jakewesterberg/wl-sync/hardware/README.md

# wl-sync breakout PCB

KiCad sources for the sync-box breakout board: a 2U rack-mount mixed-signal hub that sits
between the behavioural task PC, the sync-box module, the recording NI card, and the Intan RHS
amplifier. Every signal that crosses between those devices terminates on this board, is
conditioned once, and is fanned out — so a rig is reproducible from the board rather than from
hand wiring. "Sync-box module" is deliberately not a single product name: the module carries a
BCM2712 SoC and RP1 I/O controller either way, so its GPIO map and pinout are identical whether
it ships as a Raspberry Pi 5 or as a Compute Module 5 (Lite) on the official CM5 IO Board — the
choice between the two is a floorplan/placement decision this repository's own sources do not
yet lock in, not an electrical one.

Full design rationale, the signal contract, the grounding scheme, and the fabrication schedule
live in [`docs/superpowers/specs/2026-08-13-syncbox-breakout-pcb-design.md`](../docs/superpowers/specs/2026-08-13-syncbox-breakout-pcb-design.md).
The implementation plan (task breakdown, net naming convention, file layout) is at
[`docs/superpowers/plans/2026-08-13-breakout-pcb.md`](../docs/superpowers/plans/2026-08-13-breakout-pcb.md).
This repository is public: documentation here states electrical and mechanical facts and
tooling instructions only, and reproduces no text from either linked document's private source
material.

## Settled facts (record kept here, 2026-08-15)

Three facts a rig operator or firmware author needs and should not have to re-derive from the
schematic or the private spec:

- **The two photodiode comparator channels have distinct, fixed roles.** `A_PD1` watches the
  **task patch** — the stimulus-onset signal a behavioural task draws to cue an event.
  `A_PD2` watches the **flip patch**, a corner region of the display that alternates every
  refresh, making it a frame clock. Both reach the recorders as a digital edge through their
  own comparator (`PD1_COMP`/`PD2_COMP`) as well as an analog copy; the comparator lines carry
  the timing, the analog copies carry waveform and intensity.
- **The default eight analog channels Intan receives** (of the 16 sources this board carries;
  Intan's own ceiling is 8, and which eight is a mux setting, not a copper fact — see the
  ADG1206 mux truth table below): `A_PD1`, `A_EYE_LX`, `A_EYE_LY`, `A_EYE_LP`, `A_JOY_X`,
  `A_JOY_Y`, `A_MIC`, `A_ACC`. One complete eye (left, position + pupil) rather than partial
  data from both; the six eye channels are the first candidates to drop if a different set is
  ever needed, since they have an authoritative record on the eye-tracker PC independent of
  this board — the photodiode, joystick, accelerometer, and microphone channels do not.
- **MonkeyLogic's `RewardPolarity` setting must be `HIGH` to match this board.** This board's
  reward-commanded input (`RWD_CMD`) is active-HIGH by design (idle-LOW, pulses HIGH on
  delivery — the same convention every other event line on this board uses, and the polarity
  the reward-OR gate's own same-polarity structural check assumes and enforces on the
  debounced-button side). `RewardPolarity` is a MonkeyLogic Main Menu setting provided so a
  rig can match relays that trigger on sinking instead — it is a configuration to set for this
  board, never an unknown to discover at commissioning time.

## Two tracks

- **`hardware/mule/`** — the event-path mule. A small, fast board carrying only the 17-line
  event-code path plus one instance of each level-shift and isolation stage the full board
  reuses. It exists to reach the bench while the breakout board is still in layout, so the
  level-shifting and optocoupler topology gets validated against real hardware early enough to
  revise the sheets that depend on it.
- **`hardware/breakout/`** — the breakout board itself. A root sheet plus one hierarchical sheet
  per functional block (power, task-PC digital, Pi interface, analog front end, analog-to-NI,
  mux-to-Intan, comparators, opto-to-NI, opto-to-Intan, USB/I²C control).

As of this commit, `hardware/mule/` carries a generated schematic (`mule.kicad_sch`, produced
by `hardware/gen/gen_mule.py`) and a generated, placed-but-unrouted board (`mule.kicad_pcb`,
produced by `hardware/gen/gen_mule_pcb.py`) — see `hardware/mule/floorplan.md` for the
placement rationale and the constraints a router must respect. `hardware/breakout/` carries
the root sheet (`breakout.kicad_sch`, produced by `hardware/gen/gen_breakout.py`) plus two
populated child sheets so far: `sheets/power.kicad_sch` (produced by
`hardware/gen/gen_breakout_power.py`, Task 7) — the 5-position analog/logic inlet (widened
from 4 pins at Task 7 fix round 1, see below), the +3V3 logic rail regulated from +5V, and
the one isolated ±12V supply the other nine sheets draw power from; see that generator's own
module docstring and `check_breakout_power_netlist.py` for the design and its verification.
Task 7 fix round 1 (task-7-report.md's "Fix round 1") corrected two defects found in
review: the +5V rail was undersized regulating it down from +12V on board (fixed by
bringing +5V in directly from the external supply on a fifth inlet pin instead, budgeted
for 400mA), and the child sheet's own component `(instances (path ...))` ancestor chain was
self-referential rather than the real root+sheet-symbol chain a nested sheet needs (fixed
generically in `kicad_sch.py`, not just for this one sheet — see the "KiCad gotchas" entry
below). Task 7 fix round 2 (task-7-report.md's "Fix round 2") replaced the inlet
**connector** itself — not its electrical design — after a reviewer confirmed the mini-DIN
footprints modelled an evenly-spaced ring the real Same Sky MD-40SN/MD-50SN datasheet's own
diagrams contradict, and that both parts are discontinued besides. The inlet is now a
5-position, IEC 61076-2-101 A-coded, keyed, screw-locking M12 connector (Amphenol LTW
M12A-05PFFP-SF8001, current production, 811 units in stock directly confirmed at DigiKey)
— see "Custom connector footprints" below for the full selection rationale and
per-dimension sourcing.

**Panel-instrumentation task (2026-08-15), Change D — four of the five "things a rack
instrument needs that this one lacked" (spec §9.8) land on this sheet** (the fifth,
the barcode heartbeat LED, is on `pi-interface.kicad_sch` — see that sheet's own
paragraph below):

- **Chassis earth stud (`J56`):** a `Connector_Generic:Conn_01x01` on footprint
  `MountingHole:MountingHole_3.2mm_M3_Pad` — an M3-clearance hole *with* a connected
  copper pad, simultaneously the mechanical mount and the electrical land the
  cage-to-rack bond (spec §5.6) needs somewhere to terminate. Carries a new net,
  `CHASSIS_GND`, joined to `DGND` at exactly one net tie (`NT3`) — mirroring `NT2`'s own
  `FAN_RTN`↔`DGND` treatment exactly, so the stud reaches the board's single star point
  transitively (through `NT3` then `NT1`/`NT2`), never by a second, competing path.
- **Power-good LED per rail (`D40`/`D41`/`D42`, +12V/−12V/+5V):** series resistor + LED
  between each rail and its own local ground reference (`AGND` for ±12V, `DGND` for
  +5V) — `−12V`'s own pair is mirrored (resistor/anode on the `AGND` side, cathode on
  `−12V`), the identical reasoning `D2`'s own reverse-polarity-diode orientation already
  uses. ~4.5 mA target each (`R192`/`R193` = 2.2k, `R194` = 680R) — negligible against
  any rail's own real budget.
- **Rail test points (`TP1`–`TP7`):** one `Connector:TestPoint` per voltage rail (+12V,
  −12V, +5V, +3V3, ISO_P12, ISO_N12) *plus one on `INTAN_GND`* — the isolated domain's
  own reference, without which `ISO_P12`/`ISO_N12` cannot actually be measured at all
  (`INTAN_GND` is galvanically separate from `AGND`/`DGND`, spec §5.3/§5.5). `AGND`/
  `DGND` themselves are not given dedicated test points — already trivially probable at
  any of this sheet's own many ground pads.
- **Main input fusing (`F2`/`F3`/`F4`, +12V/−12V/+5V):** "the fans already have a
  polyfuse; these did not" (spec §9.8). Placed upstream of each rail's own existing
  reverse-polarity diode (`D1`/`D2`/`D3`) — their own raw-side net renamed `*_FUSED`
  (e.g. `P12_RAW` → `F2` → `P12_FUSED` → `D1` → `+12V`), `D1`–`D3` themselves keeping
  their existing references unchanged. `F2`/`F3` are Littelfuse `1206L050/15YR`
  (500 mA hold / 1 A trip / **15 V** max), the same real part as the fan feed's `F1`.

  **`F4` is a different part — finding M7, 2026-08-16.** The sizing note that used to
  sit here called +5V's 1.25× hold margin "tighter than usual but accepted, because a
  main-input fuse guards against a gross fault". That reasoning does not survive finding
  F1: the +5 V rail now carries **392 mA typ / 495 mA max**, and a `1206L050` holds only
  ~0.44 A at this chassis's 35 °C ambient. It would have tripped in **normal operation**,
  not on a fault. `F4` is now **`1206L110-C`** — 1.10 A hold / 2.20 A trip, ~0.97 A
  derated at 35 °C, a 1.97× margin.

  **Its V_max is 6 Vdc, not 15, and that is not interchangeable.** In the 1206L series
  the elevated-voltage variants exist only at the two lowest hold currents; everything at
  0.75 A and above is a +5 V-rail part. So `F4` could move and `F1`/`F2`/`F3` cannot —
  **0.50 A is the largest 1206L hold current available to a 12 V rail at all**, which is
  also why M7's "0.75 A recommended" for the fan feed cannot be satisfied in this series.
  Do not consolidate the two values back into one.

- **The fan branch is parallel to the main +12 V branch, not downstream of it (finding
  F7, 2026-08-16).** `F1` used to be fed from `+12V`, which put it in series with `F2` at
  identical ratings — and two identical parts in series have no selectivity at all: a fan
  fault at 0.9 A is below `F1`'s trip but over `F2`'s hold, so **`F2` could open first and
  kill the analog rails to protect the fans.** The fan feed now taps `P12_RAW` directly,
  with its own reverse-polarity Schottky (`D44`, `SS14`) since it no longer sits behind
  `D1`:

  ```
  J1.1 → P12_RAW ─┬─ [F2] → P12_FUSED   → [D1]  → +12V      (main, 97–121 mA)
                  └─ [F1] → FAN_12V_RAW → [D44] → FAN_12V   (fans, 240 mA)
  ```

- **Every panel output now sits behind series resistance, and no logic output drives more
  than one connector (findings F4 and M3, 2026-08-16).** `CAM_TRIG_BEH` drove **four** BNCs
  from a single `SN74AHCT541` output: four parallel coax runs present Z₀/4 ≈ 12.5 Ω, so the
  initial edge drew roughly **118 mA against the part's 25 mA per-output absolute
  maximum** — brief, but on every edge for the life of the board, and with no source
  termination the cameras could see reflections and double-trigger. Each trigger now has its
  own buffer channel (`CAM_TRIG_BEH1`–`4`, the extra three on `U74`) and its own **47 Ω**.
  They still share one trigger *rate* via `CAM_TRIG_BEH_RAW`; they no longer share a driver.

  M3 named **six** bare panel outputs. There were **eleven** — the five *digital* Intan
  output BNCs sat directly on the ACSL-6xx0 output pins too. (The finding's "every Intan
  output has a series resistor" is true of the *analog* outputs, which each sit behind
  100 Ω, and was not true of the digital ones.) All eleven now carry series resistance:
  47 Ω on the five camera triggers, 100 Ω on `J6` and the five Intan BNCs. The extra five
  were found by the checker written *for* M3, which is stated over every panel output rather
  than over the six nets the finding lists.

  `tests/hardware/test_netlist.py` derives series-ness from **topology** — by testing
  whether removing one fuse disconnects another from the supply inlet — rather than from
  net names. That matters: the audit's own published fix for this named `P12_FUSED` as
  "upstream of `F2`" when it is `F2`'s *output*, which would have fixed nothing and
  removed the fan branch's reverse-polarity protection as well. ±12V's own real total draw was **not** independently characterized
  to the same precision (it sums a computed IH1215D input-current estimate, the fan
  feed, and an uncharacterized contribution from the ±12V-referenced op-amp stages on
  `analog-frontend.kicad_sch`/`analog-ni.kicad_sch`) — flagged explicitly for bench
  confirmation before treating the margin as final, the same "tell me if it doesn't fit"
  posture this file's own +3V3/NI-budget notes already use elsewhere. A higher-current,
  higher-voltage PPTC (Bourns `MF-SM` series) was evaluated and **rejected**: its own
  datasheet states hand soldering is not recommended, which would add a third accepted
  hand-solderability exception beyond the two spec §10.1 documents (`MCP4728`, the two
  exposed-pad regulators) — see `_place_inlet()`'s own docstring for the full account.

And `sheets/taskpc-digital.kicad_sch` (produced by
`hardware/gen/gen_breakout_taskpc_digital.py`, Task 8) — both task-PC MDR68 connectors
(Connector 1 wired with the 23 digital lines; Connector 0 carries its 9 task-PC analog
channels plus the AISENSE-to-AGND tie, everything else no_connect pending Task 10's own
front-end/buffer circuitry), the 19-channel inbound protected/buffered path (100Ω +
BAT54S clamp per channel, high side +5V never +3V3, fanned out in parallel to a 3.3V
`SN74LVC541APW` bank and a 5V `SN74AHCT541PW` `_BUF` bank for Task 11's optocouplers), the
4-channel outbound path, and the reward OR (`74HCT32` + a single debounced `74HCT14`
Schmitt inverter); see that generator's own module docstring and
`check_taskpc_digital_netlist.py` for the design and its verification. Task 8 is this
project's first case of two REAL sibling child sheets coexisting, which surfaced a
cross-sheet reference-collision gotcha `kicad_sch.py` needed a generic fix for — see the
"KiCad gotchas" entry below.

**Task 8 fix round 1** (`task-8-report.md`'s own "Fix round 1") corrected three findings
raised by the implementer's own report, all disclosed concerns the implementer was right
to flag: (1) **critical** — the reward-OR debounce stage placed a `74HCT14` Schmitt
*pair* (task-8-brief.md's own literal, incorrect text); two series inversions cancel, so
the debounced button would idle HIGH into an OR gate against an active-HIGH `RWD_CMD`,
asserting `RWD_DLVR` continuously. Fixed to a *single* inverter (idle-LOW/active-HIGH,
matching an OR gate's actual requirement); `RWD_CMD`'s assumed active-HIGH polarity is
now stated explicitly on-sheet, and the checker asserts the OR's two inputs are
same-polarity. (2) Connector 1's physical MDR68 pin assignment was this sheet's own
sequential guess; it is now sourced from NI's own "X Series User Manual" (National
Instruments 370784K-01, May 2019), Figure A-5 "NI PCIe-6323/6343 Pinout" — the task PC's
own card — for every P0.x and D GND position. (3) Connector 0's 9 task-PC analog channels
(`A_EYE_LX_TPC` etc., plan.md's own net-naming table) and its AISENSE-to-AGND tie are now
wired on this sheet (the same physical-pin source above), since only the file that places
a symbol can label its pins and Task 10 does not exist yet. See `task-8-report.md`'s own
"Fix round 1" section for the full retrieval/verification method and the reasoning behind
each fix.

**Panel-instrumentation task (2026-08-15), Changes A+B — manual reward becomes a one-shot,
and the three reward positions become real connectors.** Both changes land entirely on
`taskpc-digital.kicad_sch`'s own reward circuit:

- **One-shot (Change A):** a Nexperia `74HCT123D` dual retriggerable monostable (`U69`)
  now sits between the debounce inverter's own output (`RWD_BTN_DEB`) and the reward-OR
  gate's second input (`RWD_BTN_PULSE`, the one-shot's own `Q`) — every hand-delivered
  reward gets a fixed **~199 ms** pulse regardless of how long the button is held (spec
  §3.1). `Rext=442k` (E96) + `Cext=1µF` (`R191`/`C149`, both minted out of band), K=0.45 at
  VCC=5.0V (the part's own datasheet, Table 10) → tW = 0.45×442×1,000,000 ns ≈ 198.9 ms,
  cross-checked against that same table's own measured example (100 nF/10 kΩ → 450 µs;
  the formula predicts exactly that). Real part, not TI: TI's own `CD74HCT123M`/`MT` is
  obsolete; Nexperia's `74HCT123D` is current production, thousands of units in stock at
  DigiKey/Mouser/TME (checked 2026-08-15). Pin map verified pin-by-pin against
  Philips/Nexperia's own Rev. 03 (11 May 2004) datasheet, Table 3/Fig. 5, cross-checked
  against KiCad's own stock `74xx:74HCT123` library entry — see
  `gen_breakout_taskpc_digital.py`'s own `place_reward_oneshot()` docstring for the full
  account, including why the part's own retriggerable behaviour does not undermine "fixed
  duration regardless of hold time" (a continuous hold produces exactly one trigger edge).
  The debounce capacitor changes from 100 nF to **1 µF** (10 kΩ × 1 µF = 10 ms, spec
  §3.1), covering both switch bounce and the longer remote-BNC cable run's own
  connector-mating transient.
- **Real connectors (Change B):** the manual reward button (`J4`) is now
  `Switch:SW_Push` on a real panel/chassis-mount momentary-pushbutton footprint
  (`Button_Switch_THT:SW_PUSH-12mm`), **recessed** per spec §3.1 ("so a sleeve or cable
  cannot dispense fluid"). The remote reward jack (`J5`) and reward-driver output (`J6`)
  are both real BNCs (`Connector:Conn_Coaxial` / `Connector_Coaxial:BNC_PanelMountable_
  Vertical` — the same footprint the camera-trigger BNCs already use), replacing generic
  `Connector_Generic:Conn_01x02` placeholders. **This removes the 3.5 mm TRS from the
  design entirely** — `J5` was its last use (spec §9.6): a BNC's own center pin cannot
  transiently short to the shield while mating the way a TRS tip/ring/sleeve does sliding
  past a jack's own switching contacts, so plugging in the handheld remote cannot itself
  fire a reward, and the coupling locks. No TRS footprint or symbol exists anywhere on the
  board any more (confirmed by grep across every generator and committed sheet, and
  asserted directly by `check_taskpc_digital_netlist.py`'s own whole-board footprint scan,
  with a negative control). `J4`/`J5`/`J6` keep their existing reference numbers — the
  symbol/footprint/value changed at their own existing call sites, nothing moved.

**A real ref_start hazard, found and fixed while making these changes, not before:**
`taskpc-digital.kicad_sch`'s own `build()` used to re-derive its reference-counter seed by
reading `power.kicad_sch`'s *current* committed text on every regeneration
(`find_max_refs(POWER_SCH.read_text())`). That was safe until power.kicad_sch's own
fan-header addendum (spec §9.5) minted `J52`–`J55`/`C147`/`C148` out of band, *after*
taskpc-digital.kicad_sch was last generated — from that point on, simply regenerating
taskpc-digital.kicad_sch again (even with no source changes at all) would have silently
**renumbered every one of its own existing J- and C-prefixed components**, since the
recomputed seed jumps from the sheet's own small pre-fan-header baseline straight to
power.kicad_sch's own new, much larger maxima. Confirmed empirically before fixing it: an
unmodified copy of the generator, run against the *current* power.kicad_sch, reproduced
`R24`/`D22`/`U13` exactly (genuinely unaffected) but `J60`/`C158` instead of the
historically-correct `J6`/`C31`. Fixed by **pinning** `ref_start` to the exact historical
values instead of re-deriving them live — see `gen_breakout_taskpc_digital.py`'s and
`gen_breakout_pi_interface.py`'s own `build()` docstrings (the latter has the identical
fix, for the identical reason: it also seeds from power.kicad_sch, plus this same
taskpc-digital.kicad_sch). **The lesson for every future out-of-band addition to an
already-depended-upon sheet:** it silently sets a trap for every downstream sibling's own
next regeneration, not just an inconvenience for the sheet being edited — check every
sibling that reads the changed file's maxima, not only the file itself.
And `sheets/pi-interface.kicad_sch` (produced by `hardware/gen/gen_breakout_pi_interface.py`,
Task 9) — the sync-module (Raspberry Pi 5 / Compute Module 5 IO Board, see this file's own
opening paragraph) 40-pin GPIO header, wired to spec Sec.4's own GPIO map (transcribed
verbatim as an on-sheet text block); the GPIO0/GPIO1 boot-contention 330Ω series resistors;
a `SN74AHCT541PW` output buffer for the three module-sourced signals this sheet produces
(`BARCODE_PI` fanned to 5 placeholder/spare panel headers, plus `BARCODE_BUF`/
`BARCODE_INTAN_BUF` on two more channels of the same package, one optocoupler LED each;
`CAM_TRIG_EYE`/`CAM_TRIG_BEH` fanned to 5 real panel BNC positions, 1 eye + 4 behavior);
and the internal
2.54mm 1×4 USB header for Task 12's own USB-I²C bridge. Also, NOT in the brief's own literal
step list: one more `SN74LVC541APW` channel on +3V3, level-shifting `RWD_DLVR` — produced on
`taskpc-digital.kicad_sch` by a `74HCT32` OR gate powered from **+5V** — down to a
module-safe level before it reaches GPIO23. This project's own global constraint (the plan's
own "Pi GPIO is 3.3V and not 5V tolerant... never one part for both") makes wiring `RWD_DLVR`
to GPIO23 directly a real hazard, not a style nit — the same class of catch-and-fix-beyond-
the-literal-brief Task 8 fix round 1 already made for its own reward-OR polarity defect (see
above), applied here to a defect that never made it into a committed sheet in the first
place. See that generator's own module docstring and
`check_breakout_pi_interface_netlist.py` for the design and its verification — including the
GPIO-physical-pin walk (independently re-derived, not imported from the generator) this
task's own brief specifically asked for, with a negative control that moves one GPIO signal
to a wrong pin and confirms the checker fires (this defect class is invisible to ERC: a
transposed physical pin is still a fully-connected, 0-error netlist, and only fails on a
bench during PIO capture bring-up).

**Panel-instrumentation task (2026-08-15), Change D's fifth item — barcode heartbeat LED,
on this sheet.** Spec §9.8: "the barcode is a 1 Hz pulse; an LED on it says the sync box is
alive from across the room." A **third** dedicated leg (channel 5, `BARCODE_HB`) off the
SAME trigger-buffer package and the SAME `BARCODE_RAW` input the two optocoupler legs
(`BARCODE_BUF`/`BARCODE_INTAN_BUF`) already use — "one buffered leg per driver pin," this
sheet's own established discipline, applied to a visible LED instead of an optocoupler:
`BARCODE_HB` never loads `BARCODE_PI` or either `_BUF` net directly, which is what "not by
loading the barcode net" (this task's own instruction) means in practice. `R195` (390R) +
`D43` (LED) to `DGND`, ~7.7 mA — the same order of magnitude already proven safe driving an
ACSL-6400/6420 LED from this exact `SN74AHCT541PW` family elsewhere on this board (~7.33 mA,
comfortably inside its 8 mA IOL rating), chosen for visibility rather than the lower ~4.5 mA
target the power-good LEDs use for a close-up panel indicator. Since `BARCODE_HB` carries
the identical signal as `BARCODE_PI`, the LED blinks at the barcode's own real rate with no
separate blink oscillator needed.

**As of Task 12, all ten hierarchical sheet symbols reference a populated child file** --
the seven that were still empty as of this paragraph's own original writing
(`analog-frontend`, `analog-ni`, `mux-intan`, `comparators`, `opto-ni`, `opto-intan`,
`control-usb-i2c`) were filled in by Tasks 10a-12; see each sheet's own dedicated section
below ("ADG1206 mux address truth table", "MCP4728 comparator-threshold DAC and I²C bus",
"Opto-NI", "Opto-Intan", "Control / USB-I²C bus") for what each one carries, rather than
duplicating that content into this already-long introductory paragraph. (See "Sheet
symbols referencing a child file that doesn't exist yet" below for why the root sheet
never pre-created any of them as empty placeholders in the first place.)

## Display sync — dropped entirely, not merely unpopulated (Change C, 2026-08-15)

The private spec's own decisions register (§2, decision 12) closed this position on
2026-08-15: "the photodiode flip patch measures at the display surface and catches
post-GPU drops a vsync tap structurally cannot. No component ever existed behind the
reservation; the panel position is freed." Verified directly against this repository, not
assumed from that closure note alone: grepped every `hardware/gen/*.py` generator and every
committed `hardware/breakout/sheets/*.kicad_sch` file for "display sync"/"DISP_SYNC" and any
variant — **zero hits, anywhere, past or present.** No sheet, footprint, symbol, net, or BOM
line ever represented this position in this repository's own sources; the reservation was a
panel-inventory line in the spec document that never reached schematic capture at all. There
is accordingly nothing to delete here — this section exists so that fact is checked and
recorded once, rather than re-derived (or silently assumed) by the next person who reads the
spec's own closure note and goes looking for a component to remove.

## BOM and procurement

Task 13 produced three files together, and they are not interchangeable:

- **`hardware/breakout/breakout-bom.csv`** — `kicad-cli sch export bom` output (see
  `hardware/procurement-check.md` §1 for the exact command), including two tooling gotchas
  explained there (blank `Qty`, blank `MPN`/`Manufacturer`).

  > **It is no longer byte-identical to that command's output, and re-running the command
  > blind will destroy data.** 18 rows — every `wl-sync:BNC_Dual_RA_Isolated` body plus `J1`
  > — carry hand-added `MPN`/`Manufacturer`/`Qty` (`031-6575`, `Amphenol RF`, `1`) that the
  > raw export emits blank. This was found the hard way on 2026-08-16, when regenerating the
  > BOM for the frame-time inputs blanked all 18 and `tests/hardware/test_bom_matches_netlist.py`
  > did not catch it (that test compares `Reference` and `Value` only, not the sourcing
  > columns). **When parts change, edit the affected `Reference`/`Value` cells in place rather
  > than overwriting the file with a fresh export** — or re-export, then restore those 18 rows'
  > three columns before committing. **Do not purchase directly from this file** — several of its
  Value strings are obsolete or packaging-ambiguous order codes (`INA105KU`, `SN74HCT14D`,
  bare `ADG1206YRUZ`), not the currently-orderable SKU.
- **`hardware/breakout/breakout-bom-order.csv`** — the same rows as `breakout-bom.csv`
  (101 at Task 13's own lock, 106 after the fan-header addendum below folded five new rows
  in, 120 after the panel-instrumentation task (2026-08-15) folded fourteen more in — the
  reward one-shot, four rail-power-good/heartbeat LEDs, the chassis earth stud, three more
  main-input fuses, seven rail test points, and the one-shot's own Rext/Cext — see
  `hardware/procurement-check.md`'s own panel-instrumentation addendum), with a corrected,
  actually-orderable part number and a one-line sourcing note added per line (fix round 1).
  **Purchase from this file.** It intentionally does not carry
  quantities — cross-reference `hardware/procurement-check.md` §2 for those, so quantities
  have exactly one source of truth instead of two copies that can drift apart.
- **`hardware/procurement-check.md`** — the full audit: corrected per-line quantities (§2,
  since the raw export's own `Qty` column is blank), every Value-overridden symbol checked
  against the real part it names (§3), the bare-vs-orderable-SKU findings in full (§4),
  distributor stock and lead time for every active component (§5), and everything over a
  4-week lead time called out explicitly (§6). Read this before placing an order — the two
  CSVs above are derived from it, not a replacement for it. Its dated addendum records the
  four fan headers (`J52`–`J55`), polyfuse (`F1`), and other fan-related BOM rows added to
  `power.kicad_sch` after the Task 13 lock, and the distributor checks for the new parts —
  both CSVs have since been regenerated against that same delta, so all three files agree.

## Toolchain

- **KiCad 10.0.5 or later.** `kicad-cli version` prints the installed version.
- **`kicad-cli` on `PATH`.** On macOS this is a symlink to
  `/Applications/KiCad/KiCad.app/Contents/MacOS/kicad-cli`.
- **`hardware/sym-lib-table`** — a project-scoped symbol library table registering the stock
  KiCad libraries this design draws parts from. Each project directory's own copy is the one
  that actually matters (see gotchas below); as of Task 7, `hardware/breakout/sym-lib-table`
  registers `Device`, `74xx`, `Amplifier_Operational`, `Comparator`, `Isolator`,
  `Interface_UART`, `Connector`, `power`, and `wl-sync` (Task 6), plus `Diode`,
  `Converter_DCDC_Isolated`, and `Regulator_Linear` — added this task for the power sheet's
  reverse-polarity Schottky diodes, its one isolated DC/DC converter, and
  `LD1117S33TR_SOT223` respectively. Extend it, don't replace it, if a later sheet needs a
  stock library not yet listed.
- **`hardware/mule/fp-lib-table`** and **`hardware/breakout/fp-lib-table`** — the same idea,
  one level down and for footprints: a project-scoped footprint library table registering the
  `.pretty` libraries each project's layout draws footprints from (stock KiCad libraries, plus
  `wl-sync` once a sheet places a custom footprint). Each must sit beside its own `.kicad_pro`,
  same constraint as `sym-lib-table` (see gotchas below) — a per-project copy, not the root
  `hardware/` directory. Task 7 added `Diode_SMD`, `Inductor_SMD` (the pi filters' ferrite
  beads), and `NetTie` (the AGND/DGND star point) to `hardware/breakout/fp-lib-table`; Task 9
  added `Connector_Coaxial` for the panel BNC positions. **Superseded 2026-08-16 by finding
  F6**: `BNC_PanelMountable_Vertical`'s connector axis is perpendicular to the PCB, so on a
  board lying flat in a 2U chassis its barrels pointed at the lid rather than at the panels.
  Every panel BNC is now `wl-sync:BNC_Dual_RA_Isolated`, a right-angle dual — see "Custom
  connector footprints" below.
- **`hardware/lib/wl-sync.kicad_sym`** and **`hardware/lib/wl-sync.pretty/`** — this project's
  own symbols and footprints for parts KiCad doesn't ship: the 68-pin MDR male connector,
  mini-XLR TA4M/TA5M, the dual right-angle isolated BNC (finding F6, 2026-08-16 — replacing a
  panel-mount vertical part whose axis pointed at the chassis lid), the mating DB37 for the ACCES I/O
  USB-AO16-8A analog source, the Raspberry Pi 5 GPIO header, and (Task 7) TPS7A4901/TPS7A3001
  — TI's ultralow-noise adjustable LDO pair — eight symbols total. The Pi header, the DB37
  connector, and (Task 7) TPS7A4901/TPS7A3001 all reuse stock footprints — a bare 2×20 2.54mm
  THT header, KiCad's own `Connector_Dsub` DB37, and a generic `Package_SO` HVSSOP-8-1EP
  PowerPAD, respectively — rather than needing new ones, so only four `.kicad_mod` files
  exist: MDR68, mini-XLR ×2, dual BNC. **`M12A_5` — symbol and footprint both — was deleted
  2026-08-16 under ruling R1**: the Phoenix 1551833 the design procures terminates in AWG
  22-20 wire and mounts through the panel, so it has no PCB tails and the board carries a
  plain 5-way header instead. `hardware/breakout/sym-lib-table` and
  `hardware/breakout/fp-lib-table` both register `wl-sync`; `hardware/mule/`'s copies do not
  (the mule places no custom parts). See "Custom connector footprints" below for the TA-vs-TB
  naming split and the per-dimension sourcing/confidence behind the four hand-built footprints.
- **`hardware/gen/`** — a reusable Python framework for generating KiCad files programmatically,
  in two halves that mirror each other:
  - `kicad_sch.py` builds `.kicad_sch` files: pull a symbol's definition out of a stock KiCad
    library, place symbol instances on a grid, and attach a global label at each pin's
    connection point so connectivity is by label name rather than wire geometry. `gen_mule.py`
    uses it to produce `hardware/mule/mule.kicad_sch`; `check_mule_netlist.py` parses the
    exported netlist back out and asserts the contract nets are actually correct, not just
    ERC-clean (see the gotchas below for why that distinction matters).
  - `kicad_pcb.py` builds `.kicad_pcb` files the same way, applied to layout instead of
    schematic capture: pull a footprint's definition out of a stock KiCad `.pretty` library,
    place instances at a floorplan's coordinates, and assign each pad's net directly from the
    schematic's own exported netlist (via `check_mule_netlist.parse_netlist()`, imported rather
    than re-implemented) so the ratsnest pcbnew computes at load time matches the schematic
    exactly. `gen_mule_pcb.py` uses it to produce `hardware/mule/mule.kicad_pcb` — board
    outline, isolation slot, every footprint placed, netlist imported, but **not routed**:
    `kicad-cli` has no netlist-import or Specctra-DSN subcommand, so there is no headless path
    to routing a board from the command line. See `hardware/mule/floorplan.md` for the
    placement rationale.

  Later schematic-capture and layout tasks can import either module directly rather than
  re-deriving the technique.

## Custom connector footprints: TA/TB naming, sourcing, and confidence

Four `wl-sync` footprints have no KiCad stock equivalent and were built from scratch:
`MDR68_Male_RightAngle`, `MiniXLR_TA4M_Panel`, `MiniXLR_TA5M_Panel`, and (finding F6,
2026-08-16) `BNC_Dual_RA_Isolated` — all in `hardware/lib/wl-sync.pretty/`, generated by
`hardware/gen/gen_wl_sync_footprints.py`. The design spec calls these out as the tightest
tolerance on the board: the enclosure panel is machined to their cutouts, so a footprint
error scraps a panel rather than causing a rework. This section is the sourcing record every
one of those footprints' `descr` field and the two `MiniXLR_*` symbols' `Description`
property point back to — this is where that content actually lives, not a pointer to
somewhere else.

> **Only two of the four are on this board: `MDR68_Male_RightAngle` (×4) and
> `BNC_Dual_RA_Isolated` (×17).** Confirmed against the exported netlist, not against intent — those are the only
> `wl-sync:` footprints any of the ten sheets places. **Mini-XLR was removed from the design
> entirely on 2026-08-13** (spec §9.1: the rig sits inside a Faraday cage sound booth, every
> sensor inside it is battery powered so no mains conductor crosses the cage wall, so nothing
> needs more than a coax — all rig-facing sensors are BNC). `MiniXLR_TA4M_Panel` and
> `MiniXLR_TA5M_Panel` are retained in the library, unplaced and unused, together with the
> TA/TB sourcing record below, because the modelling lesson in "Contact arrangement" is the
> reason this project checks circular-connector geometry against a dimensioned drawing at all
> — and because a footprint deleted along with its rationale gets re-created wrong. **Do not
> buy, caliper, or panel-machine for a mini-XLR.** Nothing on this board mates with one.

**`M12A_5_Panel` replaced a 4-pin then 5-pin mini-DIN inlet (`MiniDIN_4_Panel`,
`MiniDIN_5_Panel`) at Task 7 fix round 2** (task-7-report.md's "Fix round 2"), both now
deleted rather than deprecated: a reviewer independently pulled the Same Sky MD-SN
datasheet and confirmed the per-pin-count diagrams for both MD-40SN and MD-50SN show a
**clustered**, not evenly-spaced, contact layout — the same possible-topology-error risk
this section already flagged theoretically for the mini-XLR footprints below, but for the
mini-DIN this was a **confirmed** defect, not a residual risk, and as fabbed would very
likely have failed to mate. `build_minidin()` (the generator function) is deleted too, not
left behind — a wrong geometry generator is a trap for a later task.

> **`M12A_5_Panel` is itself now deleted, 2026-08-16, under ruling R1** — symbol, footprint
> and generator function alike, on the same "a wrong geometry generator is a trap" reasoning.
> Its contact geometry was sourced well (IEC 61076-2-101 A-coding, cross-checked three ways),
> and it made no difference: the part the design actually procures is **Phoenix Contact
> 1551833**, which terminates in AWG 22-20 **wire** and mounts through the panel at 3–4 N·m.
> It has no PCB tails, so no board-mount footprint of any dimensions could have been right —
> and as built, every cable insertion and every coupling-nut tightening loaded PCB pads
> directly. The inlet is now a stock 5-way 2.54 mm header where those flying leads land. The
> M12 connector is still purchased; it stopped being a board component. See
> `hardware/breakout/parametric-audit.md`'s R1 entry.
>
> Two footprints have now been retired for the same shape of error — **correct about a part,
> wrong about the one being bought**. That is why `hardware/gen/check_footprint_geometry.py`
> now reads these files back off disk and asserts their real geometry against
> `hardware/datasheet-params.toml`, rather than trusting the generator that wrote them.

### TA4M/TA5M are the wrong part number for a panel mount (historical — no mini-XLR on this board)

Kept as the sourcing record for the two retained-but-unplaced library footprints, and
because "the obvious part number for a panel position is often the cable-mount member of
the family" is a mistake worth not repeating on the next board. **Nothing below is a
procurement instruction for this design** — see the note at the top of this section.

**TA4M is obsolete and cable-mount only.** The mini-XLR male connector that actually
panel/chassis-mounts is the same Switchcraft Tini-QG family's **TB4M** (4-pin) and **TB5M**
(5-pin), not TA4M/TA5M. This has been confirmed independently against DigiKey, Switchcraft's
own catalog, and Farnell: all three agree the TA-series is cable-mount only, DigiKey lists
TA4M as obsolete, and the TB-series is the family's panel/chassis-mount member. Every
mini-XLR position on this board is panel-mounted, so ordering to the TA4M/TA5M part number
would buy a connector that cannot be mounted where it needs to go.

**The footprint models TB4M/TB5M. The symbol is still named `MiniXLR_TA4M`/`MiniXLR_TA5M`.**
That split is deliberate, not an inconsistency to fix:

- The **footprint** determines what actually gets soldered down and what panel cutout gets
  machined, so it has to model the mechanically real, orderable, panel-mountable part —
  TB4M/TB5M. Modelling TA4M/TA5M's own cable-mount dimensions for a panel position would be
  the real error, since TA4M/TA5M cannot panel-mount at all.
- The **symbol** keeps the `TA4M`/`TA5M` name because that is the identifier the spec, the
  plan, and any BOM or procurement step already use for this board position. Renaming the
  symbol would break that continuity for no electrical benefit: pin count and function are
  identical between the TA- and TB-series members of the family, only mounting style differs
  — and mounting style is exactly what the footprint, not the symbol, is responsible for.

Were a mini-XLR ever placed on a future board, procurement should order **TB4M/TB5M**, not
TA4M/TA5M, regardless of which name appears on the schematic symbol. This board places
neither.

### Per-dimension sourcing and confidence

The two `MiniXLR_*` rows are retained for the same reason the section above is, and are
**not** dimensions anyone needs to verify for this board — no mini-XLR is placed on it. The
rows that matter here are `MDR68_Male_RightAngle` and `BNC_Dual_RA_Isolated`.

**The `MDR68_Male_RightAngle` rows below are superseded.** They record what was known before
the footprint was rebuilt on 2026-08-16 from **MH drawing 3700-0121-01 rev 3.0**, a real
primary document. Every dimension now comes from `[mdr68]` in
`hardware/datasheet-params.toml` and is asserted by `check_footprint_geometry.py`; the
"corroborated across distributor listings" sourcing below is exactly what the rebuild
replaced. Two of those figures were wrong in ways that mattered: a **0.5 mm contact drill
against a required 0.85 mm** (the pins do not fit — the board could not be assembled) and a
**2-row layout at 2.84 mm against a 4-row staggered arrangement at 1.905 mm**. The mounting
holes, by contrast, were very nearly right at Ø2.79 on 57.9 mm centres against the drawing's
Ø2.77 on 57.93 — a claim during the audit that the footprint had "no mounting holes at all"
was itself wrong. Kept below as the record of how a plausible, well-corroborated set of
distributor figures can still be unbuildable.

| Footprint | Dimension | Value | Source | Confidence |
|---|---|---|---|---|
| `MDR68_Male_RightAngle` | Overall envelope | 63.86×16.7×12.5mm | MH Connectors 3700-0121-01 — a real, currently-distributed right-angle male 68-pin MDR/SCSI-3 connector | High — corroborated across 5+ independent distributor listings |
| `MDR68_Male_RightAngle` | Contact pitch | 1.27mm | MDR/SCSI-3 format's own defining dimension (3M "102 Series" datasheet: ".050in Boardmount") | High — format-defining; every MDR68 datasheet checked agrees |
| `MDR68_Male_RightAngle` | Row layout | 2 rows × 34 contacts | Same as pitch | High |
| `MDR68_Male_RightAngle` | Row spacing | 2.84mm | General MDR-68 dimensional references (multiple, mutually consistent secondary sources) | **Low — not confirmed against a primary numeric CAD drawing for this specific MPN** |
| `MDR68_Male_RightAngle` | Mounting-hole (jackscrew) spacing | 57.9mm | Same as row spacing | **Low — same caveat** |
| `MDR68_Male_RightAngle` | Mounting-hole size | 2.79mm (4-40 UNC clearance) | Standard 4-40 UNC clearance-hole practice | Medium |
| `MiniXLR_TA4M_Panel` / `MiniXLR_TA5M_Panel` | Panel/chassis thickness accommodated | 6.35mm max | Switchcraft's own published number for the TB-series panel-mount receptacle | High — primary source, correct part series |
| `MiniXLR_TA4M_Panel` / `MiniXLR_TA5M_Panel` | Panel bushing / cutout diameter | ~10.9mm | Derived from the TA-series housing diameter (0.413in/10.5mm, Switchcraft catalog) plus one distributor's TB5M listing (~10.7mm) | **Low — the least-certain dimension of any of the four footprints; no primary TB-series numeric drawing found** |
| `MiniXLR_TA4M_Panel` / `MiniXLR_TA5M_Panel` | Contact-circle diameter | 5.5mm | Modelled, not measured off the real part | Medium |
| `MiniXLR_TA4M_Panel` / `MiniXLR_TA5M_Panel` | Contact angular arrangement | Evenly spaced around the full circle | Approximation — see "Contact arrangement" below | **Low — possible topology error, not just a tolerance one** |
| `BNC_Dual_RA_Isolated` | Real part | Amphenol RF 031-6575, "50 OHM DUAL PORT BNC R/A JACK, ISOLATED, BLACK" | Amphenol customer outline drawing **31-6575 rev A** (2013-04-18) | High — primary document, pinned in `datasheet-params.toml` as `[bnc_dual_isolated]` |
| `BNC_Dual_RA_Isolated` | PCB hole pattern | 4 × Ø0.89mm signal, 2 × Ø2.01mm ground/retention, at 10.16 / 6.35 / 5.08 / 2.54mm | Drawing 31-6575 rev A | High — and independently corroborated: KiCad's own `BNC_Amphenol_031-6575_Horizontal` and `BNC_Win_364A2x95_Horizontal` were drawn from two manufacturers' drawings and agree on this pattern exactly |
| `BNC_Dual_RA_Isolated` | Body envelope | 14.40 × 36.20mm (F.Fab) | Drawing's own `body_width_mm` / `body_depth_mm` | High — matches KiCad's Amphenol footprint exactly; the Winchester one draws 15.00 × 39.10, a different part, and was NOT copied |
| `BNC_Dual_RA_Isolated` | Port pitch / panel holes | 16.00mm vertical centres, Ø12.83mm, 1/2-28 UNEF | Drawing 31-6575 rev A | High — cross-checks against `body_height_mm` 29.25: each port sits 6.625mm from the body edge against a hole needing 6.415mm |
| `BNC_Dual_RA_Isolated` | Pad numbering (1 = port A centre, 2 = port A shell, 3 = port B centre, 4 = port B shell) | Four INDEPENDENT pads | Derived from the drawing's geometry plus the two stock footprints' agreement that the centreline holes are the centre conductors | Medium — the ARRANGEMENT is certain; which port is "upper" is assumed. Harmless: the shells are independent either way, so no short can result, and swapping is a net reassignment. Marked `PIN MAP UNVERIFIED` in the footprint's own `descr` |
| `BNC_Dual_RA_Isolated` | Independent shell isolation | Each shell isolated from the panel AND from its neighbour | Drawing's own description + the body being glass-filled PBT, so the isolation is structural | High — and load-bearing: ten channels on this board route a shield per connector. Asserted by `check_footprint_geometry.py`'s `verify_bnc_dual()` |

Neither mini-XLR footprint drills a PCB mounting hole: both are panel-mount parts whose own
flange carries the mechanical load against the sheet-metal panel, not the board, so the PCB
footprint needs only solder pads. `BNC_Dual_RA_Isolated` is the opposite case and the reason
finding F6 matters mechanically as well as electrically — it is **PCB-mounted**, anchored by
its own tails and two Ø2.01 mm plated retention terminals, with the panel providing clearance
and location rather than support.
`MDR68_Male_RightAngle` is the exception and does get two mechanical mounting holes, matching
every real MDR/SCSI connector datasheet's own board-lock-post convention (it is a PCB-mount
part, not panel-mount).

### Contact arrangement: a possible topology error, not just a tolerance one

**Closed by deletion, twice over, and kept here as the reason this project models circular
connectors the way it now does.** The mini-DIN version of this risk was confirmed real and
fixed by replacing the connector (Task 7 fix round 2); the mini-XLR version was retired
along with mini-XLR itself when spec §9.1 made every rig-facing sensor a BNC. Neither part
is on this board, so there is nothing here to verify before machining a panel — the live
version of this concern is `M12A_5_Panel`'s own contact arrangement, which is sourced from
a dimensioned drawing of a standardised coding rather than modelled (see "The M12 inlet"
below), precisely because of what follows.

The mini-XLR footprints (`MiniXLR_TA4M_Panel`, `MiniXLR_TA5M_Panel`) place their contacts at
**evenly-spaced angular positions around a circle** — a modelling approximation, not a
measurement off the manufacturer's own drawing.

Framing this as only an angular-tolerance risk understates it. **Real keyed circular
connectors frequently cluster their contacts in an arc rather than spacing them evenly around
the full circle.** If that turns out to be true of the physical TB4M/TB5M parts, the
even-spacing model isn't off by a few degrees per contact — it has the **wrong topology**:
contacts in the wrong positions relative to each other, not merely each one nudged slightly
around a correctly-shaped ring. That is a different and larger class of mistake than a
dimensional tolerance error, because no amount of tightening the angle fixes a footprint
whose contact pattern is wrong in kind.

**This is not a theoretical risk — it is exactly what happened to this board's own mini-DIN
inlet, and it is why that connector is gone.** `MiniDIN_4_Panel`/`MiniDIN_5_Panel` used this
same even-spacing approximation; Task 7 fix round 2 confirmed, from the real Same Sky MD-SN
datasheet's own per-pin-count mechanical diagrams, that both MD-40SN and MD-50SN are
genuinely **clustered**, not a ring — the footprints would very likely have failed to mate as
fabbed. Rather than redraw against a part that turned out to be discontinued besides, the
inlet was replaced with a currently-stocked M12 connector whose contact geometry is drawn
from a real, dimensioned, standards-grounded source instead of an assumption (see "The M12
inlet: selection and sourcing" below) — this repo's own precedent for what "verify against a
physical sample, don't speculatively edit the angles" (below) is supposed to catch before a
panel gets machined, not after.

The rule this leaves behind, and the one `M12A_5_Panel` was built to: a circular
connector's contact arrangement is never something to settle by further research or by
speculatively editing angles. Either source it from a dimensioned drawing of a
**standardised** geometry every compliant manufacturer must share (what A-coding gave the
M12, and why that footprint's arrangement is High confidence while its panel cutout is not),
or verify it against a physical sample before any panel is machined. Modelling it as an even
ring because that is the shape a circular connector "obviously" has is what produced the
mini-DIN defect.

### The M12 inlet: selection and sourcing (historical — superseded 2026-08-16)

> **Superseded by ruling R1.** The board no longer carries a board-mount M12 at all. The part
> procured is **Phoenix Contact SACC-DSI-MS-5CON-M12 SCO (order 1551833)** — a panel-mount
> A-coded 5-position **pin (male)** device inlet with AWG 22-20 flying leads, which land on a
> stock 5-way 2.54 mm header (`J1`). The custom symbol and footprint are both deleted.
>
> The section below is kept as the selection record, because its *method* was right and is
> worth reusing — every criterion was checked against a primary source rather than assumed,
> and the A-coding geometry it pinned is a genuine cross-manufacturer standard. What it could
> not catch is the one thing that mattered: it verified the connector thoroughly and never
> asked whether the connector was **board-mount at all**. The Phoenix part's own datasheet
> answers that in one field — `termination = wire, AWG 22-20`.
>
> Two other findings in this audit have the same shape, which is why it is worth naming:
> **a number that is right about the model and wrong about the board.**

`M12A_5_Panel` (Task 7 fix round 2) models Amphenol LTW **M12A-05PFFP-SF8001**, selected
against the review finding's own priority order — each criterion checked, not assumed:

1. **Current production and stocked at a major distributor.** Confirmed ACTIVE lifecycle
   status and 811 units in stock directly on DigiKey's own product page — checked directly,
   not inferred from a search snippet. (Mouser's own page for this exact SKU could not be
   fetched directly in this environment; TME and OnlineComponents.com independently
   corroborate real stock of the same part number via search results. DigiKey alone already
   satisfies this criterion.)
2. **A real manufacturer drawing or CAD model is publicly available.** Amphenol LTW's own
   product page and DigiKey's EDA/CAD models tab both offer a 2D drawing and 3D STEP/IGS
   model for this exact part. (This generator could not extract that drawing's raw numbers —
   the download is JS-gated and every automated fetch attempted against it was blocked — but
   the hard requirement is that the drawing exists and is publicly reachable, which it does;
   see the confidence table above for exactly which two dimensions this leaves flagged.)
3. **≥5 contacts, carrying +12V/-12V/+5V/GND/shield.** 5-position: 4 outer contacts plus 1 at
   the centre. Pin-to-rail assignment is unchanged in substance from the mini-DIN's own — see
   `gen_breakout_power.py`'s `_place_inlet()`.
4. **Keyed.** IEC 61076-2-101 A-coding is a physical keying feature — the shell cannot mate
   rotated. This is a power connector feeding ±12V into analog circuitry; that needs to be
   structurally impossible, not merely unlikely.
5. **Locking.** M12×1 threaded coupling nut — a true mechanical lock, not friction. This
   chassis is rack-mounted and slides in and out.
6. **PCB-mount, panel-facing.** Front-fastened panel mount with PCB solder-pin termination,
   consistent with every other connector on this board.
7. **Modest panel footprint.** An M12 shell is a similar order of size to the mini-DIN bushing
   it replaces — comfortably modest next to this panel's 31 BNC positions and four 68-pin MDR
   connectors.

Contact geometry (four contacts on a Ø5.0mm pitch circle at 90° spacing, 45° off the keyway
reference, one contact at the exact centre) is the **IEC 61076-2-101 A-coding standard**
geometry, confirmed three independent ways rather than modelled as a guess: (1) the IEC
61076-2-101:2012 standard document itself, Table 1 — A-coding, 5-way style, 5 contacts →
60V/4A, an exact match for this part, confirming it is a genuine member of that standardised
class; (2) a real, current Bulgin M12-series datasheet's own dimensioned "5 pole 'A' Code
Front View" drawing (Ø5 contact circle, Ø1.0±0.03 contact diameter, 45°±30′ angular
reference) — a *different* manufacturer's real part in the same standardised class, since
A-coding's entire purpose is cross-manufacturer mating interoperability on one fixed
geometry; (3) an independent secondary description of the same standard. This is a
fundamentally different kind of claim than the mini-DIN's even-ring guess: A-coding is a real
interoperability standard every A-coded M12 part must share, not an assumption about one
manufacturer's unpublished layout.

### Priority order for re-checking against physical samples

**Two connectors to sample-buy: the MDR68 and the dual BNC.** That is the whole list — they
are the only two custom footprints this board places (see the note at the top of this
section; the mini-XLR items that used to head this list went out with the connector on
2026-08-13, and buying one now would caliper a part nothing on this board mates with). **The
M12 left this list on 2026-08-16** along with its footprint: it is panel furniture with
flying leads, not a board component, so nothing about it is a PCB dimension any more. Its
panel cutout (Ø13.5 mm plus a Ø1.2 mm anti-rotation pin) is pinned in `datasheet-params.toml`
from the part-specific drilling diagram.

**Most of what used to be on this list is closed**, because both footprints were rebuilt from
primary drawings rather than from corroborated distributor figures. What is left:

1. **The MDR68's tail-row-to-contact-number map** — the one genuine unknown left on either
   footprint, and the only one whose being wrong is unrecoverable after fab: it would
   fail to seat -- all four candidates produce different HOLE PATTERNS, not merely different
   numbering, so a wrong choice costs a respin caught at assembly rather than corrupted data
   caught in an experiment (corrected 2026-08-16; this first said "scramble 68 signals on a
   board that passes ERC and every test", which overstated it). MH drawing rev 3.0 gives
   the tail *geometry* (four staggered rows at 1.905 mm) but not which contact numbers land
   in which row. It is a smaller unknown than it sounds — the tails run straight back from
   the mating contacts, so each contact's X is fixed and only the depth is redistributed,
   leaving **four** candidate arrangements rather than twenty-four. All four are written out
   beside `MDR68_TAIL_ORDER` in `hardware/gen/gen_wl_sync_footprints.py`; switching is a
   one-line edit and a regenerate. The footprint's own `descr` carries `PIN MAP UNVERIFIED`
   and `check_footprint_geometry.py` asserts that note is still there. **Confirm against MH's
   own drawing or 3D model** — minutes with a document already in hand — and record the answer
   in `hardware/breakout/d3-panel-thickness.md`.

2. **The dual BNC's port orientation** — which of the two ports is the upper one. Same class
   of assumption, far lower stakes: the shells are independent either way, so no short is
   possible and a swap is a net reassignment, not a re-machined panel.

3. **The dual BNC's protrusion through the panel** — how much of the 36.20 mm body depth sits
   forward of the panel's rear face. Not dimensioned on the drawing, and it sets the board's
   set-back from the panel. Measure on the sample or take it from the 3D model. See
   `hardware/breakout/panel-elevations.md` §3.

**Closed by the 2026-08-16 rebuild**, recorded so nobody re-opens them: the MDR68's row
spacing and mounting-hole spacing (were 2.84 mm / 57.9 mm from general references; the
drawing gives 1.905 mm in four rows, and Ø2.77 on 57.93 mm centres), its contact drill (was
0.5 mm — unbuildable against a required 0.85 mm), and the M12's panel cutout and shell
diameter (no longer PCB dimensions at all).

## ADG1206 mux address truth table (Task 10c)

`hardware/breakout/sheets/mux-intan.kicad_sch` places eight `ADG1206YRUZ` 16:1 analog
multiplexers (28-lead TSSOP) as Intan's own channel-select bank — see
`hardware/gen/gen_breakout_mux_intan.py` and `hardware/gen/gen_wl_sync_lib.py`'s own
`ADG1206YRUZ` block comment for the full design and pin-table sourcing. This part has no
stock KiCad symbol in this package, so its 28-pin table was hand-built from the real
datasheet. Task 10c's own fix round 1 replaced an earlier two-pin hedge (physical pin 13
vs. 14, for the A3 address input — the originally committed version could not
independently confirm which one was A3 and wired both to the same net rather than guess
silently) with the definitive pin table below: two different physical pins tied to one net
is a short between whatever those pins actually are, not a safe hedge, and would have been
a real fault had the second candidate turned out to be a supply or another source pin
instead of NC.

Transcribed verbatim from Analog Devices' own ADG1206/ADG1207 Rev.0 datasheet, Table 4
"ADG1206 Pin Function Descriptions", 28-Lead TSSOP column:

| Pin | Name | Pin | Name |
|---|---|---|---|
| 1 | VDD | 15 | A2 |
| 2 | NC | 16 | A1 |
| 3 | NC | 17 | A0 |
| 4 | S16 | 18 | EN |
| 5 | S15 | 19 | S1 |
| 6 | S14 | 20 | S2 |
| 7 | S13 | 21 | S3 |
| 8 | S12 | 22 | S4 |
| 9 | S11 | 23 | S5 |
| 10 | S10 | 24 | S6 |
| 11 | S9 | 25 | S7 |
| 12 | GND | 26 | S8 |
| 13 | NC | 27 | VSS |
| 14 | A3 | 28 | D (drain / common output) |

A3 is pin 14; pin 13 (the hedge's other candidate) is genuinely NC, along with pins 2 and
3 — this part's only three NC pins, left unconnected on this board
(`check_breakout_mux_intan_netlist.py` asserts this directly — see below).

**EN is active-high**: Table 4's own description reads "When this pin is low, the device
is disabled and all switches are turned off. When this pin is high, the Ax logic inputs
determine which switch is turned on." This design ties EN to `+12V` on every mux (always
enabled — channel selection is by address only).

**Address truth table**, for Task 12 (the I²C GPIO-expander sheet that will drive
`MUX{n}_A0`..`MUX{n}_A3`) so the software side does not have to re-derive it from the
datasheet: A3-A2-A1-A0 read as a straight 4-bit binary count, EN high throughout.

| A3 A2 A1 A0 | Selects | A3 A2 A1 A0 | Selects |
|---|---|---|---|
| 0000 | S1 | 1000 | S9 |
| 0001 | S2 | 1001 | S10 |
| 0010 | S3 | 1010 | S11 |
| 0011 | S4 | 1011 | S12 |
| 0100 | S5 | 1100 | S13 |
| 0101 | S6 | 1101 | S14 |
| 0110 | S7 | 1110 | S15 |
| 0111 | S8 | 1111 | S16 |

Which of this board's own 16 `A_*` source nets rides physical `S1` vs. `S16` on every mux
is a separate, board-specific choice this sheet makes on its own (`ALL_16_NETS`/
`S_PIN_NUMBERS` list order in `gen_breakout_mux_intan.py`), not part of the datasheet's own
truth table above — see that generator's own module docstring for the full list.

`hardware/gen/check_breakout_mux_intan_netlist.py` asserts, independently of the
generator's own choices, that no two of a mux's own 21 signal pins (`S1`-`S16`/`A0`-`A3`/
`D`) ever share a net on one instance, and that the three NC pins (2, 3, 13) carry no real
net — so a two-pins-one-net hedge of this kind cannot pass silently again, on this part or
any future one.

## MCP4728 comparator-threshold DAC and I²C bus (Task 10d)

`hardware/breakout/sheets/comparators.kicad_sch` places one `LM339` quad comparator (three
channels used — `A_PD1`→`PD1_COMP`, `A_PD2`→`PD2_COMP`, `A_ACC`→`ACC_TRIG` — the fourth
brought out to `A_MISC1`, unpopulated) and one `MCP4728` quad 12-bit I²C DAC that sets each
comparator's own threshold — see `hardware/gen/gen_breakout_comparators.py` and
`hardware/gen/check_breakout_comparators_netlist.py` for the full design and its
verification. Recorded here, the same way the ADG1206 mux truth table above is, for Task 12
(the I²C bus master — `control-usb-i2c.kicad_sch`, an on-board USB-I²C bridge) so the
software side does not have to re-derive any of this from the datasheet or the schematic:

- **I²C address: `0x60`**, the MCP4728's own factory default (its address bits live in
  EEPROM, not on hardware pins — the part has none — Microchip DS22187E). Kept at default
  rather than reprogrammed: this design places exactly one MCP4728 on the bus, so there is
  no second device at `0x60` to collide with.
- **Channel map**: `VOUTA`→`PD1_COMP`'s own threshold, `VOUTB`→`PD2_COMP`'s, `VOUTC`→
  `ACC_TRIG`'s, `VOUTD`→the unpopulated 4th (`A_MISC1`) channel's — this board's own
  declared, arbitrary-but-fixed assignment (no datasheet fixes it), one DAC channel per
  comparator (symmetric threshold only). All four channels are allocated, so an asymmetric
  make/break threshold would cost a **second MCP4728 package**, not a spare channel — and
  a second one has to have its EEPROM address reprogrammed off the 0x60 default before it
  can share this bus. Not implemented; see spec §12 item 9.
- **`LDAC` is tied to `AGND`** (permanently asserted — immediate per-write update; no
  synchronized multi-channel update is used).
- **Bus nets**: `I2C_SDA`/`I2C_SCL`, exposed as global labels on this sheet, no bus
  pull-ups placed here — Task 12 owns the bus master and, with it, the one-set-of-pull-ups-
  per-bus sizing decision once every I²C device on the board (this DAC, plus whatever
  address-expander parts Task 12 itself adds) is known.

**The LM339 runs from `+12V` and `AGND` — never `-12V`.** Its pin 12 is labelled
"V−"/negative supply, but it is also the common emitter of all four open-collector output
transistors, so whatever that pin sits on *is* this sheet's output LOW level. On `-12V` (as
originally committed) an output LOW is V− + V_CEsat ≈ −11.9 V, and it genuinely settles
there: a 10 kΩ pull-up to `+3V3` sources ~0.33 mA against a ~16 mA sink. `PD1_COMP`/
`PD2_COMP`/`ACC_TRIG` carry that level to J7 pins 38/40/22 (GPIO20/21/25, pad absolute
minimum −0.5 V) and to `U11`'s SN74HCT541 inputs with no series resistance and no clamp
anywhere on the path. Nothing is lost by `AGND`: every threshold is 0–3.3 V (the DAC is on
`+3V3`), all three populated channels' sources are AGND-referenced and unipolar-positive,
and `+12V` still puts the input common-mode ceiling at 10.5 V. **One caveat, on-sheet as
note 6:** `A_MISC1` is ±5 V and is the DNP fourth channel's `+` source, so populating that
channel needs an input offset network ahead of pin 9 — not just stuffing `R120`/`R121`.

**The pull-up rail on `PD1_COMP`/`PD2_COMP`/`ACC_TRIG` is `+3V3`, never `+5V`** — a
destroy-the-sync-module constraint (all three wire directly into its own 3.3 V-only GPIO,
no buffer in between), asserted directly by `check_breakout_comparators_netlist.py` with a
negative control that moves one pull-up to `+5V` and confirms the check fires. The same
checker asserts V+ on `+12V` and V− on `AGND` and on nothing else, with two more negative
controls (V− moved to `-12V`; V− on `AGND` but also shorted to `-12V`). Relevant to
Task 12 only in that nothing about the I²C bus itself should ever change that fact — the
DAC's own threshold output is a separate signal path from the comparators' own
open-collector outputs, and the two must not be confused when wiring the bus.

## Opto-NI: 24 isolated digital channels and the recording NI's Connector 1 (Task 11)

`hardware/breakout/sheets/opto-ni.kicad_sch` is the galvanic barrier between the board's
own `DGND` domain and the recording NI card's own digital ground (`NI_GND`) — see
`hardware/gen/gen_breakout_opto_ni.py` and `hardware/gen/check_breakout_opto_ni_netlist.py`
for the full design and its verification. 24 channels (16 event-data bits plus
`EVT_STROBE_BUF`, `BARCODE_BUF`, `RWD_CMD_BUF`, `RWD_DLVR_BUF`, `STIM_TRIG_BUF`,
`RHS_STIM_OUT`, `PD1_COMP_BUF`, `PD2_COMP_BUF` — corrected from the plan's own stale
22-channel figure once the two
photodiode-comparator channels reaching NI were accounted for), each through a Broadcom
`ACSL-6400` (quad, all-in-one, 15 MBd logic-output optocoupler — **not** phototransistor,
matching the mule's own validated part class) — six packages, no stock KiCad symbol existed
for this part so `hardware/lib/wl-sync.kicad_sym` gained a hand-built one this task (search
that generator's own module comment for "ACSL-6400" for the full Broadcom AV02-0235EN pin
sourcing, cross-confirmed against two independent figures in the same datasheet). This
sheet also places the recording NI's own **Connector 1** (digital) — Connector 0 (analog)
was already placed by Task 10b on `analog-ni.kicad_sch`.

**The drive topology is deliberately non-inverting, unlike the mule's own.** ACSL-6400's
own truth table is LED-ON → output LOW; wiring the LED the mule's own way (source → series
R → anode; cathode → local ground) would ship every NI-side event-code bit inverted — a
real, silent hazard for a 16-bit word, not merely a style choice. This sheet instead ties
each LED's anode to `+5V` through the series resistor and drives the cathode directly from
the source net, which cancels the inversion by relying only on the driving 74HCT541/74HCT32
push-pull output's ordinary ability to sink a few mA — see the generator's own module
docstring for the full derivation. LED series resistors are **249 Ω on `+5V` and 301 Ω on
`ISO_5V`** (finding F1, 2026-08-16 — corrected from a single 430 Ω, which under-drove every
optocoupler on the board; see "One optocoupler LED per driver pin" below). NI-side pull-ups are
**3.9 kΩ, not the mule's 1 kΩ** — driven by NI's 250 mA/connector budget (24 output stages
already draw ~120–168 mA; 1 kΩ pull-ups would add another ~120 mA, at or over the budget) —
**fixed round 1 from an original 10 kΩ choice that fit the budget too but exceeded
ACSL-6400's own datasheet pull-up maximum (4 kΩ)**, derived only against the mule's own 1 kΩ
without checking the part's own spec. 3.9 kΩ is the largest E24 value at or under that 4 kΩ
limit, adds only ~31 mA (domain total 151–199 mA, 51–99 mA of headroom), and keeps every
logic-level margin the original analysis relied on (reasoned through explicitly in the
generator's own module docstring, not merely asserted) — see
`.superpowers/sdd/2026-08-13-breakout-pcb/task-11-report.md`'s own "Fix round 1" section.

**Connector 1's physical pins are sourced from NI's X Series User Manual (370784K-01),
Figure A-18** ("NI PCIe-6353 and NI PCIe/PXIe-6363 Pinout" — the recording NI's own PXIe-6353
family; "PXIe-6353" itself appears nowhere in the manual, only "PCIe-6353"/"PCIe/PXIe-6363",
which share one connector-pinout figure), fetched directly from NI's own documentation host
and independently re-derived rather than reused unchecked from Task 8's own Connector 1
table (a *different* physical card, PCIe-6343, Figure A-5) — found, on comparison, to be
byte-for-byte identical on all 24 P0.x positions, all 12 D GND positions, and both `+5V`
positions. **Power for the NI-side output stage is `NI_5V`/`NI_GND`, taken directly off
Connector 1's own `+5V` (pins 8, 14) and D GND (12 pins)** — switcher-free, already
referenced to NI's own ground, per this task's own brief — with a filtered isolated DC-DC
fallback footprint (`TMA-0505S`, the same part class the mule's own isolated 5 V rail uses)
left fully DNP, bridged onto `NI_5V` through a single DNP 0 Ω resistor so it contributes
nothing to the netlist's real behaviour unless deliberately populated.

## Opto-Intan: 6 isolated digital channels, one bidirectional package (Task 11)

`hardware/breakout/sheets/opto-intan.kicad_sch` is the galvanic barrier between `DGND` and
the Intan domain's own isolated ground (`INTAN_GND`) — see
`hardware/gen/gen_breakout_opto_intan.py` and
`hardware/gen/check_breakout_opto_intan_netlist.py` for the full design and its
verification. 6 channels: 5 outbound (`EVT_STROBE_INTAN_BUF`/`BARCODE_INTAN_BUF`/
`RWD_CMD_INTAN_BUF`/`RWD_DLVR_INTAN_BUF`/`STIM_TRIG_INTAN_BUF`, `DGND`→`INTAN_GND`) — every
one its own dedicated buffered leg, never a net shared with `opto-ni`'s LED for the same
signal, see "One optocoupler LED per driver pin" below — and 1 inbound (`RHS_STIM_OUT`, the one
signal originating inside the Intan domain, `INTAN_GND`→`DGND`), all out to BNCs (isolated
shells, this board's established convention).

**The second package is a Broadcom `ACSL-6420` ("quad, bi-directional 2/2"), not a second
`ACSL-6400`** — a correction this task's own pin-by-pin datasheet verification found, not
assumed going in. An all-in-one part's four channels share ONE VDD/GND domain on the output
side; opto-intan's own second package needs one outbound channel (`STIM_TRIG_BUF`) and one
inbound channel (`RHS_STIM_OUT`) simultaneously — opposite directions, which an all-in-one
part cannot provide without putting one channel's output on the wrong side of the barrier
entirely. `ACSL-6420`'s own 2/2 split (2 channels LED-on-VDD1/output-on-VDD2, 2 the reverse)
is built for exactly this; the remaining channel of each direction is a genuine spare. See
`hardware/gen/gen_wl_sync_lib.py`'s own module comment (search "ACSL-6420") for the full pin
table, sourced the same way as `ACSL-6400` (Broadcom AV02-0235EN, cross-confirmed against
two independent figures). Total across both opto sheets: 7×`ACSL-6400` + 1×`ACSL-6420` =
**eight quad packages, 30 channels** — the corrected count; the plan's own text still reads
28/6-packages, stale since before the two photodiode-comparator NI channels propagated.

**The Intan-side output stage runs from a new `ISO_5V` rail.** It began as an
`LD1117S50TR_SOT223` LDO regulating `ISO_P12` down to 5 V, referenced to `INTAN_GND` —
`ISO_P12`/`ISO_N12` themselves are ±12 V, too high for the ACSL-6400/6420 family's own
5.5 V absolute maximum VDD.

**Finding F2 (2026-08-16): the inbound stim channel is buffered locally.** `RHS_STIM_OUT`
used to put its 100 Ω panel-protection resistor *inside* the LED's current loop
(`ISO_5V` → 301 Ω → LED → 100 Ω → Intan's output), making the branch 401 Ω and 6.57 mA
against the ACSL-6xx0's 7.0 mA switching minimum — the only channel on the board whose
protection resistor did double duty as a current-setting one. Worse, it depended on a
physical switch nobody had documented: the Intan Stim/Recording Controller's **CONFIG4**
selects 3.3 V or 5.0 V digital outputs, and with it *down* the LED anode sits at `ISO_5V`
while its cathode rests at 3.3 V, leaking ~1.3 mA against a 250 µA I_FL limit — the channel
may never turn cleanly off.

A local `SN74AHCT541PW` (`U75`) on `ISO_5V`/`INTAN_GND` now drives the LED, and the 100 Ω
plus `BAT54S` do protection only. **This retires the CONFIG4 dependency rather than just
documenting it:** an AHCT part's TTL thresholds (V_IH 2.0 V) are independent of its supply,
so the buffer accepts either output level as a valid HIGH, and its own rail-to-rail output
gives the LED a clean 0 V off-state either way.

> **Rig configuration, still worth setting: CONFIG4 UP.** It no longer changes whether the
> board works, but it keeps the Intan side at the same 5 V logic level as everything else
> and removes a variable from bring-up. Record it beside `RewardPolarity` HIGH — both are
> settings on external equipment that this board depends on nothing enforcing.

**Finding F5 (2026-08-16) replaced that LDO with a `TMR 1-0511` isolated DC/DC, fed from
`+5V`/`DGND`.** A linear regulator passes its output current straight to its input, so the
whole 63–91 mA ISO_5V digital branch was being drawn *through* the isolated ±12 V module:
`ISO_P12` sat at **114–170 %** of the `IH1215D`'s 66 mA per-rail rating while `ISO_N12`
carried only 12–16 mA. Two defects at once — an over-rating, and an imbalance large enough
that the module's own ±5 % cross-regulation figure, characterised only with the lighter
rail at 25–100 %, did not describe this board. Both rails now carry 12–16 mA and match, and
0.37–0.58 W of LDO dissipation leaves a sealed chassis.

**Not the `TMA-0505S` the audit named.** That part is already on the board (`U62`, the DNP
NI-side fallback) so it looked free — but the TMA series is **unregulated**, and at
ISO_5V's 31–46 % load its output would rise toward **5.50 V, exactly the ACSL's VDD
absolute maximum**, while driving finding F1's 301 Ω resistors to 14.3 mA against a 15 mA
absolute maximum. Fixing F5 that way would have broken F1. The `TMR 1-0511` is fully
regulated (±1 % set, 0.5 % load), isolates to 1500 VDC, and needs no minimum load.

**It is a second on-board switcher** — spec §8 permitted one, and now records two with the
reasoning. Its secondary return is a separate net, `ISO_5V_RTN`, joined to `INTAN_GND` at a
single net tie (`NT4`), the same idiom `FAN_RTN` uses. ERC forced that (two `power_output`
pins on one net is a real `pin_to_pin` error) and it is the better answer regardless: the
switching return reaches the Intan reference at one controlled point rather than across a
plane shared with eight `INA105` difference amplifiers. `RHS_STIM_OUT`'s own inbound path gets the same series-resistor-plus-clamp input
protection every other panel input on this board carries, since it is a signal entering
from off-board Intan equipment via its own BNC — its assumed logic sense (active-HIGH,
TTL/CMOS-compatible) is flagged on-sheet as an assumption needing bench confirmation
against the real RHS hardware, the same class of residual `RWD_CMD`'s own polarity already
carries elsewhere in this project.

**Every pull-up on this sheet is 3.9 kΩ, not the original 10 kΩ** — **fixed round 2**,
the same `ACSL-6400`/`ACSL-6420` datasheet pull-up maximum (4 kΩ) that drove opto-ni's own
fix round 1, independently re-verified here rather than inferred from that sibling sheet:
Broadcom AV02-0235EN's "Recommended Operating Conditions" table (p.10) is a single table
covering the whole ACSL-6xx0 family with no per-device split anywhere in the document, and
the output stage the RL-max rating characterizes is schematically identical across every
family member and channel — so the same 4 kΩ ceiling binds `ACSL-6420`'s own output pins
exactly as it binds `ACSL-6400`'s. NI's 250 mA/connector budget does **not** apply here —
this sheet's output side runs from the board's own isolated `ISO_5V` rail, not NI's
connector — so the reason to move off 10 kΩ is purely the datasheet maximum, not a current
budget. A from-scratch `ISO_5V`/`ISO_P12` budget check (not assumed to inherit opto-ni's
own numbers) found ~34–49 mA of headroom either way against the shared `TPS7A4901`'s
150 mA cap (also feeding `mux-intan.kicad_sch`'s own 8 `INA105KU` difference amplifiers) —
see `.superpowers/sdd/2026-08-13-breakout-pcb/task-11-report.md`'s own "Fix round 2"
section for the full numeric derivation. **That budget was retired by finding F5**: the
pull-ups still cost what they cost, but `ISO_5V` no longer draws through `ISO_P12` at all,
so the marginal-cost argument now applies to a rail fed straight from `+5V`.

**Domain-disjointness verification is scoped to each sheet's own components, not a
project-wide rail scan** — found necessary, not stylistic: `check_breakout_opto_intan_
netlist.py`'s own first draft scanned every node on `ISO_5V`/`INTAN_GND`/`AGND`/etc.
project-wide and immediately flagged `mux-intan.kicad_sch`'s own 8 `INA105KU` difference
amplifiers (Task 10c) and `power.kicad_sch`'s own isolated DC-DC (Task 7) as "unexpected
straddling" — both real, already-reviewed, deliberate designs (the analog fan-out's own
partial-isolation strategy and the isolated supply itself), not defects. Fixed by scoping
both `check_breakout_opto_ni_netlist.py`'s and this sheet's own checker to the specific
component references each sheet's own checks independently discover, not a blind scan by
shared rail/net name.

**Cross-sheet consequence, not a scope overrun** (same class Task 8/9/10d already
established a precedent for): `taskpc-digital.kicad_sch`'s own temporary `PWR_FLAG` on
`RHS_STIM_OUT` — placed at Task 8 because nothing drove that net yet — is deleted here, the
moment this sheet wires a real `open_collector` driver onto it, exactly as that
generator's own docstring already specified. `check_breakout_pi_interface_netlist.py`'s own
`BARCODE_PI` fan-out count moved 5→6 at Task 11's `opto-ni.kicad_sch` (its first real load)
and 6→7 here (opto-intan's own) — **and back to 5 afterwards.** Widening that count to
absorb the two new loads was the wrong response: both were optocoupler LEDs (~7.33 mA each
at the then-current 430 Ω; ~12.65 mA at F1's 249 Ω), so the trigger buffer's own Y0 pin was
being asked for double against a 6 mA IOL.
They now hang on `BARCODE_BUF`/`BARCODE_INTAN_BUF`, dedicated channels off the same
package, and that checker asserts `BARCODE_PI` carries no LED cathode at all rather than
just counting loads — see "One optocoupler LED per driver pin" below.

## One optocoupler LED per driver pin

An earlier ruling (F2, `.superpowers/sdd/2026-08-13-breakout-pcb/progress.md`) created the
`_BUF` bank so the task PC's own DAQ pins would not drive optocoupler LEDs directly. It
named **19 signals** for what is really a **30-LED** board, and the 11 unnamed LEDs ended up
doubled onto driver pins that already had one.

Each `ACSL-6400`/`ACSL-6420` LED is fed from `+5V` through **249 Ω** and draws ~12.65 mA
(finding F1; it was 430 Ω/~7.33 mA when this section was first written, which under-drove
every LED on the board — see the F1 note below). That value is not free to move: it is
pinned between the part's own 7–15 mA recommended forward current and its **7.0 mA
worst-case switching threshold**, so a driver cannot be helped by lowering it (see
`gen_breakout_opto_ni.py`'s own derivation). Two LEDs on one pin is double — against
`SN74HCT541`'s 6 mA IOL, and against `SN74HCT32`'s 4 mA.

The 74HCT32 case had a failure mode rather than a margin. `RWD_DLVR` came straight off the
reward-OR gate and fed both its NI and Intan optocouplers; that gate's LOW level is read by
the `SN74LVC541APW` level-shifter (V_IL,max 0.8 V) on the way to GPIO23, and an HCT gate's
V_OL at 3.7× its rated sink plausibly exceeds it — **`RWD_DLVR_PI` stuck HIGH, the sync
module recording reward-delivered continuously.** That is the same failure signature as the
debounce-polarity defect Task 8 fix round 1 already caught on this board.

Separately, `PD1_COMP`/`PD2_COMP` carried an LED whose anode sits on `+5V` through 430 Ω,
and those two nets wire **directly** into GPIO20/GPIO21. With the LED off that node idles
~3.6–3.8 V — above the 3.3 V rail, held only by the module's ESD clamp; and with this board
powered while the sync box is off, ~7 mA is injected into an unpowered pad. They were the
only 2 of the 24 NI optocoupler LEDs not driven from a buffered leg.

**The rule now: one HCT541 output pin drives exactly one LED, and no LED hangs on a net that
reaches a sync-module GPIO.** At the time, no component was added — every new channel was a
label on a pin that was previously tied off, so reference designators and the BOM were
unchanged. `U10` (the `_BUF` bank's third package) spent its last 5 spare channels; `U11`
(the outbound buffer) and `U15` (the trigger buffer) spent 2 each.

**Finding F1 (2026-08-16) added the converse rule: one LED is driven by exactly TWO output
pins, from tied inputs.** The two are not in tension — one pin still drives at most one LED;
each LED now simply has a second pin behind it. F1 became necessary because the LED series
resistor had to fall from 430 Ω to 249 Ω: at 430 Ω these LEDs were never guaranteed to
switch (~5 mA worst case against the ACSL-6xx0's 7.0 mA I_FH minimum, because the original
sizing used the rail's nominal 5.00 V and a typical V_F, while `+5V` reaches the anodes
through `F4` and `D3` and V_F's worst case is 1.80 V). At 249 Ω one LED draws ~12.65 mA,
over a single output's 7.5 mA budget — so **neither half of F1 is shippable alone**, and an
earlier resistor-only attempt was correctly rejected by `test_driver_pin_sink_load` and
reverted. This one **did** add components: four `SN74AHCT541PW` packages (`U70`–`U73`) and
their decoupling capacitors (`C151`–`C154`), taking the board from 5 buffer packages to 9,
with 6 spare channels left. Their refdes were minted **out of band**, above the whole
board's maximum, so nothing already placed moved.

| Driver pin | Part | Net | LEDs | Pull-up | Sink/pin | Budget |
|---|---|---|---:|---:|---:|---:|
| `U8.11–18` + `U70.11–18` | SN74AHCT541PW | `EVT_D0..7_BUF` | 1 each, **2 pins each** | — | 6.33 mA | 7.5 mA† |
| `U9.11–18` + `U71.11–18` | SN74AHCT541PW | `EVT_D8..15_BUF` | 1 each, **2 pins each** | — | 6.33 mA | 7.5 mA† |
| `U10.18` + `U72.18` | SN74AHCT541PW | `EVT_STROBE_BUF` | 1, 2 pins | — | 6.33 mA | 7.5 mA† |
| `U10.17` + `U72.17` | SN74AHCT541PW | `RWD_CMD_BUF` | 1, 2 pins | — | 6.33 mA | 7.5 mA† |
| `U10.16` + `U72.16` | SN74AHCT541PW | `STIM_TRIG_BUF` | 1, 2 pins | — | 6.33 mA | 7.5 mA† |
| `U10.15` + `U72.15` | SN74AHCT541PW | `EVT_STROBE_INTAN_BUF` | 1, 2 pins | — | 6.33 mA | 7.5 mA† |
| `U10.14` + `U72.14` | SN74AHCT541PW | `RWD_CMD_INTAN_BUF` | 1, 2 pins | — | 6.33 mA | 7.5 mA† |
| `U10.13` + `U72.13` | SN74AHCT541PW | `STIM_TRIG_INTAN_BUF` | 1, 2 pins | — | 6.33 mA | 7.5 mA† |
| `U10.12` + `U72.12` | SN74AHCT541PW | `RWD_DLVR_BUF` | 1, 2 pins | — | 6.33 mA | 7.5 mA† |
| `U10.11` + `U72.11` | SN74AHCT541PW | `RWD_DLVR_INTAN_BUF` | 1, 2 pins | — | 6.33 mA | 7.5 mA† |
| `U11.14` + `U73.18` | SN74AHCT541PW | `PD1_COMP_BUF` | 1, 2 pins | — | 6.33 mA | 7.5 mA† |
| `U11.13` + `U73.17` | SN74AHCT541PW | `PD2_COMP_BUF` | 1, 2 pins | — | 6.33 mA | 7.5 mA† |
| `U11.12` + `U11.11` | SN74AHCT541PW | `RHS_STIM_OUT_BUF` ‡ | 1, 2 pins | — | 6.33 mA | 7.5 mA† |
| `U15.15` + `U15.12` | SN74AHCT541PW | `BARCODE_BUF` | 1, 2 pins | — | 6.33 mA | 7.5 mA† |
| `U15.14` + `U15.11` | SN74AHCT541PW | `BARCODE_INTAN_BUF` | 1, 2 pins | — | 6.33 mA | 7.5 mA† |
| `U12.3` | SN74HCT32D | `RWD_DLVR` | **0** | — | ~0 mA | 4 mA |
| `U15.18` | SN74AHCT541PW | `BARCODE_PI` | **0** | — | ~0 mA | 7.5 mA† |
| `U54.1/2/13/14` | LM339 (open-collector) | `PD2_COMP`/`PD1_COMP`/`ACC_TRIG`/`A_MISC1_COMP` | **0** | 10 kΩ→+3V3 | 0.33 mA | 6 mA |
| `U65.3` | ACSL-6420 | `RHS_STIM_OUT` ‡ | **0** | 3.9 kΩ→+5V | 1.20 mA | 13 mA |
| `U56–U61.11–14`, `U64.11–14`, `U65.2/10/11` | ACSL-6400/6420 | the 28 `*_NI`/`*_INTAN` nets | 0 | 3.9 kΩ | 1.20 mA | 13 mA |

**‡ `RHS_STIM_OUT` lost its LED at F1.** It was the one opto-ni channel whose LED hung
directly on a non-buffer output — an ACSL-6420 open-collector pin budgeted at 13 mA. That
was a deliberate, checked exception, correct at 430 Ω (8.61 mA of 13 mA) and *not* correct at
249 Ω (12.65 mA of LED + 1.20 mA of pull-up = 13.85 mA, over budget). An optocoupler output
cannot be paralleled the way a buffer output can, so the LED moved onto `RHS_STIM_OUT_BUF`,
a new buffered leg off `U11`'s last two spare channels. Worth recording as its own lesson:
**the exception was correct when written and was invalidated by a change made two sheets away
for an unrelated reason.** Nothing about the exception changed; the number it had been
checked against did.

Package totals through GND, with every LED that package drives lit simultaneously:
`U8`/`U70`, `U9`/`U71` and `U10`/`U72` at **50.6 mA** each (8 LED legs × 6.33 mA nominal,
**55.6 mA** at the best-case corner the checker actually enforces), `U11` and `U15` at
**25.3 mA** nominal / 27.8 mA best case (4 legs each), `U73` at **12.7 mA** / 13.9 mA
(2 legs).

Per-LED current, worst case to best case, is **8.61–13.90 mA** on `+5V` through 249 Ω and
**8.75–12.92 mA** on `ISO_5V` through 301 Ω — against an 8 mA guardbanded floor (the hard
I_FH minimum is 7 mA) and a 15 mA absolute maximum. Both ends of that window are checked.

That limit is **±75 mA**, not the ±100 mA an earlier revision of this section claimed —
`SN74AHCT541`'s continuous current through V_CC or GND, SCLS269Q §4.1, pinned in
`hardware/datasheet-params.toml` as `sn74ahct541.i_gnd_abs_max_ma`. Correcting it matters
here rather than being pedantry: the event bus idles at `0x0000` and the drive is active-low,
so **sixteen LEDs are lit continuously** — a steady state, not a transient. Unparalleled at
249 Ω that would be ~101 mA through one ground pin, over the real limit and under the
mistaken one. This is a per-**package** constraint that no per-**pin** check can see: eight
pins each inside their own budget still add up to a package that is not.

**† `SN74AHCT541PW`, not `SN74HCT541PW` — a Value/MPN swap, recorded rather than left
implicit.** `SN74HCT541` was rated IOL = 6 mA (V_OL 0.33 V max at V_CC 4.5 V) against a
7.33 mA ask on every LED-driving pin — 22% over the rated sink, and self-consistently
against the part's own ~55 Ω output impedance (not the single 6 mA datasheet test point)
closer to 7.18 mA against the ACSL LED's own 7.0 mA worst-case switching floor than the
naive number suggested, with headroom eroded further at V_F max / VCC 5% low. `SN74AHCT541`
is rated IOL = 8 mA — identical pinout, identical TSSOP-20 footprint, same `74xx:74LS541`-
derived KiCad symbol family — making 7.33 mA fully compliant. Confirmed as Value/MPN only:
same 5 refdes (`U8`–`U11`, `U15`), zero refdes churn, diffed against the netlist contract
before the swap. `tests/hardware/test_netlist.py`'s own `MAX_SINK_MA` keeps the 7.5 mA
budget (comfortably under the 8 mA rating, not loosened to it) so a second LED on the same
pin still fails hard either way.

An earlier revision of this paragraph also claimed the swap doubled both absolute maxima
(25 mA→50 mA per pin, 70 mA→100 mA per package). **That is wrong and is corrected here:**
`SN74AHCT541`'s own absolute maxima are 25 mA per output pin and ±75 mA through V_CC/GND
(SCLS269Q §4.1), pinned in `hardware/datasheet-params.toml`. The ±75 mA figure is the one
finding F1(b) exists to satisfy, so believing it was 100 mA hid part of the problem. AHCT's faster edge rates are a placement-stage series-
termination question for the MDR68 cable runs, not a schematic-capture one — see
`hardware/breakout/design-review.md`.

**Verification** (each with a negative control that fires): the whole-board contract sums
LED and pull-up current per driver pin **across sheets** — the defect is structurally
invisible per-sheet, since `opto-ni` sees one LED on the net and `opto-intan` sees one LED on
the same net. `check_taskpc_digital_netlist.py` asserts no logic output of its own packages
sinks more than one LED cathode anywhere in the netlist and that the 74HCT32 drives none;
both opto checkers assert every LED source net carries exactly one cathode pin board-wide;
`check_breakout_pi_interface_netlist.py` asserts `BARCODE_PI` carries no cathode at all.

## Control / USB-I²C bus (Task 12)

`hardware/breakout/sheets/control-usb-i2c.kicad_sch` is the last schematic-capture sheet on
this board: an `MCP2221A` USB-I²C bridge, on the internal 4-pin USB header
`pi-interface.kicad_sch` (Task 9) already placed (`USB_VBUS_PI`/`USB_DP_PI`/`USB_DM_PI`/
`DGND`), driving an I²C bus that carries two `MCP23017` 16-bit GPIO expanders (32 outputs →
`MUX1_A0`..`MUX8_A3`, exact fit, no spares) and the `MCP4728` quad DAC `comparators.kicad_sch`
(Task 10d) already placed and powered — this sheet only connects to it, it does not
duplicate it. See `hardware/gen/gen_breakout_control_usb_i2c.py`'s own module docstring for
the full design and `hardware/gen/check_breakout_control_usb_i2c_netlist.py` for its
verification. This chain hangs off USB rather than GPIO because mux selection and DAC
thresholds are configuration-time state with no timing requirement, and the sync module's
own 40-pin header is already fully assigned regardless (`pi-interface.kicad_sch`'s own
`GPIO_PIN_SPEC`).

**I²C addresses — three devices, three distinct addresses, no collision** (recorded here
per this task's own instruction, so whoever writes the control software does not have to
re-derive any of this from the schematic):

| Device | Address | How it's set |
|---|---|---|
| `MCP23017` #1 | `0x20` | Hardware pins A2=A1=A0=0, all tied `DGND` |
| `MCP23017` #2 | `0x21` | Hardware pins A2=A1=0 (`DGND`), A0=1 (`+3V3`) |
| `MCP4728` (comparators.kicad_sch, Task 10d) | `0x60` | The part's own EEPROM factory default — no hardware ADDR pins exist on this part at all |

`0x60` was already recorded at Task 10d; checked here against `{0x20, 0x21}` and confirmed
distinct — `check_breakout_control_usb_i2c_netlist.py`'s own `_decode_expander_addr()`
independently DECODES each `MCP23017`'s real address from its own A2/A1/A0 pin-to-rail
wiring (never from a Value-string claim), the same "two candidates wired to one net is a
short, not a redundancy" rigor this project's own ADG1206 A3 near-miss
(task-10c-report.md) already established, applied here to a 1-bit address field instead of
a pin identity.

**GPIO-to-mux-address-line map** (this sheet's own declared, arbitrary-but-fixed
convention — no datasheet fixes this, the same class of board-specific choice
`mux-intan.kicad_sch`'s own `ALL_16_NETS`/`S_PIN_NUMBERS` pairing already is): each
expander's own `GPA0-3` drives its first mux's `A0-A3`, `GPA4-7` the next mux's, `GPB0-3`
the next, `GPB4-7` the last — 16 pins, 4 muxes, exactly. Expander #1 (`0x20`) covers
`MUX1`-`MUX4`; expander #2 (`0x21`) covers `MUX5`-`MUX8`. The mux truth table itself
(`A3 A2 A1 A0` = `0000` → `S1` … `1111` → `S16`, `EN` active-high) is unchanged by this
task — see "ADG1206 mux address truth table" above, confirmed still accurate and reachable
(re-verified against `mux-intan.kicad_sch`'s own committed source while writing this
sheet, not merely assumed carried over).

**MCP2221A powers 3.3V SELF-POWERED (Microchip DS20005565B §1.6.2.3), not USB
bus-powered** — `VDD` and `VUSB` both tie to `+3V3` (this board's own existing rail, not a
new LDO derived from `USB_VBUS_PI`), because the datasheet is explicit that `VDD` sets the
GPIO/SDA/SCL logic-'1' level, and this bus's other two device classes (both `MCP23017`s,
and the `MCP4728`) already run at `+3V3` — powering the bridge from 5V `USB_VBUS_PI` would
put a 5V-referenced driver on a 3.3V-expecting bus, the same class of hazard this project's
own destroy-hardware discipline (comparators.kicad_sch's `+3V3`-not-`+5V` pull-ups;
pi-interface.kicad_sch's `RWD_DLVR` level shift) exists to catch before silicon.
`USB_VBUS_PI` is therefore **deliberately left unconnected** on this sheet — not an
omission; see the generator's own module docstring for the full, datasheet-sourced
reasoning (D+/D-/GND, the header's other three pins, all get real connections).

**I²C bus pull-ups: 2.2 kΩ** on `I2C_SDA`/`I2C_SCL` — this sheet's own sizing decision
(`comparators.kicad_sch`'s own module docstring explicitly defers it here), a standard
two-sided derivation (NXP UM10204, Fast-mode 400 kHz — the `MCP2221A`'s own I²C master
ceiling) landing comfortably inside a ~967 Ω–~3.5 kΩ window; see the generator's own module
docstring for the full numbers.

**ERC warnings: 38 → 3, before/after Task 12** (`hardware/breakout/erc.rpt`, all
`isolated_pin_label`, 0 errors both before and after). 35 cleared — the 32 `MUX{n}_A{bit}`
lines (Task 10c's own exposed-but-undriven address lines), `I2C_SDA` (Task 10d's own
exposed-but-undriven DAC bus pin — `I2C_SCL` was already clear pre-Task-12, covered by a
now-deleted temporary `PWR_FLAG`, see below), and `USB_DP_PI`/`USB_DM_PI` (Task 9's own
header, now reaching the bridge's own D+/D- pins) — all finally get a real second
occurrence once this sheet drives them. **3 remain, all named, none awaiting a future
task:**

1. **`USB_VBUS_PI`** — deliberately unconnected by design (3.3V self-powered mode; see
   above). Not a gap.
2. **`OPTO_INTAN_SPARE1_IN`**, **3. `OPTO_INTAN_SPARE2_ISO`** — `opto-intan.kicad_sch`'s
   own genuine spare optocoupler channels (Task 11: "channels 2 and 4 are the genuine
   spares, one per direction" — see "Opto-Intan" above), outside this task's own scope
   (digital event/isolation channels, unrelated to I²C/mux addressing) and outside every
   other task's scope too — a permanent, documented spare, not a defect.

**A stale `PWR_FLAG` deleted, not left redundant** — the same "a `PWR_FLAG` left on a net
that later gains a real driving pin doesn't just become redundant, check before assuming
one is still needed" discipline this file's own "KiCad gotchas" section already
documents (below): `comparators.kicad_sch` (Task 10d) placed a temporary `sch.power_flag
("I2C_SCL", ...)` because nothing drove `I2C_SCL` yet; deleted here, at Task 12, the moment
`control-usb-i2c.kicad_sch` wires the `MCP2221A`'s own real `bidirectional`-typed SCL pin
(plus both `MCP23017`s' own SCL inputs) onto it — confirmed empirically (0 ERC errors
before and after the deletion, once the real driver existed).

**Two sibling checkers needed small, targeted fixes as a direct consequence of this sheet
existing, not signs of a defect in either:** `check_breakout_power_netlist.py`'s own
`RAIL_BYPASS_EXPECTED` for `("+3V3", "DGND")` moved 6→10 (this sheet's own 4 new
decouplers — `MCP2221A`'s `VDD`+`VUSB` caps, one per `MCP23017`) — the same "will need
updating again once Tasks 10-12 add their own" extension that dict's own comment history
already flagged at every prior task. `check_breakout_pi_interface_netlist.py`'s own
internal-USB-header check moved from a union-based "exactly one reference across
`USB_VBUS_PI`/`USB_DP_PI`/`USB_DM_PI`" assertion (correct when the header was the only
consumer of any of the three) to an intersection-based one (the header is the one
reference common to **all three**, which still correctly identifies it now that this
sheet legitimately adds a second reference — the bridge — on two of the three, deliberately
not the third).

## Whole-board netlist contract (Task 12 fix round 1)

`tests/hardware/test_netlist.py` is a 34-assertion whole-board contract (14 checks, each
with its own negative control) covering this board's hard-won invariants: no `+5V` net
reaching a 3.3V sync-module GPIO, every comparator/I²C pull-up landing on `+3V3` and never
`+5V`, `AISENSE` tied to `AGND` on both NI connectors, both isolated domains pin-disjoint
from every non-isolated rail, Intan capped at exactly 8 analog outputs, `RWD_CMD`/
`RWD_DLVR` and `AGND`/`DGND` genuinely distinct (not just distinctly named), and the
brief's own five original checks. Every one of these guards a property that was actually
violated, by omission, at least once during this board's own build — see the check-level
docstrings in that file for which task, which sheet.

**Checks 13 and 14 are a different shape from the first twelve, deliberately.** Checks
1–12 ask one-hop questions about *nets* ("is this node on that net"). A whole-branch review
found that every verification blind spot on this board was a two-hop question about a
*path*, which no amount of one-hop checking reaches: check 6 matches only a literal `+5V`
node on a GPIO pin and check 7 sees only resistor bridges, so neither can see
`+5V → 430 Ω → optocoupler LED → GPIO`; nothing anywhere examined a driver's own **negative
rail** (an open-collector output's LOW level is its part's V−, so an LM339 on −12 V put
≈ −11.9 V straight onto GPIO20/21/25); and nothing summed a net's total sink load **across
sheets**, so five nets each carried two optocoupler LEDs — structurally invisible per-sheet,
because `opto-ni` sees one LED on the net and `opto-intan` sees one LED on the same net.
Check 13 is a pintype-aware one-hop walk out from every GPIO net (an open-collector output
cannot source, so an LM339 on +12 V is correct by design while the same part on −12 V is
not — distinguishing those two is the entire difficulty, and a check that could not would
have to be loosened until it stopped seeing the real defect); check 14 sums LED and pull-up
current per driver pin against a per-part table. Both were validated against the real
pre-fix netlist before being committed: check 13 returns exactly the 5 real hazard paths
and zero false positives against the HCT541/HCT32 input pins that are correct by design.

**The contract runs against a committed snapshot, not the raw exported netlist.**
`hardware/breakout/breakout.net` is `*.net`-gitignored on purpose (mechanical, fully
re-derivable from the checked-in schematic — see `hardware/.gitignore`'s own comment and
"Byte-reproducibility" below), and this project's CI (`.github/workflows/ci.yml`) installs
no KiCad, so `kicad-cli` never exists there. The first version of this test file parsed
`breakout.net` directly and skipped (via `pytest.mark.skipif`) when that file was absent —
which meant every assertion in it (26 at the time) skipped on every single CI run: green, but testing nothing,
which reads as coverage while providing none. That was found and disclosed in
`task-12-report.md`'s own "Concerns" section, then fixed (fix round 1, same task):

- **`hardware/gen/gen_breakout_netlist_contract.py`** renders an exported netlist into
  `hardware/breakout/netlist-contract.json` — a sorted, UUID-free `{net_name: [(ref, pin,
  pinfunction, pintype), ...]}` mapping plus a `{ref: value}` component-value mapping.
  Deterministic and diffable: no UUIDs (the raw `.net`'s own churn source — see
  "Byte-reproducibility"), one connection per line, references and net names naturally
  sorted (`R2` before `R10`), so a net gaining or losing a connection shows up as a
  one-line diff in review, not buried in ~2200 lines of unrelated regenerated noise.
- **This file IS committed** (not gitignored, unlike `breakout.net` itself) —
  `tests/hardware/test_netlist.py` loads it directly and all 34 of its assertions now run
  unconditionally, in every environment, CI included, with zero dependency on `kicad-cli`
  or even `hardware/gen/` being importable.
- **`tests/hardware/test_netlist_contract_freshness.py`** is the separate, locally-gated
  check that the committed snapshot is still an accurate rendering of the schematic files
  committed alongside it — it re-exports a netlist and rebuilds a snapshot with real
  `kicad-cli` into a temp directory and byte-compares the result against
  `netlist-contract.json`. This is the ONE file in the hardware test suite allowed to
  skip: it does, with an explicit reason, when `kicad-cli` is not on `PATH` (true of this
  project's CI). That optionality is deliberately confined to this one file — the
  contract test above never gates on `kicad-cli` at all.

**How a forgotten snapshot update is caught.** Anyone editing a
`hardware/breakout/sheets/*.kicad_sch` file has KiCad installed locally (a precondition
for editing a schematic at all), so `test_netlist_contract_freshness.py` runs, not skips,
the next time they run `pytest` — it fails loudly, with a diff-shaped message and the
exact regenerate command, if the committed `netlist-contract.json` no longer matches what
`kicad-cli` produces from the sheet as just edited. This is a local, pre-commit-style
gate, not a CI-enforced one — CI has no `kicad-cli` to run the freshness check with, so a
snapshot committed stale would still pass CI (the assertions test the snapshot
faithfully; they cannot independently know it fell out of sync with the schematic). The
"Regenerating fab outputs" recipe below documents the snapshot-regeneration step as a
required part of any sheet change for the same reason — the automated local gate and the
documented manual step are meant to back each other up, not either alone.

**Residual limitation, disclosed rather than left implicit:** the freshness check proves
*reproducibility* (regenerating right now yields the same bytes already committed), not
*correctness*. A bug shared between the run that produced the currently-committed snapshot
and the freshness check's own regeneration — i.e., a latent bug in
`gen_breakout_netlist_contract.py`'s own netlist parsing — would reproduce identically
both times and this check would still pass. Catching that class of bug is what the 26
contract assertions are for instead: they read the parsed electrical content itself,
independent of how it was produced.

## KiCad gotchas found the hard way

These cost real debugging time to find. Recorded here so later tasks — hand-authored or
generated — don't rediscover them.

- **A project's `sym-lib-table` must sit next to its `.kicad_pro`, not just anywhere upstream.**
  KiCad does not search parent directories for it. `hardware/sym-lib-table` satisfies a project
  whose `.kicad_pro` lives directly in `hardware/`; a project in `hardware/mule/` or
  `hardware/breakout/` needs its own copy (or symlink) in that same directory, or
  `kicad-cli sch erc` reports every stock symbol as unresolved (`lib_symbol_issues`) even though
  the schematic itself is correct. Confirmed empirically: identical schematic, identical stock
  symbol, ERC clean one directory level and not the next. A per-project copy also needs its own
  `wl-sync` entry (`uri` relative to that project's `${KIPRJMOD}`, pointing back up to
  `hardware/lib/wl-sync.kicad_sym`) once a sheet places a custom symbol —
  `hardware/breakout/sym-lib-table` has one as of Task 6; `hardware/mule/sym-lib-table` does
  not, since the mule places no custom parts.
- **In a `.kicad_sch`, `lib_symbols` entries must be keyed by the full lib id** —
  `(symbol "Device:R"`, not `(symbol "R"`. Keyed by the bare name, KiCad loads the file without
  error but silently fails to resolve pins: they collapse to the symbol origin, and both pins of
  a two-pin part merge into a single net. There is no error message — the netlist is just wrong.
- **Child unit symbols inside that same `lib_symbols` block keep bare names** —
  `(symbol "R_0_1"`, not `(symbol "Device:R_0_1"`. Only the parent symbol entry is prefixed;
  prefixing a child unit too makes KiCad refuse to load the file at all ("Failed to load
  schematic").
- **Some stock symbols use `(extends "ParentName")` and carry no pin geometry of their own.**
  `74xx:74HCT541` extends `74LS541`; `Regulator_Linear:LD1117S33TR_SOT223` extends `AP1117-15`;
  `Converter_DCDC_Isolated:TMA-0512D` extends `TMA-0505D`. This is common wherever a stock
  library represents several pin-compatible parts (a logic-family variant, a regulator's
  different fixed-voltage options, a DC/DC converter's input/output voltage options) as one
  base symbol plus thin per-variant overrides of just its `Reference`/`Value`/`Footprint`/
  `Datasheet` properties. Extracting the named symbol textually (as the constraints above do)
  yields a real, well-formed block with properties but no pins — silent at generation time.
  Tasks 2 and 3 sidestepped this by naming the extends-free root symbol instead and overriding
  its `Value` property to the real ordered part number (the mule's inbound buffers place
  `74xx:74LS541` with `Value` set to `SN74LVC541APW`, since the '541 pinout is identical across
  the LS/HCT/AHC/AHCT/LVC sub-families — this is standard KiCad practice, not a workaround
  unique to generated schematics, and the mule itself was left exactly as it shipped). Task 6
  resolved the underlying question properly instead of continuing to sidestep it — see the
  dedicated entry below, "A symbol using `(extends "Parent")` does not resolve just by
  embedding both the parent and the child in `lib_symbols`."
- **A raw newline byte inside a `(text "...")` element's quoted string makes KiCad refuse
  the whole file** ("Failed to load schematic") — found adding an on-sheet documentation
  note and initially writing it as one multi-line Python string. Isolated by testing two
  minimal cases: a single-line `text` containing literal parentheses (loads fine) against
  a two-line `text` with an embedded `\n` and no parentheses at all (fails) — so it's
  specifically the embedded newline, not "special characters" in general. `Sch.text()`
  (`hardware/gen/kicad_sch.py`) now asserts against this; call it once per line for a
  multi-line note instead.
- **A `.kicad_pcb` has no `lib_symbols`-style shared library section.** Every placed
  footprint carries its *entire* graphic definition (silkscreen, courtyard, fab-layer
  outline, pads) inline, copied verbatim from the library `.kicad_mod` file — confirmed
  against a real pcbnew-saved board before writing `hardware/gen/kicad_pcb.py`, not
  assumed from the schematic side's different behavior. Coordinates inside a placed
  footprint stay in the footprint's own local frame; only the top-level `(at X Y ROT)`
  moves and rotates it, which is the opposite of a schematic symbol's pins needing a
  manual offset for each label (`kicad_sch.py`'s `pin_pos()`).
- **A quoted string in a `.kicad_mod` file can contain literal, individually-balanced
  parentheses** — e.g. `Resistor_SMD:R_0603_1608Metric`'s own `descr` field: `"...square
  (rectangular) end terminal... (Body size source: ...)"`. A paren-depth scanner that
  doesn't treat `"..."` as opaque still happens to balance correctly here (each string's
  parens pair within themselves), which is a property of today's specific strings, not
  something safe to rely on — `hardware/gen/kicad_pcb.py`'s `_find_balanced()` is
  quote-aware for exactly this reason. (The schematic side has the identical latent gap —
  several stock symbols' `Description` fields contain literal parentheses too — untouched
  here since it has not caused an actual failure; flagged for whoever next edits
  `kicad_sch.py`.)
- **Some newer footprint-generator output uses a `(point ...)` element** (a pin-1 anchor
  marker, e.g. `Package_DIP:DIP-8_W7.62mm`) that needs the same fresh per-instance `uuid` as
  every `fp_line`/`fp_rect`/`fp_circle`/`fp_poly`/`fp_arc`/`fp_text`/`pad` child — omitting
  it produced a `lib_footprint_mismatch` DRC warning on every DIP-8 instance. Found by
  running `kicad-cli pcb drc` and reading exactly what it reported, not by inspection. It
  also needs its **position** rewritten: `point` is the one footprint child whose `(at X Y)`
  in a placed instance is in absolute BOARD coordinates rather than the footprint's local
  frame, at `rot=0` as much as under rotation. Copied through verbatim it lands at its
  local offset from the board origin — on this board, both DIP-8 markers stacked in the
  top-left corner. Established by measuring every point-bearing instance in KiCad's own
  demo boards (all in `demos/pic_programmer`): each equals the library-local point put
  through the footprint's placement transform.
- **In a placed footprint, a pad's or text element's `(at X Y ANGLE)` angle is ABSOLUTE,
  even though its X/Y stay in the footprint's local frame.** Placing a footprint at a
  non-zero rotation means writing `library angle + rotation` (normalised into 0–360) on
  every pad, `fp_text` and property, not copying the library's angles through. In KiCad's
  `demos/pic_programmer`, a `DIP-14_W7.62mm_LongPads` at `rot=90` has all 14 pads at
  `(at LX LY 90)` while the library master has no pad angle at all, and its
  `fp_text "${REFERENCE}"` (library angle 90) is written as 180; a `DSUB-9` at `rot=-90`
  writes pad angle 270. Getting this wrong is silent for a pad whose shape is invariant
  under the rotation (a circle at any angle, a square roundrect at multiples of 90°) and is
  a real geometry error otherwise — an oval, rectangular, keyed or chamfered pad is laid
  down in the wrong orientation at the right centre. Proof, from the gerbers of the same
  footprint plotted both ways at `rot=90`: `%ADD11O,1.600000X2.400000` with the offset
  applied against `%ADD11O,2.400000X1.600000` without it, i.e. the oval pad's long axis in
  the wrong direction. It is also exactly what `kicad-cli pcb drc` reports as
  `lib_footprint_mismatch` on rotated instances — the check re-orients the library master
  to the instance's rotation before comparing, so a pad left at its library angle differs
  from the master by precisely the rotation. (That check only runs at all when a project's
  `fp-lib-table` can resolve the footprint's library; an empty directory with no
  `fp-lib-table` reports nothing either way, which is what makes it easy to mis-attribute.)
- **A symbol using `(extends "Parent")` does not resolve just by embedding both the parent
  and the child in `lib_symbols`, even keyed correctly.** Task 2 left this as an open
  question ("not yet known whether KiCad accepts a lib_symbols entry embedding the extends
  chain the way it does when the GUI places such a part"); Task 6 answered it empirically and
  the answer is no. Embedding `74xx:74LS541` (the extends-free parent) and `74xx:74HCT541`
  (the child, its own `(extends "74LS541")` left exactly as the stock library writes it) side
  by side, keyed by full lib id like any other entry, and placing an instance of the child:
  every one of its pins reports `label_dangling` in ERC and the exported netlist carries zero
  nodes for it — regardless of whether the project's own `sym-lib-table` also has a real,
  resolvable entry for the parent's library (tried both ways, identical failure). KiCad's own
  GUI does not merely copy text when it places a derived symbol — it flattens parent and child
  into one self-contained block with no live `extends` reference left in it, and only a
  schematic already containing that flattened form resolves. `hardware/gen/kicad_sch.py`'s
  `extract_symbol()` now does the same flattening (`_flatten_extends()`): the parent's full
  unit geometry (pins and graphics, its child sub-symbols renamed from the parent's bare name
  to the child's) merged with the child's own top-level property overrides. Verified the same
  way as everything else here — a real `kicad-cli sch erc` + netlist export round-trip on the
  flattened output, confirmed clean (0 errors, correct pin names/numbers), not just that the
  text looks plausible. A symbol using `extends` can now be placed directly by its real name,
  no stand-in Value substitution needed; the mule's own `74LS541`-valued-`SN74LVC541APW`
  workaround was left as-is (already fabricated, not worth touching) rather than migrated.
- **A hierarchical sheet symbol referencing a child `.kicad_sch` file that does not exist yet
  does not fail ERC.** `kicad-cli sch erc` on a root sheet with a `(sheet ...)` whose
  `Sheetfile` points at a nonexistent file reports 0 violations — it silently treats the
  missing sheet as empty, the same as a genuinely empty one. So a root sheet's ten hierarchical
  sheet symbols do not need their ten child files to exist on disk for the root sheet's own
  ERC run to pass; each later task creates its own child file when it populates that sheet
  (confirmed this holds for `kicad-cli sch export svg` too — it plots an empty page for the
  missing child rather than erroring).
- **A real, pcbnew-authored `(sheet ...)` block carries no `(pin ...)` entries until its child
  sheet actually defines hierarchical labels for the parent to expose.** Confirmed against
  KiCad's own shipped demo (`demos/complex_hierarchy`): its `ampli_ht_vertical` and
  `ampli_ht_horizontal` sheet symbols have zero pins. A childless placeholder sheet symbol is
  therefore not a simplification this generator is taking — it is what KiCad itself writes for
  the same situation.
- **`kicad-cli sch export netlist`'s `pinfunction` field is always `"{pin name}_{pin
  number}"`, never the bare pin name.** E.g. a pin named `GPIO2` at number `3` exports as
  `(pinfunction "GPIO2_3")`; a pin named plainly `"1"` at number `"1"` (this project's generic
  connectors use bare position numbers as names — see `hardware/gen/gen_wl_sync_lib.py`)
  exports as `(pinfunction "1_1")`, which reads like a doubled/duplicated value until you check
  a pin with a distinct name and number and see the same `_{number}` suffix appended there too.
  Worth knowing before writing a netlist-contract checker (as
  `hardware/gen/check_mule_netlist.py` and any later `tests/hardware/test_netlist.py` are) that
  asserts on pin names rather than only pin numbers — comparing against the bare name directly
  fails even when resolution is completely correct.
- **Some multi-pin stock symbols split their pins across "unit 0" (KiCad's "common to all
  units" pseudo-unit) and a numbered real unit, instead of keeping every pin in one block.**
  Found at Task 7 placing `Converter_DCDC_Isolated:IH1215D` (a 2W isolated ±15V DC/DC
  converter): its library entry keeps 5 of its 6 pins (`-Vin`/`+Vin`/`-Vout`/`+Vout`/`0V`) in
  a block named `IH0503D_0_0` (unit 0) and only the 6th (`NC`) in `IH0503D_1_1` (unit 1).
  `hardware/gen/kicad_sch.py`'s `unit_pins(block, symname, unit=1)` — written against every
  part used through Task 6, none of which split this way — looked only at unit 1's own block
  and silently returned a 1-pin result instead of 6. Not silent for long: the next line that
  tried `pins["1"]` (the power pin this generator actually needed) raised `KeyError`, so this
  one surfaced as a loud crash rather than constraint 1's usual silent-wrong-netlist failure —
  but a symbol whose split pins are simply the ones actually used by the caller could still
  fail Task 6's exact way. Fixed generically in `unit_pins()` itself (not special-cased to
  this one symbol): it now merges unit 0's pins with the requested unit's own, matching how
  KiCad's GUI actually renders a placed instance (unit-0 content is shown regardless of which
  unit is selected). Confirmed harmless for every symbol already in use — for all of them,
  unit 0 either doesn't exist in the library entry or exists as pin-less body graphics only,
  so the merge is a no-op there.
- **A series element (a pi filter's ferrite bead, say) that bridges two DIFFERENTLY-NAMED
  nets breaks ERC's `power_pin_not_driven` check on the downstream one, even though real
  current still reaches it.** `Device:FerriteBead`'s pins are typed `passive`, and ERC's
  check is evaluated per NET NAME, not by tracing through passive components across a
  net-name boundary — so a node like the power sheet's `ISO_P15_FILT` (between a pi filter's
  ferrite bead and a regulator's `IN` pin) has no `power_out`-typed pin on IT specifically,
  even though the isolated DC/DC's own `power_out` pin drives the net one hop upstream
  (`ISO_P15_RAW`, on the OTHER side of the ferrite). Same fix as any other undriven
  power-input net: `sch.power_flag()` on the downstream node — see
  `hardware/gen/gen_breakout_power.py`'s `build()` for the two instances this took
  (`ISO_P15_FILT`/`ISO_N15_FILT`), the first time this codebase's generators needed a
  PWR_FLAG on something other than a literal contract-rail or entry-point net.
- **A CHILD sheet's own components must NOT reuse that file's own root uuid as their
  `(instances (path ...))` prefix — that prefix has to be the ROOT project's uuid plus
  the placing SHEET SYMBOL's own uuid, read off the real parent file, not invented.**
  Every generator through Task 6 only ever built hierarchy ROOTS (`mule.kicad_sch`,
  `breakout.kicad_sch`), where `kicad_sch.py`'s `Sch` defaulting `(instances (path
  "/{self.root_uuid}" ...))` to the file's own identity uuid is exactly correct — a
  component placed directly on a root's own canvas really does carry just `/<that
  file's own uuid>` (confirmed against KiCad's own shipped
  `demos/complex_hierarchy/complex_hierarchy.kicad_sch`). Task 7's `power.kicad_sch` is
  this codebase's first CHILD sheet, and the same default is wrong there: found (not by
  ERC, which stayed silent throughout — see below) reviewing the committed file, all 47
  of its own placed instances carried `power.kicad_sch`'s own root uuid instead of
  breakout.kicad_sch's root uuid + the "power" sheet symbol's own uuid. Confirmed
  against the same KiCad demo project, this time its genuinely nested child sheet
  (`ampli_ht.kicad_sch`, placed TWICE from `complex_hierarchy.kicad_sch` as both
  "ampli_ht_vertical" and "ampli_ht_horizontal"): every one of its own components
  carries TWO `(path ...)` entries, `/<complex_hierarchy's root uuid>/<vertical sheet
  symbol's own uuid>` and `/<same root uuid>/<horizontal sheet symbol's own uuid>` —
  `ampli_ht.kicad_sch`'s OWN file-identity uuid appears in neither, proving only the
  PLACING sheet symbol's own uuid belongs in the chain, never the child file's own.
  **Silent for ERC and for `kicad-cli sch export netlist` alike**: confirmed empirically
  (regenerating this exact sheet before and after the fix and diffing the exported
  netlist byte-for-byte) that `kicad-cli sch export netlist` recomputes every
  component's own `sheetpath`/`tstamps` fields by walking the real `(sheet ...)` file
  hierarchy from the invoked root, never by reading a component's own `(instances (path
  ...))` bookkeeping at all — so this defect does not show up as any difference in ERC
  output OR in the exported netlist, only in the raw `.kicad_sch` source itself. It
  still matters: it is exactly the class of bug Task 3 hit on the mule board's own
  schematic-to-PCB cross-links (`hardware/gen/gen_mule_pcb.py`, fixed by reading the
  netlist's real component uuids instead of an in-process value), here one level up in
  the SAME "don't invent identity data, read the real committed artifact" family, and it
  silently breaks KiCad's own cross-probing between sheets and any future PCB
  generator's schematic cross-link for a child-sheet component. Fixed at Task 7 fix
  round 1 (task-7-report.md's "Fix round 1"), generically rather than sheet-specifically
  (Tasks 8-12 all build further child sheets): `Sch` now takes an explicit
  `instance_path_prefix` (default `None`, meaning "I am a hierarchy root" — unchanged
  behaviour for every existing root-only generator); a child-sheet generator computes
  the real prefix by reading its own parent `.kicad_sch` off disk with two new
  `kicad_sch.py` helpers, `find_root_uuid()` and `find_sheet_instance_path()` (a third,
  `find_all_instance_paths()`, lets a checker independently confirm every instance in a
  child sheet actually resolved correctly, rather than only trusting the generator ran
  the new code path) — see `gen_breakout_power.py`'s own `build()` and
  `check_breakout_power_netlist.py`'s `verify_instance_paths()`. Also gated
  `Sch.render()`'s `(sheet_instances ...)` block to root sheets only on the same
  evidence: `ampli_ht.kicad_sch` (real, nested, used twice) carries NO such block at
  all, unlike its own root parent's single `(path "/" (page "1"))` entry describing
  only itself.
- **Two sibling child sheets, each built by an independent `Sch` instance, silently mint
  DUPLICATE reference designators the moment both have real content.** `next_ref()`
  starts every prefix at 1 per `Sch` instance, which is exactly correct for a single
  sheet in isolation — but every generator through Task 7 only ever built the FIRST real
  child sheet to exist alongside another one (`power.kicad_sch`, Task 7), so this never
  actually collided with anything. Task 8 (`taskpc-digital.kicad_sch`) is this project's
  second real sheet, and its own independently-started "J1"/"R1"/"C1"/"D1"/"U1" collided
  head-on with `power.kicad_sch`'s OWN "J1" (the M12A_5 inlet) etc. — two physically
  different parts sharing one reference string, a genuine BOM/assembly ambiguity, not
  just cosmetic. Silent for `kicad-cli sch erc` (0 errors either way — ERC does not
  check cross-project reference uniqueness), but NOT silent for `kicad-cli sch export
  netlist`, which prints `Warning: schematic has annotation errors, please use the
  schematic editor to fix them`, and NOT silent for
  `hardware/gen/check_mule_netlist.py`'s own `parse_component_values()` — shared
  infrastructure `check_breakout_power_netlist.py` already depends on, and every future
  child-sheet checker will too — which hard-asserts globally unique references and
  raises immediately on the first duplicate it finds. A real KiCad user hits the
  identical situation hand-building a multi-sheet project and resolves it with
  Eeschema's own "Annotate Schematic" tool; this generator has no equivalent, so
  `kicad_sch.py`'s `Sch` gained an optional `ref_start: dict[str, int] | None` field
  (default `None`, unchanged behaviour for every generator that doesn't pass it) plus a
  new `find_max_refs(sch_text)` helper that reads a SIBLING sheet's own already-committed
  `.kicad_sch` text and returns `{prefix: highest number already used}` — a child-sheet
  generator seeds `Sch(..., ref_start=find_max_refs(sibling_text))` so its own
  `next_ref()` calls continue past whatever a sibling already used, rather than
  restarting at 1 and colliding. Same "read the real committed artifact, don't invent
  identity data" discipline `instance_path_prefix` already established for uuids,
  extended to reference numbers — see `gen_breakout_taskpc_digital.py`'s own `build()`.
  **A future child-sheet generator (Tasks 9-12) needs to seed from EVERY already-committed
  sibling sheet's own maxima, not only `power.kicad_sch`** — this fix handles two real
  sheets; a third and beyond needs the same treatment extended to read all of them.
  Also broke `check_breakout_power_netlist.py`'s own `RAIL_BYPASS_EXPECTED` regression
  guard, unrelatedly: `+5V`/`+3V3` are shared rails, and `_rail_bypass_cap_count()` counts
  bypass/bulk capacitors PROJECT-WIDE, so `taskpc-digital.kicad_sch`'s own per-IC
  decoupling on those two rails (legitimate, necessary, not a defect) changed the real
  total the moment a second real sheet existed to add any. Fixed by updating the two
  affected counts (recomputed directly against the regenerated netlist, not guessed) —
  flagged there as needing the SAME update again once Tasks 9-12 also decouple their own
  ICs on `+5V`/`+3V3`, an expected consequence of that function's own project-wide scope,
  not a one-time fix.

  **Extended at Task 9, exactly as flagged above**: `pi-interface.kicad_sch` is this
  project's THIRD real child sheet (after `power.kicad_sch` and `taskpc-digital.kicad_sch`,
  both already committed), so seeding past only one of them is no longer sufficient —
  `find_max_refs()` itself still only reads ONE sheet's text (unchanged), but
  `kicad_sch.py` gained a new `merge_max_refs(*ref_maps)` helper that takes the per-prefix
  MAXIMUM across as many `find_max_refs()` results as are passed in, so
  `gen_breakout_pi_interface.py`'s own `build()` seeds
  `Sch(..., ref_start=merge_max_refs(find_max_refs(power_text), find_max_refs(taskpc_text)))`
  — generic machinery in `kicad_sch.py`, not a sheet-specific workaround, so Tasks 10-12
  extend the same call with their own additional sibling(s) rather than re-solving this.
  Also updated `check_breakout_power_netlist.py`'s own `RAIL_BYPASS_EXPECTED` again, the
  same way Task 8 already did once: `pi-interface.kicad_sch` adds two more ICs on the
  shared `+5V`/`+3V3` rails (the `RWD_DLVR` level-shifter and the trigger-output buffer,
  one 100nF decoupler each), so `+5V`/`DGND` moved 8→9 and `+3V3`/`DGND` moved 5→6 —
  flagged there, again, as needing the SAME update once Tasks 10-12 add their own.
- **Two satellite components placed at a fixed offset from TWO DIFFERENT pins of the same
  multi-column connector can land on the exact same coordinate, even when the two pins
  themselves are visibly apart.** Found placing `pi-interface.kicad_sch`'s own GPIO0/GPIO1
  330Ω series resistors (Task 9): `wl-sync:RaspberryPi5_GPIO_Header`'s left (odd-numbered)
  and right (even-numbered) pin columns are built from ONE shared per-row Y coordinate list
  (`gen_wl_sync_lib.py`'s own `build_symbol()` — `ys[i]` indexes both `left[i]` and
  `right[i]`), so GPIO0 (physical pin 27, left column) and GPIO1 (physical pin 28, right
  column) — consecutive odd/even numbers — sit on the SAME row, differing only in X, not Y.
  Placing both resistors at one fixed `(X, y)` (`y` taken from the header pin's own Y,
  reused for both) stacked them on an identical point: `kicad-cli sch erc` reported
  `multiple_net_names` ("Both GPIO0_HDR and GPIO1_HDR are attached to the same items") on
  the first generation attempt. A first fix attempt (a per-instance Y offset between the
  two resistors) picked exactly 7.62mm — `Device:R`'s own pin-to-pin span (pin 1 at local Y
  +3.81, pin 2 at −3.81, confirmed via `unit_pins()`) — which moved the COLLISION one
  component over instead of removing it (R\<n\>'s own pin 2 landed exactly on R\<n+1\>'s own
  pin 1). An offset comfortably larger than the part's own pin span (12.7mm, this project's
  own `LOAD_DY` constant reused) cleared both. Worth checking for any future generator
  placing more than one satellite part per row of a two-column connector, not just this
  one header.
- **A `PWR_FLAG` left on a net that later gains a REAL driving pin doesn't just become
  redundant — it can actively break `kicad-cli sch erc`.** Confirmed at Task 10d:
  `taskpc-digital.kicad_sch` (Task 8) placed a `sch.power_flag()` on each of
  `PD1_COMP`/`PD2_COMP`/`ACC_TRIG`/`RHS_STIM_OUT` specifically because nothing drove them
  yet (Tasks 10/11 didn't exist) and an `input`-typed buffer pin with no driver anywhere in
  the project trips ERC's own `pin_not_driven` — a real, not a false, finding at the time.
  The moment `comparators.kicad_sch` (Task 10d) wired a genuine `open_collector` output
  pin onto three of those same four nets, the SURVIVING `PWR_FLAG`s tripped a NEW error —
  `pin_to_pin`, "Pins of type Open collector and Power output are connected" — confirmed
  empirically (3 errors, one per stale flag, before deleting the three stale flags, 0
  after — corrected here from an earlier, uncorroborated "4"; a later reviewer
  reconstructed this commit and measured 3, with no `I2C_SCL` involvement, matching the
  arithmetic directly: three surviving flags, three conflicts). Fixed by deleting
  exactly the three `sch.power_flag()` calls whose own net now has a real driver (not the
  fourth, `RHS_STIM_OUT`, which still has none — Task 11's own job) — see
  `gen_breakout_taskpc_digital.py`'s own `_place_outbound()`, which already flagged this
  exact deletion as required the moment Task 10 existed. A `PWR_FLAG` used as this
  project's own "assert this net is driven for now, pending a real driver" idiom (also
  used by `gen_breakout_power.py` for `ISO_P15_FILT`/`ISO_N15_FILT`, and by
  `gen_breakout_comparators.py` itself for `I2C_SCL`, pending Task 12) is therefore a
  standing TODO for whichever later task adds the real driver, not a one-time placeholder
  that quietly stops mattering — check its own net for a genuine driving pin before
  assuming a `PWR_FLAG` there is still needed.
- **`Sch.place()`'s new `dnp` parameter (Task 10d) is generation-time-only and changes
  NOTHING about connectivity** — a DNP-marked part's pins are wired exactly as instructed,
  fully present in both `kicad-cli sch erc`'s own analysis and the exported netlist's
  `(nets ...)` section (confirmed empirically: `comparators.kicad_sch`'s own two DNP
  resistors, the unpopulated 4th channel's pull-up and hysteresis feedback, appear in the
  exported netlist's connectivity graph identically to every populated resistor). What DOES
  change: each DNP component's own `(comp (ref ...) ...)` block in the exported netlist
  gains a value-less `(property (name "dnp"))` marker, present ONLY when `dnp=yes` and
  absent entirely otherwise (not `(value "no")`) — confirmed directly against the real
  export, not assumed from the `.kicad_sch` source's own `(dnp yes/no)` field shape. This
  is what lets a checker confirm a "populate option" part is genuinely marked unpopulated
  (`check_breakout_comparators_netlist.py`'s own `parse_dnp_refs()`) without re-parsing the
  raw schematic source for it.
- **`kicad-cli sch export netlist`'s own `(net (code ...) (name ...))` line is NOT
  single-space-separated in KiCad 10.0.5's real output — it is one field per line, tab
  -indented** (`(net\n\t\t\t(code "1")\n\t\t\t(name "+3V3")...`). Found writing
  `tests/hardware/test_netlist.py` (Task 12): task-12-brief.md's own literal example regex
  (`r'\(net \(code "\d+"\) \(name "([^"]+)"\)'`, single literal spaces between tokens)
  matches **zero** nets against the real, current artifact — not a vacuous pass, an
  outright `nets() == set()` that fails every one of the brief's own assertions
  immediately and loudly (a `KeyError`/empty-set failure, not a silent wrong answer, so
  this one is self-announcing rather than dangerous the way constraint 1's bare-keyed
  `lib_symbols` failure is) the moment the resulting test file is actually run against a
  real export rather than merely written and assumed correct. `\s*`/`\s+` (matching
  `hardware/gen/check_mule_netlist.py`'s own proven-correct, whitespace-tolerant
  `parse_netlist()` regex, unchanged since Task 2) is what actually reads the real file
  this project's own toolchain produces — worth using that technique (or importing/
  reusing it) rather than a literal transcription of any example regex, in this file or
  any brief, that has not itself been run against a real, current export.
- **A netlist "does reference A and B" check based on shared REFERENCE (not shared PIN) can
  false-positive on any multi-pin IC that happens to have one, electrically unrelated, pin
  on each of the two nets being compared.** Found writing `tests/hardware/test_netlist.py`
  (Task 12)'s own comparator/I²C pull-up-domain checks: an early version flagged `U11`
  (`SN74AHCT541PW`, `taskpc-digital.kicad_sch`'s own outbound buffer) as "bridging"
  `+5V`↔`PD1_COMP`, because its own pin 20 (`VCC`) legitimately sits on `+5V` (its own
  power supply) while a completely different, unrelated pin (one buffer channel's own
  input) legitimately sits on `PD1_COMP` (receiving the comparator's own output to buffer
  toward the task PC) — the two pins are not connected to each other inside the part at
  all. Every `hardware/gen/check_breakout_*_netlist.py` checker in this project already
  avoids this by restricting a "bridging component" search to `R`-prefixed references
  specifically (`_find_bridging_resistor()`, present in every checker from Task 7 onward);
  `tests/hardware/test_netlist.py`'s own `_bridging_resistor_refs()` applies the identical
  restriction, independently re-derived rather than imported (this file's own "why not
  import hardware/gen/'s checkers" reasoning applies here too). A **pin**-level check (not
  reference-level) has no such false-positive exposure at all — `check_mule_netlist.py`'s
  own isolation-barrier check, and `tests/hardware/test_netlist.py`'s own project-wide
  isolated-domain and `AGND`/`DGND`/`RWD_CMD`-vs-`RWD_DLVR` checks, use exactly that
  stronger form and need no per-part-class filtering at all.

## Byte-reproducibility

Regenerating `mule.kicad_sch` or `mule.kicad_pcb` from the same generator and inputs
produces a file that is **semantically identical but not byte-identical** to the one
already checked in. Every placed symbol, footprint, pad, and graphic element gets a fresh
random UUID on each run (`uuid.uuid4()`, `hardware/gen/kicad_sch.py`'s and
`kicad_pcb.py`'s `uid()`), and KiCad has no notion of a "canonical" UUID a generator could
reuse instead. A `git diff` after regenerating will show the whole file as changed even
when nothing about the design did — this is expected, not a sign the generator is broken
or non-deterministic in any way that matters: net names, pin/pad connectivity, placement
coordinates, and part values are all fully determined by the generator's own code and
inputs, and `hardware/gen/check_mule_netlist.py`'s job is exactly to verify that the
*meaning* reproduces, independent of the UUIDs a run happens to mint.

## Regenerating fab outputs

For the mule, the generators run in this order — the PCB generator reads the schematic's
own exported netlist as its source of connectivity (see `hardware/gen/gen_mule_pcb.py`'s
module docstring), so it depends on a fresh export existing, not just a fresh schematic:

```bash
python3 hardware/gen/gen_mule.py
kicad-cli sch upgrade hardware/mule/mule.kicad_sch                  # see "Format upgrade" below
kicad-cli sch export netlist --format kicadsexpr -o hardware/mule/mule.net hardware/mule/mule.kicad_sch
python3 hardware/gen/check_mule_netlist.py hardware/mule/mule.net   # verifies the netlist, not just that ERC passed
python3 hardware/gen/gen_mule_pcb.py
kicad-cli pcb upgrade hardware/mule/mule.kicad_pcb                  # see "Format upgrade" below
```

For the breakout board's own library, root sheet, and (Tasks 7-12) its ten child sheets --
power, task-PC-digital, pi-interface, analog-frontend, analog-ni, mux-intan, comparators,
opto-ni, opto-intan, control-usb-i2c, in that exact order and no other. Order matters here
in a way it didn't before Task 7 fix round 1: `gen_breakout_power.py` and every child
generator after it *read* `hardware/breakout/breakout.kicad_sch` (to compute their own
components' real root+sheet-symbol ancestor path -- see the "KiCad gotchas" entry above
and any `gen_breakout_*.py`'s own `build()`), so `gen_breakout.py` must have already run
and written that file, not merely conceptually precede it in the hierarchy -- running any
child generator first raises `FileNotFoundError`, loudly, not silently. Each child
generator ALSO reads every already-committed sibling that precedes it (to seed its own
reference counters past every prior sheet's own maximum via `merge_max_refs()` -- see the
"KiCad gotchas" entry above, "Extended at Task 9"), which is why the list below is a strict
chain, not ten independent runs: `analog-frontend` reads power+taskpc-digital+pi-interface;
`analog-ni` adds analog-frontend; `mux-intan` adds analog-ni; `comparators` adds mux-intan;
`opto-ni` adds comparators; `opto-intan` adds opto-ni; `control-usb-i2c` (Task 12, the last
sheet on this board) adds opto-intan -- each one strictly the union of every sheet already
listed above it:

```bash
python3 hardware/gen/gen_wl_sync_lib.py                             # hardware/lib/wl-sync.kicad_sym
python3 hardware/gen/gen_wl_sync_footprints.py                      # hardware/lib/wl-sync.pretty/*.kicad_mod
python3 hardware/gen/gen_breakout.py                                # hardware/breakout/breakout.kicad_sch -- must run before every child sheet below
python3 hardware/gen/gen_breakout_power.py                          # sheets/power.kicad_sch (Task 7)
python3 hardware/gen/gen_breakout_taskpc_digital.py                 # sheets/taskpc-digital.kicad_sch (Task 8) -- reads power
python3 hardware/gen/gen_breakout_pi_interface.py                   # sheets/pi-interface.kicad_sch (Task 9) -- adds taskpc-digital
python3 hardware/gen/gen_breakout_analog_frontend.py                # sheets/analog-frontend.kicad_sch (Task 10a) -- adds pi-interface
python3 hardware/gen/gen_breakout_analog_ni.py                      # sheets/analog-ni.kicad_sch (Task 10b) -- adds analog-frontend
python3 hardware/gen/gen_breakout_mux_intan.py                      # sheets/mux-intan.kicad_sch (Task 10c) -- adds analog-ni
python3 hardware/gen/gen_breakout_comparators.py                    # sheets/comparators.kicad_sch (Task 10d) -- adds mux-intan
python3 hardware/gen/gen_breakout_opto_ni.py                        # sheets/opto-ni.kicad_sch (Task 11 step 1) -- adds comparators
python3 hardware/gen/gen_breakout_opto_intan.py                     # sheets/opto-intan.kicad_sch (Task 11 step 2) -- adds opto-ni
python3 hardware/gen/gen_breakout_control_usb_i2c.py                # sheets/control-usb-i2c.kicad_sch (Task 12) -- adds opto-intan; the last sheet on this board
kicad-cli sch upgrade hardware/breakout/breakout.kicad_sch           # see "Format upgrade" below
kicad-cli sch upgrade hardware/breakout/sheets/power.kicad_sch       # ditto -- a child sheet is its own .kicad_sch file
kicad-cli sch upgrade hardware/breakout/sheets/taskpc-digital.kicad_sch  # ditto
kicad-cli sch upgrade hardware/breakout/sheets/pi-interface.kicad_sch    # ditto
kicad-cli sch upgrade hardware/breakout/sheets/analog-frontend.kicad_sch # ditto
kicad-cli sch upgrade hardware/breakout/sheets/analog-ni.kicad_sch      # ditto
kicad-cli sch upgrade hardware/breakout/sheets/mux-intan.kicad_sch      # ditto
kicad-cli sch upgrade hardware/breakout/sheets/comparators.kicad_sch    # ditto
kicad-cli sch upgrade hardware/breakout/sheets/opto-ni.kicad_sch        # ditto
kicad-cli sch upgrade hardware/breakout/sheets/opto-intan.kicad_sch     # ditto
kicad-cli sch upgrade hardware/breakout/sheets/control-usb-i2c.kicad_sch # ditto
kicad-cli sch export netlist --format kicadsexpr -o hardware/breakout/breakout.net hardware/breakout/breakout.kicad_sch
python3 hardware/gen/check_breakout_power_netlist.py hardware/breakout/breakout.net          # verifies the power sheet's own netlist AND (reading breakout.kicad_sch/power.kicad_sch directly, not the netlist -- see its own module docstring) the instance-path fix, not just that ERC passed
python3 hardware/gen/check_taskpc_digital_netlist.py hardware/breakout/breakout.net          # verifies the task-PC digital sheet's own netlist end to end (both buffer banks) AND its own instance-path fix
python3 hardware/gen/check_breakout_pi_interface_netlist.py hardware/breakout/breakout.net   # verifies the sync-module interface sheet's own netlist end to end (every GPIO on its real physical pin) AND its own instance-path fix
python3 hardware/gen/check_breakout_analog_frontend_netlist.py hardware/breakout/breakout.net
python3 hardware/gen/check_breakout_analog_ni_netlist.py hardware/breakout/breakout.net
python3 hardware/gen/check_breakout_mux_intan_netlist.py hardware/breakout/breakout.net
python3 hardware/gen/check_breakout_comparators_netlist.py hardware/breakout/breakout.net
python3 hardware/gen/check_breakout_opto_ni_netlist.py hardware/breakout/breakout.net
python3 hardware/gen/check_breakout_opto_intan_netlist.py hardware/breakout/breakout.net
python3 hardware/gen/check_breakout_control_usb_i2c_netlist.py hardware/breakout/breakout.net
python3 hardware/gen/gen_breakout_netlist_contract.py                # hardware/breakout/netlist-contract.json -- run LAST, once every checker above has passed; commit this file alongside any sheet change (see "Whole-board netlist contract" above)
```

Regenerating `breakout.kicad_sch` and any of its ten child sheets mints fresh UUIDs on
every one of their own components too (same byte-reproducibility caveat below), which is
harmless in isolation but means a LATER child sheet generated against a
freshly-regenerated parent embeds THAT run's UUIDs in its own `(instances (path ...))`
chain -- regenerating only the ONE sheet actually being edited, against the
ALREADY-COMMITTED (not freshly regenerated) root and every other sibling, is the one that
reproduces the actually-committed state for everything else; regenerating the full chain
above is equally correct but changes every earlier file's own bytes too, which is real
churn to commit unless those earlier sheets are ALSO meant to change this run. Either way,
`hardware/breakout/breakout.net` must be re-exported and `gen_breakout_netlist_contract.py`
re-run afterward -- `tests/hardware/test_netlist_contract_freshness.py` fails, locally,
with a diff-shaped message, if a sheet changed and the snapshot wasn't regenerated to
match (see "Whole-board netlist contract" above).

The library generators each run a structural self-check (round-tripping every symbol/
footprint through `kicad_sch.py`'s/`kicad_pcb.py`'s own parser) before writing anything to
disk, and both `.kicad_sym`/`.kicad_mod` outputs additionally pass `kicad-cli sym upgrade`/
`kicad-cli fp upgrade` cleanly (exit 0, "library was not updated" — already current-format,
well-formed KiCad). Symbol/footprint correctness beyond "well-formed" (constraint 1's
silent-wrong-netlist failure mode) is not something a lone `.kicad_sym`/`.kicad_mod` file can
prove on its own — see the Task 6 report for the scratch-schematic + netlist-export proof run
against every custom symbol.

**Format upgrade.** Each generator writes the file-format version its grammar was written
against and validated on — `20231120` for the schematic, `20241229` for the board, both
stamped `generator "wl-sync-gen"`. The committed `mule.kicad_sch` and
`mule.kicad_pcb` are the upgraded files — `kicad-cli sch upgrade` / `kicad-cli pcb upgrade`
re-save them in the current format (`generator "eeschema"` / `"pcbnew"`), which is what
KiCad itself would write the first time a person opens and saves either file. The upgrade
steps are part of the recipe, not optional polish: skip them and regeneration produces a
semantically identical file that differs from the committed artifact in its version stamp,
its generator name, and a set of formatting normalisations KiCad applies (for instance a
footprint placed at `rot=270` is re-saved as `-90`).

Order matters in one place: `gen_mule_pcb.py` reads the exported netlist for both
connectivity and the schematic cross-link UUIDs each footprint's `(path ...)` points at, so
the netlist export has to come from the same `mule.kicad_sch` that is being committed.
Export it before running the PCB generator, not after.

Then the standard `kicad-cli` invocations, once a track has a schematic and layout:

```bash
# Electrical rules check
kicad-cli sch erc --exit-code-violations -o hardware/<track>/erc.rpt hardware/<track>/<track>.kicad_sch

# Design rules check
kicad-cli pcb drc --exit-code-violations -o hardware/<track>/drc.rpt hardware/<track>/<track>.kicad_pcb

# Gerbers and drill files
kicad-cli pcb export gerbers -o hardware/<track>/fab/ hardware/<track>/<track>.kicad_pcb
kicad-cli pcb export drill -o hardware/<track>/fab/ hardware/<track>/<track>.kicad_pcb

# Bill of materials
kicad-cli sch export bom -o hardware/<track>/<track>-bom.csv hardware/<track>/<track>.kicad_sch
```

Neither `hardware/mule/mule.net` nor `hardware/breakout/breakout.net` is committed — see
`.gitignore` and the byte-reproducibility note above for why a mechanically-regenerable,
driftable-if-stale artifact stays out of the tree the same way every `.kicad_sch`'s netlist
export always has. `hardware/breakout/netlist-contract.json` is the one deliberate
exception to that rule on this board: it is DERIVED from `breakout.net` (by
`gen_breakout_netlist_contract.py`) but IS committed, because it has had every UUID (the
raw netlist's own source of unreviewable diff noise) stripped out before being written —
see "Whole-board netlist contract" above.

`<track>` is `mule` or `breakout`. All of these are deterministic from the checked-in source
files, and fab outputs (`fab/`, BOM CSVs) are committed alongside them so a board can be
re-ordered without re-running layout. `hardware/.gitignore` excludes only KiCad's own transient
files — backups, lock files, the footprint-info cache — not fab outputs.
