jakewesterberg/wl-sync/hardware/breakout/parametric-audit.md

# Breakout board — parametric audit, 2026-08-15

Twenty-one findings from a pre-layout audit against primary datasheets. This document exists
separately from `design-review.md` because it records a different *kind* of check.

## Why this is separate from every check that already passed

Before this audit the board was ERC-clean, passing twelve structural checkers and an 80-test
suite. Seven of the findings below would have prevented it working.

That is not a failure of those checks. They verify **topology** — is this pin on the right
net, is this rail correct, do the isolated domains stay pin-disjoint, is the bit order
preserved through the buffers. Every finding here is **parametric** — does this current clear
a datasheet minimum, does this voltage survive the series drops in front of it, does this
converter's rating cover its load, does this footprint's axis match the mechanics of the
enclosure.

**The board was verified for connectivity and largely not for operating points.**

*Largely*, not entirely — corrected 2026-08-16. `tests/hardware/test_netlist.py`'s
`test_driver_pin_sink_load` IS a parametric check: it computes per-pin sink current from
component values and compares against a per-part I_OL budget table, and its own comment
records that it already caught a real defect (the original `SN74HCT541` at 6 mA was 22% over
its rated sink, which is why the board moved to the AHCT variant).

That check verifies the **upper** bound — current must not exceed what the driver can sink.
Nobody checked the **lower** bound — current must clear what the optocoupler needs to switch.
F1 is the exact mirror image of an assertion that was already present, which is why it
survived: half the constraint was tested and half was not.

Section 5 proposes the checkers that close the rest of the gap.

> **Status, 2026-08-16: EVERY finding below is now closed.** F1, F2, F3, F4, F5, F6, F7, M1,
> M2, M3, M4, M7, D1 and D3 each carry an IMPLEMENTED (or CLOSED) block recording what shipped
> and, where it differed, why — the implementation corrected this document **seven** times,
> and those corrections are marked in place rather than silently applied. Five corrections
> came from the electrical half; F6 and D3 added two more.
>
> The mechanical half (F6, D3, the MDR68 rebuild, retiring `M12A_5_Panel`, the dual-BNC
> footprint and the panel elevations) landed 2026-08-16. Its own account is in
> `connector-handoff.md`, with the redrawn panel in `panel-elevations.md` and the panel-
> thickness decision in `d3-panel-thickness.md`.
>
> Verification baseline: **13/13 sheet checkers, 121 tests, ERC 0 errors / 3 pre-existing
> warnings**, BOM cross-checked against the netlist by `tests/hardware/test_bom_matches_netlist.py`,
> and `netlist-contract.json` byte-identical across two full regenerations.
>
> The 13th checker is new: `check_footprint_geometry.py`, which reads the real `.kicad_mod`
> files off disk and asserts their geometry against `datasheet-params.toml`. It exists because
> **nothing in this toolchain read footprint geometry at all** — a footprint with the wrong
> drill, pitch or axis produced a clean netlist, passed ERC and passed every test. The MDR68's
> 0.5 mm drill against a required 0.85 mm survived seventy-odd commits that way.

Severity keys: **F** = would prevent correct operation. **M** = marginal or robustness.
**D** = documentation error. **R** = needs a human ruling.

---

## 1. Functional failures

### F1 — Optocoupler LEDs are under-driven on 30 channels — **IMPLEMENTED 2026-08-16**

> **Both halves landed together**, as this finding requires. What shipped:
>
> - **Resistors, rail-aware:** 430 Ω → **249 Ω** on the 30 LEDs fed from `+5V`, and → **301 Ω**
>   on the 2 fed from `ISO_5V` (`R183`, `R185`). One value would have been wrong on one rail
>   or the other.
> - **Paralleling:** every buffer-driven LED now has **two `SN74AHCT541` outputs from tied
>   inputs**. Four new packages, `U70`–`U73`, plus `C151`–`C154` — 5 packages to 9, with 6
>   spare channels. Refdes minted out of band, above the board maximum; **nothing already
>   placed was renumbered** (verified by diffing the netlist contract: 8 refs added, 0 removed,
>   0 moved).
> - **One extra channel this exposed:** `RHS_STIM_OUT`'s LED was the single channel driven by
>   an ACSL-6420 output rather than a buffer — a deliberate exception that was correct at
>   430 Ω (8.61 mA of a 13 mA budget) and became *incorrect* at 249 Ω (13.85 mA with its
>   pull-up). It moved to a new buffered leg, `RHS_STIM_OUT_BUF`, off `U11`'s last two spare
>   channels. **The exception did not change; the number it had been checked against did.**
> - **Checkers, both bounds** (§5's first two rows, and then some): worst-case current clears
>   the 8 mA guardbanded floor; best-case stays under the 15 mA absolute maximum; per-pin sink
>   divides across paralleled drivers; per-**package** ground current against ±75 mA; and
>   paralleled outputs must have tied inputs. Each with a negative control that fires.
>
> Verification: 12/12 sheet checkers, 93 tests, ERC unchanged (0 errors, the same 3
> pre-existing spare-label warnings). BOM cross-checked against the netlist — 535 parts, no
> discrepancies.
>
> **Prerequisite that had to be fixed first:** `gen_breakout_opto_ni.py` and
> `gen_breakout_opto_intan.py` seeded `ref_start` by reading sibling sheets live, so merely
> regenerating them — which F1 requires — renumbered their entire refdes space (`U56`–`U62` →
> `U70`–`U76` and so on), because `taskpc-digital` had since gained `U69`. Both are now pinned.
> **Five other generators remain armed with the same latent bug** — see the note at the end of
> this finding.
>
> **Still open, and deliberately not done here:** the ±2 % supply tolerance below is now
> load-bearing and belongs in the spec beside the current rating — that is a spec edit, not a
> schematic one. The `D3` → P-channel MOSFET option was not taken.

`ACSL-6xx0` (AV02-0235EN) Recommended Operating Conditions give **I_FH minimum 7 mA**, with
footnote b adding: *"It is recommended that minimum 8 mA be used for best performance and to
permit guardband for LED degradation."* V_F is 1.25 / 1.52 / **1.80 V** min/typ/max.

The LED anodes are fed from `+5V` through 430 Ω, cathodes sunk by `SN74AHCT541` outputs
(V_OL max 0.44 V at I_OL = 8 mA, SCLS269Q).

**The rail is not 5.00 V at the LED.** It arrives through `F4` and `D3`. Both pinned to
their datasheets:

- `1206L050` (Littelfuse 1206L): **R_min 0.15 Ω** un-tripped, R_1max ~0.6 Ω after a trip. With
  `F4` upgraded per M7, R_min falls to ~0.06 Ω → **0.027 V** at 0.45 A.
- `SS14` (Vishay 88746): V_F max **0.50 V, specified at 1.0 A**. At ~0.45 A, ≈0.35 V typ /
  0.42 V max.

Total series drop **0.38–0.45 V**, so the anode rail is **4.55–4.62 V**.

**15 mA is an absolute maximum, not a recommendation** — AV02-0235EN's Absolute Maximum
Ratings list *Average Forward Input Current (per channel) I_F 15 mA*. Both ends of the window
are hard.

| Series resistor | Worst case | Best case | Verdict |
|---|---|---|---|
| **430 Ω (as built)** | **4.4 mA** | — | Below the 7 mA switching floor |
| 240 Ω | 8.6 mA | **14.9 mA — 99% of absolute maximum** | Ceiling too close |
| 270 Ω | 7.6 mA — misses the 8 mA guardband | 13.2 mA | Safe, no aging margin |
| **249 Ω + ±2% supply** | **8.8 mA** | **13.7 mA** | **Both bounds clear with margin** |

At a ±5% supply the tolerance spread is **1.95:1** against a **2.14:1** window — it fits, but
nothing sits comfortably. The fix is to shrink the spread rather than chase the resistor.

**Fix:** 430 Ω → **249 Ω (E96)**, *and* specify the external +5 V supply at **±2%**. That
tolerance now protects 30 optocoupler channels, making it a load-bearing specification rather
than an assumption — it belongs in the spec beside the current rating. See also M7 (`F4`) and
F7 (the fan tap), both of which affect this rail.

**Also required:** the AHCT541's absolute maximum through its GND pin is **±75 mA**
(SCLS269Q §4.1), and `U8`/`U9`/`U10` each drive **eight** LEDs. Because the drive is
active-low and the event bus idles at `0x0000`, sixteen LEDs are lit **continuously** — a
steady state, not a transient. At 11 mA × 8 that is 88 mA, over the limit.

**Fix:** parallel two buffer outputs per LED, from tied inputs. **This half and the resistor
change must land together** — `test_driver_pin_sink_load` correctly rejects 249 Ω on a single
output (12.65 mA against a 7.5 mA budget). Neither half is shippable alone: the old resistor
starves the LED, the new resistor overloads the driver. Halving the effective
on-resistance also improves V_OL. Per-output current falls to ~5.5 mA against a
recommended 8 mA; package ground current to ~44 mA against 75 mA. Cost: 30 LEDs plus ~12
other outputs needs **9 packages against today's 5**.

**Rejected alternative:** driving the LEDs from +12 V would give a much tighter 1.25:1
tolerance spread, but with the anode at 12 V and the buffer output high at 5 V there is still
7 V across the LED and resistor — about 5.5 mA — so **the LED never turns off**. The anode
rail must sit at or below the driver's high level.

**Optional margin:** replacing `D3` with a P-channel MOSFET (≈20 mV instead of 350 mV) plus
the larger `F4` recovers ~0.45 V, letting 300 Ω give 7.9–12.8 mA. One new part type for real
headroom on both bounds. *Not taken at implementation — 249 Ω clears both bounds without it.*

> **A latent generator bug this finding's implementation surfaced — now FIXED board-wide
> (2026-08-16).** `ref_start` was seeded by reading sibling sheets at generation time, so any
> sibling gaining an out-of-band refdes silently renumbered everything downstream at the next
> regeneration. `taskpc-digital` gained `U69`/`R191`/`C149`–`C150` during the panel-
> instrumentation task, which armed it: running these generators **unmodified** rewrote their
> whole refdes space.
>
> | Generator | What a plain re-run did before the fix |
> |---|---|
> | `gen_breakout_analog_frontend.py` | `U16`–`U30` → `U70`–`U84`; ~130 R/C/D/J refs moved |
> | `gen_breakout_analog_ni.py` | `U31`–`U37` → `U70`–`U76`; ~40 more |
> | `gen_breakout_mux_intan.py` | `U38`–`U53` → `U70`–`U85`; ~50 more |
> | `gen_breakout_comparators.py` | `U54`–`U55` → `U70`–`U71`; ~25 more |
> | `gen_breakout_control_usb_i2c.py` | `U66`–`U68` → `U70`–`U72`; 4 more |
>
> All five are now pinned, as `taskpc-digital`/`pi-interface` already were and as both opto
> generators were during F1. **All ten sheets are pinned; none reads a sibling's refdes any
> more.** Verified the only way that means anything: regenerate *every* sheet, twice, re-export
> the netlist and confirm `netlist-contract.json` is byte-identical each time. It is — the board
> is now idempotent under full regeneration, which it demonstrably was not before.
>
> Do **not** verify this by diffing the `.kicad_sch` files. Several were last written by KiCad
> itself rather than by their generator, so they reformat wholesale even when nothing electrical
> changes; the netlist is the only signal that carries meaning here.

### F2 — The inbound stim channel is under-driven, and depends on an undocumented switch — **IMPLEMENTED 2026-08-16**

> A local `SN74AHCT541PW` (`U75`) on `ISO_5V`, referenced `INTAN_GND`, now drives the LED.
> `RHS_STIM_BNC` → 100 Ω → `RHS_STIM_RAW` (clamped) → buffer → `RHS_STIM_ISO_BUF` → LED
> cathode. The 100 Ω and the `BAT54S` do protection **only**; they are out of the current
> loop. The branch went from **401 Ω / 6.57 mA** to **301 Ω / 8.75–12.92 mA**, identical to
> the spare channel beside it.
>
> **The CONFIG4 dependency is retired, not merely recorded.** An AHCT part's TTL thresholds
> (V_IH 2.0 V) are independent of its own supply, so the buffer reads a 3.3 V *or* a 5.0 V
> input as a valid HIGH — whichever way that switch is set. Its output then drives the LED
> rail-to-rail from `ISO_5V`, so the off-state is a clean 0 V across the LED instead of the
> ~1.3 mA leak against a 250 µA I_FL limit that CONFIG4-down produced. The design also stops
> depending on an output drive capability the Intan guide never specifies. **CONFIG4 UP is
> still worth setting and is recorded in `hardware/README.md` — but it is now a rig-
> configuration note rather than a correctness dependency.**
>
> **Two checkers found this, one of them by being wrong first.** Check 15 (F1's lower bound)
> had been reporting this branch as healthy at 8.75 mA, because it counted only the ANODE
> resistor — it did not know that this one channel had 100 Ω on the cathode side too. That
> is the same class of error as F1 itself: a number that was right about the model and wrong
> about the board. The check now derives the whole loop (a resistor on the cathode net whose
> other terminal is not a rail is in the path), which yields 0 for every ordinary channel and
> 100 Ω here.
>
> Then, once the LED became buffer-driven for the first time, **F1's own checkers failed** —
> a single output driving a 10.5 mA LED against a 7.5 mA budget. So this channel is
> paralleled like every other: two of `U75`'s channels from tied inputs, 5.23 mA per pin.
> Six channels remain spare, which is the isolated domain's first spare logic.

`RHS_STIM_OUT` puts its 100 Ω input resistor **inside** the LED current path:
`ISO_5V` → 430 Ω → LED → 100 Ω → Intan's output.

- Typical: **6.57 mA** — below the 7 mA minimum before any tolerance
- Worst case: **4.8 mA** — will not switch

**The Intan output level is a physical switch.** The Stim/Recording Controller user guide:
*"Switch 4 (CONFIG4) is used to select the voltage level of the digital output ports. With
CONFIG4 in the down position, 3.3 V digital signals are generated. With CONFIG4 in the up
position, 5.0 V digital signals are generated."*

At 3.3 V the LED anode sits at 5 V against a cathode resting at 3.3 V, leaking roughly
**1.3 mA against a 250 µA I_FL limit** — the channel may never turn cleanly off.

**Fix:** buffer Intan's output locally in the `INTAN_GND` domain off `ISO_5V`, and let that
buffer drive the LED. The 100 Ω and `BAT54S` then do protection only instead of sitting in
the current path, the off-state becomes a clean 0 V across the LED, and the design stops
depending on an external switch position or on an output drive capability the Intan guide
never specifies.

**Record regardless:** this rig requires **CONFIG4 UP**. It belongs beside `RewardPolarity`
HIGH as a configuration the design depends on and no checker can see.

### F3 — The photodiode transimpedance stage saturates — **IMPLEMENTED 2026-08-16**

> `R38`/`R40` 1 MΩ → **180 kΩ**, both channels. Peak white now lands near 2.0 V instead of
> demanding 11.3 V — which also puts it inside the DAC's own 0–2.048 V span after D1, so the
> threshold spans the whole signal.
>
> The **DNP parallel trim position** is fitted as specified: `R196`/`R197`, unpopulated, in
> parallel with each feedback resistor. A pad rather than a jumper, for the reason this
> finding gives — a mechanical contact at a 180 kΩ summing junction is a leakage and noise
> liability.
>
> **Checker:** full-scale photocurrent (derived from the FDS100's pinned area and
> responsivity against this design's stated display-irradiance assumption) times the feedback
> resistor, against the ±5 V analog convention. The TIA stages are found *structurally* — an
> R and a C sharing both nodes across an amplifier output is what a feedback network is — so
> a future channel is covered without being listed.

`R38` = 1 MΩ, `C48` = 3.3 pF, `R34` = 1 kΩ in series from the BNC to the summing junction,
`R35` = 10 Ω on the shield leg feeding IN+. Amplifier is `OPA2197` (dual; the second half is
PD2's TIA, so there is no spare channel).

With a Thorlabs **FDS100** (13.0 mm², 0.30 A/W at 550 nm, TO-5, spec sheet 0637-S01) against
a display patch at roughly 0.29 mW/cm², photocurrent is **~11 µA**. Into 1 MΩ that demands
**11 V out** — twice the ±5 V system convention and past both NI's and Intan's input range.

**Fix:** `R38` 1 MΩ → **180 kΩ**, putting peak white near 2.0 V.

**Fit a DNP parallel resistor position** across `R38` so gain can be trimmed at bring-up with
one component. A jumper at a summing junction that sensitive would be a leakage and noise
liability; a parallel pad is not.

### F4 — Four camera triggers share one unterminated buffer output — **IMPLEMENTED 2026-08-16**

> Each of the five camera triggers now has its **own buffer channel and its own 47 Ω**.
> `CAM_TRIG_BEH` split into `CAM_TRIG_BEH1`–`4`; channel 2 of the existing trigger buffer
> keeps trigger 1 and a new package (`U74`) takes the other three. They still share one
> trigger *rate* via `CAM_TRIG_BEH_RAW` — spec §9.4 is unchanged; they no longer share one
> *driver pin*.
>
> **Not on F1's spare channels, which this finding expected.** Those are on
> `taskpc-digital`, and routing an unbuffered 3.3 V trigger across the board and its
> buffered copies back again is the wrong trade for a signal whose entire problem is edge
> quality at the connector. Source GPIO, buffer and BNCs stay on one sheet; cost is one
> package.
>
> **47 Ω errs high deliberately.** An AHCT541's output impedance is ~25–35 Ω, so textbook
> series termination into 50 Ω coax would be nearer 20 Ω. Over-damping costs a little edge
> rate and buys margin against the failure that actually matters — a reflection re-crossing
> a camera's input threshold and triggering a *second frame*. The first step at a
> high-impedance camera input lands at ~77 % of the swing before settling, far above any
> TTL V_IH.

`CAM_TRIG_BEH` drives `J14`–`J17` from a single `SN74AHCT541` output — four parallel coax
runs, about 12.5 Ω of transmission line. The initial edge draws roughly **118 mA** against
the part's **25 mA** per-output absolute maximum. Short, but on every edge for the life of
the board, and with no source termination the cameras see reflections that can double-trigger.

A systematic sweep of every logic output on the board confirms this is the **only** net where
one output drives multiple BNCs. It is a single site, not a pattern.

**Fix:** one buffer channel per trigger, each with a **~47 Ω** series resistor to bring source
impedance near the 50 Ω line. This folds into F1's respreading, which already adds spare
channels.

### F5 — The isolated supply is over its per-rail rating — **IMPLEMENTED 2026-08-16, on a different part**

> **The diagnosis was right and the named part was wrong.** Re-derived from the netlist after
> F1, `ISO_P12` carried **114 % typ / 170 % max** of the `IH1215D`'s 66 mA rating — worse than
> the figures below, because F1 raised the two inbound LEDs from 7.33 mA to ~10.5 mA each. The
> fix shipped, and `ISO_P12` now carries **12–16 mA (18–24 %)**, matching `ISO_N12` exactly.
>
> **`TMA-0505S` was evaluated and rejected.** The handoff required pinning it before this
> recommendation could be final, and pinning it is what killed it: **the TMA series is
> unregulated.** ISO_5V sits at 31–46 % of its rating, and an unregulated module's output rises
> at light load — this very finding records the `IH1215D` doing +10 % at ~20 %. At +10 %,
> ISO_5V reaches **5.50 V, exactly the ACSL-6xx0's VDD absolute maximum with zero headroom**,
> and it would drive F1's freshly-sized 301 Ω resistors to **14.3 mA against a 15 mA absolute
> maximum**. Fixing F5 that way would have broken F1.
>
> **Shipped instead: `TMR 1-0511`** — Traco's regulated 1 W sibling. ±1 % set accuracy, 0.2 %
> line, 0.5 % load, so ISO_5V stays 5.0 V and both problems vanish. Also 1500 VDC isolation
> rather than 1000, no minimum load, 76 % efficient rather than 71 %. Cost: **one new part
> number** — the only one the audit implementation has added. Pin map verified against the
> datasheet's own Pinout table, not taken from the KiCad symbol.
>
> **It is a second on-board switcher, and that is the honest cost.** Spec §8 permitted exactly
> one; it now records two, with the reasoning. Mitigations built in: the rail powers only
> optocoupler output stages, its primary sits on `+5V`/`DGND` rather than the analog
> `+12V`/`AGND`, and its secondary return is a separate net (`ISO_5V_RTN`) joined to
> `INTAN_GND` at a single net tie (`NT4`) — the same idiom `FAN_RTN` uses. That last one was
> forced by ERC (two `power_output` pins on one net) and is the better answer anyway: the
> switching return reaches the Intan reference at a controlled point instead of across a plane.
>
> **Cost side, tracked in the spec:** the ISO_5V branch moved onto `+5V`, which gains 83/120 mA
> of converter input current. `+5V` is now 475/615 mA against `F4`'s ~0.97 A derated hold —
> 1.58×, so M7's fuse still holds it, but §8.2's budget rose 600 → 700 mA.
>
> **A new checker enforces both halves** (with a firing control): each isolated rail's load
> against the 66 mA rating, and the **balance** between the pair — because cross-regulation is
> only characterised with the lighter rail at 25–100 %, so both rails can be individually
> within rating while the pair is outside the conditions its specs were measured under. Where
> the ISO_5V load *lands* is derived, not declared: the check finds what feeds ISO_5V and asks
> which side of the barrier it draws from.

`IH1215D` is **±15 V at ±66 mA**, unregulated, 82% efficient (XP Power IH series datasheet).
`INA105` I_Q is **±1.5 mA typ, ±2 mA max** (SBOS145B).

| `ISO_P12` load | Typ | Max |
|---|---|---|
| 8 × INA105 V+ | 12 mA | 16 mA |
| `LD1117S50` input → `ISO_5V`: 6 opto output stages, 6 × 3.9 kΩ pull-ups, 2 × 430 Ω inbound LEDs | 57.5 mA | 93 mA |
| **Total** | **69.5 mA (105%)** | **109 mA (165%)** |

`ISO_N12` carries only 12–16 mA — about 20%. That imbalance puts the lighter rail **below the
25% floor at which cross-regulation is characterised at all**, so the ±5% figure does not
apply.

The `LD1117S50` also burns **0.37–0.58 W** dropping 12 V to 5 V for a digital load.

**Fix:** replace `LD1117S50` with a **second `TMA-0505S`** — already on the board as `U62`,
the NI-side fallback, so no new part number. It is 1 W / 200 mA, covering the 52–83 mA branch
with 2.4× margin.

| | Now | After |
|---|---|---|
| `ISO_P12` load | 69.5–109 mA (105–165%) | **12–16 mA (18–24%)** |
| `ISO_N12` load | 12–16 mA | 12–16 mA — **balanced** |
| LDO heat | 0.37–0.58 W | eliminated |

This **improves** the noise architecture rather than compromising it: the new converter powers
only optocoupler output stages, while the eight Intan-domain INA105s stay behind the ferrite
pi filter and the two low-noise LDOs. Today those analog parts share `ISO_P12` with a 57 mA
digital branch; afterwards they do not.

At ~20% load an unregulated module's output rises — ±15 V may reach ~±16.5 V. The
`TPS7A4901`/`TPS7A3001` accept 35 V and regulate to ±12 V, so they absorb it.

### F6 — 31 BNCs are on a footprint pointing at the enclosure lid — **IMPLEMENTED 2026-08-16**

> **Implemented. The diagnosis was exactly right and verified number for number; the
> prescription was wrong in two ways, both found by reading the two candidate footprints
> before copying either.**
>
> **The diagnosis checks out.** `BNC_PanelMountable_Vertical`'s pad 2 really is a 15.24 mm
> annular ring on a 9.65 mm drill, with the barrel passing *through* the board. The copper
> arithmetic reproduces: 31 × π(15.24/2)² = **5,654 mm²** of pad against the finding's
> "~5,650", and 31 × π(9.65/2)² = **2,267 mm²** removed against "~2,270".
>
> **Prescription error 1 — the footprint to copy.** The handoff said to use
> `BNC_Win_364A2x95_Horizontal`'s geometry and reject KiCad's own
> `BNC_Amphenol_031-6575_Horizontal` as "self-contradictory... a single body with one bayonet
> circle". The hole *pattern* is identical in both (4 × Ø0.89 + 2 × Ø2.01 at the drawing's own
> 10.16/6.35/5.08/2.54 spacings), but two things differ and the Amphenol footprint has both
> right:
>
> - Its F.Fab body is **14.40 × 36.20 mm**, exactly `bnc_dual_isolated.body_width_mm` /
>   `.body_depth_mm`. The Winchester one draws **15.00 × 39.10 mm** — a different
>   manufacturer's part, and 2.9 mm deeper on a 17-position panel.
> - The Winchester numbers **four pads "3"**, commoning both shells with the ground
>   terminals, because it models a *front*-isolated connector. The 031-6575 is
>   *independently* isolated, and **ten channels on this board route a shield per connector**
>   (`A_PD1_SHLD`, `A_MIC_SHLD`, `A_MISC1_SHLD` …). Copying that numbering would have shorted
>   those shields together in pairs and exported a perfectly clean netlist while doing it.
>
> The "one bayonet circle" reading is a misreading rather than a defect: the ports are stacked
> *vertically* at 16.00 mm, so in a top-down footprint the two barrels project onto the same
> point. It cross-checks — `body_height_mm` 29.25 with `port_pitch_mm` 16.00 leaves 6.625 mm
> from each port centre to the body edge against a 12.83 mm panel hole needing 6.415 mm.
>
> So the footprint was **built from the drawing** (`wl-sync:BNC_Dual_RA_Isolated`): Amphenol
> body and pad topology, with the stock part's one real error fixed — its two ground terminals
> sit at y = −8.89 and −8.79, a 0.1 mm asymmetry.
>
> **Prescription error 2 — the panel could not take two rows.** `audit-handoff.md` §4 has the
> ports stacked into two panel rows. That was true of a panel-mounted part and is not true of
> a PCB-mounted one: two rows of board-mounted right-angle bodies would need two board planes.
> It turns out not to matter, because the dual body *is* two rows — 16.00 mm apart — so one
> row of bodies gives the two port rows the panel arithmetic wanted. Redrawn in
> `panel-elevations.md`, which also records the new coupling this creates: port height above
> the panel centreline is now set by the board's standoff.
>
> **What shipped:** 31 ports on **17** dual bodies (not 16 — see below), 3 spare ports, all
> shells still individually routed. Refdes did not move: the allocator consumes a
> `next_ref("J")` per original port and uses only the first of each pair, so J6/J14/J16/… are
> holes rather than renumberings.
>
> **The 17th body exists because spec §9.6 splits the reward group across both faces** — the
> driver output goes back toward the booth, the human controls face the operator. A dual body
> is one piece of plastic through one panel, so those two ports cannot share one. A pure
> per-sheet pairing would have given 16 bodies and silently overridden that decision.
>
> **Two bugs this change introduced and the toolchain caught, both worth recording** because
> both were invisible to ERC and to all 13 checkers:
>
> - Two units of one component were given **different `Value` strings**, which is an
>   annotation error; the exported value then becomes whichever unit was written last, so the
>   BOM would have described one port and ordered one connector.
> - The spare-port placement **consumed a refdes**, pushing pi-interface's internal USB header
>   from J18 onto J19 — which analog-frontend's DB37 already owned. A duplicate reference
>   across two sheets.
>
> Both surfaced only as `kicad-cli sch export netlist`'s "schematic has annotation errors"
> line on stdout. The netlist still exported, ERC still reported 0 errors, every checker still
> passed. **That warning line is worth treating as a failure.**
>
> New verification: `hardware/gen/check_footprint_geometry.py` reads the real `.kicad_mod`
> files off disk and asserts the F6 axis property over every connector on the board — no
> numbered contact may be drilled over 3.0 mm, which is the executable form of "no connector's
> axis points at the lid" and would have caught this on the day it was introduced.

`BNC_PanelMountable_Vertical` is described in KiCad's library as *"Panel-mountable BNC
connector mounted through PCB, vertical"*, with a **9.65 mm drill and 15.24 mm annular pad**
for the barrel to pass through the board. The connector axis is **perpendicular to the PCB**.

On a 430 × 240 mm board lying flat in a 2U chassis, those BNCs point at the lid, not at the
front and back panels where all 31 are supposed to emerge. The footprint only makes sense if
the panel is parallel to the board.

It also costs roughly **5,650 mm² of pad and 2,270 mm² of removed copper on every layer**,
punched through a mixed-signal board carrying five ground domains.

**Fix:** a right-angle isolated part. See §3 for selection status.

### F7 — The fan fuse is defeated by its own placement — **IMPLEMENTED 2026-08-16**

> **Implemented, but NOT as this finding's own "Fix" line says.** That line is wrong and
> was corrected during implementation.
>
> It says to tap `FAN_12V` from **`P12_FUSED`**, calling that node "upstream of `F2`". It is
> not. The real chain is `J1.1 → P12_RAW → [F2] → P12_FUSED → [D1] → +12V`, so `P12_FUSED`
> is `F2`'s **output**. Tapping there would have left fan current still flowing through
> `F2` — fixing nothing — *and* stripped the fan branch of `D1`'s reverse-polarity
> protection, which is strictly worse than the defect. The handoff's own preferred option
> (tap `P12_RAW`, give the branch its own diode) is correct and is what shipped:
>
> ```
> J1.1 → P12_RAW ─┬─ [F2] → P12_FUSED → [D1]  → +12V        (main)
>                 └─ [F1] → FAN_12V_RAW → [D44] → FAN_12V    (fans)
> ```
>
> Cost: one `SS14` (`D44`), already a qualified part on this board. `F2` now carries
> 97–121 mA instead of 337–361 mA, and a fan fault cannot reach the analog rail at all.
>
> **The lesson is the reason the new checker works the way it does.** Reasoning from net
> *names* is what produced the wrong fix; `tests/hardware/test_netlist.py`'s fuse-
> coordination check derives series-ness from **topology**, by testing whether removing one
> fuse disconnects another from the supply inlet. Plain reachability was tried first and
> called every fuse upstream of every other — the rails are all joined through the ground
> net by any two decoupling capacitors — so the check walks series elements only (both pins
> off ground) and uses the cut test to supply the direction the graph does not carry.

`F1` is fed from `+12V`, downstream of `F2`. Both are `1206L050` — 0.5 A hold, 1.0 A trip —
**in series**. A fan fault drawing 0.9 A is below `F1`'s trip but well over `F2`'s hold, so
**`F2` can trip first and kill the analog rails to protect the fans**, inverting the entire
purpose of giving the fans a separate fuse.

It also means `F2` carries main load **plus** fans: 337–361 mA, not the ~100 mA the main rail
alone draws.

**Fix:** tap `FAN_12V` from **`P12_FUSED`** instead of `+12V` — upstream of `F2`, so the two
fuses become parallel branches. `F2` then carries 97–121 mA (3.7× margin at 0.5 A, unchanged)
and `F1` protects the fans independently. One net change, better than upsizing `F2`.

---

## 2. Marginal, robustness and documentation

### M1 — TIA under-compensated at long cable — **IMPLEMENTED 2026-08-16**

> `C48`/`C50` 3.3 pF → **22 pF**, both channels. Deliberate over-compensation, as specified:
> −3 dB at 40 kHz (four times the ~10 kHz these channels need) and unconditionally stable to
> 5.5 nF of input capacitance, about 50 m of coax.
>
> **Checker asserts both bounds**, the F1 lesson applied here: `C_f ≥ sqrt(C_in/(2π·R_f·GBW))`
> at the worst-case 900 pF *and* the resulting −3 dB above the signal bandwidth. Under- and
> over-compensation each have a firing control. Note the BOM now calls for **C0G/NP0** on
> these two, not X7R — a compensation capacitor whose value moves with bias or temperature is
> not doing the job this finding assigned it.

Thorlabs publishes FDS100 capacitance only at 20 V bias (24 pF); at the **zero bias** this
design is forced into it is far higher — an estimated 130–380 pF. With 3–5 m of coax, total
input capacitance reaches **440–900 pF**. Optimal C_f rises to ~3.8 pF against the fitted
3.3 pF, and `R34` = 1 kΩ adds a pole at ~265 kHz, only 5× above the ~51 kHz loop crossover,
costing a further ~11° of phase margin. Ringing on precisely the edge used to time stimulus
onset.

**Fix:** with `R38` at 180 kΩ (F3), set **C_f = 22 pF**. Deliberate over-compensation:
−3 dB at **40 kHz** — still four times the ~10 kHz these channels need — and unconditionally
stable up to **5.5 nF** of input capacitance, about 50 m of coax. The stage stops depending
on cable length and diode spread.

### M2 — Photodiode mux tap unbalances the difference amplifier — **IMPLEMENTED 2026-08-16**

> The eight muxes' `S7`/`S8` inputs moved from `A_PD1`/`A_PD2` to `A_PD1_NI_BUF`/
> `A_PD2_NI_BUF`. Free, as predicted: a net reassignment, no new parts, 16 pins.
>
> **Checker is stated over every mux input**, not over the two channels known to be wrong —
> the defect is a *tap point*, and a future channel added the same way would be equally wrong.
> It flags any mux input sitting on a passive node behind series resistance rather than on an
> amplifier output.
>
> Worth recording: this change made one of the mux checker's own negative controls pass
> vacuously. It deleted a node from `A_PD1`, which the mux no longer taps, so it stopped
> corrupting anything. It now corrupts `MUX_TAP_NETS[0]` — the net actually wired.

The Intan-side `INA105` has the mux output on IN+ and **AGND on IN−**, so anything in series
with the mux leg unbalances it. `ADG1206` R_on at ±12 V is ~180 Ω (the 120 Ω headline is the
±15 V figure; the +12 V single-supply table gives 300 Ω typ / 475 Ω max).

| Channel group | Gain error | CMRR |
|---|---|---|
| `INA105KU` alone | — | 72 dB min |
| 14 channels (op-amp driven) | 0.36% | ~49 dB |
| **`A_PD1` / `A_PD2`** (1.6 kΩ RC + R_on) | **3.3%** | **~30 dB** |

49 dB is adequate — tens of millivolts of inter-rack ground offset becomes sub-LSB against
Intan's 0.31 mV. The photodiode channels are the outlier because they tap `A_PD1`, the node
*behind* the 1.6 kΩ anti-alias resistor.

**Fix, free:** `U32C` already sits there as a unity-gain follower producing `A_PD1_NI_BUF`.
Retap the eight mux `S7`/`S8` inputs to the buffer outputs. A net reassignment, no new parts.

### M3 — Six panel outputs have no series resistance and no clamp — **IMPLEMENTED 2026-08-16, and there were ELEVEN**

> Series resistance added to all six named here: the five camera triggers (47 Ω, per F4)
> and `J6`, the reward driver out (**100 Ω** — that pin's problem is fault current from an
> inductive kick or a mis-plug, not transmission-line matching, so it takes this board's
> established panel-series value rather than the termination one).
>
> **The count was wrong, and the checker written for this finding is what found it.** This
> finding states that "every Intan output has a series resistor". That is true of the
> *analog* ones — `mux-intan`'s `INTAN_AO1`–`8` each sit behind their own 100 Ω — and **not
> true of the five digital ones**, whose BNCs sat directly on the ACSL-6xx0 output pin.
> Eleven panel outputs were bare, not six. All five now sit behind 100 Ω
> (`R204`–`R208`), which buys mis-plug protection rather than termination: the ACSL output
> is open-collector behind a 3.9 kΩ pull-up, so its rising edge is already heavily
> source-damped, but a fault voltage on the connector previously fed straight into the
> output transistor.
>
> That is the argument for the checker's shape. It is stated over **every** panel output
> rather than over the six nets this finding names — so it caught the five the finding
> missed. **Clamps were not added**; this finding's own fix line asks for series resistance,
> and adding clamp diodes to eleven outputs is a separate decision.

Every input on this board has series resistance plus a `BAT54S`; every Intan output has a
series resistor. `J13`–`J17` (camera triggers) and `J6` (reward driver out) have neither.
`J6` is driven straight from a `SN74HCT32` gate output onto a panel BNC that runs to a
solenoid driver — an inductive kick or a mis-plug feeds directly into the gate.

**Fix:** series resistance on all six, per F4 for the triggers.

### M4 — Comparator outputs rise in 2.2 µs — **IMPLEMENTED 2026-08-16**

> Pull-ups `R113`/`R116`/`R119`/`R121` 10 kΩ → **2.2 kΩ**. ~0.5 µs rise for 1.5 mA.
>
> **The 10 kΩ series resistors that set hysteresis were deliberately NOT changed** — they
> happen to share a value with the pull-ups and do a completely different job (10 k/1010 k ×
> V_OH = the documented 32.7 mV). The checker names them as separate constants precisely so a
> future "these are all 10 k" tidy-up cannot move both. Hysteresis is unaffected: the pull-up
> value does not enter that ratio.
>
> **Checker asserts both bounds again:** rise time under 1 µs into the estimated 100 pF, *and*
> the resulting sink current inside the LM339's own 20 mA output absolute maximum. A pull-up
> small enough to be fast and too small for the comparator to sink fails.

The `LM339` outputs sit behind 10 kΩ pull-ups driving five loads each — GPIO, two AHCT541
inputs, the 1 MΩ feedback, and trace. Into ~100 pF that is a **2.2 µs rise**, from a
comparator whose purpose is precise stimulus-onset timing.

**Fix:** 10 kΩ → **2.2 kΩ**, sharpening to ~0.5 µs for 1.5 mA on a +3V3 rail with headroom.
The LM339 sinks 16 mA, so this is well inside spec.

### M5 — Back-injection when unpowered

The spec's claim that "a mis-plug costs wrong data rather than hardware" holds **powered**:
+5 V carries 290 mA of LED load, comfortably more than a single fault injects. With the board
**off**, a 12 V fault charges the dead rail through the clamp toward **11.6 V**, past the 7 V
absolute maximum of the AHCT541 and the HCT gates.

**Fix:** a 5.6 V zener or 5.0 V TVS on +5 V. One part.

### M6 — Mux supply current unbudgeted

`ADG1206` I_DD is 0.002 µA with digital inputs at 0 V or VDD, but **260 µA typ / 420 µA max
at intermediate levels** — the input stage sits in its linear region and draws shoot-through.
The address lines rest at 3.3 V against a 12 V rail. Across eight muxes that is **~3.4 mA on
+12 V**: affordable, but it belongs in the budget rather than being discovered on a meter.

### M7 — Fuse sizing — **IMPLEMENTED 2026-08-16 (F4); F1 CANNOT be upsized**

> **`F4` → `1206L110-C`.** The open question — *"A 1.1 A PPTC may not exist in 1206"* — is
> answered: it does. `1206L110-C`, 1.10 A hold / 2.20 A trip, same 1206 footprint and the
> same hand-solderable family. So neither escape route this finding worried about is
> needed: **no third package exception, and no splitting `+5 V` into two fused branches.**
>
> Its `R_min` is also 0.040 Ω against `1206L050`'s 0.150 Ω, which *reduces* the series drop
> feeding the optocoupler LEDs from ~0.074 V to ~0.020 V — so this change **improves**
> finding F1's worst-case margin, from 8.61 mA to 8.83 mA.
>
> **`F1` cannot go to the recommended 0.75 A, and this is a parts fact rather than a
> judgement.** In the 1206L series the elevated-voltage variants exist *only* at the two
> lowest hold currents — `1206L035/16` (16 Vdc) and `1206L050/15` (15 Vdc). Every part at
> 0.75 A and above, `1206L075-C` included, is rated **6 Vdc**, which is a `+5 V` rail only.
> **0.50 A is therefore the largest 1206L hold current available to a 12 V rail at all**,
> so `F1`/`F2`/`F3` are already at the series ceiling. `F1` stays at 0.50 A: ~0.44 A derated
> at 35 °C against the fans' 240 mA is 1.83×, inside the 1.5–2× band PPTC guidance
> recommends. Revisit only by leaving the 1206L series, which reopens the package-exception
> question this finding was trying to avoid.
>
> Both facts are pinned in `hardware/datasheet-params.toml` (`[polyfuse_1206l110]`, and a
> new note on `[polyfuse_1206l050]`), read from the Littelfuse 1206L datasheet directly.
>
> **Two checkers now enforce this** (each with a firing control): every fuse's hold current
> **derated to 35 °C** must cover its rail's maximum load — checking against the 23 °C
> headline is checking against a condition the board never operates in, and `F4` passed the
> headline while failing the real one — and every fuse Value must have a pinned datasheet
> section, so an unpriced part fails loudly instead of being skipped.
>
> **Sourcing caveat:** the `1206L110-C` figures come from the 2006 *Electronics Designers
> Guide* revision, the one actually retrievable (Littelfuse's own asset URL returns 403).
> That document also gives `1206L050/15`'s `R_1max` as 0.750 Ω where this file's existing
> entry says 0.6 Ω — a real discrepancy in a value nothing currently depends on. Re-read
> both rows against one revision before fab.

With every fix applied:

| Rail | Load (typ / max) | Fuse | Verdict |
|---|---|---|---|
| +5 V | 392 / 495 mA (762 mA if the NI-fallback TMA is populated) | `F4` 0.5 A (~380 mA derated) | **Trips — needs ≥1.1 A, 1.5 A if both TMAs fit** |
| +12 V | 97 / 121 mA *after F7* | `F2` 0.5 A | 3.7× — unchanged |
| −12 V | 54 / 66 mA | `F3` 0.5 A | 5.8× — unchanged |
| FAN_12V | 240 mA | `F1` 0.5 A | 1.6× derated — **0.75 A recommended** |

The +5 V figure also sets the external supply: **0.5 A minimum, 0.8 A if the NI fallback is
ever populated.**

### D1 — The threshold DAC cannot reach 4.096 V — **RECORDED 2026-08-16 (configuration, not schematic)**

> **No hardware change exists to make.** The `MCP4728`'s reference and gain are set over I²C;
> no pin selects them. So this finding is discharged by recording it where the configuration
> is decided: spec decision 10 now states **internal reference, gain 1**, strikes the "4.096 V
> → 81 % of full-scale motion" figure, and moves its own status from "before fab" to
> "**before first use**" — because nothing about the board can enforce it.
>
> It pairs with F3 as that finding predicted: at 180 kΩ the photodiode's peak white lands near
> 2.0 V, so a 0–2.048 V DAC span covers the whole signal.

`MCP4728` VDD is **+3V3** and its outputs are rail-limited, so the documented **4.096 V
ceiling is unreachable** — the real ceiling is ~3.29 V. Configured for internal reference ×
gain 2 (which is what produces 4.096 V nominal), **the top fifth of the code range is dead** —
a silent nonlinearity.

Raising the DAC to +5 V does not work: its I²C inputs would need 0.7 × VDD = 3.5 V and the bus
runs at 3.3 V.

**Fix:** internal reference, **gain 1** — a clean 0–2.048 V, linear across all 4096 codes at
0.5 mV steps, absolute rather than ratiometric. The accelerometer's 5–30% gate band sits at
0.49–1.68 V, comfortably inside. Strike the "4.096 V → 81% of full-scale motion" figure.

Pairs with F3: at 180 kΩ the photodiode's peak white lands near 2.0 V, so the DAC spans the
entire signal.

### D2 — `INA105KU` CMRR is 72 dB, not 86 dB

86 dB is the **BM** grade. The board uses **KU**: 72 dB min / 90 dB typ (SBOS145B).

### D3 — Panel thickness limits are unconfirmed for the parts actually chosen — **CLOSED 2026-08-16, by decision**

> **Closed without asking anyone, and noticing why is the whole content of the fix.**
>
> This finding, and the vendor questions drafted from it, asked *what panel thickness will
> these connectors accept?* That is backwards. **We are having the panels machined**, so we
> choose the thickness and the connectors only have to accept it. The real question is
> whether a chosen thickness clears every stated limit on the board — and that is answerable
> from `datasheet-params.toml`, which already holds the only such limit: the M12 inlet's
> 3.5 mm (`m12_inlet.panel_thickness_max_mm`).
>
> **Decision: 3.0 mm aluminium**, both faces. See `d3-panel-thickness.md` for the full
> reasoning and the escape hatch.
>
> Finding F6 is what makes the BNCs a non-issue rather than the hard case. Moving them from
> panel-mount to **PCB-mounted right-angle** moves the load path: the connector is anchored by
> its own tails and retention terminals, and the panel becomes clearance and location. The
> 1/2-28 UNEF nut stops carrying anything. If Amphenol's usable thread turns out shorter than
> 3.0 mm, spot-facing those holes locally to 2.0 mm costs nothing and changes no part.
>
> Two of the drafted questions were **already answered** and are recorded here because
> re-asking them was the actual error: the MDR68's 0.5 A contact rating comes from MH drawing
> rev 3.0 itself (the drawing *is* the primary document; the distributors listing 3 A are the
> thing being overruled), and `row_offsets_from_edge_mm` has exactly one physically possible
> reading, since four absolute offsets would put two rows 0.615 mm apart with 0.85 mm holes.
>
> **One genuine unknown survives, and it is not a panel-thickness question**: which contact
> numbers land in which MDR68 tail row. Handled as a documented assumption rather than a
> blocker — `MDR68_TAIL_ORDER` in `gen_wl_sync_footprints.py` names all four candidates, the
> footprint's own `descr` carries a `PIN MAP UNVERIFIED` note, and
> `check_footprint_geometry.py` asserts that note is still there.

**Corrected 2026-08-16.** This finding originally cited **2.00 mm max** from 3M's MDR
drawings (TS-0620-B, TS-0621-C). **The board does not use a 3M connector** — it uses MH
Connectors `3700-0121-01`, whose drawing states no panel thickness at all. The constraint was
recorded from a part that was evaluated and not selected.

What is confirmed:

| Connector | Panel thickness | Source |
|---|---|---|
| M12 inlet (Phoenix 1551833) | **max 3.5 mm** | Installation drawing 00662206 Index 2 |
| MDR68 (MH 3700-0121-01) | **not stated** — panel mounting is #2-56, 2 places | MH drawing rev 3.0 |
| BNC | unknown | pending |

A 2U rack panel is commonly 2–3 mm aluminium, so this still needs settling before machining —
but by asking MH and the BNC vendor, not by assuming 3M's figure applies.

---

## 3. Needs a ruling

### R1 — The M12 inlet has no shield pin — **RULED 2026-08-16**

| Pin | Net |
|---|---|
| 1 | `P12_RAW` |
| 2 | `N12_RAW` |
| 3 | `P5_RAW` |
| 4 | `AGND` |
| 5 | **`AGND`** |

Spec §9.1 specifies "+12 V, −12 V, +5 V, GND, **shield**". Pin 5 is a second ground instead.

**Ruling: keep pin 5 as a second ground; the cable shield bonds through the connector shell
to the panel.** This became available only once the M12 was established as panel-mounted
rather than board-mounted (see below) — the threaded shell contacts the chassis directly, so
shield current terminates on chassis earth and never enters signal ground, while pin 5 keeps
halving the supply return resistance. The spec's five-conductor intent is satisfied; the fifth
conductor is simply the shell rather than a pin.

> **Verified 2026-08-16 — the condition holds.** The Phoenix datasheet's Material table gives
> *"Material, knurls: Zinc die-cast, nickel-plated"*. The thread is metal, so the shell bonds
> to the panel and the ruling stands with no further check.

**Gender, resolved:** the board is the device and should carry pins so the live cable end has
no exposed metal. Phoenix `1551833` is a **Pin (male)** type, which is correct. The originally
specified part and the Binder candidate were both female.

**Mounting, resolved:** the pins emerge axially, the part is rated by wire gauge (AWG 22-20),
and tightening torque is 1.5–2 N·m. It is a panel-mount connector with flying leads, **not a
board-mount part**. The board needs a 5-way header, and the custom `M12A_5_Panel` footprint
can be deleted — one of three custom footprints retired.

**New finding this exposed:** as built, the M12 is a board-mounted part, so every cable
insertion and every 2 N·m tightening loads PCB pads directly. That is a mechanical defect
independent of the footprint's dimensions.

### R2 — `J19` DB37 shell floats — **RULED 2026-08-16**

The ACCES I/O eye-tracker connector's shell pad carries no net, while every BNC shell on this
board lands deliberately.

**Ruling: fit a selectable resistor position between the shell and `AGND` — 0 Ω / 10 Ω / DNP,
populated at bring-up.** This matches the design's existing philosophy rather than inventing a
new one: rig inputs are received differentially precisely so bonding decisions can be deferred
or reversed without touching the board. The eye-tracker cable runs to a separate
mains-powered PC, which is a materially different situation from the battery-powered booth
sensors, so committing that bond in copper now would be guessing. One pad, one resistor.

### R3 — LDO thermal pads carry no net — **RULED 2026-08-16**

`U3` and `U4` pad 9 (the PowerPAD) has no net. Both datasheets permit "left open", but both
also say *"Solder to the PCB plane to enhance thermal performance"* and explicitly allow
tying to GND.

**Ruling: add pin 9 to both hand-built symbols and tie it to `INTAN_GND`.** The datasheet-
preferred option. It removes the layout ambiguity of a large unnetted pad beneath a 0.65 mm-
pitch part, gives both regulators a thermal path, and prevents an accidental connection to
whatever plane passes underneath. Dissipation is modest (~0.16 W and ~0.07 W), so this is
about determinism rather than heat.

## 4. Verified correct

Recorded because a clean result is evidence too.

- **All five hand-built symbols** against primary datasheets: `TPS7A4901` and `TPS7A3001`
  (SBVS121E / SBVS125D — TI genuinely uses an identical DGN pinout for the complementary
  pair), `ACSL-6400` and `ACSL-6420` (AV02-0235EN Figures 10 and 12, pin for pin),
  `ADG1206YRUZ`.
- **LED drive polarity on all 32 channel positions** — active-low drive correctly cancels the
  optocoupler's inverting truth table. Polarity is right board-wide.
- **Sync-module 40-pin header map**, pin for pin.
- **Board-wide footprint pad coverage** — every footprint resolved on disk; only three pads
  carry no net (R2, R3 above).
- **Comparator topology**: signal on IN+, DAC threshold on IN−, V+ on +12 V, V− on `AGND`,
  hysteresis **32.7 mV** with the documented 1% gain error, both pull-ups on `+3V3`.
- **Mux digital interface**: `ADG1206` inputs are TTL (V_INH 2.0 V, V_INL 0.8 V) independent
  of the supply rails, so 3.3 V address lines correctly drive a part on ±12 V; `EN` tied to
  +12 V is within spec.
- **Microphone filter**: 4th-order Butterworth at 12.0 kHz — measured Q of 0.548 and 1.306
  against the ideal 0.5412 and 1.3065, **within 1.2%**. `U23D`, the unused channel, correctly
  wired as a grounded unity follower.
- **Level shifters**: `SN74LVC541A` on +3V3 with both OE tied low, 5 V-tolerant inputs
  receiving 5 V logic.
- **`INA105` supply and swing**: ±12 V inside the recommended ±5 to ±18 V range; output swing
  ~±9 V typ / ±7 V worst case against a ±5 V convention; NC pin correctly floating; load
  capacitance stability 1000 pF with the 100 Ω series resistors correctly isolating the coax.
- **I²C addressing**: `U67` strapped 000 → 0x20, `U68` 001 → 0x21, matching their labels and
  distinct from the MCP4728's factory 0x60; `/RESET` released on both; 2.2 kΩ pull-ups giving
  1.5 mA sink. Run the bus at **100 kHz** — into ~150 pF the ~280 ns rise is fine against the
  1 µs limit but marginal against 400 kHz's 300 ns.
- **Reverse-polarity diodes**: all three `SS14` correctly oriented, including `D2` conducting
  supply-ward on the negative rail.
- **Clamp coverage**: 19 digital clamps to DGND/+5V behind 100 Ω (survives a ±24 V mis-plug),
  16 analog to ±12 V behind 1 kΩ (survives ±48 V), one to `INTAN_GND`/`ISO_5V`. `FAN_RTN`
  star-joins through `NT2`.
- **Fan-out**: `CAM_TRIG_BEH` is the only net where one logic output drives multiple BNCs.
- **Thermal**: 19.4 W total giving **under 3 °C rise at 12 CFM**, vindicating the low-speed
  fan decision. LED resistors at 32% of an 0603's rating; ACSL input dissipation 15 mW of
  27 mW per channel, output 29 mW of 65 mW.
- **Lifecycle**: `ACSL-6400-00TE` Active and stocked; `INA105KU` Active, datasheet revised
  December 2025; `IH1215D` and `TMA-0505S` stocked with no obsolescence signal; `ADG1206YRUZ`
  Active with `ADG5206` as a pin-compatible successor.

---

## 5. Checkers this audit implies

Every finding above was invisible to twelve structural checkers because they ask topological
questions. These are the parametric assertions that would have caught them.

| Assertion | Catches | Status |
|---|---|---|
| Every LED branch current computed from rail, V_F max, driver V_OL **and the series drops in front of the rail**, compared against the part's I_FH min | F1, F2 | **Implemented** — `test_led_current_clears_switching_floor` / `..._under_absolute_maximum`, both bounds, rail-aware |
| Package pin current summed across all channels against the driver's GND absolute maximum | F1 | **Implemented** — `test_package_ground_current`, with `test_led_drivers_are_paralleled` and `test_paralleled_outputs_have_tied_inputs` |
| Every amplifier's output demand at full-scale input against its supply rails and the system convention | F3 | Not yet |
| Count of panel connectors per driver output, and presence of series termination | F4, M3 | **Implemented** — `test_panel_outputs_have_one_driver_and_series_r`; counts PORTS not bodies as of F6 |
| Every isolated supply's total load against its per-rail rating, with load balance | F5 | **Implemented** — `test_isolated_supply_loading` |
| Footprint axis orientation against the face each connector is assigned to | F6 | **Implemented** — `check_footprint_geometry.py`, as a drill limit: no numbered contact on any connector may exceed 3.0 mm, which is the signature of a barrel passing *through* the board |
| Series fuse coordination: upstream hold current above downstream trip current | F7 | **Implemented** — `test_series_fuse_coordination`, derived from topology via a cut test |
| DAC output range against its own supply rail, not just its reference setting | D1 | Not applicable — D1 has no schematic component; it is I²C state, recorded as spec decision 10 |
| Pull-up RC against the timing requirement of the signal it carries | M4 | **Implemented** — `test_comparator_pullup_rise_time` |

The pattern is that each reads a **value** and compares it to a **datasheet limit**, rather
than reading a net and comparing it to an expected name.

---

## 6. Sources

All primary, all retrieved during the audit.

| Part | Document |
|---|---|
| `ACSL-6xx0` | Broadcom AV02-0235EN |
| `SN74AHCT541` | TI SCLS269Q |
| `SN74AC541` | TI SCAS958 |
| `TPS7A4901` | TI SBVS121E |
| `TPS7A3001` | TI SBVS125D |
| `INA105` | TI SBOS145B |
| `ADG1206` | Analog Devices ADG1206/ADG1207 |
| `IH1215D` | XP Power IH series |
| FDS100 | Thorlabs 0637-S01 Rev E |
| Intan RHS | Intan Stimulation/Recording Controller User Guide |
| MDR68 | **MH Connectors 3700-0121-01 rev 3.0** (2015-03-27) — the part actually used. The 3M TS-0620-B / TS-0621-C drawings this table used to cite belong to a part that was evaluated and NOT selected; that confusion is what produced finding D3's original 2.00 mm panel-thickness figure |
| BNC | **Amphenol RF customer outline drawing 31-6575 rev A** (2013-04-18) — the dual right-angle isolated part finding F6 selected. The Bomar/Winchester spec this table used to cite describes the family convention, not this part |
| M12 inlet | Phoenix Contact 1551833 datasheet + installation drawing 00662206 Index 2 |
