jakewesterberg/wl-sync/hardware/breakout/audit-handoff.md

# Handoff — implementing the parametric audit

Written 2026-08-16 at the end of the audit session, for whoever implements the findings.

**Read first:** `parametric-audit.md` (20 findings, reasoning, numbers) and
`../datasheet-params.toml` (19 parts, 18 pinned to primary documents). Those are complete.
This file records only what was NOT written down there — decisions in progress, traps found,
and the implementation order.

---

## 1. A workflow trap that will bite you

**The checkers and the contract generator read `hardware/breakout/breakout.net`, which is
gitignored and easily stale.**

During this session they ran against a nine-hour-old netlist, reported confident results
about a schematic that no longer existed, and gave *both* false passes and false failures.
The regenerated sheets were correct; the tools were looking at the wrong file.

Always, after editing a generator:

```bash
export PATH="/Applications/KiCad/KiCad.app/Contents/MacOS:$PATH"
python3 hardware/gen/gen_breakout_<sheet>.py
kicad-cli sch export netlist --format kicadsexpr \
    -o hardware/breakout/breakout.net hardware/breakout/breakout.kicad_sch
python3 hardware/gen/gen_breakout_netlist_contract.py
for c in hardware/gen/check_*.py; do python3 "$c" >/dev/null || echo "FAIL $c"; done
python3 -m pytest tests/ -q
```

Note the checkers *default* to `/tmp/breakout.net` while the contract generator defaults to
`hardware/breakout/breakout.net`. **Two different paths.** Export to both, or pass the path
explicitly. This is worth fixing properly — a single source of truth with a freshness guard
would remove a whole class of wasted debugging.

## 2. F1 must land as one change — this was tried and reverted — **DONE 2026-08-16**

> **Implemented, both halves together.** See `parametric-audit.md`'s own F1 entry for what
> shipped and how it was verified. Three things this section predicted turned out slightly
> differently, recorded because the differences are the useful part:
>
> - **The `"expected '430'"` self-test trap is real and it fired**, exactly as warned — on
>   `check_taskpc_digital_netlist.py` rather than only on the opto checkers. Its node-count
>   control asserted on `"expected exactly 4 nodes"`, and F1 moves that count to 5. It is now
>   pinned to the invariant part of the message (`"nodes (series R, clamp diode"`) rather than
>   to the number, so the next count change does not re-break it.
> - **9 packages was right, for different arithmetic.** "30 LEDs plus ~12 other outputs"
>   over-counts: 2 of the 30 are not buffer-driven (an ACSL-6420 drives one; one is an
>   unpopulated spare) and there are 8, not ~12, other outputs. But F1 also *adds* a 29th
>   buffer-driven LED, because `RHS_STIM_OUT`'s LED has to move onto a buffered leg once the
>   resistor changes. 29 × 2 + 8 = 66 channels = 9 packages, 6 spare.
> - **The refdes hazard was worse than "check `build()`'s baseline comment".** It was not
>   latent: regenerating either opto sheet — which F1 *requires* — renumbered its entire
>   refdes space before any F1 edit was made. Both were pinned then; the remaining five
>   generators were pinned immediately afterwards, so **all ten sheets are now pinned and none
>   reads a sibling's refdes.** The board is idempotent under full regeneration — verified by
>   regenerating every sheet twice and confirming the netlist contract is byte-identical. See
>   the table in `parametric-audit.md`'s F1 entry for what each generator used to do.
>
>   This also retires most of §1's warning above: the stale-`.net` trap is still real, but the
>   far nastier version — where regenerating a sheet to *fix* the stale netlist was itself
>   destructive — is gone.
>
> The rest of this section is left as written, as the record of what was known going in.

The resistor half alone was implemented, verified (12/12 checkers passed, correct values in
both sheets) and then **reverted**, because `test_driver_pin_sink_load` correctly rejected it:
12.65 mA against a 7.5 mA per-output budget.

Neither half is shippable alone. 430 Ω starves the LED below its switching threshold; 249 Ω
overloads the driver. Both halves together:

**(a) Two resistor values, not one.** `+5V` reaches the LED through `F4` and `D3` (~0.42 V of
drop); `ISO_5V` is regulated locally with nothing in series. A single value on both would push
the ISO_5V channels to 15.1 mA, past the absolute maximum.

| Rail | Rs | worst / typ / best |
|---|---|---|
| `+5V` (30 LEDs) | **249 Ω** | 9.0 / 11.3 / 13.4 mA |
| `ISO_5V` (2 LEDs) | **301 Ω** | 8.8 / 10.7 / 12.5 mA |

Assumes the external +5 V supply specified at **±2%** — that tolerance is now load-bearing and
belongs in the spec beside the current rating.

In `gen_breakout_opto_intan.py`, `opto_channel()` already receives `led_hi` as a parameter, so
selection is `LED_R_OHMS_ISO if led_hi == "ISO_5V" else LED_R_OHMS_MAIN`. The matching checker
needs the same rail-aware expectation, and its **self-test negative controls** assert on the
complaint text (`"expected '430'"`) so they must be updated too, or they fail as
"wrong complaint".

**(b) Parallel two buffer outputs per LED.** Drops per-output current to ~6.3 mA and package
ground current to ~44 mA against a 75 mA absolute maximum. Needs **9 `SN74AHCT541` packages
against today's 5**. The driving buffers live on `taskpc-digital.kicad_sch` (`U8`–`U11`) and
`pi-interface.kicad_sch` (`U15`) — this is a cross-sheet change.

> **Refdes hazard.** This project has a known stale-`ref_start` bug: an out-of-band edit on one
> sheet silently renumbers refdes on others at the next regeneration. It was found and pinned
> during the panel-instrumentation task. Allocating four new packages must not disturb existing
> references — check `build()`'s own baseline comment in each generator before minting refs.

## 3. The fuse architecture — decided in principle, not implemented — **DONE 2026-08-16**

> **Implemented, and the section below called it right on both counts.**
>
> - **The preferred option was the correct one.** Tapping the fan branch from `P12_RAW` with
>   its own `SS14` (`D44`) is what shipped. Recording clearly, because it matters for anyone
>   reading the two documents side by side: **`parametric-audit.md`'s own F7 "Fix" line is
>   wrong** — it names `P12_FUSED` and calls it "upstream of `F2`", but `P12_FUSED` is `F2`'s
>   *output*. Following it would have left fan current in `F2` while stripping the fan branch
>   of reverse-polarity protection. This section's version is the one to trust.
> - **The `F4` question resolved the easy way.** A 1.1 A PPTC *does* exist in 1206 —
>   `1206L110-C` — so neither feared outcome materialised: no third package exception, no
>   splitting `+5 V` into two fused branches. Its lower `R_min` also improves finding F1's LED
>   margin as a side effect.
>
> **One thing this section did not anticipate, and it closes an option it left open.** The
> 1206L series only offers elevated voltage ratings (15/16 V) on its two lowest hold currents;
> everything at 0.75 A and above is 6 Vdc, i.e. `+5 V` only. So **`F1` cannot be taken to the
> recommended 0.75 A** — 0.50 A is the largest 1206L hold current available to a 12 V rail at
> all. It stays at 0.50 A (1.83× derated margin on the fans' 240 mA), and raising it means
> leaving the series, which reopens the package-exception question. `F2`/`F3` are at the same
> ceiling, which is worth knowing before anyone plans to upsize them either.
>
> The rest of this section is left as written, as the record of what was known going in.

Finding F7 says `F1` (fan) sits downstream of `F2` (main +12 V) at **identical ratings**
(0.5 A hold / 1.0 A trip), so there is no selective coordination — a fan fault at 0.9 A is
below `F1`'s trip but over `F2`'s hold, and `F2` can trip first, killing the analog rails to
protect the fans.

Two options were worked through:

- **Preferred: give the fan branch its own reverse-polarity diode and tap it from `P12_RAW`.**
  Then `F1` and `F2` are genuinely parallel branches. `F2` carries only 97–121 mA (3.7× margin
  at 0.5 A, unchanged) and a fan fault cannot reach the analog rail at all. Costs one `SS14`.
- Alternative: keep the tap at `+12V` and upsize `F2` to 1.5 A so its trip sits above `F1`'s.
  No new part, but it loosens protection on the main rail to 1.5 A hold against a 100 mA load.

**Not yet resolved:** `F4` (+5 V) must rise from 0.5 A — the rail carries 392–495 mA and the
part holds ~380 mA derated. **A 1.1 A PPTC may not exist in 1206.** If it doesn't, the options
are a larger package (which would be this board's *third* hand-solderability exception, and the
project's global constraint permits exactly two) or **splitting +5 V into two fused branches**
using the already-qualified `1206L050/15YR` — one for the ~340 mA LED supply, one for the
~155 mA logic/regulator branch. The split also buys fault isolation between them. Check
Littelfuse's 1206L range before deciding.

Note the existing generator comment at `gen_breakout_power.py` already flagged that fan current
passes through `F2` and that ±12 V was never independently totalled. It worried about *margin*;
the coordination problem is the part it missed.

## 4. Panel layout — numbers ready, drawings not redrawn

Amphenol `031-6575` ports are **16.00 mm apart, stacked vertically**, so two rows of duals fit
a 2U face (58 mm of 82 mm usable). That halves the horizontal span versus one row:

| Face | Content | Width |
|---|---|---|
| Front | 4×2 duals = 80 mm · 2× MDR68 at 63.86 mm = 128 mm · 2× 60 mm fans ≈ 130 mm · button ≈ 20 mm | **≈ 358 mm** |
| Back | 4×2 duals = 80 mm · 2× MDR68 = 128 mm · M12 ≈ 20 mm · CM5 cutouts ≈ 45 mm | **≈ 273 mm** |

Against ~450 mm usable between rack ears, both have real margin. At 16 mm centres adjacent
mating plugs nearly touch — normal for stacked duals, but plugs mate one at a time.

**Footprint warning:** KiCad's `BNC_Amphenol_031-6575_Horizontal` is **self-contradictory** —
described as dual, it draws a single body with one bayonet circle and four clustered pads. Do
not use it. Use `BNC_Win_364A2x95_Horizontal`'s geometry, which matches the Amphenol drawing's
actual pattern (4 × Ø0.89 signal, 2 × Ø2.01 ground) and the Winchester family convention.

## 5. Implementation order, and why

Dependencies are real here — doing these out of order means redoing arithmetic.

1. ~~**Power chain** — fuse architecture and the fan tap. Everything downstream depends on the
   rail drop.~~ **DONE 2026-08-16** — F7 (fan tap from `P12_RAW` + `D44`) and M7 (`F4` →
   `1206L110-C`). The parenthetical was right: F1 landed first and the fuse change moved its
   worst-case LED current by +0.22 mA, in the helpful direction.
2. ~~**F1 as one change** — two resistor values plus output paralleling across 9 packages.
   Largest single change in the audit.~~ **DONE 2026-08-16** — see §2 above. Note it landed
   *before* step 1 rather than after, which the parenthetical below already allowed for; the
   fuse choice moves LED current by ~0.2 mA and 249 Ω clears both bounds either way.
3. ~~**Isolated domain** — `LD1117S50` → second `TMA-0505S` (F5). Pin `tma_0505s` in
   `datasheet-params.toml` first; it is the one entry still outstanding.~~ **DONE
   2026-08-16 — and the instruction to pin the part first is what saved it.** Pinning
   `tma_0505s` revealed the TMA series is **unregulated**, which would have driven ISO_5V to
   the ACSL's 5.5 V VDD absolute maximum and broken F1's freshly-sized 301 Ω resistors. The
   fix shipped on a **`TMR 1-0511`** (regulated, 1500 VDC, no minimum load) instead — one new
   part number. See `parametric-audit.md`'s F5 entry. This step is the clearest vindication of
   the "pin it before you trust it" rule in this file.
4. ~~**Analog corrections** — TIA `R38` 1 MΩ → 180 kΩ and `C48` 3.3 pF → 22 pF (F3, M1), mux
   retap to `A_PD1_NI_BUF`/`A_PD2_NI_BUF` (M2, free), DAC to internal reference gain 1 (D1),
   comparator pull-ups 10 kΩ → 2.2 kΩ (M4).~~ **DONE 2026-08-16.** All five, both photodiode
   channels each. D1 turned out to have no schematic component at all — the `MCP4728`'s
   reference and gain are I²C state — so it is recorded in spec decision 10 as a
   before-first-use configuration instead. This step depended on the `ref_start` pinning
   above: it touches `analog-frontend`, `mux-intan` and `comparators`, three of the five
   generators that were still armed.
5. **Connectors** — rebuild the MDR68 footprint from the MH drawing (current one has a 0.5 mm
   drill against a required 0.85 mm), delete `M12A_5_Panel` and replace with a 5-way header,
   build the BNC footprint, redraw the panel elevations. **This is all that remains, and it
   has its own handoff: `connector-handoff.md`.**
6. **Parametric checkers** — every limit they need is already in `datasheet-params.toml`.

## 5a. Findings implemented outside the numbered order

F4, M3 and F2 were taken after step 4 rather than waiting for step 5 — all electrical, and
each adjacent to work already done. Done 2026-08-16. **Every electrical finding in the audit
is now closed; only the connector/footprint work (step 5) and its checkers remain.**

**F2's fix retires the CONFIG4 dependency rather than recording it.** This document and the
finding both said to record "CONFIG4 UP" as a configuration the design depends on and no
checker can see. It turned out not to be necessary: buffering the Intan output with an
AHCT-family part gives TTL thresholds independent of its own supply, so the board reads
either output level correctly. CONFIG4 UP is still worth setting and is noted in
`hardware/README.md`, but as a rig-configuration preference, not a correctness dependency.
Worth remembering when a finding says "record this and move on" — sometimes the fix that
was already being made removes the need.

**M3's count was wrong and its own new checker found that.** It names six bare panel
outputs; there were eleven. The five digital Intan output BNCs sat directly on the
ACSL-6xx0 output pins — the finding's claim that "every Intan output has a series resistor"
is true of the analog outputs and not of the digital ones. The checker is stated over every
panel output rather than the six named nets, which is the only reason the gap surfaced.

Worth carrying forward: **that is now four times a negative control has gone vacuous** when
the thing it corrupted moved. This round it was two more — the pi-interface trigger-swap
control (the buffer outputs moved to `_BUF` nets, so there was no `tri_state` pin left to
find) and the opto-intan shell control (the connector moved behind a series resistor). When
a fix relocates a net, grep the self-tests for its name before assuming they still bite.

## 6. The one-line lesson

`test_driver_pin_sink_load` already checked that LED current does not **exceed** what the
driver can sink. Nobody checked that it **reaches** what the optocoupler needs to switch. Half
a two-sided constraint was tested, and the untested half was wrong on 30 channels for
seventy-three commits.

When writing the checkers in step 6, write both bounds.

> **Done for F1's own family of checks (2026-08-16), in `tests/hardware/test_netlist.py`.**
> Five new assertions, each with a negative control: worst-case LED current clears the 8 mA
> guardbanded floor; best-case stays under the 15 mA absolute maximum; per-pin sink divides
> across paralleled drivers; per-**package** ground current against ±75 mA; paralleled outputs
> have tied inputs. They read limits from `hardware/datasheet-params.toml` rather than
> re-typing them, so a datasheet revision propagates.
>
> Two things worth carrying into the remaining checkers. **The lower-bound check needs the
> series drops in front of the rail**, or it is just as wrong as the sizing that caused F1 —
> `+5V` at 249 Ω passes a naive 5.00 V model by a wide margin and only becomes tight once
> `F4` and `D3` are in it. And **a control that asserts on a complaint's message text will
> rot**; assert on the invariant part of the message, not on a number the finding is about to
> change.
