jakewesterberg/wl-sync/docs/superpowers/plans/2026-08-13-sync-box.md

# wl-sync — Sync Box: Implementation Plan

> **For agentic workers:** REQUIRED SUB-SKILL: Use superpowers:subagent-driven-development (recommended) or superpowers:executing-plans to implement this plan task-by-task. Steps use checkbox (`- [ ]`) syntax for tracking.

**Goal:** A standalone package producing the master timebase for every recording rig — barcode generation, event-strobe capture, and the on-disk log that everything downstream aligns to.

**Architecture:** The codec, log format and session identity are **pure Python with no hardware dependency**, so they run in CI on any machine. Hardware is reached only through the `SyncBackend` protocol, which has an in-memory fake for tests and an RP1 backend for the Pi 5. `wl-preproc` installs this package to decode barcodes and read logs — the dependency runs one way only, because the sync box owns everything it produces.

**Tech Stack:** Python 3.11, Pydantic v2, pytest, Raspberry Pi 5 + RP1 PIO via `piolib`

**Spec:** [`../../../../wl-preproc/docs/superpowers/specs/2026-08-12-wl-preproc-design.md`](../../../../wl-preproc/docs/superpowers/specs/2026-08-12-wl-preproc-design.md) §4.1, §4.3, §4.5

## Global Constraints

- **Python 3.11.** Matches the wl-preproc environment, pinned by the Kilosort4/PyTorch requirement for Pascal (`sm_61`, CUDA 12.x).
- **Raspberry Pi 5 running Raspberry Pi OS.** GPIO lives on the RP1 southbridge, so `pigpio` and `RPi.GPIO` do not work and must not be reintroduced — both mmap Broadcom SoC registers that Pi 5 does not expose. **The distribution is part of the constraint, not a preference:** mainline RP1 support is landing incrementally and PIO is the piece this design depends on entirely, so the vendor kernel is what carries it first. This says nothing about the rest of the lab — wl-preproc's server runs Fedora.
- **Three mechanisms, one per function**, because only one of the three has a hard timing requirement:

  | Function | Mechanism | Requirement |
  |---|---|---|
  | Event strobe capture | **RP1 PIO** | ~100 µs or better — this is the only hard one |
  | ~~Camera trigger~~ **Camera frame time IN** | Ordinary GPIO edge capture (GPIO26/27) | Falling edge only — see `hardware/breakout/frame-time-inputs.md` §6 |
  | Barcode output | Ordinary GPIO, software-timed | Loose: 5 ms bit slots, and receivers time their own edges |

- **`piolib` is an optional extra.** The core package must import and test with no Pi libraries present.
- **PIO parallel capture reads a contiguous pin range.** The 16 data lines plus strobe must be contiguous on the header. This constrains the breakout PCB and is not negotiable in firmware.
- **Barcode:** 32-bit monotonic counter, 5 ms bit slot, 10 ms wrapper pulse, 200 ms frame, 1 Hz interval.
- **The counter is never reset**, across sessions or reboots, so every barcode the lab emits is globally unique.
- **Pi GPIO is 3.3 V and not 5 V tolerant.** Level shifting is a hardware requirement (spec §4.3); no software here can detect its absence.

---

## File Structure

| File | Responsibility |
|---|---|
| `pyproject.toml` | Package metadata, optional `pi` extra |
| `wl_sync/session.py` | `SessionId` — minted by the Pi, consumed by everything |
| `wl_sync/barcode.py` | Barcode encode/decode, pure |
| `wl_sync/log.py` | On-disk log: edges, strobed code words, tick unwrapping |
| `wl_sync/backend.py` | `SyncBackend` protocol and `FakeBackend` |
| `wl_sync/service.py` | `BarcodeGenerator`, `Recorder` |
| `wl_sync/rp1/pio_capture.py` | FIFO word → log record decoding (pure) |
| `wl_sync/rp1/backend.py` | RP1 backend — hardware-gated |
| `pio/strobe_capture.pio` | The PIO program |

---

### Task 1: Scaffold and session identity

**Files:**
- Create: `pyproject.toml`, `wl_sync/__init__.py`, `wl_sync/session.py`
- Test: `tests/test_session.py`

**Interfaces:**
- Consumes: nothing
- Produces: `SessionId` (frozen dataclass, `date: datetime.date`, `index: int`), `.parse(str)`, `.__str__()`

- [ ] **Step 1: Write the failing test**

```python
# tests/test_session.py
import datetime

import pytest

from wl_sync.session import SessionId

def test_round_trip():
    sid = SessionId.parse("2027-03-14_01")
    assert sid.date == datetime.date(2027, 3, 14)
    assert sid.index == 1
    assert str(sid) == "2027-03-14_01"

def test_index_is_zero_padded():
    assert str(SessionId(datetime.date(2027, 3, 14), 1)) == "2027-03-14_01"

@pytest.mark.parametrize(
    "bad",
    ["2027-03-14", "2027-03-14_1", "27-03-14_01", "2027-13-01_01", "2027-03-14_01_x", ""],
)
def test_rejects_malformed(bad):
    with pytest.raises(ValueError):
        SessionId.parse(bad)
```

- [ ] **Step 2: Run test to verify it fails**

Run: `pytest tests/test_session.py -v`
Expected: FAIL — `ModuleNotFoundError: No module named 'wl_sync'`

- [ ] **Step 3: Write the scaffold and implementation**

```toml
# pyproject.toml
[project]
name = "wl-sync"
version = "0.1.0"
description = "Sync box: master timebase for recording rigs"
requires-python = ">=3.11,<3.12"
dependencies = ["pydantic>=2.6"]

[project.optional-dependencies]
pi = []          # piolib binding, added in Task 5
dev = ["pytest>=8.0"]

[build-system]
requires = ["setuptools>=68"]
build-backend = "setuptools.build_meta"

[tool.pytest.ini_options]
testpaths = ["tests"]
```

```python
# wl_sync/__init__.py
__all__: list[str] = []
```

```python
# wl_sync/session.py
"""Session identity, minted by the sync box at session start.

The sync box owns this format because it is the thing that creates it.
Everything downstream — the rig directory layout, the ELN, wl-preproc — consumes it.
"""

from __future__ import annotations

import datetime
import re
from dataclasses import dataclass

_SESSION_ID_RE = re.compile(r"^(\d{4})-(\d{2})-(\d{2})_(\d{2})$")

@dataclass(frozen=True, slots=True)
class SessionId:
    date: datetime.date
    index: int

    @classmethod
    def parse(cls, text: str) -> SessionId:
        match = _SESSION_ID_RE.match(text)
        if match is None:
            raise ValueError(f"malformed session id: {text!r}, expected YYYY-MM-DD_NN")
        year, month, day, index = (int(group) for group in match.groups())
        return cls(datetime.date(year, month, day), index)

    def __str__(self) -> str:
        return f"{self.date.isoformat()}_{self.index:02d}"
```

`datetime.date` rejects month 13, so `"2027-13-01_01"` raises from the constructor rather than the regex.

- [ ] **Step 4: Run test to verify it passes**

Run: `pip install -e ".[dev]" && pytest tests/test_session.py -v`
Expected: PASS, 8 passed

- [ ] **Step 5: Commit**

```bash
git add pyproject.toml wl_sync tests
git commit -m "feat: session identity, minted by the sync box"
```

---

### Task 2: Barcode codec

**Files:**
- Create: `wl_sync/barcode.py`
- Test: `tests/test_barcode.py`

**Interfaces:**
- Consumes: nothing
- Produces: `BIT_SLOT_US = 5_000`, `WRAPPER_US = 10_000`, `N_BITS = 32`, `FRAME_US = 200_000`, `INTERVAL_US = 1_000_000`, `IDLE_MIN_US = 400_000`; `Barcode(value, start_us)`; `encode(value) -> list[tuple[int, int]]`; `decode_edges(edges: Sequence[tuple[int, int]]) -> list[Barcode]`; `edges_from_samples(trace, fs_hz, t0_us=0)`

- [ ] **Step 1: Write the failing test**

```python
# tests/test_barcode.py
import pytest

from wl_sync.barcode import (
    FRAME_US,
    IDLE_MIN_US,
    INTERVAL_US,
    Barcode,
    decode_edges,
    edges_from_samples,
    encode,
)

def pulses_to_edges(pulses, start_us):
    edges = []
    tick = start_us
    for level, duration in pulses:
        edges.append((tick, level))
        tick += duration
    edges.append((tick, 0))
    return edges

def emit(values, first_start_us=0):
    edges = []
    for index, value in enumerate(values):
        edges.extend(pulses_to_edges(encode(value), first_start_us + index * INTERVAL_US))
    return edges

def test_frame_is_exactly_200_ms():
    assert sum(duration for _, duration in encode(0xDEADBEEF)) == FRAME_US

def test_round_trip_single_barcode():
    assert decode_edges(emit([0xDEADBEEF], IDLE_MIN_US)) == [
        Barcode(value=0xDEADBEEF, start_us=IDLE_MIN_US)
    ]

def test_round_trip_all_zero_and_all_one_payloads():
    values = [0x00000000, 0xFFFFFFFF]
    assert [b.value for b in decode_edges(emit(values, IDLE_MIN_US))] == values

def test_round_trip_sequence_preserves_cadence():
    decoded = decode_edges(emit([1000, 1001, 1002, 1003], IDLE_MIN_US))
    assert [b.value for b in decoded] == [1000, 1001, 1002, 1003]
    assert decoded[1].start_us - decoded[0].start_us == INTERVAL_US

def test_partial_leading_frame_is_discarded():
    """A segment starting mid-frame must not yield a bogus barcode."""
    edges = emit([7, 8], IDLE_MIN_US)
    truncated = [e for e in edges if e[0] > IDLE_MIN_US + 50_000]
    assert [b.value for b in decode_edges(truncated)] == [8]

def test_one_barcode_in_any_2_second_window():
    """A 3 s trial-length segment is always alignable. One barcode suffices:
    the timebase inherits clock rate from the device-level fit and needs only
    an offset (spec section 4.5)."""
    edges = emit(range(100, 120), 0)
    for offset in range(0, INTERVAL_US, 50_000):
        start = 5 * INTERVAL_US + offset
        inside = [(t, lvl) for t, lvl in edges if start <= t <= start + 2_000_000]
        assert len(decode_edges(inside)) >= 1, f"offset {offset} yielded none"

def test_two_barcodes_in_any_3_second_window():
    edges = emit(range(100, 120), 0)
    for offset in range(0, INTERVAL_US, 50_000):
        start = 5 * INTERVAL_US + offset
        inside = [(t, lvl) for t, lvl in edges if start <= t <= start + 3_000_000]
        assert len(decode_edges(inside)) >= 2, f"offset {offset} yielded too few"

def test_decode_from_sampled_trace_at_30khz():
    fs = 30_000.0
    trace = [0] * int(IDLE_MIN_US * 1e-6 * fs)
    for level, duration in encode(0x0BADC0DE):
        trace.extend([level] * round(duration * 1e-6 * fs))
    trace.extend([0] * int(0.5 * fs))
    assert [b.value for b in decode_edges(edges_from_samples(trace, fs))] == [0x0BADC0DE]

def test_generator_jitter_does_not_break_decoding():
    """Barcode output is software-timed on Pi 5, so slot boundaries wander.
    5 ms slots make that harmless — this pins the tolerance."""
    edges = []
    tick = IDLE_MIN_US
    for index, (level, duration) in enumerate(encode(0xC0FFEE)):
        jitter = 400 if index % 2 else -400  # +/- 0.4 ms
        edges.append((tick + jitter, level))
        tick += duration
    edges.append((tick, 0))
    assert [b.value for b in decode_edges(edges)] == [0xC0FFEE]

def test_value_out_of_32_bit_range_rejected():
    with pytest.raises(ValueError):
        encode(1 << 32)
```

- [ ] **Step 2: Run test to verify it fails**

Run: `pytest tests/test_barcode.py -v`
Expected: FAIL — `ModuleNotFoundError: No module named 'wl_sync.barcode'`

- [ ] **Step 3: Write the implementation**

```python
# wl_sync/barcode.py
"""Barcode codec. Pure — no hardware dependency, so it runs in CI.

Frame layout, 200 ms total:

    LEAD   HIGH 10 ms
    GAP1   LOW  10 ms
    DATA   32 x 5 ms, MSB first, HIGH = 1
    GAP2   LOW  10 ms
    TRAIL  HIGH 10 ms

Emitted once per second, so 800 ms of idle LOW separates frames. A frame starts
at "a rising edge after at least IDLE_MIN_US of LOW", which is what distinguishes
the lead pulse from a run of set bits. The longest LOW run *inside* a frame is
180 ms — an all-zero payload plus both gaps — comfortably under the threshold.

Consequence of requiring the preceding idle: a frame decodes only if the window
also contains the end of the previous frame. That yields one barcode guaranteed
in any 2.0 s window and two in any 3.0 s window. One is sufficient, because the
timebase inherits clock rate from a session-wide fit and needs only an offset.

Generation is deliberately tolerant: 5 ms slots sampled at 30 kHz give 150
samples per bit, so software-timed output on Pi 5 is fine. The receivers time
their own edges; the barcode carries identity, not timing.
"""

from __future__ import annotations

from collections.abc import Sequence
from dataclasses import dataclass

BIT_SLOT_US = 5_000
WRAPPER_US = 10_000
N_BITS = 32
FRAME_US = 4 * WRAPPER_US + N_BITS * BIT_SLOT_US  # 200_000
INTERVAL_US = 1_000_000
IDLE_MIN_US = 400_000

_MAX_VALUE = (1 << N_BITS) - 1
_QUARTER = WRAPPER_US // 4

@dataclass(frozen=True, slots=True)
class Barcode:
    value: int
    start_us: int  # tick of the LEAD rising edge

def encode(value: int) -> list[tuple[int, int]]:
    """Return (level, duration_us) pulses for one frame."""
    if not 0 <= value <= _MAX_VALUE:
        raise ValueError(f"barcode value out of 32-bit range: {value}")
    pulses: list[tuple[int, int]] = [(1, WRAPPER_US), (0, WRAPPER_US)]
    for position in range(N_BITS - 1, -1, -1):
        pulses.append(((value >> position) & 1, BIT_SLOT_US))
    pulses.append((0, WRAPPER_US))
    pulses.append((1, WRAPPER_US))
    return pulses

def edges_from_samples(
    trace: Sequence[int], fs_hz: float, t0_us: int = 0
) -> list[tuple[int, int]]:
    """Convert a sampled digital trace into (tick_us, level) transitions."""
    edges: list[tuple[int, int]] = []
    previous: int | None = None
    for index, sample in enumerate(trace):
        level = 1 if sample else 0
        if level != previous:
            edges.append((t0_us + round(index / fs_hz * 1_000_000), level))
            previous = level
    return edges

def _level_at(edges: Sequence[tuple[int, int]], tick_us: int) -> int:
    level = 0
    for edge_tick, edge_level in edges:
        if edge_tick > tick_us:
            break
        level = edge_level
    return level

def decode_edges(edges: Sequence[tuple[int, int]]) -> list[Barcode]:
    """Decode complete frames. Partial and unverifiable frames are discarded."""
    ordered = sorted(edges)
    if not ordered:
        return []

    barcodes: list[Barcode] = []
    last_falling: int | None = None

    for tick, level in ordered:
        if level == 0:
            last_falling = tick
            continue
        if last_falling is None or tick - last_falling < IDLE_MIN_US:
            continue

        start = tick
        if ordered[-1][0] < start + FRAME_US:
            continue

        if _level_at(ordered, start + _QUARTER) != 1:
            continue
        if _level_at(ordered, start + 3 * _QUARTER) != 1:
            continue
        if _level_at(ordered, start + WRAPPER_US + _QUARTER) != 0:
            continue
        if _level_at(ordered, start + WRAPPER_US + 3 * _QUARTER) != 0:
            continue

        data_start = start + 2 * WRAPPER_US
        value = 0
        for bit in range(N_BITS):
            centre = data_start + bit * BIT_SLOT_US + BIT_SLOT_US // 2
            value = (value << 1) | _level_at(ordered, centre)

        gap2 = data_start + N_BITS * BIT_SLOT_US
        if _level_at(ordered, gap2 + WRAPPER_US // 2) != 0:
            continue
        if _level_at(ordered, gap2 + WRAPPER_US + WRAPPER_US // 2) != 1:
            continue

        barcodes.append(Barcode(value=value, start_us=start))
        last_falling = None
    return barcodes
```

- [ ] **Step 4: Run test to verify it passes**

Run: `pytest tests/test_barcode.py -v`
Expected: PASS, 10 passed

- [ ] **Step 5: Commit**

```bash
git add wl_sync/barcode.py tests/test_barcode.py
git commit -m "feat: barcode codec, tolerant of software-timed generation"
```

---

### Task 3: On-disk log format

**Files:**
- Create: `wl_sync/log.py`
- Test: `tests/test_log.py`

**Interfaces:**
- Consumes: `SessionId` from `wl_sync.session`
- Produces: `TICK_WRAP_US = 1 << 32`; `SyncBoxLogHeader` (Pydantic: `schema_version`, `session_id`, `rig`, `boot_id`, `written_at`, `gpio_map`); `Edge(tick_us, gpio, level)`; `CodeWord(tick_us, word)`; `unwrap_ticks(raw)`; `write_log(path, header, records)`; `read_log(path) -> tuple[SyncBoxLogHeader, list[Edge | CodeWord]]`

- [ ] **Step 1: Write the failing test**

```python
# tests/test_log.py
import datetime

import pytest
from pydantic import ValidationError

from wl_sync.log import (
    TICK_WRAP_US,
    CodeWord,
    Edge,
    SyncBoxLogHeader,
    read_log,
    unwrap_ticks,
    write_log,
)

HEADER = SyncBoxLogHeader(
    schema_version=1,
    session_id="2027-03-14_01",
    rig="rig-a",
    boot_id="b7f1c2",
    written_at=datetime.datetime(2027, 3, 14, 11, 0, tzinfo=datetime.timezone.utc),
    gpio_map={"barcode_out": 17, "code_data_base": 2, "code_strobe": 18},
)

def test_monotonic_ticks_pass_through():
    assert unwrap_ticks([10, 20, 30]) == [10, 20, 30]

def test_ticks_unwrap_across_the_32_bit_boundary():
    raw = [TICK_WRAP_US - 100, TICK_WRAP_US - 50, 25, 75]
    assert unwrap_ticks(raw) == [
        TICK_WRAP_US - 100,
        TICK_WRAP_US - 50,
        TICK_WRAP_US + 25,
        TICK_WRAP_US + 75,
    ]

def test_ticks_unwrap_more_than_once():
    unwrapped = unwrap_ticks([TICK_WRAP_US - 10, 5, TICK_WRAP_US - 10, 5])
    assert unwrapped == sorted(unwrapped)
    assert unwrapped[-1] > 2 * TICK_WRAP_US

def test_empty_tick_list():
    assert unwrap_ticks([]) == []

def test_round_trip_mixed_records(tmp_path):
    records = [
        Edge(tick_us=100, gpio=17, level=1),
        CodeWord(tick_us=5_000, word=0x8001),
        Edge(tick_us=10_100, gpio=17, level=0),
        CodeWord(tick_us=11_000, word=0x0001),
    ]
    path = tmp_path / "syncbox.log"
    write_log(path, HEADER, records)
    header, read_back = read_log(path)
    assert header == HEADER
    assert read_back == records

def test_round_trip_with_no_records(tmp_path):
    path = tmp_path / "syncbox.log"
    write_log(path, HEADER, [])
    header, records = read_log(path)
    assert header == HEADER
    assert records == []

def test_header_rejects_unknown_key():
    with pytest.raises(ValidationError):
        SyncBoxLogHeader.model_validate({**HEADER.model_dump(mode="json"), "rgi": "rig-a"})

def test_header_rejects_naive_datetime():
    payload = HEADER.model_dump(mode="json")
    payload["written_at"] = "2027-03-14T11:00:00"
    with pytest.raises(ValidationError):
        SyncBoxLogHeader.model_validate(payload)

def test_header_rejects_malformed_session_id():
    payload = HEADER.model_dump(mode="json")
    payload["session_id"] = "March the 14th"
    with pytest.raises(ValidationError):
        SyncBoxLogHeader.model_validate(payload)

def test_unknown_record_type_raises(tmp_path):
    path = tmp_path / "syncbox.log"
    write_log(path, HEADER, [])
    with path.open("a", encoding="utf-8") as handle:
        handle.write("X,1,2\n")
    with pytest.raises(ValueError):
        read_log(path)
```

- [ ] **Step 2: Run test to verify it fails**

Run: `pytest tests/test_log.py -v`
Expected: FAIL — `ModuleNotFoundError: No module named 'wl_sync.log'`

- [ ] **Step 3: Write the implementation**

```python
# wl_sync/log.py
"""Sync box on-disk log.

One JSON header line, then one CSV line per record, type-tagged:

    E,tick_us,gpio,level     a transition on a single line
    W,tick_us,word           a 16-bit event code word latched on a strobe edge

Two record types because the RP1 PIO captures them differently: a strobed
parallel word arrives as one FIFO entry, while reward, lick and loopback lines
arrive as individual transitions. Flattening them into one shape would throw
away that distinction and force the reader to reconstruct it.

Plain text so it is readable with standard tools on a rig PC at 8am, which is
when it matters.

RP1's timebase counter wraps, so raw ticks must be unwrapped before use.
"""

from __future__ import annotations

import datetime
import json
from collections.abc import Iterable, Sequence
from dataclasses import dataclass
from pathlib import Path

from pydantic import BaseModel, ConfigDict, field_validator

from wl_sync.session import SessionId

TICK_WRAP_US = 1 << 32
SCHEMA_VERSION = 1

class SyncBoxLogHeader(BaseModel):
    model_config = ConfigDict(extra="forbid", frozen=True)

    schema_version: int
    session_id: str
    rig: str
    boot_id: str
    written_at: datetime.datetime
    gpio_map: dict[str, int]

    @field_validator("session_id")
    @classmethod
    def _session_id_well_formed(cls, value: str) -> str:
        SessionId.parse(value)
        return value

    @field_validator("written_at")
    @classmethod
    def _must_be_aware(cls, value: datetime.datetime) -> datetime.datetime:
        if value.tzinfo is None or value.utcoffset() is None:
            raise ValueError("written_at must be timezone-aware")
        return value

@dataclass(frozen=True, slots=True)
class Edge:
    tick_us: int
    gpio: int
    level: int

@dataclass(frozen=True, slots=True)
class CodeWord:
    tick_us: int
    word: int

Record = Edge | CodeWord

def unwrap_ticks(raw: Sequence[int]) -> list[int]:
    """Undo 32-bit tick wraparound, assuming records arrive in order."""
    unwrapped: list[int] = []
    offset = 0
    previous: int | None = None
    for tick in raw:
        if previous is not None and tick < previous:
            offset += TICK_WRAP_US
        unwrapped.append(tick + offset)
        previous = tick
    return unwrapped

def write_log(path: Path, header: SyncBoxLogHeader, records: Iterable[Record]) -> None:
    with path.open("w", encoding="utf-8") as handle:
        handle.write(json.dumps(header.model_dump(mode="json")) + "\n")
        for record in records:
            if isinstance(record, Edge):
                handle.write(f"E,{record.tick_us},{record.gpio},{record.level}\n")
            else:
                handle.write(f"W,{record.tick_us},{record.word}\n")

def read_log(path: Path) -> tuple[SyncBoxLogHeader, list[Record]]:
    with path.open("r", encoding="utf-8") as handle:
        header = SyncBoxLogHeader.model_validate(json.loads(handle.readline()))
        records: list[Record] = []
        for line in handle:
            stripped = line.strip()
            if not stripped:
                continue
            kind, *fields = stripped.split(",")
            if kind == "E":
                tick, gpio, level = (int(field) for field in fields)
                records.append(Edge(tick_us=tick, gpio=gpio, level=level))
            elif kind == "W":
                tick, word = (int(field) for field in fields)
                records.append(CodeWord(tick_us=tick, word=word))
            else:
                raise ValueError(f"unknown log record type: {kind!r}")
    return header, records
```

- [ ] **Step 4: Run test to verify it passes**

Run: `pytest tests/test_log.py -v`
Expected: PASS, 10 passed

- [ ] **Step 5: Commit**

```bash
git add wl_sync/log.py tests/test_log.py
git commit -m "feat: on-disk log with edges and strobed code words"
```

---

### Task 4: Backend protocol, fake, generator and recorder

**Files:**
- Create: `wl_sync/backend.py`, `wl_sync/service.py`
- Test: `tests/test_service.py`

**Interfaces:**
- Consumes: `encode`, `IDLE_MIN_US`, `decode_edges` from `wl_sync.barcode`; `Edge`, `CodeWord`, `TICK_WRAP_US` from `wl_sync.log`
- Produces: `SyncBackend` (Protocol: `emit_pulses(pin, pulses)`, `start_strobed_capture(data_base, data_count, strobe_pin, on_word)`, `start_edge_capture(pins, on_edge)`, `now_us()` — `start_pwm` was here until 2026-08-16, see the note in Task 5b); `FakeBackend` with `.emitted: list[tuple[int, list[tuple[int,int]]]]`, `.inject_word(tick, word)`, `.inject_edge(gpio, level, tick)`; `BarcodeGenerator(backend, pin, start_value)` with `.emit_frame() -> int`, `.next_value`; `Recorder(backend)` with `.capture_codes(data_base, data_count, strobe_pin)`, `.capture_edges(pins)`, `.records() -> list[Record]`

- [ ] **Step 1: Write the failing test**

```python
# tests/test_service.py
from wl_sync.backend import FakeBackend
from wl_sync.barcode import IDLE_MIN_US, decode_edges
from wl_sync.log import CodeWord, Edge, TICK_WRAP_US
from wl_sync.service import BarcodeGenerator, Recorder

BARCODE_PIN = 17
DATA_BASE = 2
DATA_COUNT = 16
STROBE_PIN = 18
REWARD_PIN = 23

def pulses_to_edges(pulses, start_us):
    edges = []
    tick = start_us
    for level, duration in pulses:
        edges.append((tick, level))
        tick += duration
    edges.append((tick, 0))
    return edges

def test_generator_emits_a_decodable_frame():
    backend = FakeBackend()
    BarcodeGenerator(backend, pin=BARCODE_PIN, start_value=1000).emit_frame()
    assert len(backend.emitted) == 1
    pin, pulses = backend.emitted[0]
    assert pin == BARCODE_PIN
    assert [b.value for b in decode_edges(pulses_to_edges(pulses, IDLE_MIN_US))] == [1000]

def test_generator_increments_monotonically():
    backend = FakeBackend()
    generator = BarcodeGenerator(backend, pin=BARCODE_PIN, start_value=7)
    assert [generator.emit_frame() for _ in range(3)] == [7, 8, 9]
    assert generator.next_value == 10

def test_recorder_captures_strobed_code_words():
    backend = FakeBackend()
    recorder = Recorder(backend)
    recorder.capture_codes(DATA_BASE, DATA_COUNT, STROBE_PIN)
    backend.inject_word(1_000, 0x8001)
    backend.inject_word(2_000, 0x0001)
    assert recorder.records() == [
        CodeWord(tick_us=1_000, word=0x8001),
        CodeWord(tick_us=2_000, word=0x0001),
    ]

def test_recorder_captures_edges():
    backend = FakeBackend()
    recorder = Recorder(backend)
    recorder.capture_edges([REWARD_PIN])
    backend.inject_edge(REWARD_PIN, 1, 3_000)
    backend.inject_edge(REWARD_PIN, 0, 3_500)
    assert recorder.records() == [
        Edge(tick_us=3_000, gpio=REWARD_PIN, level=1),
        Edge(tick_us=3_500, gpio=REWARD_PIN, level=0),
    ]

def test_records_are_returned_in_tick_order_across_types():
    backend = FakeBackend()
    recorder = Recorder(backend)
    recorder.capture_codes(DATA_BASE, DATA_COUNT, STROBE_PIN)
    recorder.capture_edges([REWARD_PIN])
    backend.inject_edge(REWARD_PIN, 1, 5_000)
    backend.inject_word(1_000, 0x8001)
    assert [r.tick_us for r in recorder.records()] == [1_000, 5_000]

def test_recorder_unwraps_the_tick_counter():
    backend = FakeBackend()
    recorder = Recorder(backend)
    recorder.capture_codes(DATA_BASE, DATA_COUNT, STROBE_PIN)
    backend.inject_word(TICK_WRAP_US - 500, 0x0001)
    backend.inject_word(500, 0x0002)
    assert [r.tick_us for r in recorder.records()] == [
        TICK_WRAP_US - 500,
        TICK_WRAP_US + 500,
    ]

def test_recorder_ignores_unregistered_pins():
    backend = FakeBackend()
    recorder = Recorder(backend)
    recorder.capture_edges([REWARD_PIN])
    backend.inject_edge(99, 1, 1_000)
    assert recorder.records() == []

def test_frame_times_are_the_falling_edges():
    backend = FakeBackend()
    recorder = Recorder(backend)
    recorder.capture_edges(sorted(FRAME_TIME_GPIO.values()))
    backend.inject_edge(26, 0, 1_000)   # ExposureActive asserts LOW
    backend.inject_edge(26, 1, 1_200)   # release is RC through the pull-up: not a frame time
    assert frame_times(recorder.records(), gpio=26) == [1_000]
```

- [ ] **Step 2: Run test to verify it fails**

Run: `pytest tests/test_service.py -v`
Expected: FAIL — `ModuleNotFoundError: No module named 'wl_sync.backend'`

- [ ] **Step 3: Write the implementation**

```python
# wl_sync/backend.py
"""Hardware backend protocol and an in-memory fake.

Deliberately mechanism-neutral: the protocol says *what* the sync box needs, not
how a particular chip provides it. On Pi 5 the three functions land on three
different mechanisms — PIO for strobed capture, ordinary GPIO for barcode
output and for edge capture — and none of that leaks into the service layer
or the tests.
"""

from __future__ import annotations

from collections.abc import Callable, Sequence
from typing import Protocol

class SyncBackend(Protocol):
    def emit_pulses(self, pin: int, pulses: Sequence[tuple[int, int]]) -> None:
        """Drive pin through (level, duration_us). Timing need not be precise."""

    def start_strobed_capture(
        self, data_base: int, data_count: int, strobe_pin: int,
        on_word: Callable[[int, int], None],
    ) -> None:
        """Latch data_count contiguous pins on each strobe edge.

        Calls on_word(tick_us, word). The contiguity requirement is PIO's.
        """

    def start_edge_capture(
        self, pins: Sequence[int], on_edge: Callable[[int, int, int], None]
    ) -> None:
        """Capture transitions on individual pins. Calls on_edge(gpio, level, tick_us)."""

    def now_us(self) -> int:
        """Current value of the hardware tick counter."""

class FakeBackend:
    """Records outputs and dispatches injected inputs. Test double only."""

    def __init__(self) -> None:
        self.emitted: list[tuple[int, list[tuple[int, int]]]] = []
        self._on_word: Callable[[int, int], None] | None = None
        self._edge_pins: list[int] = []
        self._on_edge: Callable[[int, int, int], None] | None = None
        self._tick = 0

    def emit_pulses(self, pin: int, pulses: Sequence[tuple[int, int]]) -> None:
        self.emitted.append((pin, list(pulses)))

    def start_strobed_capture(
        self, data_base: int, data_count: int, strobe_pin: int,
        on_word: Callable[[int, int], None],
    ) -> None:
        self._on_word = on_word

    def start_edge_capture(
        self, pins: Sequence[int], on_edge: Callable[[int, int, int], None]
    ) -> None:
        self._edge_pins = list(pins)
        self._on_edge = on_edge

    def now_us(self) -> int:
        return self._tick

    def inject_word(self, tick: int, word: int) -> None:
        self._tick = tick
        if self._on_word is not None:
            self._on_word(tick, word)

    def inject_edge(self, gpio: int, level: int, tick: int) -> None:
        self._tick = tick
        if self._on_edge is not None and gpio in self._edge_pins:
            self._on_edge(gpio, level, tick)
```

```python
# wl_sync/service.py
"""Barcode generation and recording.

Barcode output is software-timed and that is deliberate: 5 ms bit slots sampled
at 30 kHz give 150 samples per bit, and each receiver times its own edges, so
generator jitter of a few hundred microseconds is harmless. Precision is spent
where it is needed — strobed capture, which on training days is the sole record
of event times.
"""

from __future__ import annotations

from collections.abc import Sequence

from wl_sync.backend import SyncBackend
from wl_sync.barcode import encode
from wl_sync.log import TICK_WRAP_US, CodeWord, Edge, Record

class BarcodeGenerator:
    """Emits one barcode frame per call, incrementing a monotonic counter.

    The counter is never reset — across sessions or reboots — so every barcode
    the lab ever emits is globally unique and cross-session mis-alignment is
    structurally impossible rather than merely unlikely.
    """

    def __init__(self, backend: SyncBackend, pin: int, start_value: int) -> None:
        self._backend = backend
        self._pin = pin
        self.next_value = start_value

    def emit_frame(self) -> int:
        value = self.next_value
        self._backend.emit_pulses(self._pin, encode(value))
        self.next_value = value + 1
        return value

class Recorder:
    """Collects strobed code words and individual edges onto one unwrapped clock."""

    def __init__(self, backend: SyncBackend) -> None:
        self._backend = backend
        self._records: list[Record] = []
        self._offset = 0
        self._previous_raw: int | None = None

    def _unwrap(self, tick: int) -> int:
        if self._previous_raw is not None and tick < self._previous_raw:
            self._offset += TICK_WRAP_US
        self._previous_raw = tick
        return tick + self._offset

    def capture_codes(self, data_base: int, data_count: int, strobe_pin: int) -> None:
        self._backend.start_strobed_capture(
            data_base, data_count, strobe_pin, self._on_word
        )

    def capture_edges(self, pins: Sequence[int]) -> None:
        self._backend.start_edge_capture(pins, self._on_edge)

    def _on_word(self, tick: int, word: int) -> None:
        self._records.append(CodeWord(tick_us=self._unwrap(tick), word=word))

    def _on_edge(self, gpio: int, level: int, tick: int) -> None:
        self._records.append(Edge(tick_us=self._unwrap(tick), gpio=gpio, level=level))

    def records(self) -> list[Record]:
        return sorted(self._records, key=lambda record: record.tick_us)
```

- [ ] **Step 4: Run test to verify it passes**

Run: `pytest -v`
Expected: PASS, all tests across four modules

- [ ] **Step 5: Commit**

```bash
git add wl_sync/backend.py wl_sync/service.py tests/test_service.py
git commit -m "feat: mechanism-neutral backend protocol, generator and recorder"
```

---

### Task 5a: PIO FIFO word decoding

**Files:**
- Create: `wl_sync/rp1/__init__.py`, `wl_sync/rp1/pio_capture.py`
- Test: `tests/test_pio_capture.py`

**Interfaces:**
- Consumes: nothing
- Produces: `FIFO_WORD_BITS = 32`; `pair_fifo(entries: Sequence[int], data_count: int) -> list[tuple[int, int]]` returning `(absolute_tick_us, word)` pairs; `DesyncError`. **Revised 2026-08-22** — was `decode_fifo` + `accumulate_ticks` over a one-word data+delta format, which left 16 delta bits (65.535 ms) beside 16 data lines against ~3 s trials, and summed overflowed deltas silently.

Splitting this out is deliberate: the FIFO layout is pure arithmetic and testable on a laptop, so only the `piolib` call itself is hardware-gated.

- [ ] **Step 1: Write the failing test**

```python
# tests/test_pio_capture.py
import pytest

from wl_sync.rp1.pio_capture import accumulate_ticks, decode_fifo

def pack(tick_delta: int, word: int, data_count: int = 16) -> int:
    """PIO pushes one 32-bit entry: data in the low bits, tick delta above."""
    return (tick_delta << data_count) | word

def test_decodes_a_single_entry():
    assert decode_fifo([pack(50, 0x8001)], data_count=16) == [(50, 0x8001)]

def test_decodes_several_entries():
    entries = [pack(10, 0x0001), pack(20, 0x0002), pack(30, 0x0003)]
    assert decode_fifo(entries, data_count=16) == [(10, 0x0001), (20, 0x0002), (30, 0x0003)]

def test_masks_data_to_the_declared_width():
    """A narrower capture must not leak tick bits into the code word."""
    assert decode_fifo([pack(7, 0x00FF, data_count=8)], data_count=8) == [(7, 0x00FF)]

def test_accumulates_deltas_into_absolute_ticks():
    pairs = [(10, 0x1), (20, 0x2), (30, 0x3)]
    assert accumulate_ticks(pairs, t0=1_000) == [
        (1_010, 0x1),
        (1_030, 0x2),
        (1_060, 0x3),
    ]

def test_accumulate_on_empty_input():
    assert accumulate_ticks([], t0=5) == []

def test_rejects_impossible_data_width():
    with pytest.raises(ValueError):
        decode_fifo([0], data_count=33)
```

- [ ] **Step 2: Run test to verify it fails**

Run: `pytest tests/test_pio_capture.py -v`
Expected: FAIL — `ModuleNotFoundError: No module named 'wl_sync.rp1'`

- [ ] **Step 3: Write the implementation**

```python
# wl_sync/rp1/__init__.py
__all__: list[str] = []
```

```python
# wl_sync/rp1/pio_capture.py
"""Decoding for the strobe-capture PIO program's FIFO entries.

The PIO program pushes one 32-bit word per strobe edge: the captured data lines
in the low `data_count` bits, and the tick delta since the previous capture in
the bits above. Deltas rather than absolute ticks because the state machine's
counter is narrow; the host accumulates them against a known start.

This module is pure arithmetic and is tested on a laptop. Only the piolib call
that produces `entries` is hardware-gated.
"""

from __future__ import annotations

from collections.abc import Sequence

FIFO_WORD_BITS = 32

def decode_fifo(entries: Sequence[int], data_count: int) -> list[tuple[int, int]]:
    """Split FIFO entries into (tick_delta, word) pairs."""
    if not 1 <= data_count < FIFO_WORD_BITS:
        raise ValueError(f"data_count must be 1..{FIFO_WORD_BITS - 1}, got {data_count}")
    mask = (1 << data_count) - 1
    return [(entry >> data_count, entry & mask) for entry in entries]

def accumulate_ticks(
    pairs: Sequence[tuple[int, int]], t0: int
) -> list[tuple[int, int]]:
    """Turn (tick_delta, word) pairs into (absolute_tick, word)."""
    absolute: list[tuple[int, int]] = []
    tick = t0
    for delta, word in pairs:
        tick += delta
        absolute.append((tick, word))
    return absolute
```

- [ ] **Step 4: Run test to verify it passes**

Run: `pytest tests/test_pio_capture.py -v`
Expected: PASS, 6 passed

- [ ] **Step 5: Commit**

```bash
git add wl_sync/rp1 tests/test_pio_capture.py
git commit -m "feat(rp1): PIO FIFO word decoding, testable off-hardware"
```

---

### Task 5b: The RP1 backend — hardware-gated

**Files:**
- Create: `pio/strobe_capture.pio`, `wl_sync/rp1/backend.py`
- Modify: `pyproject.toml` (add the `pi` extra's binding dependency)

**Interfaces:**
- Consumes: `decode_fifo`, `accumulate_ticks` from `wl_sync.rp1.pio_capture`; `SyncBackend` from `wl_sync.backend`
- Produces: `Rp1Backend` implementing every `SyncBackend` method

**This task cannot be unit-tested and is deliberately structured differently.** `piolib` is a C library reached by ctypes, and the PIO program's behaviour is a property of silicon. Everything testable was pulled into Task 5a; what remains is validated on a bench Pi 5 against acceptance criteria.

- [ ] **Step 1: Write the PIO program**

`pio/strobe_capture.pio` — one state machine. Wait for a strobe edge, sample the contiguous data pins, push the data word and then a full 32-bit counter word. **DRAFTED 2026-08-22, unverified** — see the file's own `UNVERIFIED` list. Every path costs two cycles per counter decrement, so a capture loses no time; a naive version that counts only while idle slips ~2 µs per event, which is 1.2 ms over 600 events and fails Step 3 on its own. Budget: well inside RP1's 32-instruction memory, leaving state machines free for edge capture.

- [ ] **Step 2: Write the ctypes binding and backend**

`Rp1Backend` implements `SyncBackend`: `start_strobed_capture` loads the PIO program and drains the FIFO into `on_word` via `pair_fifo` (**two words per event since 2026-08-22** — data word then raw down-counter; `pair_fifo` inverts the counter and validates the pairing); `start_edge_capture` captures individual-pin transitions (the reward/comparator lines **and, since 2026-08-16, the camera frame-time inputs on GPIO26/27**) via **libgpiod v2 line events, not PIO** — the kernel stamps each edge from CLOCK_MONOTONIC at interrupt time, which is the same clock `now_us()` counts from, so edges need no correction for thread wake-up latency; `EdgeEvent.global_seqno` makes a kernel-side drop detectable rather than silent; `emit_pulses` drives ordinary GPIO with software timing; `now_us` reads RP1's timebase.

> **`start_pwm` is NOT part of this task any more.** It was removed from `SyncBackend` on 2026-08-16: the cameras free-run, so the box emits no trigger and GPIO18/19 are spare. Do not implement a PWM channel here — see `hardware/breakout/camera-sync-change.md`.

- [ ] **Step 3: Bench acceptance — timestamp accuracy**

Drive the strobe and data lines from a second board or a signal generator with a known pattern. **Acceptance: recovered timestamps within ±100 µs of ground truth over a 10-minute run, with zero dropped words.** This is the gate the whole Pi 5 decision rests on; if it fails, the backend seam means Pi 4 plus `pigpio` remains available.

- [ ] **Step 4: Bench acceptance — parity with the fake**

Replay the bench capture through `Recorder` and confirm the resulting log is byte-identical in structure to one produced by `FakeBackend` given the same injected words. The Task 4 tests already pin that shape, so this is the real payoff of the adapter.

- [ ] **Step 5: Bench acceptance — tick wraparound**

Run past one full wrap of RP1's timebase counter and confirm `Recorder` unwraps correctly. This is roughly the failure that would corrupt a long session silently, and it cannot be observed in a short run.

- [ ] **Step 6: Commit**

```bash
git add pio wl_sync/rp1/backend.py pyproject.toml
git commit -m "feat(rp1): PIO strobe capture backend for Pi 5"
```

---

## Definition of done

- Tasks 1–5a: `pytest` green with no Pi libraries installed
- Task 5b: three bench acceptance criteria met on a Pi 5
- `wl-preproc` can `pip install wl-sync` and decode barcodes and read logs

## Hardware this plan constrains

- **Pin contiguity.** PIO parallel capture reads a contiguous range, so the 16 code lines plus strobe must be adjacent on the header. `pigpio` had no such constraint, so this is new — and it pins down the breakout PCB's pinout before that board is designed.
- ~~Camera triggers must land on GPIO12, 13, 18 or 19, the hardware PWM channels.~~ **Void 2026-08-16 — the cameras free-run.** This box emits no camera trigger at all; the panel lines carry the barcode instead, GPIO18/19 are spare, and the cameras' own exposure strobes come back IN on GPIO26/27. This was also the constraint that forced the PIO capture window to start at GPIO0 — see `hardware/breakout/camera-sync-change.md` §2 for why the window nonetheless stays there.
- **Level shifting** remains mandatory: Pi GPIO is 3.3 V, rig TTL is 5 V, and connecting them directly destroys the board.

## Deliberately not in this plan

- **The scheduling loop** calling `emit_frame()` once per second, and the systemd unit — trivial once Task 5b lands, and pointless before.
- **NAS transfer at session end** — ordinary Linux, no timing content.
- **Timebase fitting** — wl-preproc's, since it needs barcodes from several devices at once.
