jakewesterberg/wl-sync/docs/superpowers/plans/2026-08-16-continuous-recording.md

# Continuous Recording Implementation Plan

> **For agentic workers:** REQUIRED SUB-SKILL: Use superpowers:subagent-driven-development (recommended) or superpowers:executing-plans to implement this plan task-by-task. Steps use checkbox (`- [ ]`) syntax for tracking.

**Goal:** Make the sync box record continuously for a whole day, stream to disk so a crash costs ≤1 second, and describe its own outages well enough that `wl-preproc` can mark unwitnessed trials positively.

**Architecture:** One directory per day, one segment file per process run. The barcode counter becomes seconds-since-2020 so an outage is visible in the shared alignment key itself. Records stream to an append-only sink with `fsync` at 1 Hz. A manifest, rebuilt by scanning segments at every start, enumerates segments and gaps — crash-vs-clean is derived from whether a segment has a trailer, never from a dying process cooperating.

**Tech Stack:** Python ≥3.11, pydantic ≥2.6, pytest. No Pi libraries — everything here runs on a laptop against `FakeBackend`.

**Spec:** `docs/superpowers/specs/2026-08-16-syncbox-continuous-recording-design.md`

## Global Constraints

- **Python ≥3.11, no upper bound.** Must work on 3.11 (`wl-preproc`'s floor) and on 3.13 (Raspberry Pi OS Trixie). Copied from `pyproject.toml`.
- **No Pi libraries in the base install.** CI asserts no `piolib`/`pigpio`/`lgpio`/`rpi-*` is present. Everything in this plan must import and test without them.
- **Barcode values are 32-bit:** `0 <= value <= (1 << 32) - 1`. Enforced by `barcode.encode()`, which raises outside that range.
- **`TICK_WRAP_US = 1 << 32`** microseconds ≈ 71.6 minutes. Ticks wrap ~20× per day.
- **Session id format is `YYYY-MM-DD_NN`**, validated by `SessionId.parse` and by `SyncBoxLogHeader`. Downstream (`wl-preproc`, the ELN) consumes it, so the format does not change. The day directory is named with it: `<out>/2026-08-16_01/`.
- **Existing tests must keep passing unchanged.** 130 at the time of writing. The `Recorder` sink seam (Task 5) exists specifically so the default in-memory behaviour is untouched.

---

### Task 1: The `B` barcode record type

The sync box currently hands every other device the alignment key and keeps no copy — `log.py` has only `E` and `W` records. Everything else in this plan depends on the log containing the barcodes it emitted.

**Files:**
- Modify: `wl_sync/log.py`
- Test: `tests/test_log.py`

**Interfaces:**
- Consumes: nothing from earlier tasks.
- Produces: `BarcodeEmitted(tick_us: int, value: int)` frozen dataclass; `Record` union widened to `Edge | CodeWord | BarcodeEmitted`; `write_log`/`read_log` round-trip it as `B,tick_us,value`.

- [ ] **Step 1: Write the failing test**

Add to `tests/test_log.py`, and add `BarcodeEmitted` to its existing `from wl_sync.log import (...)` block:

```python
def test_barcode_records_round_trip(tmp_path):
    path = tmp_path / "syncbox.log"
    records = [
        BarcodeEmitted(tick_us=1_000, value=212_000_000),
        Edge(tick_us=1_500, gpio=26, level=0),
        BarcodeEmitted(tick_us=1_001_000, value=212_000_001),
    ]
    write_log(path, HEADER, records)
    _, read_back = read_log(path)
    assert read_back == records

def test_barcode_record_line_format(tmp_path):
    """The on-disk shape is a downstream contract, so pin the literal line."""
    path = tmp_path / "syncbox.log"
    write_log(path, HEADER, [BarcodeEmitted(tick_us=1_000, value=212_000_000)])
    assert path.read_text().splitlines()[1] == "B,1000,212000000"
```

- [ ] **Step 2: Run the test to verify it fails**

Run: `python3 -m pytest tests/test_log.py -q`
Expected: FAIL — `ImportError: cannot import name 'BarcodeEmitted' from 'wl_sync.log'`

- [ ] **Step 3: Write the minimal implementation**

In `wl_sync/log.py`, add the dataclass after `CodeWord` and widen the union:

```python
@dataclass(frozen=True, slots=True)
class BarcodeEmitted:
    """A barcode frame this box emitted, with the tick of its LEAD rising edge.

    The box hands every other device this value as the alignment key; until 2026-08-16
    it kept no copy of its own, so its log could not be aligned against the devices it
    was synchronising. One record per second, ~86 KB/day against a ~1 GB day.
    """

    tick_us: int
    value: int

Record = Edge | CodeWord | BarcodeEmitted
```

Update the module docstring's format table to add:

```
    B,tick_us,value          a barcode frame this box emitted
```

In `write_log`, replace the `if/else` with:

```python
        for record in records:
            if isinstance(record, Edge):
                handle.write(f"E,{record.tick_us},{record.gpio},{record.level}\n")
            elif isinstance(record, BarcodeEmitted):
                handle.write(f"B,{record.tick_us},{record.value}\n")
            else:
                handle.write(f"W,{record.tick_us},{record.word}\n")
```

In `read_log`, add before the `else` that raises:

```python
            elif kind == "B":
                tick, value = (int(field) for field in fields)
                records.append(BarcodeEmitted(tick_us=tick, value=value))
```

- [ ] **Step 4: Run the tests to verify they pass**

Run: `python3 -m pytest -q`
Expected: PASS, 132 tests.

- [ ] **Step 5: Commit**

```bash
git add wl_sync/log.py tests/test_log.py
git commit -m "feat(log): record the barcodes this box emits"
```

---
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
