jakewesterberg/wl-sync/hardware/mule/mule.kicad_pcb

## KiCad design hardware/mule/mule.kicad_pcb (2026-08-15)

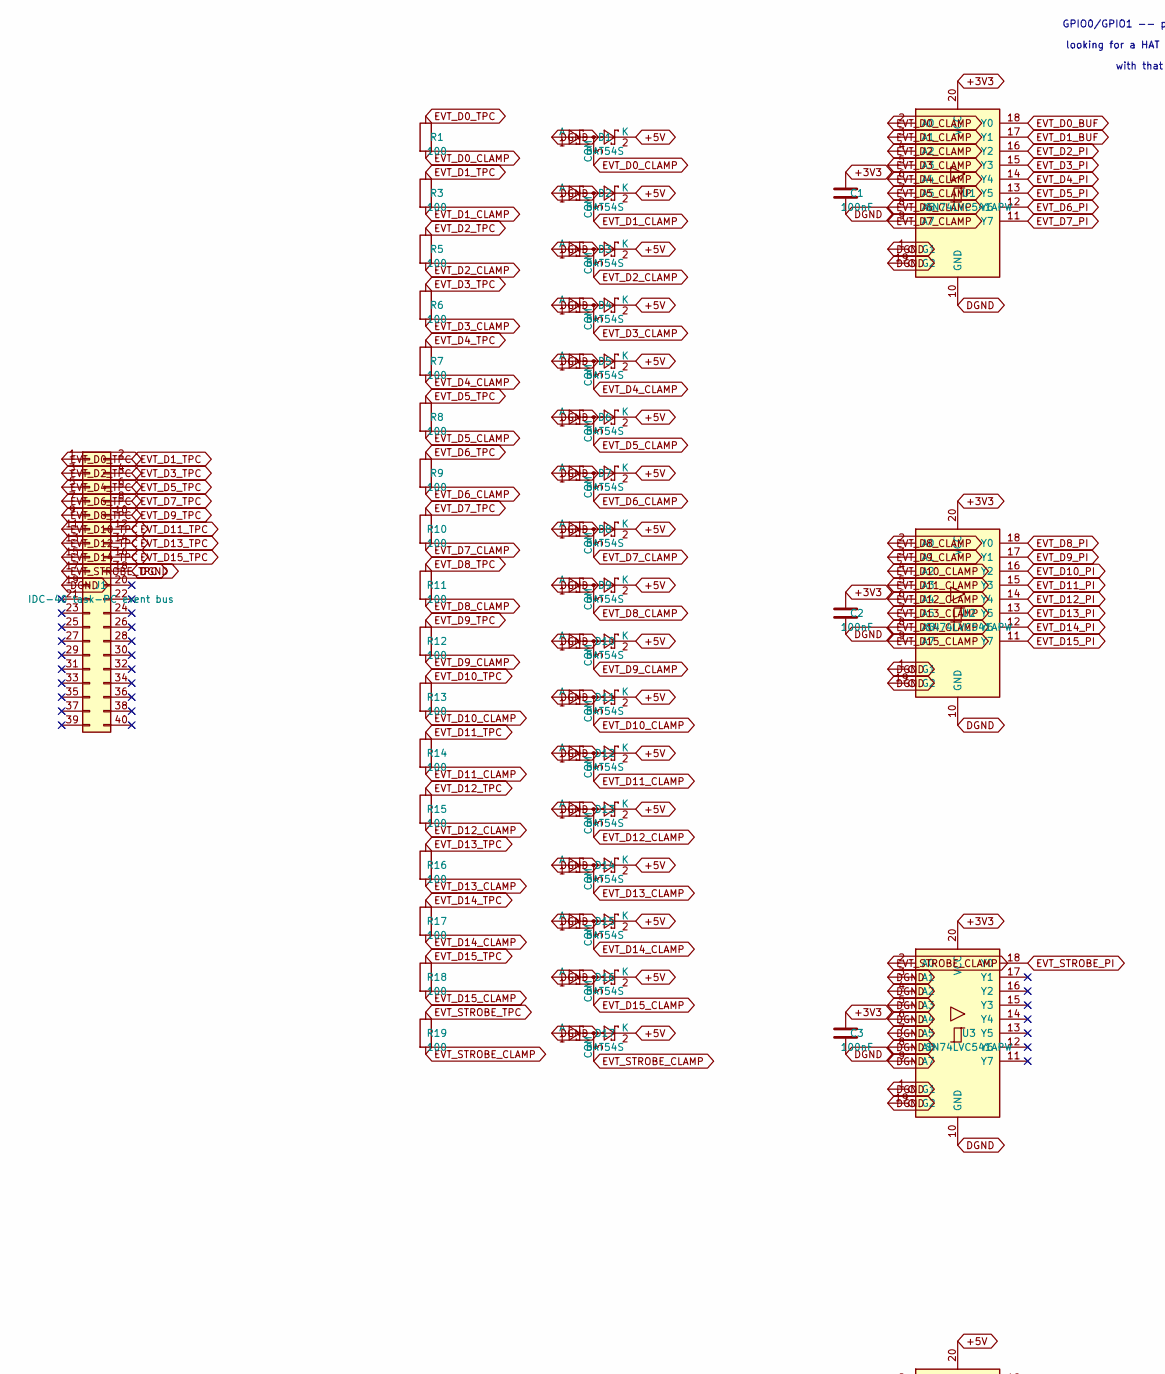
[picture p1: schematic mule.kicad_sch, part in row 1, column 1]

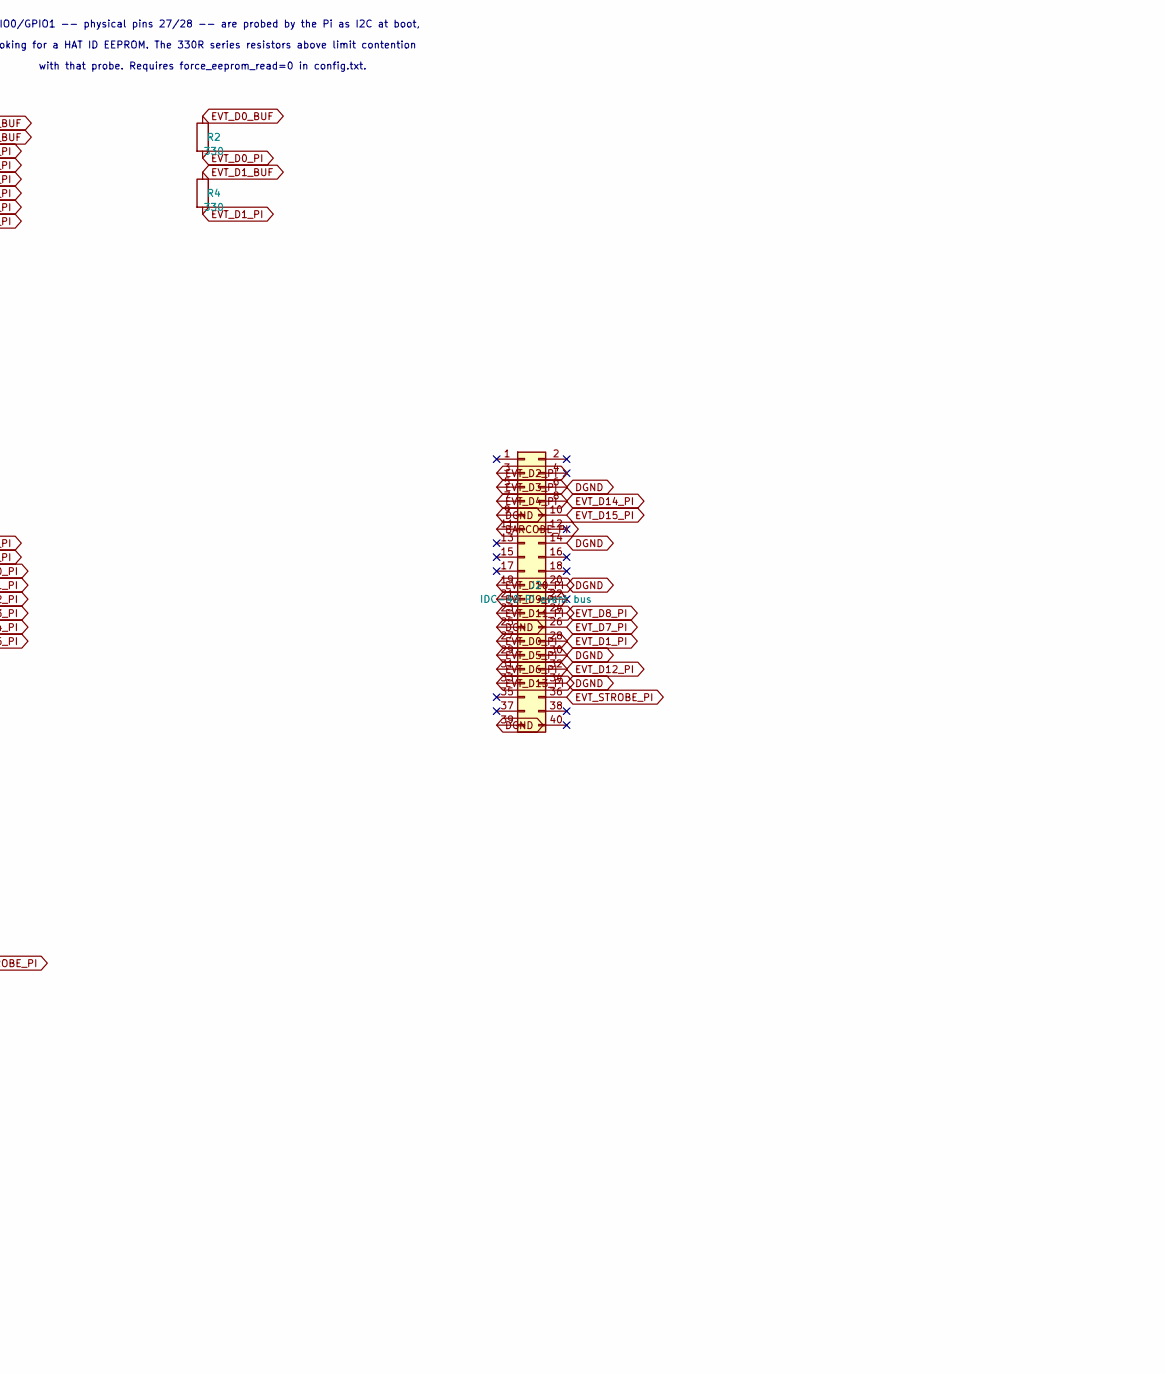
[picture p2: schematic mule.kicad_sch, part in row 1, column 2]

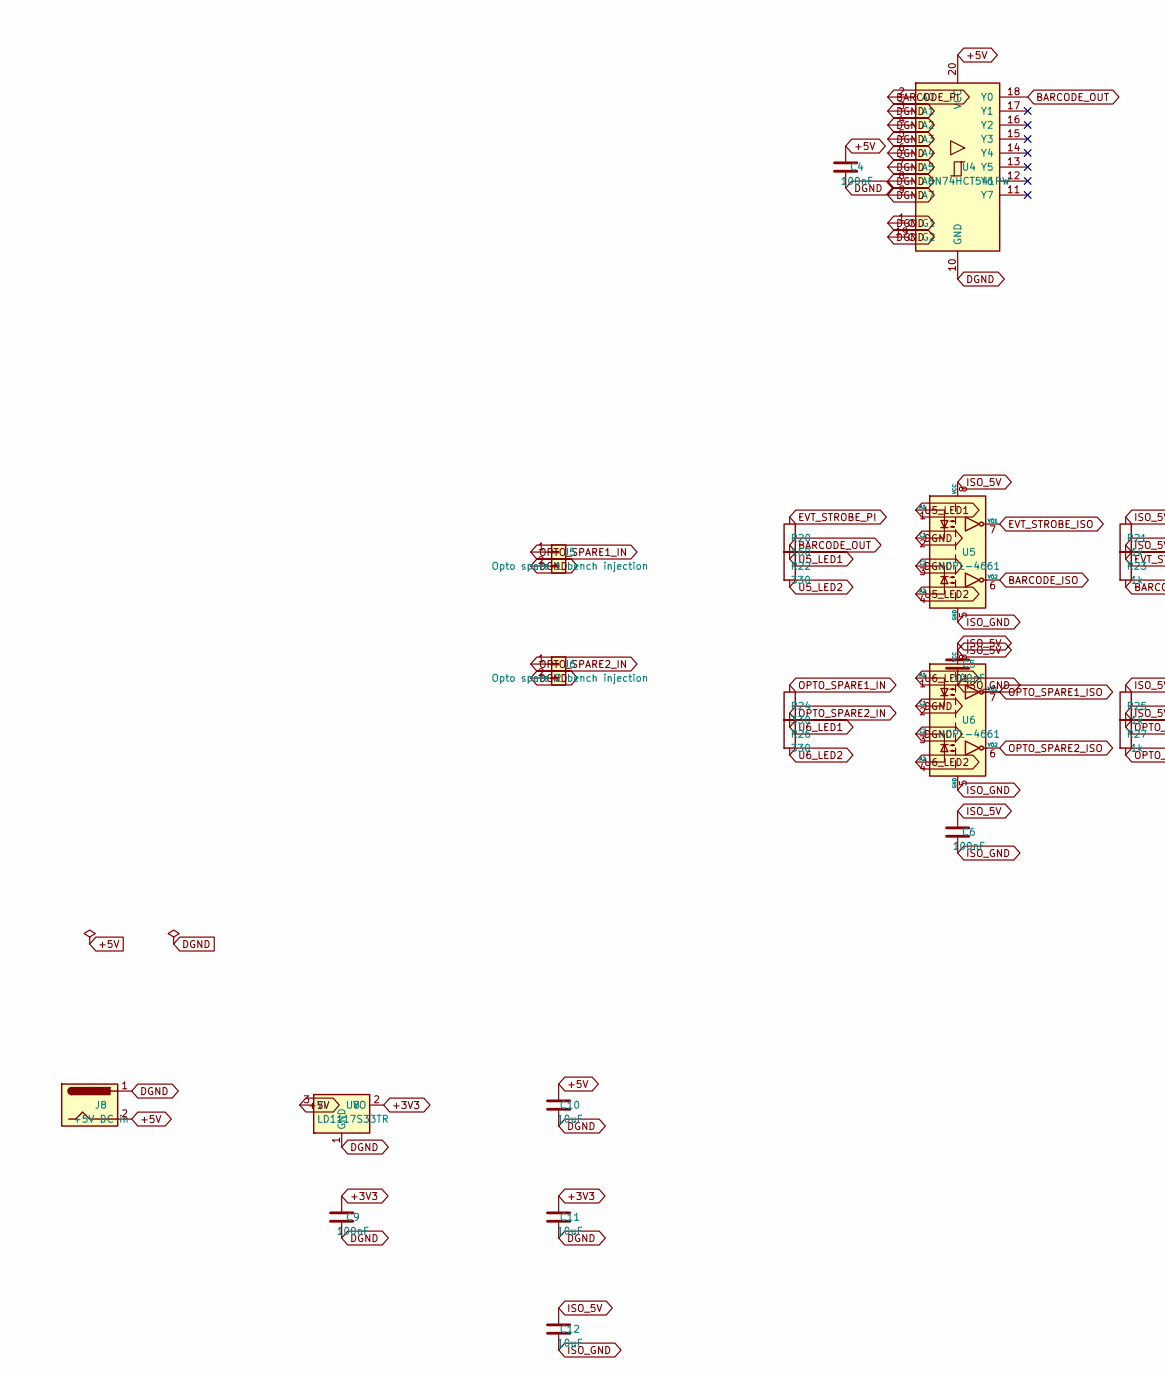
[picture p3: schematic mule.kicad_sch, part in row 2, column 1]

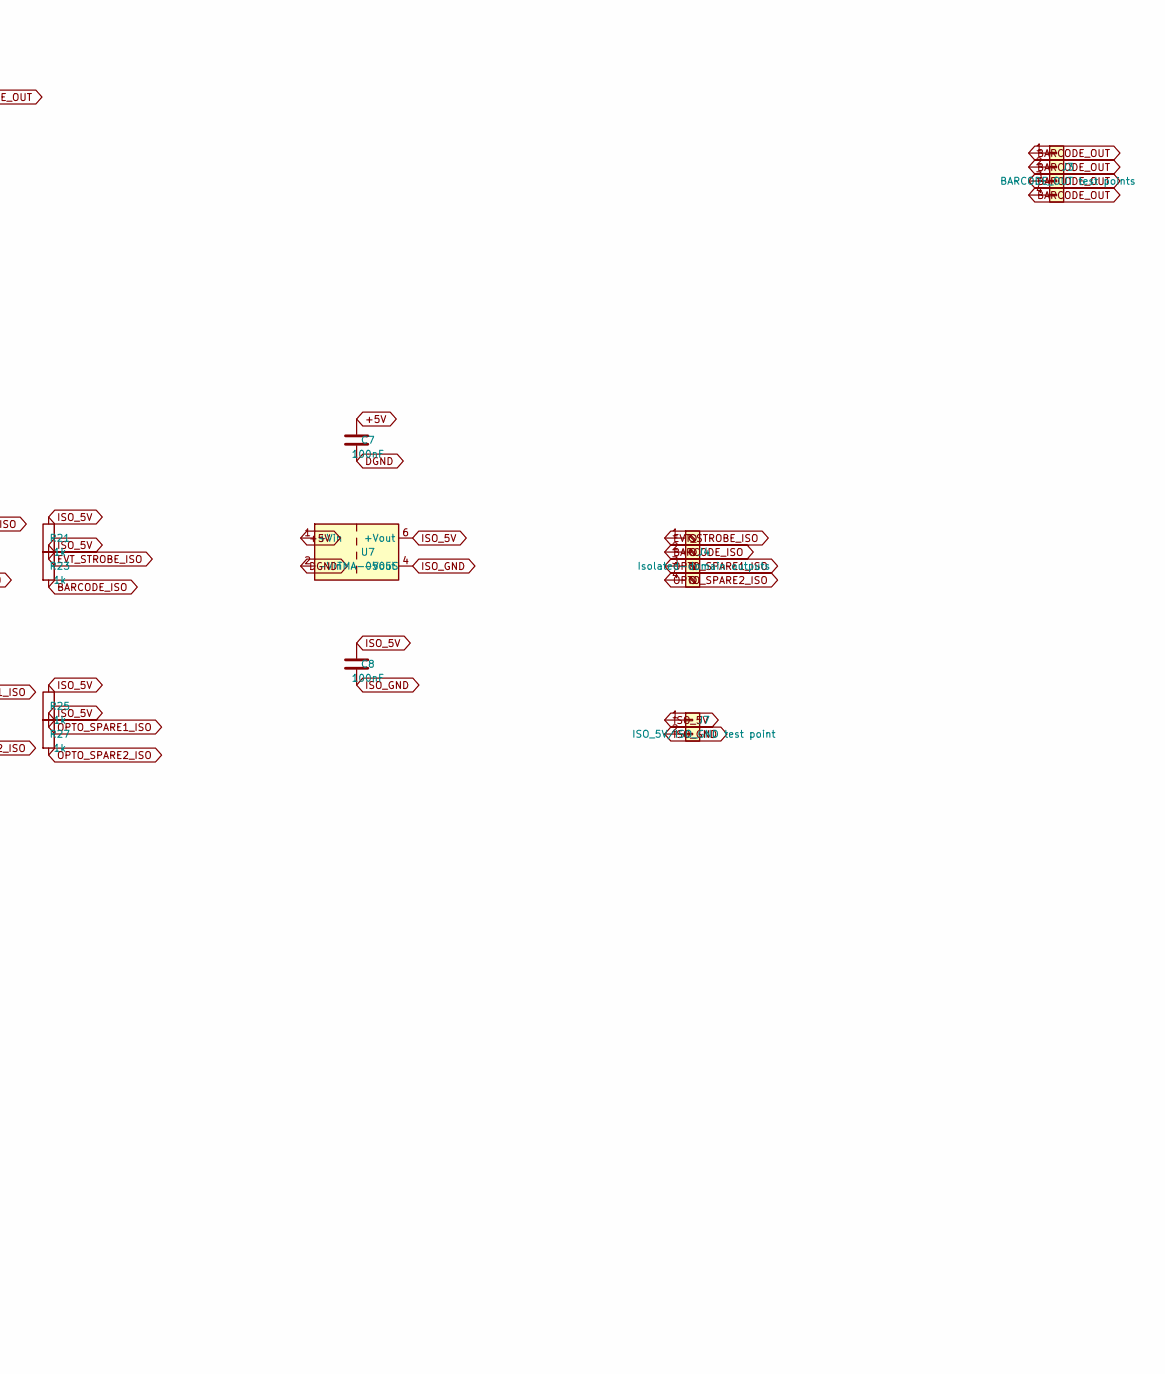
[picture p4: schematic mule.kicad_sch, part in row 2, column 2]

Parts:
C1, C2, C3, C4, C5, C6, C7, C8, C9: 100nF; C_0603_1608Metric
C10, C11, C12: 10uF; C_0805_2012Metric
D1, D2, D3, D4, D5, D6, D7, D8, D9, D10, D11, D12, D13, D14, D15, D16, D17: BAT54S; SOT-23
J1: IDC-40 task-PC event bus; PinHeader_2x20_P2.54mm_Vertical
J2: IDC-40 Pi event bus; PinHeader_2x20_P2.54mm_Vertical
J3: BARCODE_OUT test points; PinHeader_1x04_P2.54mm_Vertical
J4: Isolated-domain outputs; TerminalBlock_Phoenix_MKDS-1,5-4_1x04_P5.00mm_Horizontal
J5: Opto spare 1 bench injection; PinHeader_1x02_P2.54mm_Vertical
J6: Opto spare 2 bench injection; PinHeader_1x02_P2.54mm_Vertical
J7: ISO_5V/ISO_GND test point; PinHeader_1x02_P2.54mm_Vertical
J8: +5V DC in; BarrelJack_CUI_PJ-102AH_Horizontal
R1, R3, R5, R6, R7, R8, R9, R10, R11, R12, R13, R14, R15, R16, R17, R18, R19: 100; R_0603_1608Metric
R2, R4, R22, R24, R26: 330; R_0603_1608Metric
R20: 160; R_0603_1608Metric
R21, R23, R25, R27: 1k; R_0603_1608Metric
U1, U2, U3: SN74LVC541APW; Texas_PW0020A_TSSOP-20_4.4x6.5mm_P0.65mm
U4: SN74HCT541PW; Texas_PW0020A_TSSOP-20_4.4x6.5mm_P0.65mm
U5, U6: HCPL-4661; DIP-8_W7.62mm
U7: TMA-0505S; Converter_DCDC_TRACO_TMA-05xxS_12xxS_Single_THT
U8: LD1117S33TR; SOT-223-3_TabPin2

Connections:
+3V3: C1.1, C2.1, C3.1, C9.1, C11.1, U1.20 (VCC), U2.20 (VCC), U3.20 (VCC), U8.2 (VO)
BARCODE_ISO: J4.2, R23.2, U5.6 (VO2)
BARCODE_OUT: J3.1, J3.2, J3.3, J3.4, R22.1, U4.18 (Y0)
BARCODE_PI: J2.11, U4.2 (A0)
EVT_D0_BUF: R2.1, U1.18 (Y0)
EVT_D0_CLAMP: D1.3 (COM), R1.2, U1.2 (A0)
EVT_D0_PI: J2.27, R2.2
EVT_D0_TPC: J1.1, R1.1
EVT_D1_BUF: R4.1, U1.17 (Y1)
EVT_D1_CLAMP: D2.3 (COM), R3.2, U1.3 (A1)
EVT_D1_PI: J2.28, R4.2
EVT_D1_TPC: J1.2, R3.1
EVT_D2_CLAMP: D3.3 (COM), R5.2, U1.4 (A2)
EVT_D2_PI: J2.3, U1.16 (Y2)
EVT_D2_TPC: J1.3, R5.1
EVT_D3_CLAMP: D4.3 (COM), R6.2, U1.5 (A3)
EVT_D3_PI: J2.5, U1.15 (Y3)
EVT_D3_TPC: J1.4, R6.1
EVT_D4_CLAMP: D5.3 (COM), R7.2, U1.6 (A4)
EVT_D4_PI: J2.7, U1.14 (Y4)
EVT_D4_TPC: J1.5, R7.1
EVT_D5_CLAMP: D6.3 (COM), R8.2, U1.7 (A5)
EVT_D5_PI: J2.29, U1.13 (Y5)
EVT_D5_TPC: J1.6, R8.1
EVT_D6_CLAMP: D7.3 (COM), R9.2, U1.8 (A6)
EVT_D6_PI: J2.31, U1.12 (Y6)
EVT_D6_TPC: J1.7, R9.1
EVT_D7_CLAMP: D8.3 (COM), R10.2, U1.9 (A7)
EVT_D7_PI: J2.26, U1.11 (Y7)
EVT_D7_TPC: J1.8, R10.1
EVT_D8_CLAMP: D9.3 (COM), R11.2, U2.2 (A0)
EVT_D8_PI: J2.24, U2.18 (Y0)
EVT_D8_TPC: J1.9, R11.1
EVT_D9_CLAMP: D10.3 (COM), R12.2, U2.3 (A1)
EVT_D9_PI: J2.21, U2.17 (Y1)
EVT_D9_TPC: J1.10, R12.1
EVT_D10_CLAMP: D11.3 (COM), R13.2, U2.4 (A2)
EVT_D10_PI: J2.19, U2.16 (Y2)
EVT_D10_TPC: J1.11, R13.1
EVT_D11_CLAMP: D12.3 (COM), R14.2, U2.5 (A3)
EVT_D11_PI: J2.23, U2.15 (Y3)
EVT_D11_TPC: J1.12, R14.1
EVT_D12_CLAMP: D13.3 (COM), R15.2, U2.6 (A4)
EVT_D12_PI: J2.32, U2.14 (Y4)
EVT_D12_TPC: J1.13, R15.1
EVT_D13_CLAMP: D14.3 (COM), R16.2, U2.7 (A5)
EVT_D13_PI: J2.33, U2.13 (Y5)
EVT_D13_TPC: J1.14, R16.1
EVT_D14_CLAMP: D15.3 (COM), R17.2, U2.8 (A6)
EVT_D14_PI: J2.8, U2.12 (Y6)
EVT_D14_TPC: J1.15, R17.1
EVT_D15_CLAMP: D16.3 (COM), R18.2, U2.9 (A7)
EVT_D15_PI: J2.10, U2.11 (Y7)
EVT_D15_TPC: J1.16, R18.1
EVT_STROBE_CLAMP: D17.3 (COM), R19.2, U3.2 (A0)
EVT_STROBE_ISO: J4.1, R21.2, U5.7 (VO1)
EVT_STROBE_PI: J2.36, R20.1, U3.18 (Y0)
EVT_STROBE_TPC: J1.17, R19.1
ISO_5V: C5.1, C6.1, C8.1, C12.1, J7.1, R21.1, R23.1, R25.1, R27.1, U5.8 (VCC), U6.8 (VCC), U7.6 (+Vout)
ISO_GND: C5.2, C6.2, C8.2, C12.2, J7.2, U5.5 (GND), U6.5 (GND), U7.4 (-Vout)
OPTO_SPARE1_IN: J5.1, R24.1
OPTO_SPARE1_ISO: J4.3, R25.2, U6.7 (VO1)
OPTO_SPARE2_IN: J6.1, R26.1
OPTO_SPARE2_ISO: J4.4, R27.2, U6.6 (VO2)
U5_LED1: R20.2, U5.1 (A1)
U5_LED2: R22.2, U5.4 (A2)
U6_LED1: R24.2, U6.1 (A1)
U6_LED2: R26.2, U6.4 (A2)

Notes on the sheet:
looking for a HAT ID EEPROM. The 330R series resistors above limit contention
with that probe. Requires force_eeprom_read=0 in config.txt.
GPIO0/GPIO1 -- physical pins 27/28 -- are probed by the Pi as I2C at boot,

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
Board: 2 copper layers, 72 parts (0 on the bottom side), 70 nets, no tracks yet.
