jakewesterberg/wl-sync/hardware/breakout/sheets/analog-frontend.kicad_sch

## KiCad design hardware/breakout/sheets/analog-frontend.kicad_sch (2026-08-16)

Schematic: analog-frontend.kicad_sch

Parts:
C34, C35, C36, C37, C38, C39, C40, C41, C42, C43, C44, C45, C46, C47, C52, C53, C58, C59, C60, C61, C62, C63, C64, C65, C66, C67, C68, C69, C70, C71: 100nF; C_0603_1608Metric
C48, C50: 22pF; C_0603_1608Metric
C49, C51: 6.8nF; C_0603_1608Metric
C54: 1.2nF; C_0603_1608Metric
C55: 1.0nF; C_0603_1608Metric
C56: 1.5nF; C_0603_1608Metric
C57: 220pF; C_0603_1608Metric
D23, D24, D25, D26, D27, D28, D29, D30, D31, D32, D33, D34, D35, D36, D37, D38: BAT54S; SOT-23
J19: ACCES I/O USB-AO16-8A mating DB37 -- six eye chan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; DSUB-37_Pins_Horizontal_P2.77x2.84mm_EdgePinOffset9.90mm_Ho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
J20: Dual panel BNC: Photodiode 1 (passive, coax, phot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; BNC_Dual_RA_Isolated
J22: Dual panel BNC: Microphone (battery-powered, in b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; BNC_Dual_RA_Isolated
J24: Dual panel BNC: Accelerometer motion energy (batt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; BNC_Dual_RA_Isolated
J26: Dual panel BNC: Joystick Y (battery-powered, in b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; BNC_Dual_RA_Isolated
J28: Misc analog input 1 (panel BNC, /1//2 selectable)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; PinHeader_2x03_P2.54mm_Vertical
J29: Dual panel BNC: Misc analog input 2 (panel BNC, /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; BNC_Dual_RA_Isolated
J30: Misc analog input 2 (panel BNC, /1//2 selectable)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; PinHeader_2x03_P2.54mm_Vertical
J32: Misc analog input 3 (panel BNC, /1//2 selectable)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; PinHeader_2x03_P2.54mm_Vertical
R27, R35, R37, R43, R53, R55, R57, R59, R61, R67, R73: 10; R_0603_1608Metric
R28, R29, R30, R31, R32, R33, R34, R36, R42, R52, R54, R56, R58, R60, R66, R72: 1k; R_0603_1608Metric
R38, R40: 180k; R_0603_1608Metric
R39, R41: 1.6k; R_0603_1608Metric
R44, R45, R46, R47, R62, R63, R64, R65, R68, R69, R70, R71, R74, R75, R76, R77: 10.0k 0.1%; R_0603_1608Metric
R48, R49: 12.1k; R_0603_1608Metric
R50, R51: 23.2k; R_0603_1608Metric
R196, R197: DNP; R_0603_1608Metric; not fitted
U16, U17, U18, U19, U20, U21, U24, U25, U26, U27, U28, U29, U30: INA105KU; SOIC-8_3.9x4.9mm_P1.27mm
U22: OPA2197IDR; SOIC-8_3.9x4.9mm_P1.27mm
U23: OPA4197IDR; SOIC-14_3.9x8.7mm_P1.27mm

Connections:
+12V: C34.1, C36.1, C38.1, C40.1, C42.1, C44.1, C46.1, C52.1, C58.1, C60.1, C62.1, C64.1, C66.1, C68.1, C70.1, D23.2 (K), D24.2 (K), D25.2 (K), D26.2 (K), D27.2 (K), D28.2 (K), D29.2 (K), D30.2 (K), D31.2 (K), D32.2 (K), D33.2 (K), D34.2 (K), D35.2 (K), D36.2 (K), D37.2 (K), D38.2 (K), U16.7 (V+), U17.7 (V+), U18.7 (V+), U19.7 (V+), U20.7 (V+), U21.7 (V+), U22.8 (V+), U23.4 (V+), U24.7 (V+), U25.7 (V+), U26.7 (V+), U27.7 (V+), U28.7 (V+), U29.7 (V+), U30.7 (V+)
-12V: C35.1, C37.1, C39.1, C41.1, C43.1, C45.1, C47.1, C53.1, C59.1, C61.1, C63.1, C65.1, C67.1, C69.1, C71.1, D23.1 (A), D24.1 (A), D25.1 (A), D26.1 (A), D27.1 (A), D28.1 (A), D29.1 (A), D30.1 (A), D31.1 (A), D32.1 (A), D33.1 (A), D34.1 (A), D35.1 (A), D36.1 (A), D37.1 (A), D38.1 (A), U16.4 (V-), U17.4 (V-), U18.4 (V-), U19.4 (V-), U20.4 (V-), U21.4 (V-), U22.4 (V-), U23.11 (V-), U24.4 (V-), U25.4 (V-), U26.4 (V-), U27.4 (V-), U28.4 (V-), U29.4 (V-), U30.4 (V-)
ACCESIO_AGND: J19.1 (AGND), J19.2 (AGND), J19.3 (AGND), J19.4 (AGND), J19.5 (AGND), J19.6 (AGND), J19.7 (AGND), J19.8 (AGND), J19.9 (AGND), J19.10 (AGND), J19.11 (AGND), J19.12 (AGND), J19.13 (AGND), J19.14 (AGND), J19.15 (AGND), J19.16 (AGND), J19.17 (AGND), J19.18 (AGND), J19.19 (AGND), R27.1, U16.2 (-), U17.2 (-), U18.2 (-), U19.2 (-), U20.2 (-), U21.2 (-)
AGND: C34.2, C35.2, C36.2, C37.2, C38.2, C39.2, C40.2, C41.2, C42.2, C43.2, C44.2, C45.2, C46.2, C47.2, C49.2, C51.2, C52.2, C53.2, C55.2, C57.2, C58.2, C59.2, C60.2, C61.2, C62.2, C63.2, C64.2, C65.2, C66.2, C67.2, C68.2, C69.2, C70.2, C71.2, R27.2, R35.2, R37.2, R43.2, R47.2, R53.2, R55.2, R57.2, R59.2, R61.2, R63.2, R65.2, R67.2, R69.2, R71.2, R73.2, R75.2, R77.2, U16.1 (REF), U17.1 (REF), U18.1 (REF), U19.1 (REF), U20.1 (REF), U21.1 (REF), U23.12 (+), U24.1 (REF), U25.1 (REF), U26.1 (REF), U27.1 (REF), U28.1 (REF), U29.1 (REF), U30.1 (REF)
A_ACC: U25.5 (SENSE), U25.6
A_ACC_CLAMP: D33.3 (COM), R54.2, U25.3 (+)
A_ACC_RAW: J24.1 (A_In), R54.1
A_ACC_SHLD: J24.2 (A_Ext), R55.1, U25.2 (-)
A_AMB: U24.5 (SENSE), U24.6
A_AMB_CLAMP: D32.3 (COM), R52.2, U24.3 (+)
A_AMB_RAW: J22.3 (B_In), R52.1
A_AMB_SHLD: J22.4 (B_Ext), R53.1, U24.2 (-)
A_EYE_LP: U20.5 (SENSE), U20.6
A_EYE_LP_CLAMP: D27.3 (COM), R32.2, U20.3 (+)
A_EYE_LP_DAC: J19.24 (DAC4), R32.1
A_EYE_LX: U16.5 (SENSE), U16.6
A_EYE_LX_CLAMP: D23.3 (COM), R28.2, U16.3 (+)
A_EYE_LX_DAC: J19.20 (DAC0), R28.1
A_EYE_LY: U17.5 (SENSE), U17.6
A_EYE_LY_CLAMP: D24.3 (COM), R29.2, U17.3 (+)
A_EYE_LY_DAC: J19.21 (DAC1), R29.1
A_EYE_RP: U21.5 (SENSE), U21.6
A_EYE_RP_CLAMP: D28.3 (COM), R33.2, U21.3 (+)
A_EYE_RP_DAC: J19.25 (DAC5), R33.1
A_EYE_RX: U18.5 (SENSE), U18.6
A_EYE_RX_CLAMP: D25.3 (COM), R30.2, U18.3 (+)
A_EYE_RX_DAC: J19.22 (DAC2), R30.1
A_EYE_RY: U19.5 (SENSE), U19.6
A_EYE_RY_CLAMP: D26.3 (COM), R31.2, U19.3 (+)
A_EYE_RY_DAC: J19.23 (DAC3), R31.1
A_JOY_X: U26.5 (SENSE), U26.6
A_JOY_X_CLAMP: D34.3 (COM), R56.2, U26.3 (+)
A_JOY_X_RAW: J24.3 (B_In), R56.1
A_JOY_X_SHLD: J24.4 (B_Ext), R57.1, U26.2 (-)
A_JOY_Y: U27.5 (SENSE), U27.6
A_JOY_Y_CLAMP: D35.3 (COM), R58.2, U27.3 (+)
A_JOY_Y_RAW: J26.1 (A_In), R58.1
A_JOY_Y_SHLD: J26.2 (A_Ext), R59.1, U27.2 (-)
A_MIC: C56.2, U23.8, U23.9 (-)
A_MIC_CLAMP: D31.3 (COM), R42.2, R44.1
A_MIC_DA: R45.2, R48.1, U23.1
A_MIC_DAN: R44.2, R45.1, U23.2 (-)
A_MIC_DAP: R46.2, R47.1, U23.3 (+)
A_MIC_RAW: J22.1 (A_In), R42.1
A_MIC_S1: C54.2, R50.1, U23.6 (-), U23.7
A_MIC_S1_SKN: C54.1, R48.2, R49.1
A_MIC_S1_SKP: C55.1, R49.2, U23.5 (+)
A_MIC_SHLD: J22.2 (A_Ext), R43.1, R46.1
A_MIC_SKN: C56.1, R50.2, R51.1
A_MIC_SKP: C57.1, R51.2, U23.10 (+)
A_MIC_SPARE_FB: U23.13 (-), U23.14
A_MISC1: U28.5 (SENSE), U28.6
A_MISC1_CLAMP: D36.3 (COM), J28.1, R60.2, R62.1
A_MISC1_DIV: J28.3, U28.3 (+)
A_MISC1_MID: J28.5, R62.2, R63.1
A_MISC1_RAW: J26.3 (B_In), R60.1
A_MISC1_SHLD: J26.4 (B_Ext), J28.2, R61.1, R64.1
A_MISC1_SHLD_DIV: J28.4, U28.2 (-)
A_MISC1_SHLD_MID: J28.6, R64.2, R65.1
A_MISC2: U29.5 (SENSE), U29.6
A_MISC2_CLAMP: D37.3 (COM), J30.1, R66.2, R68.1
A_MISC2_DIV: J30.3, U29.3 (+)
A_MISC2_MID: J30.5, R68.2, R69.1
A_MISC2_RAW: J29.1 (A_In), R66.1
A_MISC2_SHLD: J29.2 (A_Ext), J30.2, R67.1, R70.1
A_MISC2_SHLD_DIV: J30.4, U29.2 (-)
A_MISC2_SHLD_MID: J30.6, R70.2, R71.1
A_MISC3: U30.5 (SENSE), U30.6
A_MISC3_CLAMP: D38.3 (COM), J32.1, R72.2, R74.1
A_MISC3_DIV: J32.3, U30.3 (+)
A_MISC3_MID: J32.5, R74.2, R75.1
A_MISC3_RAW: J29.3 (B_In), R72.1
A_MISC3_SHLD: J29.4 (B_Ext), J32.2, R73.1, R76.1
A_MISC3_SHLD_DIV: J32.4, U30.2 (-)
A_MISC3_SHLD_MID: J32.6, R76.2, R77.1
A_PD1: C49.1, R39.2
A_PD1_CLAMP: C48.2, D29.3 (COM), R34.2, R38.2, R196.2, U22.2 (-)
A_PD1_RAW: J20.1 (A_In), R34.1
A_PD1_RAWOUT: C48.1, R38.1, R39.1, R196.1, U22.1
A_PD1_SHLD: J20.2 (A_Ext), R35.1, U22.3 (+)
A_PD2: C51.1, R41.2
A_PD2_CLAMP: C50.2, D30.3 (COM), R36.2, R40.2, R197.2, U22.6 (-)
A_PD2_RAW: J20.3 (B_In), R36.1
A_PD2_RAWOUT: C50.1, R40.1, R41.1, R197.1, U22.7
A_PD2_SHLD: J20.4 (B_Ext), R37.1, U22.5 (+)

Notes on the sheet:
Analog front end (Task 10a) -- 16 sources, every one received DIFFERENTIALLY.
Consumes +12V/-12V/AGND (Task 7). Produces the 16 A_* nets below; Tasks 10b/10c/
10d (NI fan-out, mux+Intan diff-amps, comparators) consume them by this same
global-label name -- neither exists yet, but each net's own driving stage
already puts 2 pins on it (SENSE=OUTPUT / filter R+C midpoint / SK follower
feedback), so kicad-cli sch erc's isolated_pin_label check does not fire here
even without a downstream load -- see check_breakout_analog_frontend_netlist.py
and task-10a-report.md for the full ERC accounting.
WHY DIFFERENTIAL (spec Sec.5.6): the rig sits in a Faraday cage sound booth.
Sensors inside are battery powered so no mains conductor crosses the cage wall --
only signal, through a BNC shield. Whether the bulkhead bonds that shield to the
cage shell is UNDECIDED. If it does, circulating current in the shield (which is
also the signal return) would add straight onto the signal through a plain AGND-
referenced buffer. The shield cannot simply be lifted -- it IS the return path.
So every front end senses centre against shield AT THE CONNECTOR and a difference
amplifier turns the disturbance into common mode instead. This is what lets the
bulkhead decision be made, or reversed, later, without touching this board.
The six ACCESIO eye channels get the identical treatment against the ACCESIO's
own AGND pins (bonded to board AGND through ~10R, same as a BNC shell) -- it sits
on a separately-earthed eye-tracker PC, the same class of ground offset.
Common front end, every one of the 16 sources: isolated BNC (or ACCESIO DB37
pin) -> 1k series -> BAT54S clamp to +12V/-12V (protects the receiving op-amp's
own supply rails) -> source-specific back half below.
13 of 16 (6 ACCESIO eyes, ambient, accelerometer, joystick X/Y, misc x3): one
INA105KU per channel -- TI's monolithic precision unity-gain difference
amplifier (matched internal resistor network, REF pin lands the output on AGND
regardless of what the shield/ACCESIO_AGND reference is doing). Named
'INA134-class' in the brief; INA134 itself has no stock KiCad symbol and is an
audio-specific part -- INA105 fills the identical topological role and is a
real, current, hand-solderable TI part (same Value-substitution discipline as
the mule's SN74LVC541APW-on-74LS541-symbol precedent, hardware/README.md).
Photodiodes (A_PD1/A_PD2, spec Sec.6.3.1): PASSIVE, so the input stage is a
transimpedance amplifier, not a difference amp. Photodiode lives at the remote
sensor (not on this board, like the mic/accelerometer/joystick) -- cathode on
the coax centre (TIA summing junction, op-amp '-'), anode on the shield.
Non-inverting input ('+') is referenced to the LOCAL SHIELD, not AGND: feedback
forces the summing junction to track '+', so both photodiode terminals sit at
the shield's own local potential at every instant -- true photovoltaic (zero-
bias) operation survives a shield disturbance instead of that disturbance
appearing as a real bias voltage across the diode.
One OPA2197xD (dual, TI OPA197 family, CMOS input, ~10MHz GBW) covers both
channels. Rf=1M/Cf=3.3pF (Cf sized for 6m coax, ~600pF, via
Cf=sqrt(Cin/(2*pi*Rf*GBW)); closed-loop BW ~51.5kHz, comfortably above the
~10kHz these channels need -- spec's own 3-5m/300-500pF worked example lands
~57kHz the same way). Single-pole passive RC anti-alias low-pass follows
(1.6k/6.8nF, fc~14.6kHz) -- 'a low-pass that doubles as anti-aliasing'.
Microphone (A_MIC, spec Sec.6.4): NI X-series has no anti-alias filter and the
mic is the only broadband source. Cutoff is set by INTAN, not NI -- Intan
samples at 30kHz (Nyquist 15kHz), tighter than NI's 20kHz at a 40kHz scan; a
2nd-order section is only ~4dB down at 15kHz, hence 4th order: two Sallen-Key
sections 'on the buffer already present'. One OPA4197xD (quad) provides: unit 1
= discrete 4-resistor (10.0k 0.1%) unity-gain difference receiver (INA105 can't
fill this role -- its internal network can't be reconfigured into a filter);
units 2/3 = two cascaded unity-gain Sallen-Key low-pass sections, 4th-order
Butterworth at ~12kHz (Q1=0.5412/Q2=1.3066, standard cascade table; equal-R
design method -- see mic_channel()'s own docstring for the full component-value
derivation); unit 4 = spare, tied off ('+' to AGND, unity-gain follower).
Misc 1-3 (A_MISC1-3, spec Sec.6.1): board-wide analog convention is +-5V; misc
inputs additionally accept +-10V via switchable /1//2 attenuation, on BOTH legs
(fix round 1 -- task-10a-report.md: dividing the signal leg alone left half the
shield disturbance uncancelled in /2 mode). Each leg (signal = clamp node,
shield = shield node) gets its OWN matched pair of ALWAYS-PRESENT 10.0k 0.1%
resistors forming a fixed /2 tap to AGND.
FIX ROUND 2 (task-10b-report.md): both legs' own COMMON node (wired to the
amplifier) is bridged by a physical shunt to EITHER the raw node (direct = /1)
OR the /2 tap (/2) at assembly/field-reconfiguration time -- not a schematic-
level electrical fact, so every header pin is wired to its own distinct net here
and the bridge is left to the physical shunt. BOTH LEGS NOW SHARE ONE PHYSICAL
Conn_02x03 HEADER, populated with a SINGLE 2-GANG SHORTING BLOCK -- replacing
fix round 1's own two INDEPENDENT Conn_01x03 headers, which left it physically
possible (not just against instructions) for the two legs to disagree: a real
risk years from now when someone reconfigures a channel's range and forgets the
second jumper, silently re-creating the exact half-cancelled-shield-disturbance
defect fix round 1 closed out. NEVER populate this header with two independent
1-gang shunts -- that reintroduces the identical defect on a 2-column footprint.
FIX ROUND 3 (task-10b-report.md, this round): fix round 2's own PIN ASSIGNMENT
assumed the wrong physical geometry for the real PinHeader_2x03_P2.54mm_Vertical
footprint (row-paired, pin N adjacent to pin N+3) -- the real part is COLUMN-
paired instead (confirmed via kicad-cli fp export svg + kicad_pcb.py's own
footprint_pads()), which left NO shunt position on the real part achieving
'both legs at the same tap'. Symbol changed to Conn_02x03_Odd_Even, pins now
INTERLEAVED: column A (pins 1,3,5) = SIGNAL raw/div/mid, column B (pins 2,4,6) =
SHIELD raw/div/mid. Bridge pins 1-3 + 2-4 for x1 (direct), pins 3-5 + 4-6 for x2
(divider tap) -- STILL NEVER two independent 1-gang shunts.
Both dividers sit BEFORE the amplifier: INA105's own linear common-mode range
does not want a raw +-10V swing directly.
