jakewesterberg/wl-sync/hardware/breakout/sheets/analog-ni.kicad_sch

## KiCad design hardware/breakout/sheets/analog-ni.kicad_sch (2026-08-16)

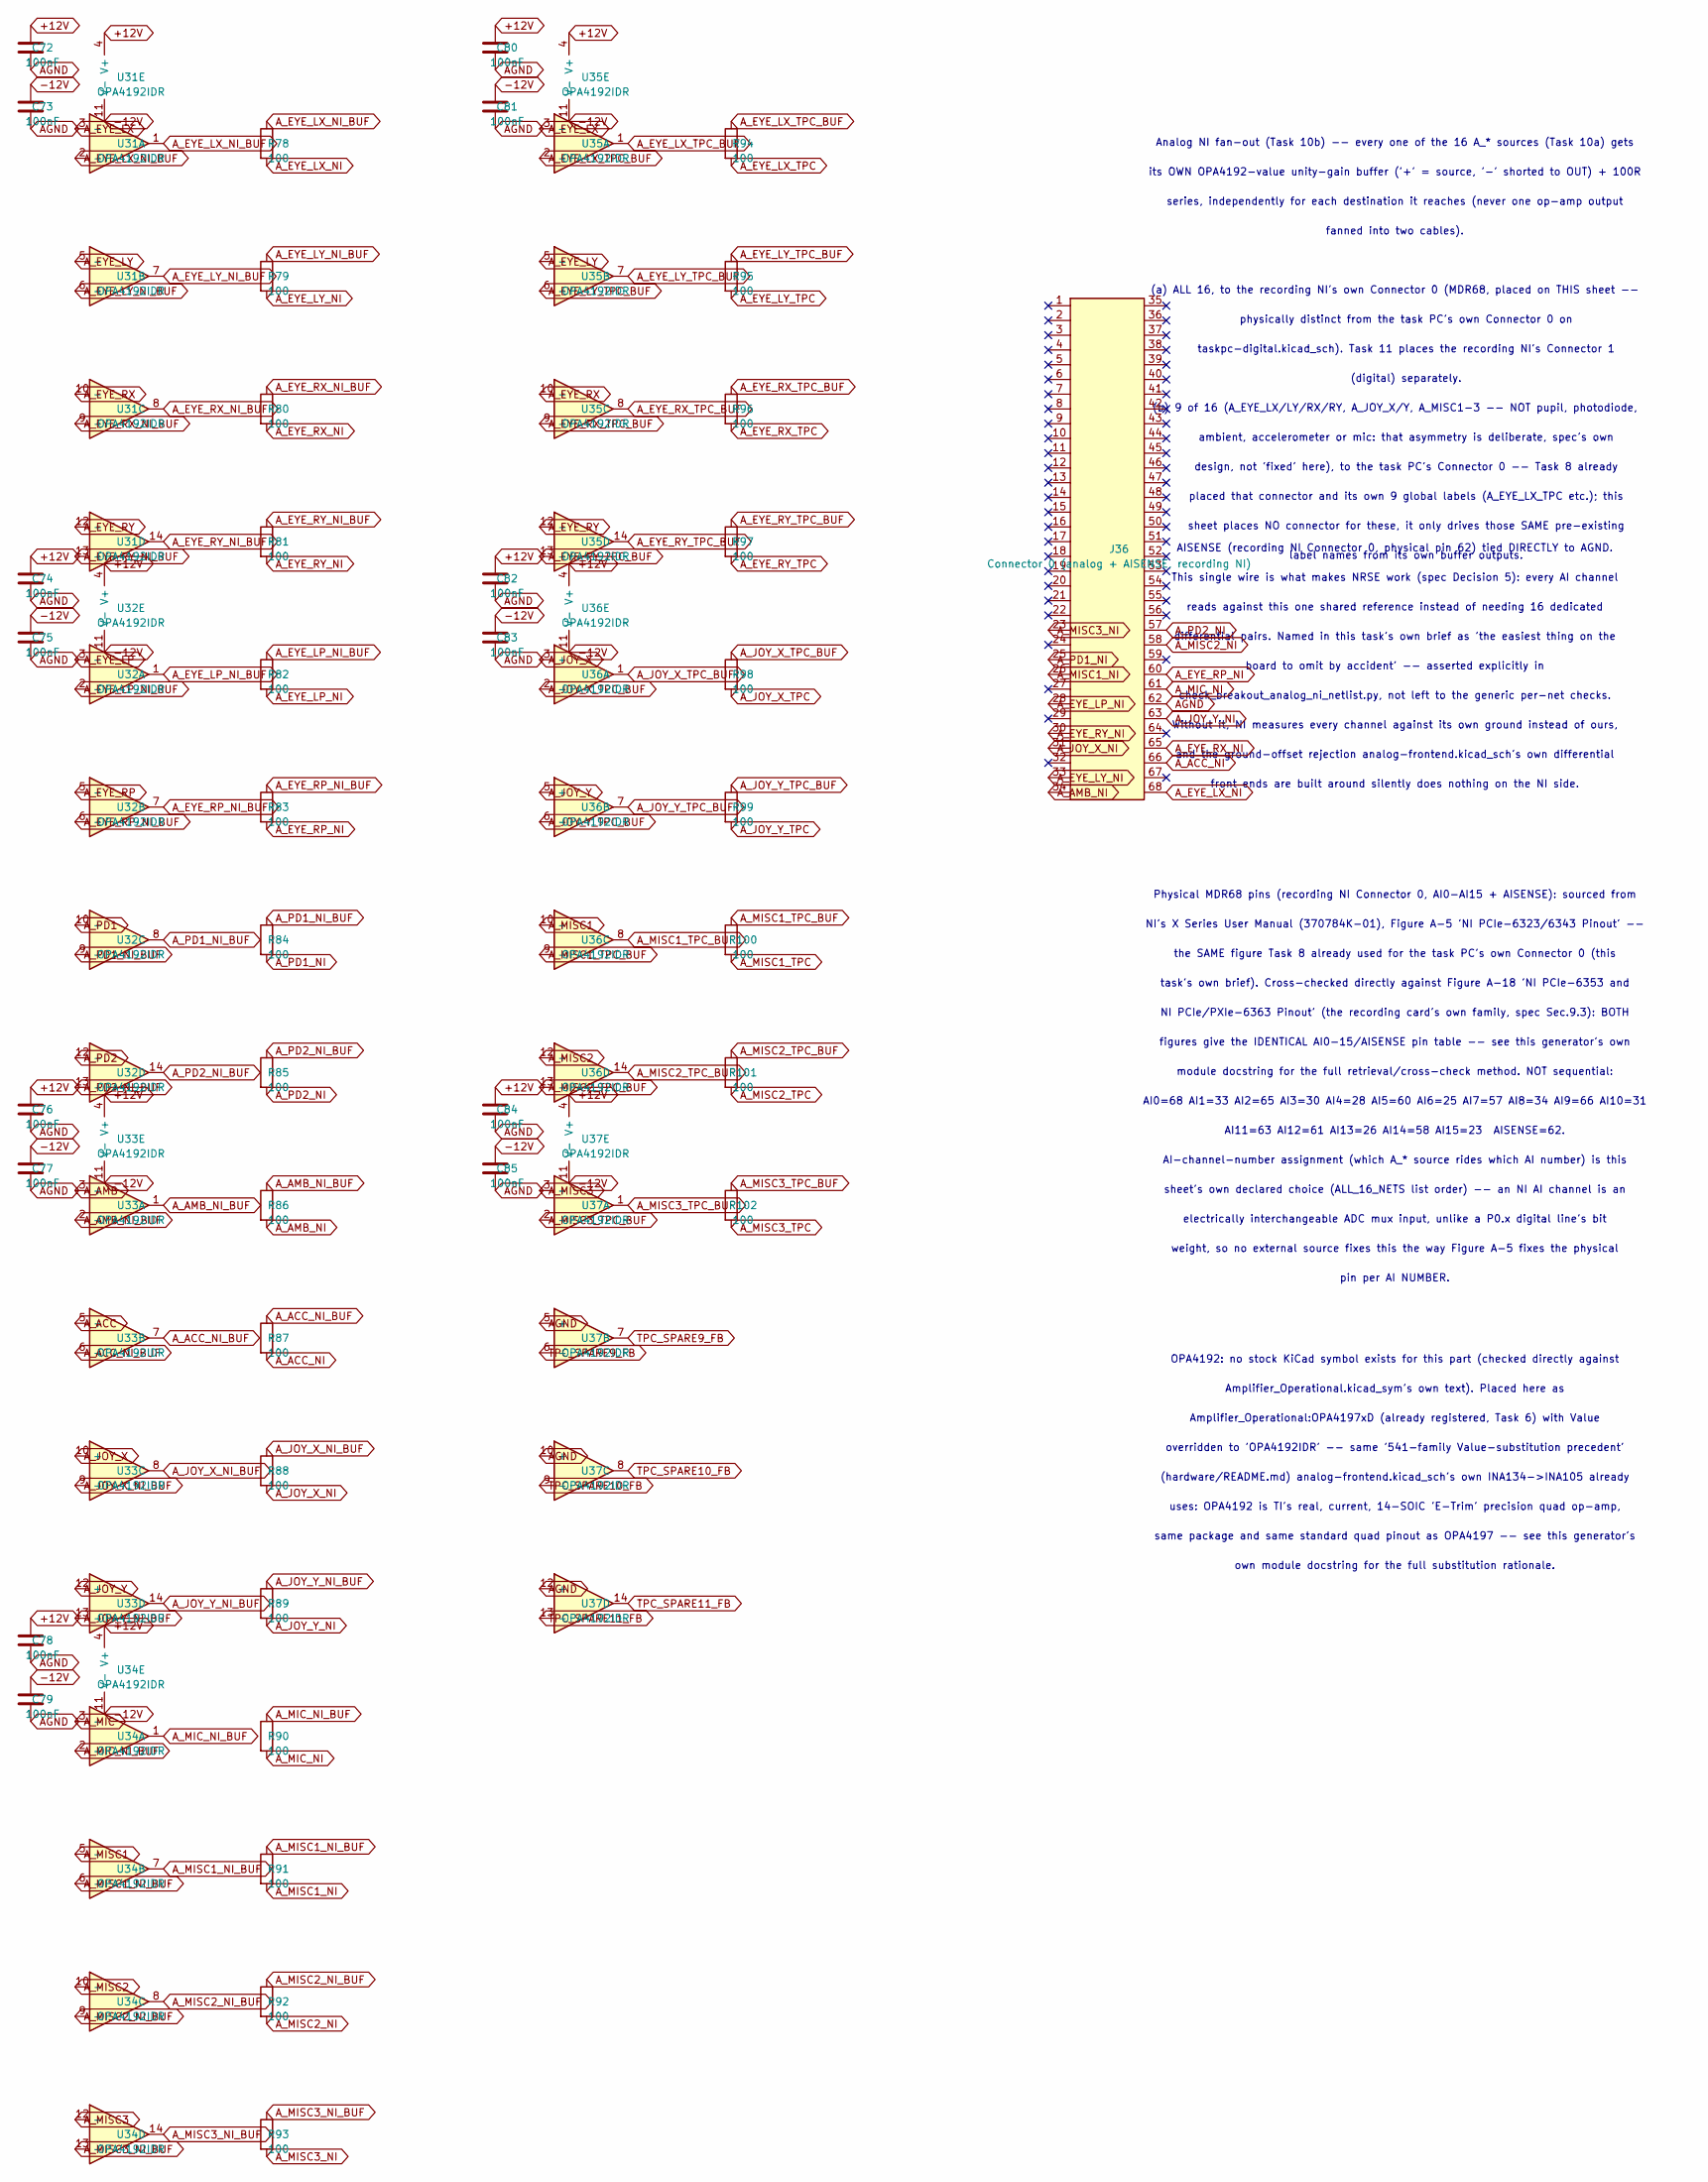
[picture p5: schematic analog-ni.kicad_sch]

Parts:
C72, C73, C74, C75, C76, C77, C78, C79, C80, C81, C82, C83, C84, C85: 100nF; C_0603_1608Metric
J36: Connector 0 (analog + AISENSE, recording NI); MDR68_Male_RightAngle
R78, R79, R80, R81, R82, R83, R84, R85, R86, R87, R88, R89, R90, R91, R92, R93, R94, R95, R96, R97, R98, R99, R100, R101, R102: 100; R_0603_1608Metric
U31, U32, U33, U34, U35, U36, U37: OPA4192IDR; SOIC-14_3.9x8.7mm_P1.27mm

Connections:
+12V: C72.1, C74.1, C76.1, C78.1, C80.1, C82.1, C84.1, U31.4 (V+), U32.4 (V+), U33.4 (V+), U34.4 (V+), U35.4 (V+), U36.4 (V+), U37.4 (V+)
-12V: C73.1, C75.1, C77.1, C79.1, C81.1, C83.1, C85.1, U31.11 (V-), U32.11 (V-), U33.11 (V-), U34.11 (V-), U35.11 (V-), U36.11 (V-), U37.11 (V-)
AGND: C72.2, C73.2, C74.2, C75.2, C76.2, C77.2, C78.2, C79.2, C80.2, C81.2, C82.2, C83.2, C84.2, C85.2, J36.62, U37.5 (+), U37.10 (+), U37.12 (+)
A_ACC: U33.5 (+)
A_ACC_NI: J36.66, R87.2
A_ACC_NI_BUF: R87.1, U33.6 (-), U33.7
A_AMB: U33.3 (+)
A_AMB_NI: J36.34, R86.2
A_AMB_NI_BUF: R86.1, U33.1, U33.2 (-)
A_EYE_LP: U32.3 (+)
A_EYE_LP_NI: J36.28, R82.2
A_EYE_LP_NI_BUF: R82.1, U32.1, U32.2 (-)
A_EYE_LX: U31.3 (+), U35.3 (+)
A_EYE_LX_NI: J36.68, R78.2
A_EYE_LX_NI_BUF: R78.1, U31.1, U31.2 (-)
A_EYE_LX_TPC: R94.2
A_EYE_LX_TPC_BUF: R94.1, U35.1, U35.2 (-)
A_EYE_LY: U31.5 (+), U35.5 (+)
A_EYE_LY_NI: J36.33, R79.2
A_EYE_LY_NI_BUF: R79.1, U31.6 (-), U31.7
A_EYE_LY_TPC: R95.2
A_EYE_LY_TPC_BUF: R95.1, U35.6 (-), U35.7
A_EYE_RP: U32.5 (+)
A_EYE_RP_NI: J36.60, R83.2
A_EYE_RP_NI_BUF: R83.1, U32.6 (-), U32.7
A_EYE_RX: U31.10 (+), U35.10 (+)
A_EYE_RX_NI: J36.65, R80.2
A_EYE_RX_NI_BUF: R80.1, U31.8, U31.9 (-)
A_EYE_RX_TPC: R96.2
A_EYE_RX_TPC_BUF: R96.1, U35.8, U35.9 (-)
A_EYE_RY: U31.12 (+), U35.12 (+)
A_EYE_RY_NI: J36.30, R81.2
A_EYE_RY_NI_BUF: R81.1, U31.13 (-), U31.14
A_EYE_RY_TPC: R97.2
A_EYE_RY_TPC_BUF: R97.1, U35.13 (-), U35.14
A_JOY_X: U33.10 (+), U36.3 (+)
A_JOY_X_NI: J36.31, R88.2
A_JOY_X_NI_BUF: R88.1, U33.8, U33.9 (-)
A_JOY_X_TPC: R98.2
A_JOY_X_TPC_BUF: R98.1, U36.1, U36.2 (-)
A_JOY_Y: U33.12 (+), U36.5 (+)
A_JOY_Y_NI: J36.63, R89.2
A_JOY_Y_NI_BUF: R89.1, U33.13 (-), U33.14
A_JOY_Y_TPC: R99.2
A_JOY_Y_TPC_BUF: R99.1, U36.6 (-), U36.7
A_MIC: U34.3 (+)
A_MIC_NI: J36.61, R90.2
A_MIC_NI_BUF: R90.1, U34.1, U34.2 (-)
A_MISC1: U34.5 (+), U36.10 (+)
A_MISC1_NI: J36.26, R91.2
A_MISC1_NI_BUF: R91.1, U34.6 (-), U34.7
A_MISC1_TPC: R100.2
A_MISC1_TPC_BUF: R100.1, U36.8, U36.9 (-)
A_MISC2: U34.10 (+), U36.12 (+)
A_MISC2_NI: J36.58, R92.2
A_MISC2_NI_BUF: R92.1, U34.8, U34.9 (-)
A_MISC2_TPC: R101.2
A_MISC2_TPC_BUF: R101.1, U36.13 (-), U36.14
A_MISC3: U34.12 (+), U37.3 (+)
A_MISC3_NI: J36.23, R93.2
A_MISC3_NI_BUF: R93.1, U34.13 (-), U34.14
A_MISC3_TPC: R102.2
A_MISC3_TPC_BUF: R102.1, U37.1, U37.2 (-)
A_PD1: U32.10 (+)
A_PD1_NI: J36.25, R84.2
A_PD1_NI_BUF: R84.1, U32.8, U32.9 (-)
A_PD2: U32.12 (+)
A_PD2_NI: J36.57, R85.2
A_PD2_NI_BUF: R85.1, U32.13 (-), U32.14
TPC_SPARE9_FB: U37.6 (-), U37.7
TPC_SPARE10_FB: U37.8, U37.9 (-)
TPC_SPARE11_FB: U37.13 (-), U37.14

Notes on the sheet:
Analog NI fan-out (Task 10b) -- every one of the 16 A_* sources (Task 10a) gets
its OWN OPA4192-value unity-gain buffer ('+' = source, '-' shorted to OUT) + 100R
series, independently for each destination it reaches (never one op-amp output
fanned into two cables).
(a) ALL 16, to the recording NI's own Connector 0 (MDR68, placed on THIS sheet --
physically distinct from the task PC's own Connector 0 on
taskpc-digital.kicad_sch). Task 11 places the recording NI's Connector 1
(digital) separately.
(b) 9 of 16 (A_EYE_LX/LY/RX/RY, A_JOY_X/Y, A_MISC1-3 -- NOT pupil, photodiode,
ambient, accelerometer or mic: that asymmetry is deliberate, spec's own
design, not 'fixed' here), to the task PC's Connector 0 -- Task 8 already
placed that connector and its own 9 global labels (A_EYE_LX_TPC etc.); this
sheet places NO connector for these, it only drives those SAME pre-existing
label names from its own buffer outputs.
AISENSE (recording NI Connector 0, physical pin 62) tied DIRECTLY to AGND.
This single wire is what makes NRSE work (spec Decision 5): every AI channel
reads against this one shared reference instead of needing 16 dedicated
differential pairs. Named in this task's own brief as 'the easiest thing on the
board to omit by accident' -- asserted explicitly in
check_breakout_analog_ni_netlist.py, not left to the generic per-net checks.
Without it, NI measures every channel against its own ground instead of ours,
and the ground-offset rejection analog-frontend.kicad_sch's own differential
front ends are built around silently does nothing on the NI side.
Physical MDR68 pins (recording NI Connector 0, AI0-AI15 + AISENSE): sourced from
NI's X Series User Manual (370784K-01), Figure A-5 'NI PCIe-6323/6343 Pinout' --
the SAME figure Task 8 already used for the task PC's own Connector 0 (this
task's own brief). Cross-checked directly against Figure A-18 'NI PCIe-6353 and
NI PCIe/PXIe-6363 Pinout' (the recording card's own family, spec Sec.9.3): BOTH
figures give the IDENTICAL AI0-15/AISENSE pin table -- see this generator's own
module docstring for the full retrieval/cross-check method. NOT sequential:
AI0=68 AI1=33 AI2=65 AI3=30 AI4=28 AI5=60 AI6=25 AI7=57 AI8=34 AI9=66 AI10=31
AI11=63 AI12=61 AI13=26 AI14=58 AI15=23 AISENSE=62.
AI-channel-number assignment (which A_* source rides which AI number) is this
sheet's own declared choice (ALL_16_NETS list order) -- an NI AI channel is an
electrically interchangeable ADC mux input, unlike a P0.x digital line's bit
weight, so no external source fixes this the way Figure A-5 fixes the physical
pin per AI NUMBER.
OPA4192: no stock KiCad symbol exists for this part (checked directly against
Amplifier_Operational.kicad_sym's own text). Placed here as
Amplifier_Operational:OPA4197xD (already registered, Task 6) with Value
overridden to 'OPA4192IDR' -- same '541-family Value-substitution precedent'
(hardware/README.md) analog-frontend.kicad_sch's own INA134->INA105 already
uses: OPA4192 is TI's real, current, 14-SOIC 'E-Trim' precision quad op-amp,
same package and same standard quad pinout as OPA4197 -- see this generator's
own module docstring for the full substitution rationale.
