jakewesterberg/wl-sync/hardware/breakout/sheets/comparators.kicad_sch

## KiCad design hardware/breakout/sheets/comparators.kicad_sch (2026-08-17)

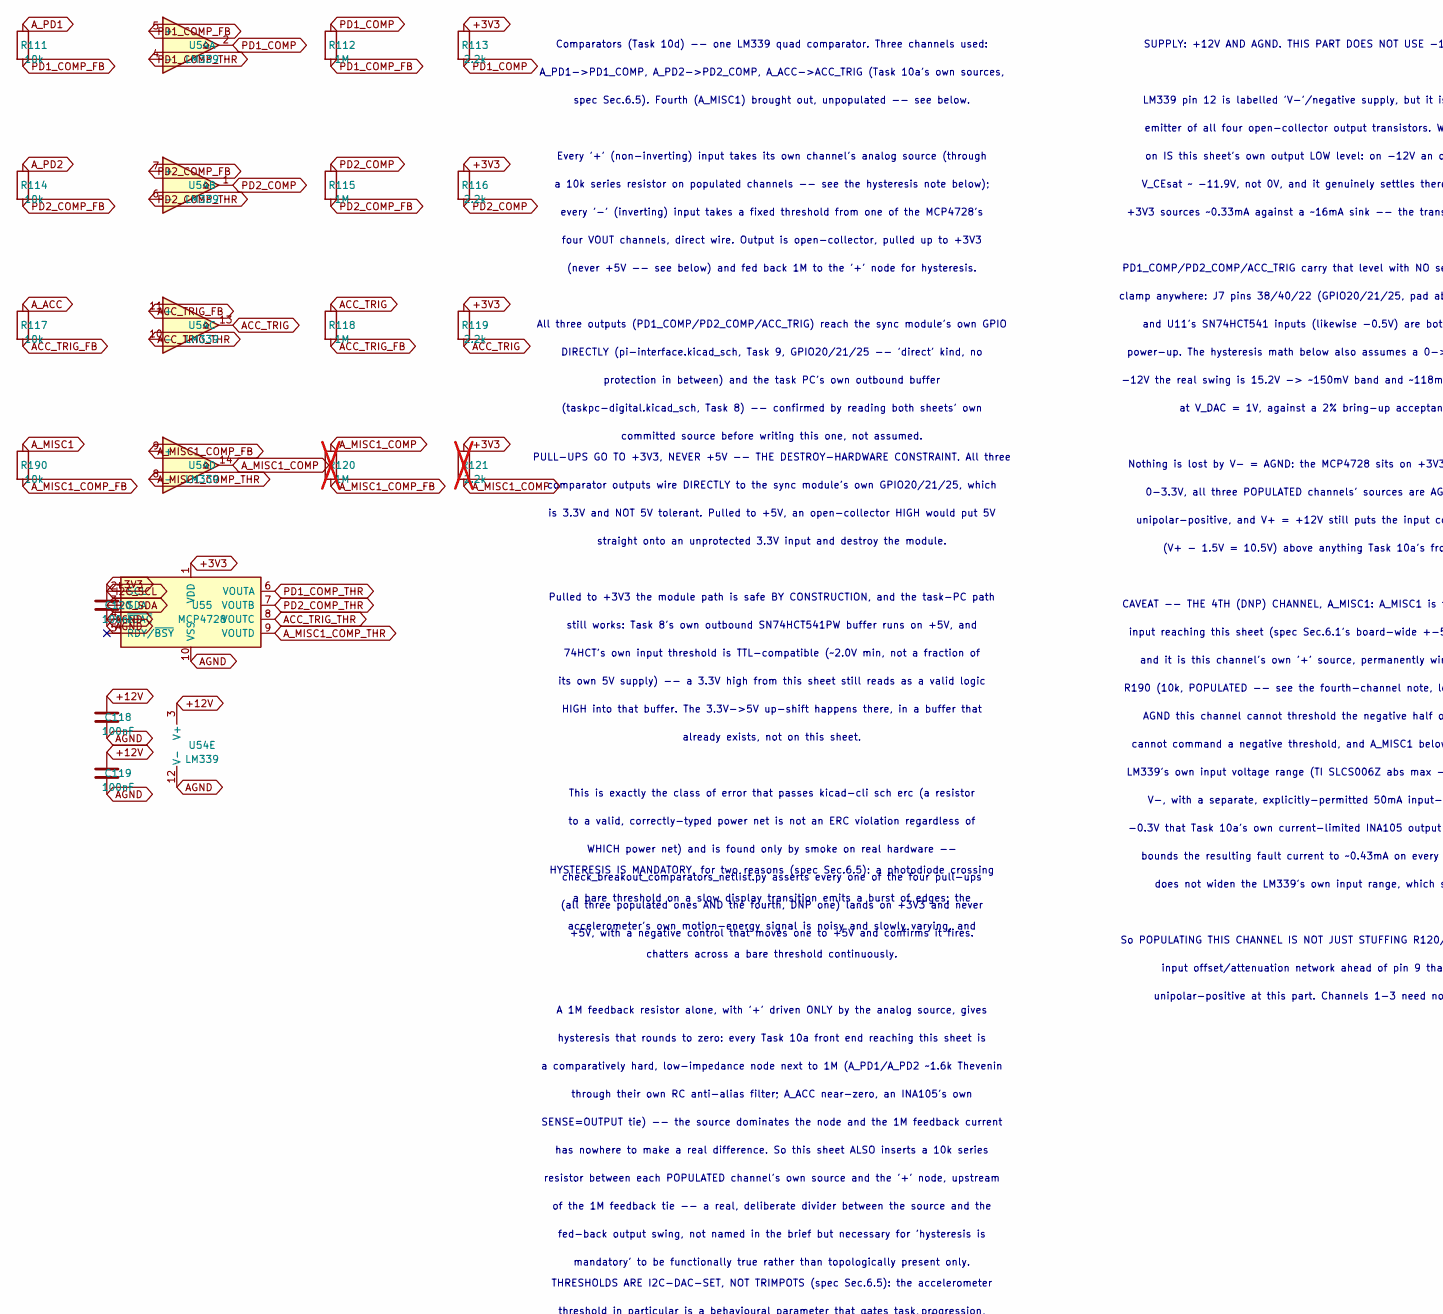
[picture p6: schematic comparators.kicad_sch, part in row 1, column 1]

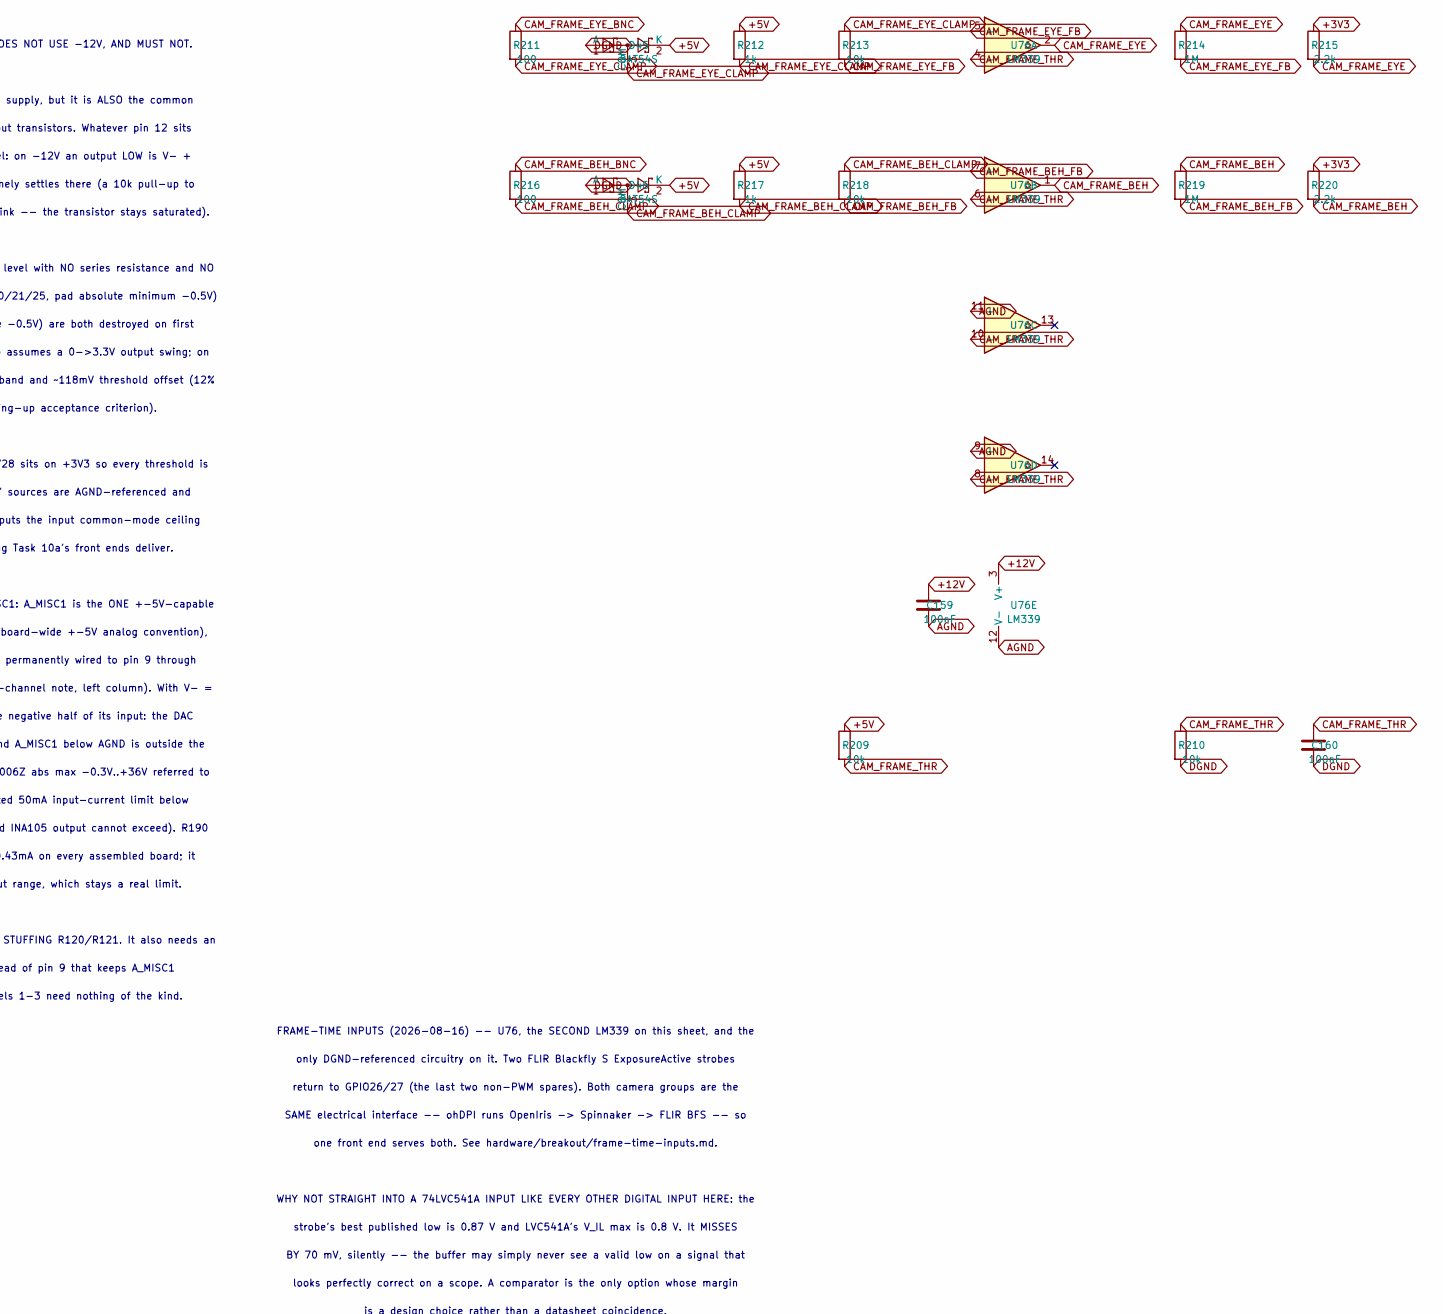
[picture p7: schematic comparators.kicad_sch, part in row 1, column 2]

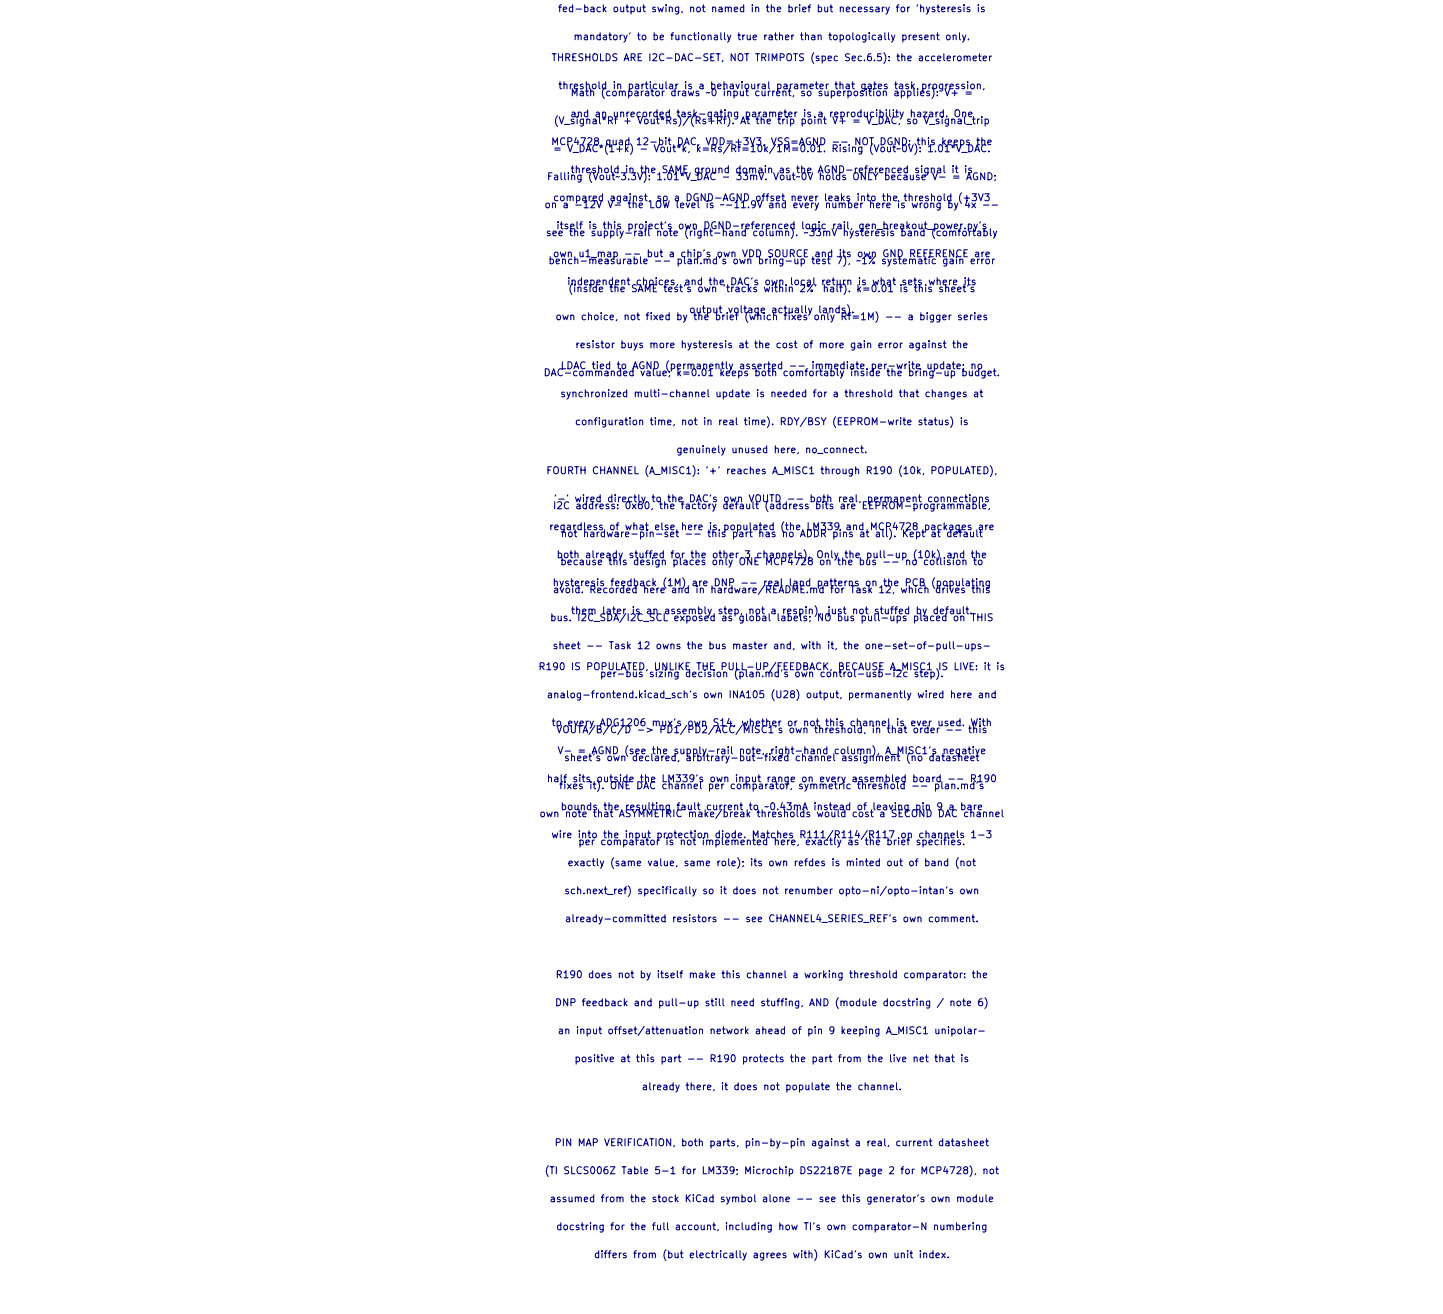
[picture p8: schematic comparators.kicad_sch, part in row 2, column 1]

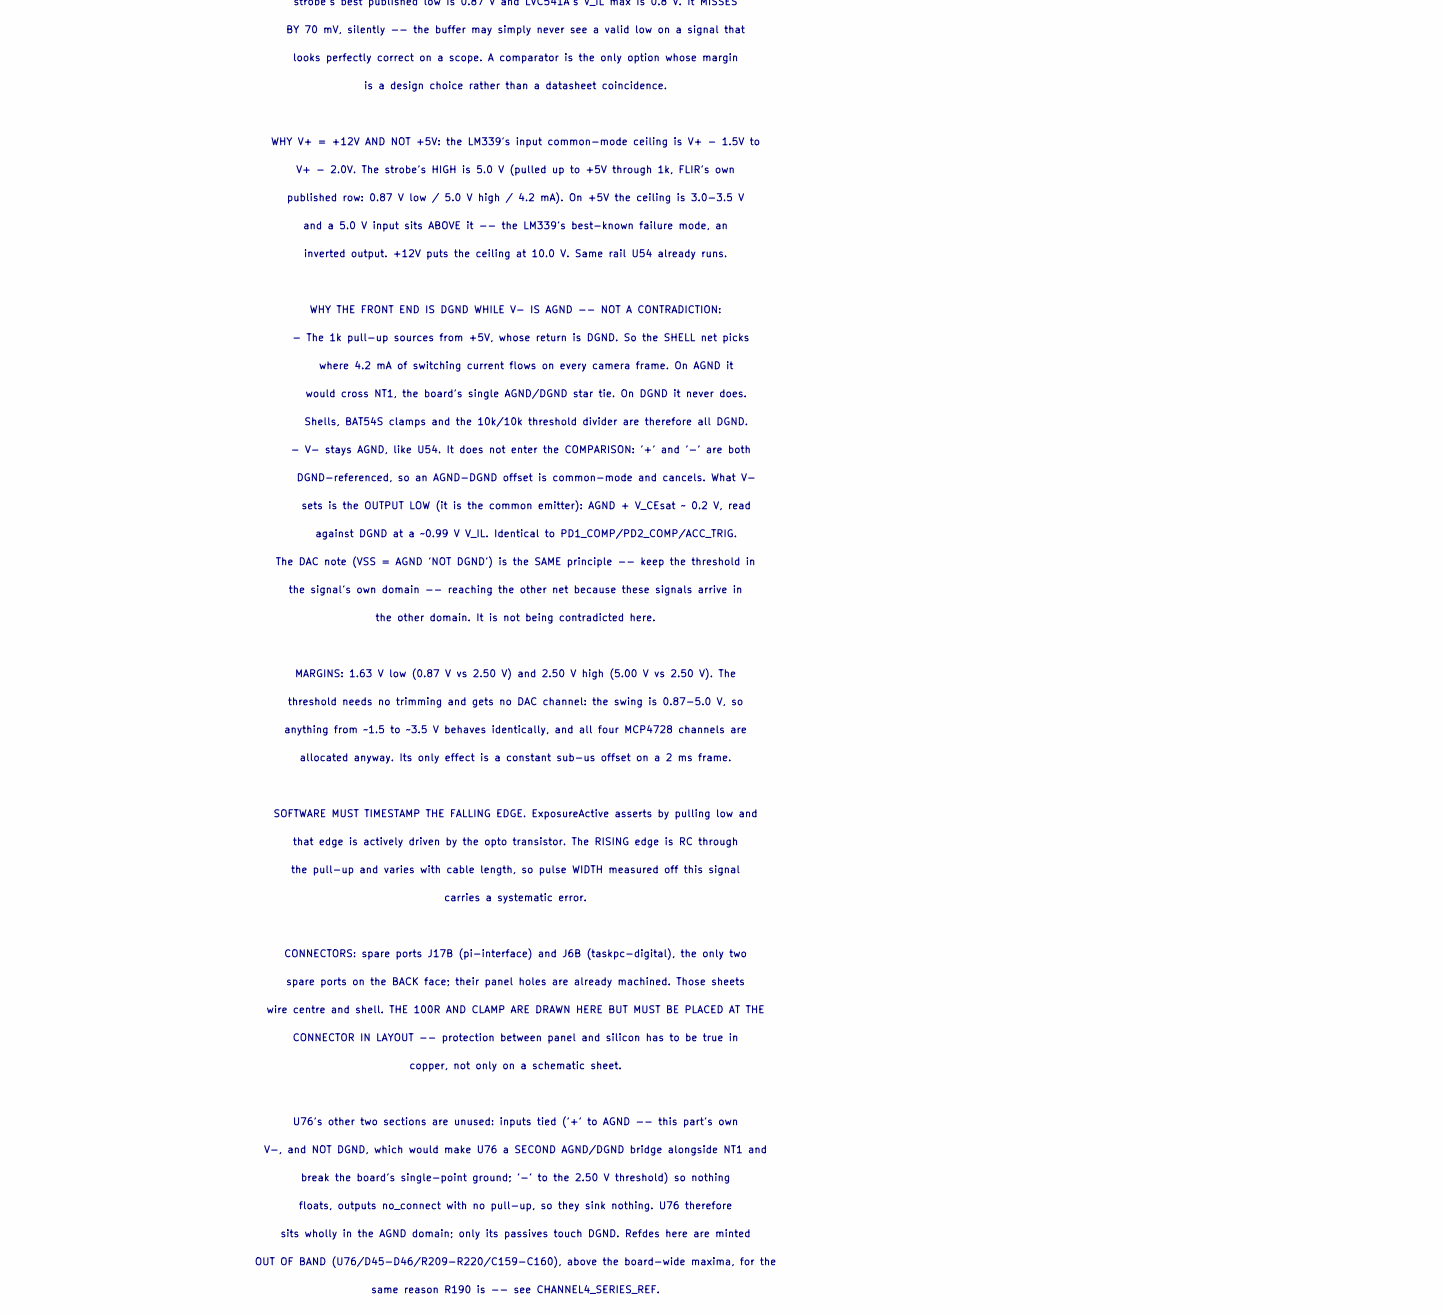
[picture p9: schematic comparators.kicad_sch, part in row 2, column 2]

Parts:
C118, C119, C120, C159, C160: 100nF; C_0603_1608Metric
D45, D46: BAT54S; SOT-23
R111, R114, R117, R190, R209, R210, R213, R218: 10k; R_0603_1608Metric
R112, R115, R118, R214, R219: 1M; R_0603_1608Metric
R113, R116, R119, R215, R220: 2.2k; R_0603_1608Metric
R120: 1M; R_0603_1608Metric; not fitted
R121: 2.2k; R_0603_1608Metric; not fitted
R211, R216: 100; R_0603_1608Metric
R212, R217: 1k; R_0603_1608Metric
U54, U76: LM339; SOIC-14_3.9x8.7mm_P1.27mm
U55: MCP4728; MSOP-10_3x3mm_P0.5mm

Connections:
+3V3: C120.1, R113.1, R116.1, R119.1, R121.1, R215.1, R220.1, U55.1 (VDD)
+5V: D45.2 (K), D46.2 (K), R209.1, R212.1, R217.1
+12V: C118.1, C119.1, C159.1, U54.3 (V+), U76.3 (V+)
ACC_TRIG: R118.1, R119.2, U54.13
ACC_TRIG_FB: R117.2, R118.2, U54.11 (+)
ACC_TRIG_THR: U54.10 (-), U55.8 (VOUTC)
AGND: C118.2, C119.2, C120.2, C159.2, U54.12 (V-), U55.4 (~LDAC), U55.10 (VSS), U76.9 (+), U76.11 (+), U76.12 (V-)
A_ACC: R117.1
A_MISC1: R190.1
A_MISC1_COMP: R120.1, R121.2, U54.14
A_MISC1_COMP_FB: R120.2, R190.2, U54.9 (+)
A_MISC1_COMP_THR: U54.8 (-), U55.9 (VOUTD)
A_PD1: R111.1
A_PD2: R114.1
CAM_FRAME_BEH: R219.1, R220.2, U76.1
CAM_FRAME_BEH_BNC: R216.1
CAM_FRAME_BEH_CLAMP: D46.3 (COM), R216.2, R217.2, R218.1
CAM_FRAME_BEH_FB: R218.2, R219.2, U76.7 (+)
CAM_FRAME_EYE: R214.1, R215.2, U76.2
CAM_FRAME_EYE_BNC: R211.1
CAM_FRAME_EYE_CLAMP: D45.3 (COM), R211.2, R212.2, R213.1
CAM_FRAME_EYE_FB: R213.2, R214.2, U76.5 (+)
CAM_FRAME_THR: C160.1, R209.2, R210.1, U76.4 (-), U76.6 (-), U76.8 (-), U76.10 (-)
DGND: C160.2, D45.1 (A), D46.1 (A), R210.2
I2C_SCL: U55.2 (SCL)
I2C_SDA: U55.3 (SDA)
PD1_COMP: R112.1, R113.2, U54.2
PD1_COMP_FB: R111.2, R112.2, U54.5 (+)
PD1_COMP_THR: U54.4 (-), U55.6 (VOUTA)
PD2_COMP: R115.1, R116.2, U54.1
PD2_COMP_FB: R114.2, R115.2, U54.7 (+)
PD2_COMP_THR: U54.6 (-), U55.7 (VOUTB)

Notes on the sheet:
Comparators (Task 10d) -- one LM339 quad comparator. Three channels used:
A_PD1->PD1_COMP, A_PD2->PD2_COMP, A_ACC->ACC_TRIG (Task 10a's own sources,
spec Sec.6.5). Fourth (A_MISC1) brought out, unpopulated -- see below.
Every '+' (non-inverting) input takes its own channel's analog source (through
a 10k series resistor on populated channels -- see the hysteresis note below);
every '-' (inverting) input takes a fixed threshold from one of the MCP4728's
four VOUT channels, direct wire. Output is open-collector, pulled up to +3V3
(never +5V -- see below) and fed back 1M to the '+' node for hysteresis.
All three outputs (PD1_COMP/PD2_COMP/ACC_TRIG) reach the sync module's own GPIO
DIRECTLY (pi-interface.kicad_sch, Task 9, GPIO20/21/25 -- 'direct' kind, no
protection in between) and the task PC's own outbound buffer
(taskpc-digital.kicad_sch, Task 8) -- confirmed by reading both sheets' own
committed source before writing this one, not assumed.
PULL-UPS GO TO +3V3, NEVER +5V -- THE DESTROY-HARDWARE CONSTRAINT. All three
comparator outputs wire DIRECTLY to the sync module's own GPIO20/21/25, which
is 3.3V and NOT 5V tolerant. Pulled to +5V, an open-collector HIGH would put 5V
straight onto an unprotected 3.3V input and destroy the module.
Pulled to +3V3 the module path is safe BY CONSTRUCTION, and the task-PC path
still works: Task 8's own outbound SN74HCT541PW buffer runs on +5V, and
74HCT's own input threshold is TTL-compatible (~2.0V min, not a fraction of
its own 5V supply) -- a 3.3V high from this sheet still reads as a valid logic
HIGH into that buffer. The 3.3V->5V up-shift happens there, in a buffer that
already exists, not on this sheet.
This is exactly the class of error that passes kicad-cli sch erc (a resistor
to a valid, correctly-typed power net is not an ERC violation regardless of
WHICH power net) and is found only by smoke on real hardware --
check_breakout_comparators_netlist.py asserts every one of the four pull-ups
(all three populated ones AND the fourth, DNP one) lands on +3V3 and never
+5V, with a negative control that moves one to +5V and confirms it fires.
HYSTERESIS IS MANDATORY, for two reasons (spec Sec.6.5): a photodiode crossing
a bare threshold on a slow display transition emits a burst of edges; the
accelerometer's own motion-energy signal is noisy and slowly varying, and
chatters across a bare threshold continuously.
A 1M feedback resistor alone, with '+' driven ONLY by the analog source, gives
hysteresis that rounds to zero: every Task 10a front end reaching this sheet is
a comparatively hard, low-impedance node next to 1M (A_PD1/A_PD2 ~1.6k Thevenin
through their own RC anti-alias filter; A_ACC near-zero, an INA105's own
SENSE=OUTPUT tie) -- the source dominates the node and the 1M feedback current
has nowhere to make a real difference. So this sheet ALSO inserts a 10k series
resistor between each POPULATED channel's own source and the '+' node, upstream
of the 1M feedback tie -- a real, deliberate divider between the source and the
fed-back output swing, not named in the brief but necessary for 'hysteresis is
mandatory' to be functionally true rather than topologically present only.
Math (comparator draws ~0 input current, so superposition applies): V+ =
(V_signal*Rf + Vout*Rs)/(Rs+Rf). At the trip point V+ = V_DAC, so V_signal_trip
= V_DAC*(1+k) - Vout*k, k=Rs/Rf=10k/1M=0.01. Rising (Vout~0V): 1.01*V_DAC.
Falling (Vout~3.3V): 1.01*V_DAC - 33mV. Vout~0V holds ONLY because V- = AGND;
on a -12V V- the LOW level is ~-11.9V and every number here is wrong by 4x --
see the supply-rail note (right-hand column). ~33mV hysteresis band (comfortably
bench-measurable -- plan.md's own bring-up test 7), ~1% systematic gain error
(inside the SAME test's own 'tracks within 2%' half). k=0.01 is this sheet's
own choice, not fixed by the brief (which fixes only Rf=1M) -- a bigger series
resistor buys more hysteresis at the cost of more gain error against the
DAC-commanded value; k=0.01 keeps both comfortably inside the bring-up budget.
THRESHOLDS ARE I2C-DAC-SET, NOT TRIMPOTS (spec Sec.6.5): the accelerometer
threshold in particular is a behavioural parameter that gates task progression,
and an unrecorded task-gating parameter is a reproducibility hazard. One
MCP4728 quad 12-bit DAC, VDD=+3V3, VSS=AGND -- NOT DGND: this keeps the
threshold in the SAME ground domain as the AGND-referenced signal it is
compared against, so a DGND-AGND offset never leaks into the threshold (+3V3
itself is this project's own DGND-referenced logic rail, gen_breakout_power.py's
own u1_map -- but a chip's own VDD SOURCE and its own GND REFERENCE are
independent choices, and the DAC's own local return is what sets where its
output voltage actually lands).
LDAC tied to AGND (permanently asserted -- immediate per-write update; no
synchronized multi-channel update is needed for a threshold that changes at
configuration time, not in real time). RDY/BSY (EEPROM-write status) is
genuinely unused here, no_connect.
I2C address: 0x60, the factory default (address bits are EEPROM-programmable,
not hardware-pin-set -- this part has no ADDR pins at all). Kept at default
because this design places only ONE MCP4728 on the bus -- no collision to
avoid. Recorded here and in hardware/README.md for Task 12, which drives this
bus. I2C_SDA/I2C_SCL exposed as global labels; NO bus pull-ups placed on THIS
sheet -- Task 12 owns the bus master and, with it, the one-set-of-pull-ups-
per-bus sizing decision (plan.md's own control-usb-i2c step).
VOUTA/B/C/D -> PD1/PD2/ACC/MISC1's own threshold, in that order -- this
sheet's own declared, arbitrary-but-fixed channel assignment (no datasheet
fixes it). ONE DAC channel per comparator, symmetric threshold -- plan.md's
own note that ASYMMETRIC make/break thresholds would cost a SECOND DAC channel
per comparator is not implemented here, exactly as the brief specifies.
FOURTH CHANNEL (A_MISC1): '+' reaches A_MISC1 through R190 (10k, POPULATED),
'-' wired directly to the DAC's own VOUTD -- both real, permanent connections
regardless of what else here is populated (the LM339 and MCP4728 packages are
both already stuffed for the other 3 channels). Only the pull-up (10k) and the
hysteresis feedback (1M) are DNP -- real land patterns on the PCB (populating
them later is an assembly step, not a respin), just not stuffed by default.
R190 IS POPULATED, UNLIKE THE PULL-UP/FEEDBACK, BECAUSE A_MISC1 IS LIVE: it is
analog-frontend.kicad_sch's own INA105 (U28) output, permanently wired here and
to every ADG1206 mux's own S14, whether or not this channel is ever used. With
V- = AGND (see the supply-rail note, right-hand column), A_MISC1's negative
half sits outside the LM339's own input range on every assembled board -- R190
bounds the resulting fault current to ~0.43mA instead of leaving pin 9 a bare
wire into the input protection diode. Matches R111/R114/R117 on channels 1-3
exactly (same value, same role); its own refdes is minted out of band (not
sch.next_ref) specifically so it does not renumber opto-ni/opto-intan's own
already-committed resistors -- see CHANNEL4_SERIES_REF's own comment.
R190 does not by itself make this channel a working threshold comparator: the
DNP feedback and pull-up still need stuffing, AND (module docstring / note 6)
an input offset/attenuation network ahead of pin 9 keeping A_MISC1 unipolar-
positive at this part -- R190 protects the part from the live net that is
already there, it does not populate the channel.
PIN MAP VERIFICATION, both parts, pin-by-pin against a real, current datasheet
(TI SLCS006Z Table 5-1 for LM339; Microchip DS22187E page 2 for MCP4728), not
assumed from the stock KiCad symbol alone -- see this generator's own module
docstring for the full account, including how TI's own comparator-N numbering
differs from (but electrically agrees with) KiCad's own unit index.
SUPPLY: +12V AND AGND. THIS PART DOES NOT USE -12V, AND MUST NOT.
LM339 pin 12 is labelled 'V-'/negative supply, but it is ALSO the common
emitter of all four open-collector output transistors. Whatever pin 12 sits
on IS this sheet's own output LOW level: on -12V an output LOW is V- +
V_CEsat ~ -11.9V, not 0V, and it genuinely settles there (a 10k pull-up to
+3V3 sources ~0.33mA against a ~16mA sink -- the transistor stays saturated).
PD1_COMP/PD2_COMP/ACC_TRIG carry that level with NO series resistance and NO
clamp anywhere: J7 pins 38/40/22 (GPIO20/21/25, pad absolute minimum -0.5V)
and U11's SN74HCT541 inputs (likewise -0.5V) are both destroyed on first
power-up. The hysteresis math below also assumes a 0->3.3V output swing; on
-12V the real swing is 15.2V -> ~150mV band and ~118mV threshold offset (12%
at V_DAC = 1V, against a 2% bring-up acceptance criterion).
Nothing is lost by V- = AGND: the MCP4728 sits on +3V3 so every threshold is
0-3.3V, all three POPULATED channels' sources are AGND-referenced and
unipolar-positive, and V+ = +12V still puts the input common-mode ceiling
(V+ - 1.5V = 10.5V) above anything Task 10a's front ends deliver.
CAVEAT -- THE 4TH (DNP) CHANNEL, A_MISC1: A_MISC1 is the ONE +-5V-capable
input reaching this sheet (spec Sec.6.1's board-wide +-5V analog convention),
and it is this channel's own '+' source, permanently wired to pin 9 through
R190 (10k, POPULATED -- see the fourth-channel note, left column). With V- =
AGND this channel cannot threshold the negative half of its input: the DAC
cannot command a negative threshold, and A_MISC1 below AGND is outside the
LM339's own input voltage range (TI SLCS006Z abs max -0.3V..+36V referred to
V-, with a separate, explicitly-permitted 50mA input-current limit below
-0.3V that Task 10a's own current-limited INA105 output cannot exceed). R190
bounds the resulting fault current to ~0.43mA on every assembled board; it
does not widen the LM339's own input range, which stays a real limit.
So POPULATING THIS CHANNEL IS NOT JUST STUFFING R120/R121. It also needs an
input offset/attenuation network ahead of pin 9 that keeps A_MISC1
unipolar-positive at this part. Channels 1-3 need nothing of the kind.
FRAME-TIME INPUTS (2026-08-16) -- U76, the SECOND LM339 on this sheet, and the
only DGND-referenced circuitry on it. Two FLIR Blackfly S ExposureActive strobes
return to GPIO26/27 (the last two non-PWM spares). Both camera groups are the
SAME electrical interface -- ohDPI runs OpenIris -> Spinnaker -> FLIR BFS -- so
one front end serves both. See hardware/breakout/frame-time-inputs.md.
WHY NOT STRAIGHT INTO A 74LVC541A INPUT LIKE EVERY OTHER DIGITAL INPUT HERE: the
strobe's best published low is 0.87 V and LVC541A's V_IL max is 0.8 V. It MISSES
BY 70 mV, silently -- the buffer may simply never see a valid low on a signal that
looks perfectly correct on a scope. A comparator is the only option whose margin
is a design choice rather than a datasheet coincidence.
WHY V+ = +12V AND NOT +5V: the LM339's input common-mode ceiling is V+ - 1.5V to
V+ - 2.0V. The strobe's HIGH is 5.0 V (pulled up to +5V through 1k, FLIR's own
published row: 0.87 V low / 5.0 V high / 4.2 mA). On +5V the ceiling is 3.0-3.5 V
and a 5.0 V input sits ABOVE it -- the LM339's best-known failure mode, an
inverted output. +12V puts the ceiling at 10.0 V. Same rail U54 already runs.
WHY THE FRONT END IS DGND WHILE V- IS AGND -- NOT A CONTRADICTION:
- The 1k pull-up sources from +5V, whose return is DGND. So the SHELL net picks
where 4.2 mA of switching current flows on every camera frame. On AGND it
would cross NT1, the board's single AGND/DGND star tie. On DGND it never does.
Shells, BAT54S clamps and the 10k/10k threshold divider are therefore all DGND.
- V- stays AGND, like U54. It does not enter the COMPARISON: '+' and '-' are both
DGND-referenced, so an AGND-DGND offset is common-mode and cancels. What V-
sets is the OUTPUT LOW (it is the common emitter): AGND + V_CEsat ~ 0.2 V, read
against DGND at a ~0.99 V V_IL. Identical to PD1_COMP/PD2_COMP/ACC_TRIG.
The DAC note (VSS = AGND 'NOT DGND') is the SAME principle -- keep the threshold in
the signal's own domain -- reaching the other net because these signals arrive in
the other domain. It is not being contradicted here.
MARGINS: 1.63 V low (0.87 V vs 2.50 V) and 2.50 V high (5.00 V vs 2.50 V). The
threshold needs no trimming and gets no DAC channel: the swing is 0.87-5.0 V, so
anything from ~1.5 to ~3.5 V behaves identically, and all four MCP4728 channels are
allocated anyway. Its only effect is a constant sub-us offset on a 2 ms frame.
SOFTWARE MUST TIMESTAMP THE FALLING EDGE. ExposureActive asserts by pulling low and
that edge is actively driven by the opto transistor. The RISING edge is RC through
the pull-up and varies with cable length, so pulse WIDTH measured off this signal
carries a systematic error.
CONNECTORS: spare ports J17B (pi-interface) and J6B (taskpc-digital), the only two
spare ports on the BACK face; their panel holes are already machined. Those sheets
wire centre and shell. THE 100R AND CLAMP ARE DRAWN HERE BUT MUST BE PLACED AT THE
CONNECTOR IN LAYOUT -- protection between panel and silicon has to be true in
copper, not only on a schematic sheet.
U76's other two sections are unused: inputs tied ('+' to AGND -- this part's own
V-, and NOT DGND, which would make U76 a SECOND AGND/DGND bridge alongside NT1 and
break the board's single-point ground; '-' to the 2.50 V threshold) so nothing
floats, outputs no_connect with no pull-up, so they sink nothing. U76 therefore
sits wholly in the AGND domain; only its passives touch DGND. Refdes here are minted
OUT OF BAND (U76/D45-D46/R209-R220/C159-C160), above the board-wide maxima, for the
same reason R190 is -- see CHANNEL4_SERIES_REF.
