jakewesterberg/wl-sync/hardware/breakout/sheets/control-usb-i2c.kicad_sch

## KiCad design hardware/breakout/sheets/control-usb-i2c.kicad_sch (2026-08-16)

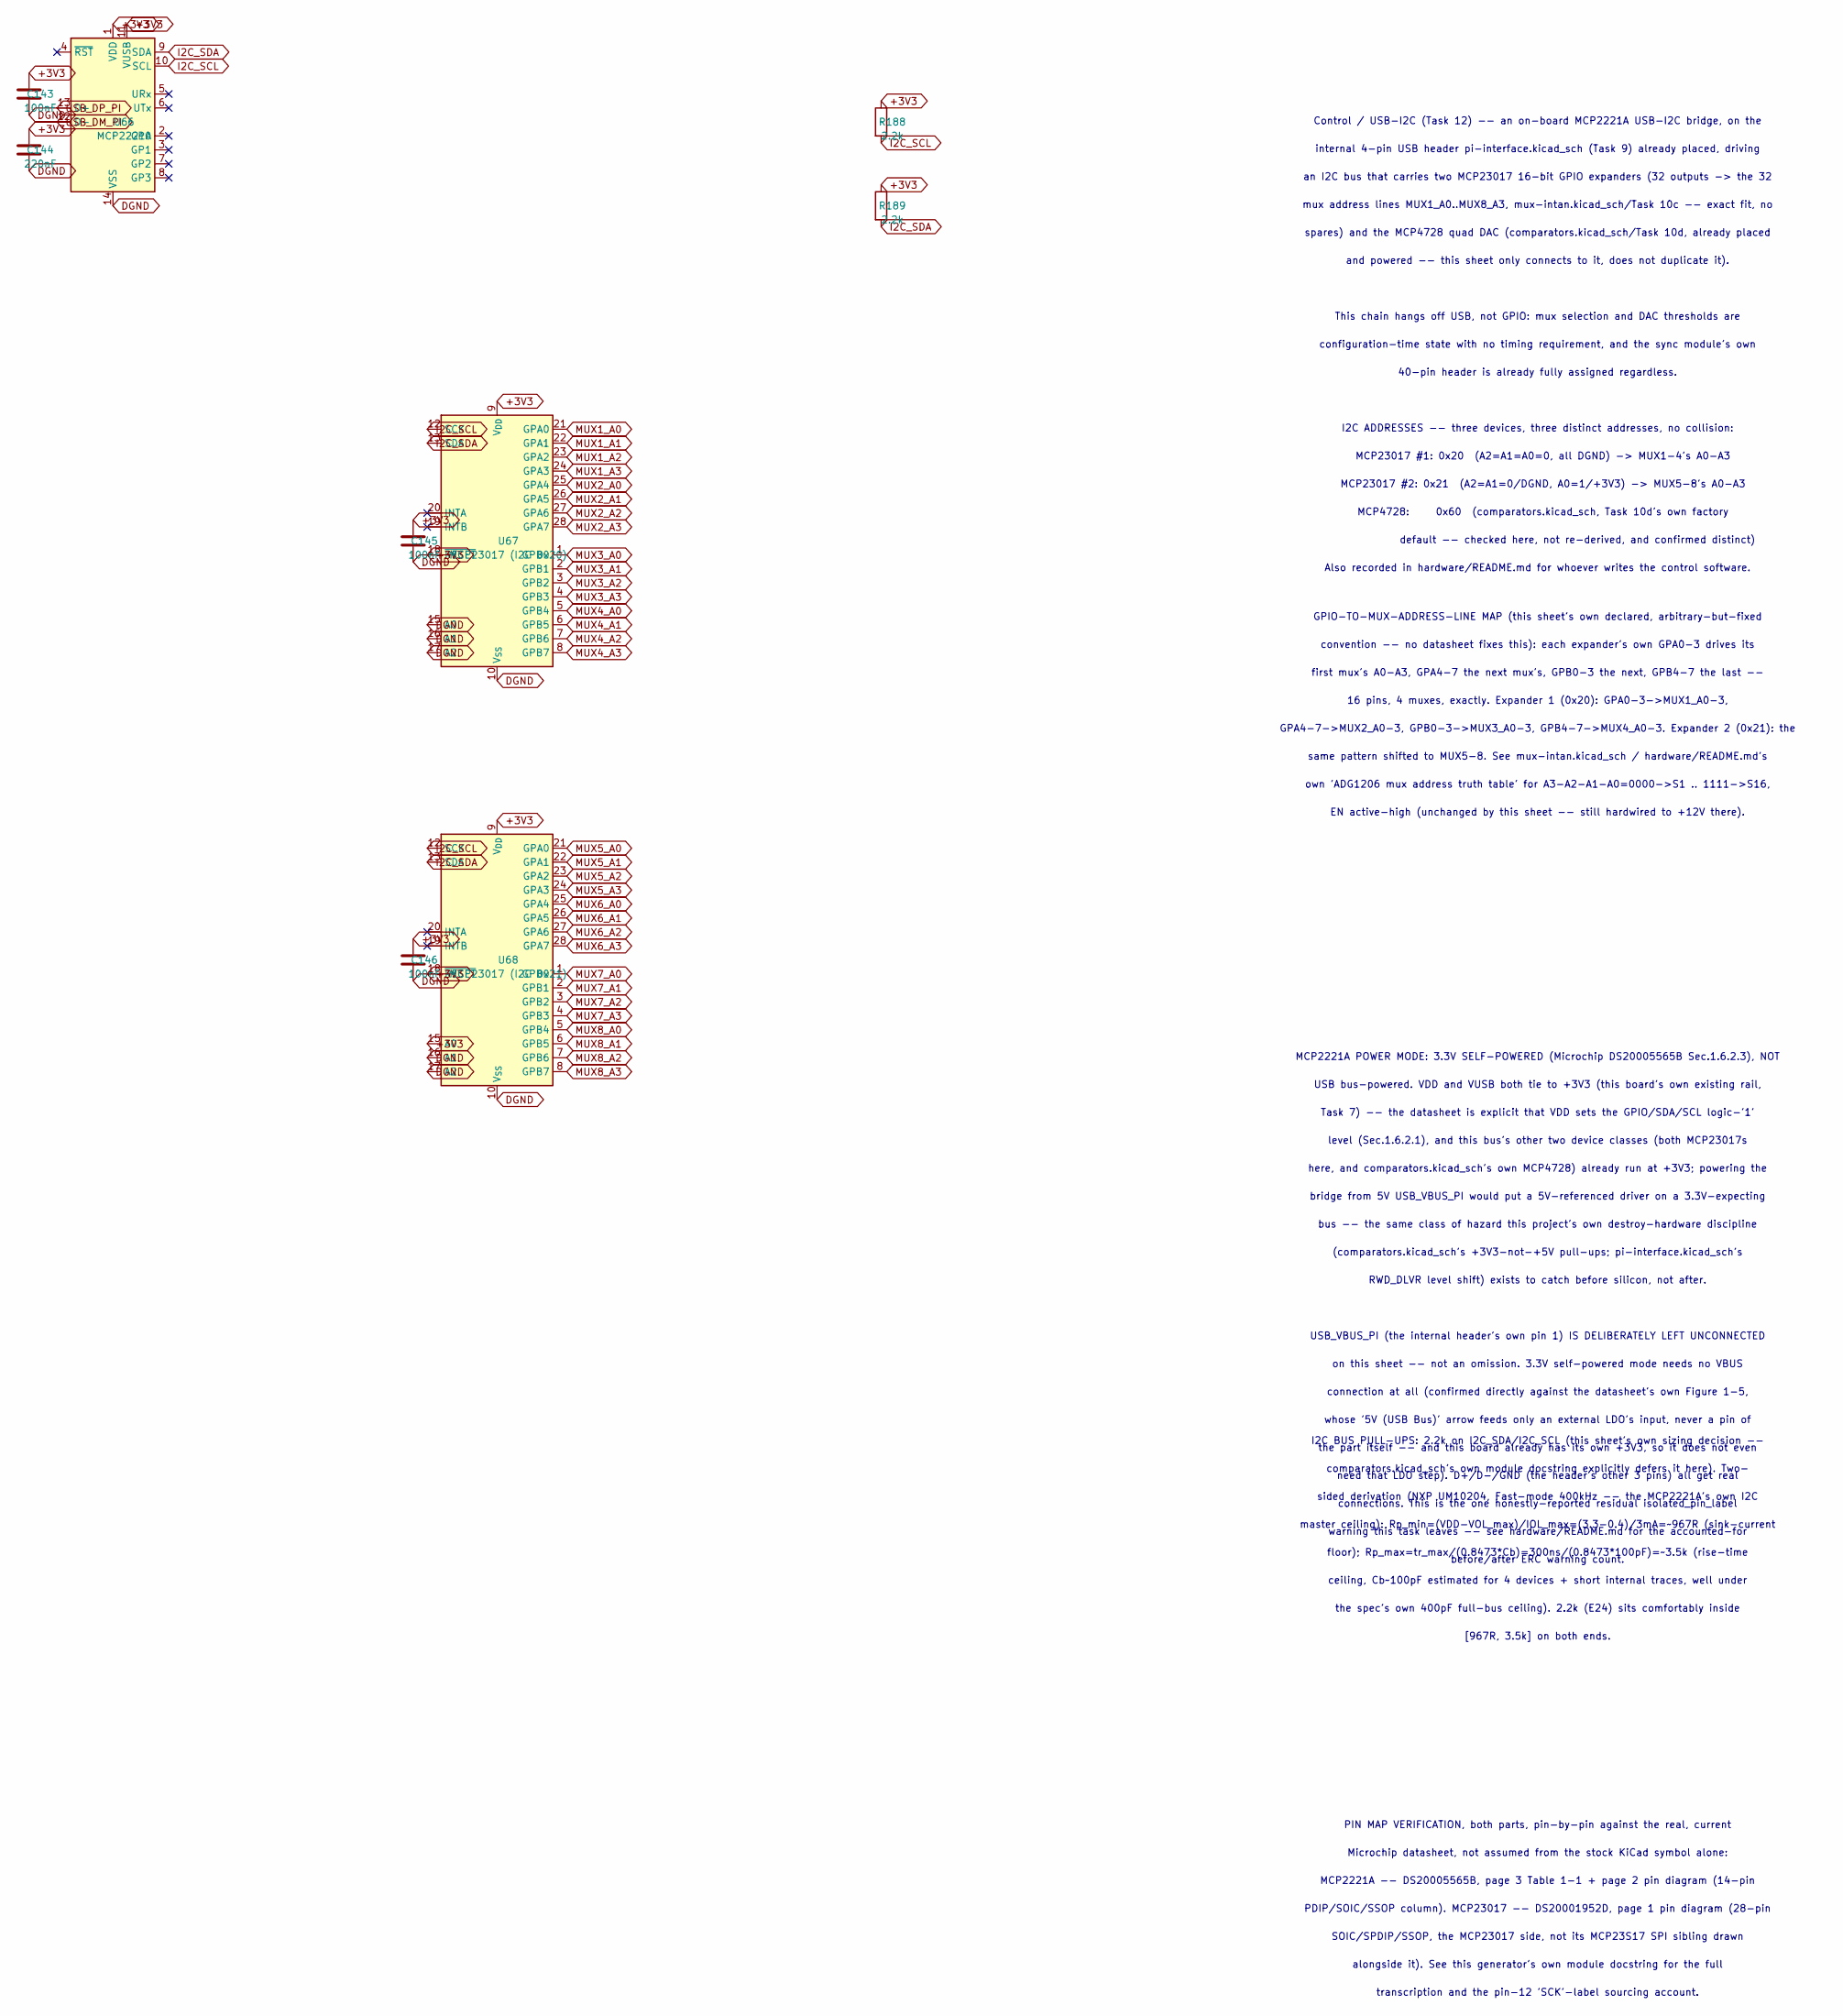
[picture p10: schematic control-usb-i2c.kicad_sch]

Parts:
C143, C145, C146: 100nF; C_0603_1608Metric
C144: 220nF; C_0603_1608Metric
R188, R189: 2.2k; R_0603_1608Metric
U66: MCP2221A; SOIC-14_3.9x8.7mm_P1.27mm
U67: MCP23017 (I2C 0x20); SOIC-28W_7.5x17.9mm_P1.27mm
U68: MCP23017 (I2C 0x21); SOIC-28W_7.5x17.9mm_P1.27mm

Connections:
+3V3: C143.1, C144.1, C145.1, C146.1, R188.1, R189.1, U66.1 (VDD), U66.11 (VUSB), U67.9 (V_{DD}), U67.18 (~RESET), U68.9 (V_{DD}), U68.15 (A0), U68.18 (~RESET)
DGND: C143.2, C144.2, C145.2, C146.2, U66.14 (VSS), U67.10 (V_{SS}), U67.15 (A0), U67.16 (A1), U67.17 (A2), U68.10 (V_{SS}), U68.16 (A1), U68.17 (A2)
I2C_SCL: R188.2, U66.10 (SCL), U67.12 (SCK), U68.12 (SCK)
I2C_SDA: R189.2, U66.9 (SDA), U67.13 (SDA), U68.13 (SDA)
MUX1_A0: U67.21 (GPA0)
MUX1_A1: U67.22 (GPA1)
MUX1_A2: U67.23 (GPA2)
MUX1_A3: U67.24 (GPA3)
MUX2_A0: U67.25 (GPA4)
MUX2_A1: U67.26 (GPA5)
MUX2_A2: U67.27 (GPA6)
MUX2_A3: U67.28 (GPA7)
MUX3_A0: U67.1 (GPB0)
MUX3_A1: U67.2 (GPB1)
MUX3_A2: U67.3 (GPB2)
MUX3_A3: U67.4 (GPB3)
MUX4_A0: U67.5 (GPB4)
MUX4_A1: U67.6 (GPB5)
MUX4_A2: U67.7 (GPB6)
MUX4_A3: U67.8 (GPB7)
MUX5_A0: U68.21 (GPA0)
MUX5_A1: U68.22 (GPA1)
MUX5_A2: U68.23 (GPA2)
MUX5_A3: U68.24 (GPA3)
MUX6_A0: U68.25 (GPA4)
MUX6_A1: U68.26 (GPA5)
MUX6_A2: U68.27 (GPA6)
MUX6_A3: U68.28 (GPA7)
MUX7_A0: U68.1 (GPB0)
MUX7_A1: U68.2 (GPB1)
MUX7_A2: U68.3 (GPB2)
MUX7_A3: U68.4 (GPB3)
MUX8_A0: U68.5 (GPB4)
MUX8_A1: U68.6 (GPB5)
MUX8_A2: U68.7 (GPB6)
MUX8_A3: U68.8 (GPB7)
USB_DM_PI: U66.12 (D-)
USB_DP_PI: U66.13 (D+)

Notes on the sheet:
Control / USB-I2C (Task 12) -- an on-board MCP2221A USB-I2C bridge, on the
internal 4-pin USB header pi-interface.kicad_sch (Task 9) already placed, driving
an I2C bus that carries two MCP23017 16-bit GPIO expanders (32 outputs -> the 32
mux address lines MUX1_A0..MUX8_A3, mux-intan.kicad_sch/Task 10c -- exact fit, no
spares) and the MCP4728 quad DAC (comparators.kicad_sch/Task 10d, already placed
and powered -- this sheet only connects to it, does not duplicate it).
This chain hangs off USB, not GPIO: mux selection and DAC thresholds are
configuration-time state with no timing requirement, and the sync module's own
40-pin header is already fully assigned regardless.
I2C ADDRESSES -- three devices, three distinct addresses, no collision:
MCP23017 #1: 0x20 (A2=A1=A0=0, all DGND) -> MUX1-4's A0-A3
MCP23017 #2: 0x21 (A2=A1=0/DGND, A0=1/+3V3) -> MUX5-8's A0-A3
MCP4728: 0x60 (comparators.kicad_sch, Task 10d's own factory
default -- checked here, not re-derived, and confirmed distinct)
Also recorded in hardware/README.md for whoever writes the control software.
GPIO-TO-MUX-ADDRESS-LINE MAP (this sheet's own declared, arbitrary-but-fixed
convention -- no datasheet fixes this): each expander's own GPA0-3 drives its
first mux's A0-A3, GPA4-7 the next mux's, GPB0-3 the next, GPB4-7 the last --
16 pins, 4 muxes, exactly. Expander 1 (0x20): GPA0-3->MUX1_A0-3,
GPA4-7->MUX2_A0-3, GPB0-3->MUX3_A0-3, GPB4-7->MUX4_A0-3. Expander 2 (0x21): the
same pattern shifted to MUX5-8. See mux-intan.kicad_sch / hardware/README.md's
own 'ADG1206 mux address truth table' for A3-A2-A1-A0=0000->S1 .. 1111->S16,
EN active-high (unchanged by this sheet -- still hardwired to +12V there).
MCP2221A POWER MODE: 3.3V SELF-POWERED (Microchip DS20005565B Sec.1.6.2.3), NOT
USB bus-powered. VDD and VUSB both tie to +3V3 (this board's own existing rail,
Task 7) -- the datasheet is explicit that VDD sets the GPIO/SDA/SCL logic-'1'
level (Sec.1.6.2.1), and this bus's other two device classes (both MCP23017s
here, and comparators.kicad_sch's own MCP4728) already run at +3V3; powering the
bridge from 5V USB_VBUS_PI would put a 5V-referenced driver on a 3.3V-expecting
bus -- the same class of hazard this project's own destroy-hardware discipline
(comparators.kicad_sch's +3V3-not-+5V pull-ups; pi-interface.kicad_sch's
RWD_DLVR level shift) exists to catch before silicon, not after.
USB_VBUS_PI (the internal header's own pin 1) IS DELIBERATELY LEFT UNCONNECTED
on this sheet -- not an omission. 3.3V self-powered mode needs no VBUS
connection at all (confirmed directly against the datasheet's own Figure 1-5,
whose '5V (USB Bus)' arrow feeds only an external LDO's input, never a pin of
the part itself -- and this board already has its own +3V3, so it does not even
need that LDO step). D+/D-/GND (the header's other 3 pins) all get real
connections. This is the one honestly-reported residual isolated_pin_label
warning this task leaves -- see hardware/README.md for the accounted-for
before/after ERC warning count.
I2C BUS PULL-UPS: 2.2k on I2C_SDA/I2C_SCL (this sheet's own sizing decision --
comparators.kicad_sch's own module docstring explicitly defers it here). Two-
sided derivation (NXP UM10204, Fast-mode 400kHz -- the MCP2221A's own I2C
master ceiling): Rp_min=(VDD-VOL_max)/IOL_max=(3.3-0.4)/3mA=~967R (sink-current
floor); Rp_max=tr_max/(0.8473*Cb)=300ns/(0.8473*100pF)=~3.5k (rise-time
ceiling, Cb~100pF estimated for 4 devices + short internal traces, well under
the spec's own 400pF full-bus ceiling). 2.2k (E24) sits comfortably inside
[967R, 3.5k] on both ends.
PIN MAP VERIFICATION, both parts, pin-by-pin against the real, current
Microchip datasheet, not assumed from the stock KiCad symbol alone:
MCP2221A -- DS20005565B, page 3 Table 1-1 + page 2 pin diagram (14-pin
PDIP/SOIC/SSOP column). MCP23017 -- DS20001952D, page 1 pin diagram (28-pin
SOIC/SPDIP/SSOP, the MCP23017 side, not its MCP23S17 SPI sibling drawn
alongside it). See this generator's own module docstring for the full
transcription and the pin-12 'SCK'-label sourcing account.
