jakewesterberg/wl-sync/hardware/breakout/sheets/mux-intan.kicad_sch

## KiCad design hardware/breakout/sheets/mux-intan.kicad_sch (2026-08-16)

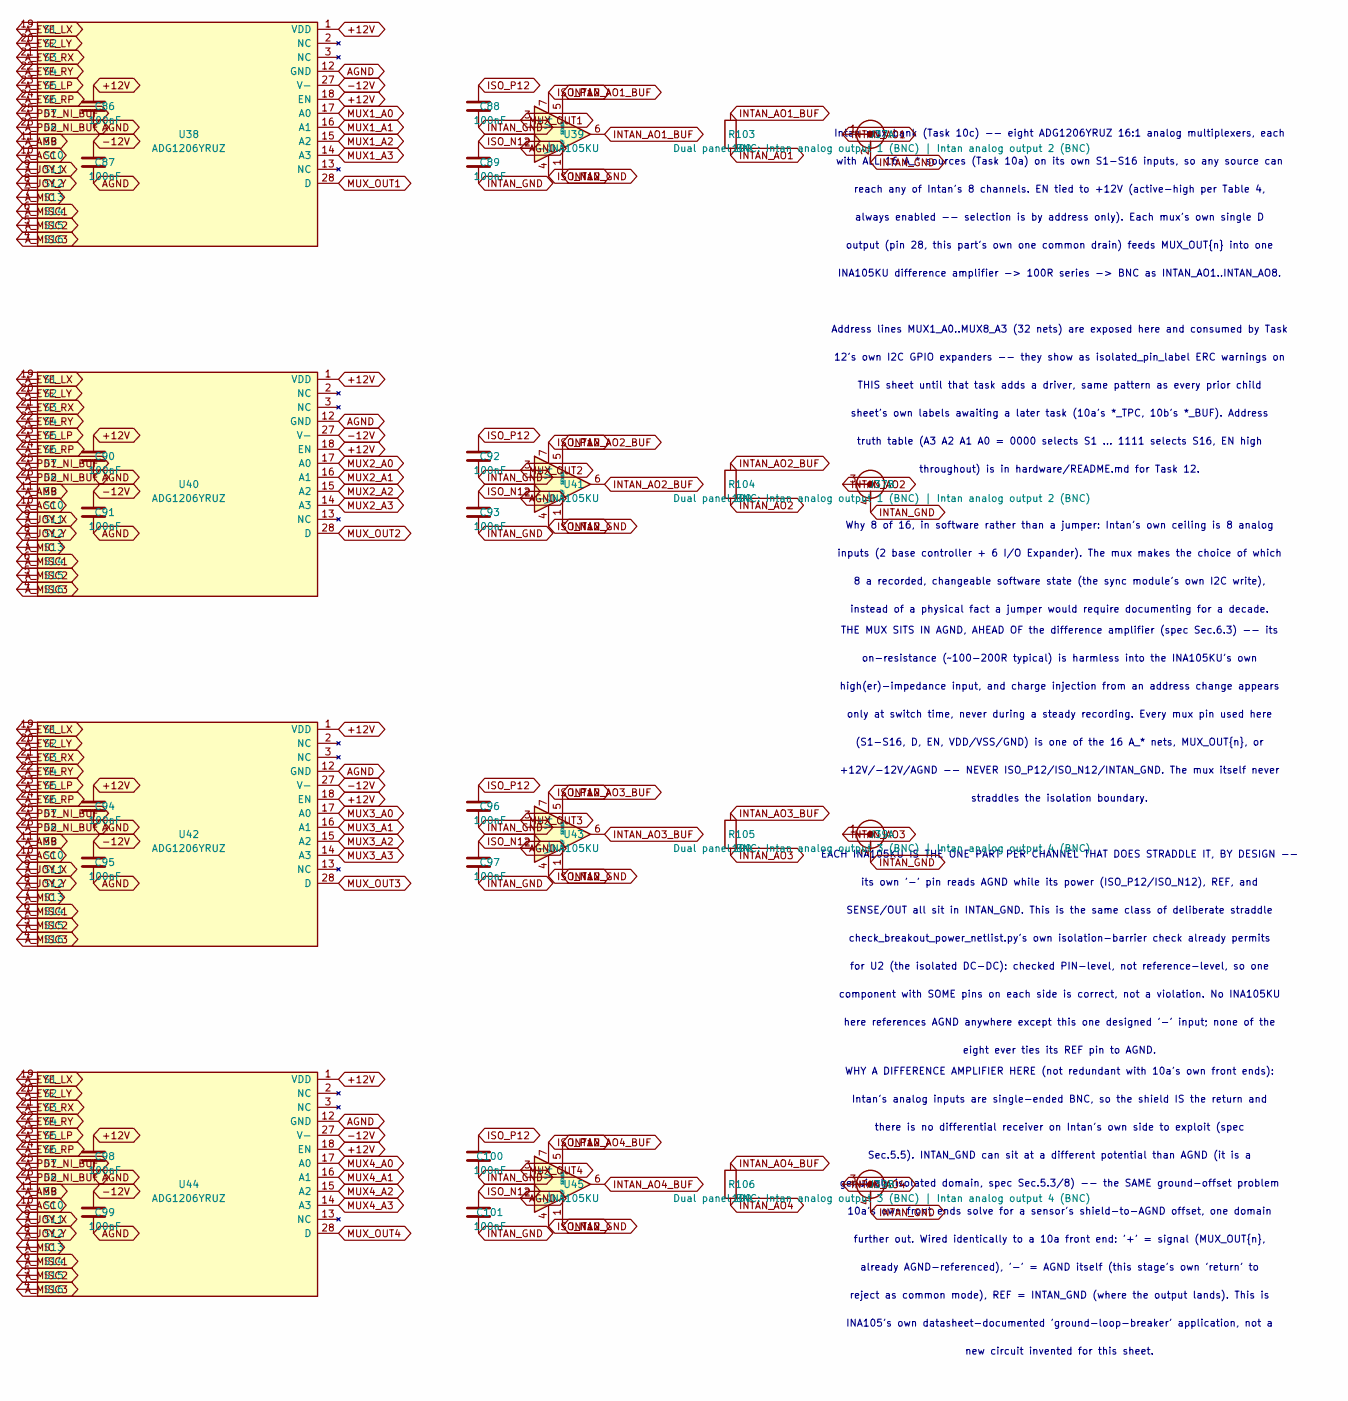
[picture p11: schematic mux-intan.kicad_sch, part in row 1, column 1]

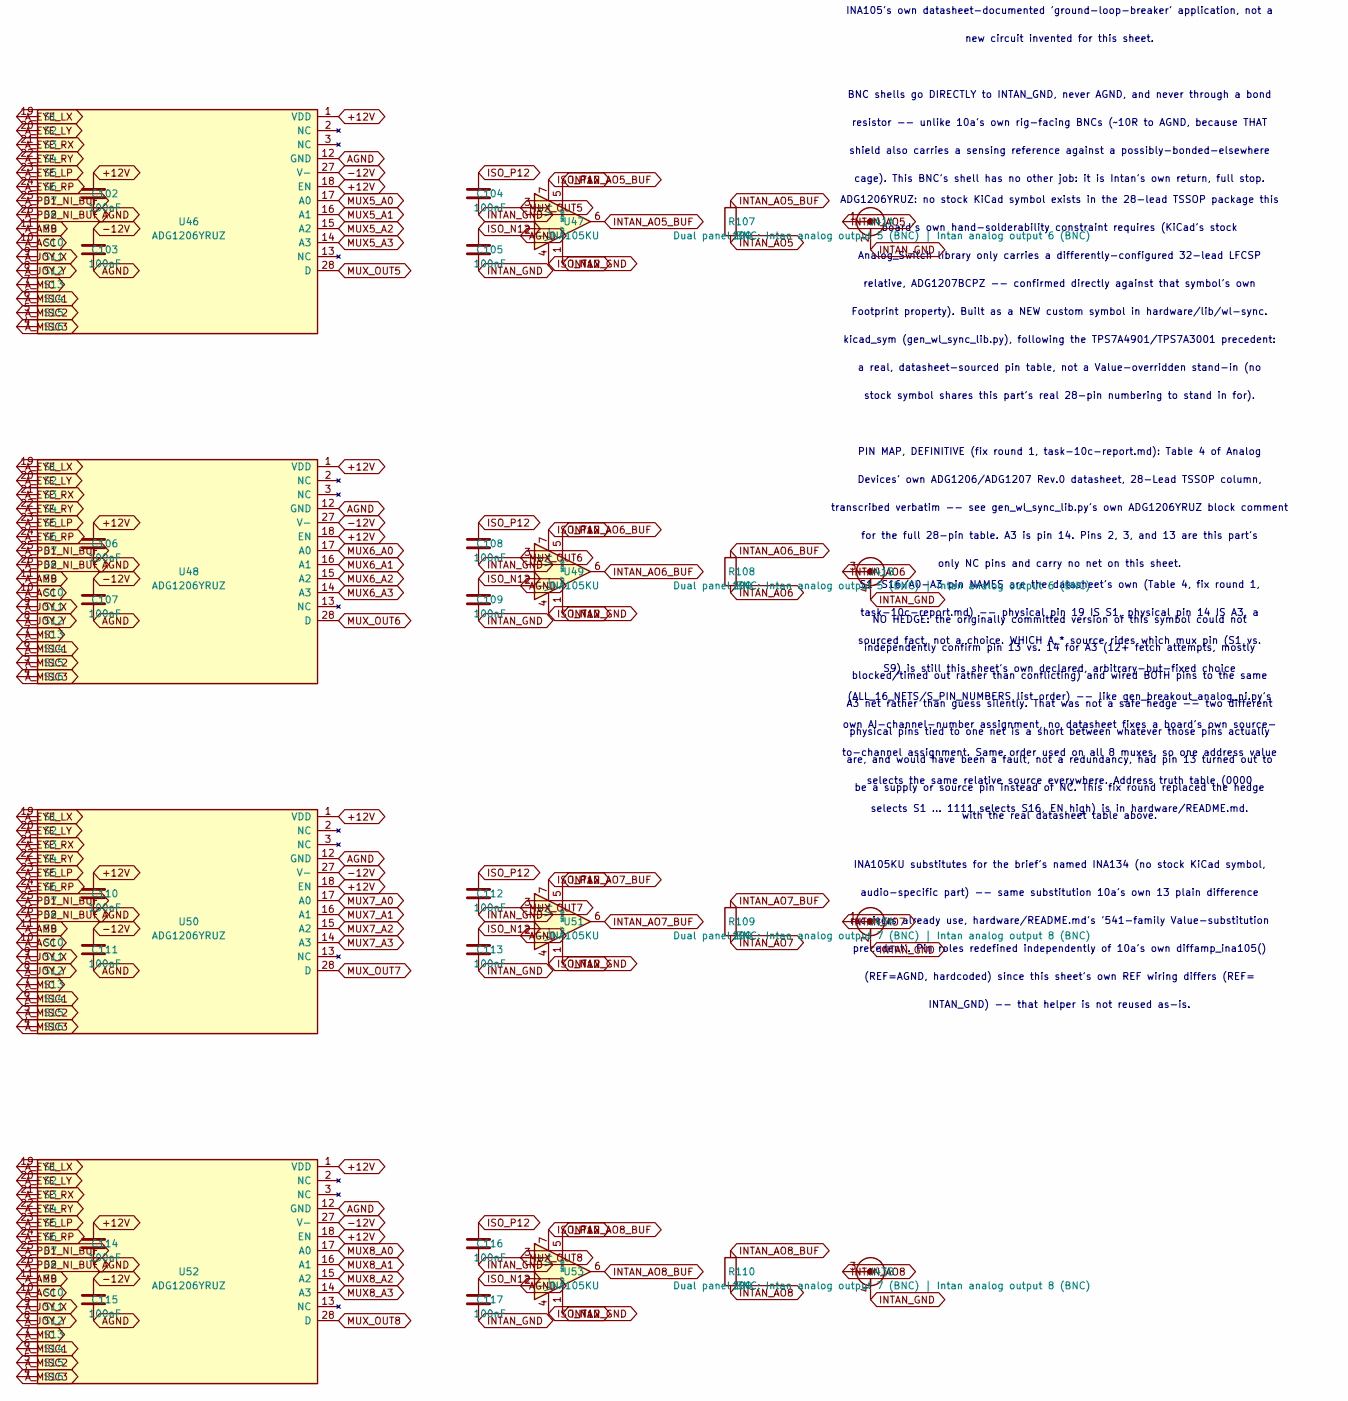
[picture p12: schematic mux-intan.kicad_sch, part in row 2, column 1]

Parts:
C86, C87, C88, C89, C90, C91, C92, C93, C94, C95, C96, C97, C98, C99, C100, C101, C102, C103, C104, C105, C106, C107, C108, C109, C110, C111, C112, C113, C114, C115, C116, C117: 100nF; C_0603_1608Metric
J37: Dual panel BNC: Intan analog output 1 (BNC) | Int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; BNC_Dual_RA_Isolated
J39: Dual panel BNC: Intan analog output 3 (BNC) | Int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; BNC_Dual_RA_Isolated
J41: Dual panel BNC: Intan analog output 5 (BNC) | Int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; BNC_Dual_RA_Isolated
J43: Dual panel BNC: Intan analog output 7 (BNC) | Int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; BNC_Dual_RA_Isolated
R103, R104, R105, R106, R107, R108, R109, R110: 100; R_0603_1608Metric
U38, U40, U42, U44, U46, U48, U50, U52: ADG1206YRUZ; TSSOP-28_4.4x9.7mm_P0.65mm
U39, U41, U43, U45, U47, U49, U51, U53: INA105KU; SOIC-8_3.9x4.9mm_P1.27mm

Connections:
+12V: C86.1, C90.1, C94.1, C98.1, C102.1, C106.1, C110.1, C114.1, U38.1 (VDD), U38.18 (EN), U40.1 (VDD), U40.18 (EN), U42.1 (VDD), U42.18 (EN), U44.1 (VDD), U44.18 (EN), U46.1 (VDD), U46.18 (EN), U48.1 (VDD), U48.18 (EN), U50.1 (VDD), U50.18 (EN), U52.1 (VDD), U52.18 (EN)
-12V: C87.1, C91.1, C95.1, C99.1, C103.1, C107.1, C111.1, C115.1, U38.27 (V-), U40.27 (V-), U42.27 (V-), U44.27 (V-), U46.27 (V-), U48.27 (V-), U50.27 (V-), U52.27 (V-)
AGND: C86.2, C87.2, C90.2, C91.2, C94.2, C95.2, C98.2, C99.2, C102.2, C103.2, C106.2, C107.2, C110.2, C111.2, C114.2, C115.2, U38.12 (GND), U39.2 (-), U40.12 (GND), U41.2 (-), U42.12 (GND), U43.2 (-), U44.12 (GND), U45.2 (-), U46.12 (GND), U47.2 (-), U48.12 (GND), U49.2 (-), U50.12 (GND), U51.2 (-), U52.12 (GND), U53.2 (-)
A_ACC: U38.10 (S10), U40.10 (S10), U42.10 (S10), U44.10 (S10), U46.10 (S10), U48.10 (S10), U50.10 (S10), U52.10 (S10)
A_AMB: U38.11 (S9), U40.11 (S9), U42.11 (S9), U44.11 (S9), U46.11 (S9), U48.11 (S9), U50.11 (S9), U52.11 (S9)
A_EYE_LP: U38.23 (S5), U40.23 (S5), U42.23 (S5), U44.23 (S5), U46.23 (S5), U48.23 (S5), U50.23 (S5), U52.23 (S5)
A_EYE_LX: U38.19 (S1), U40.19 (S1), U42.19 (S1), U44.19 (S1), U46.19 (S1), U48.19 (S1), U50.19 (S1), U52.19 (S1)
A_EYE_LY: U38.20 (S2), U40.20 (S2), U42.20 (S2), U44.20 (S2), U46.20 (S2), U48.20 (S2), U50.20 (S2), U52.20 (S2)
A_EYE_RP: U38.24 (S6), U40.24 (S6), U42.24 (S6), U44.24 (S6), U46.24 (S6), U48.24 (S6), U50.24 (S6), U52.24 (S6)
A_EYE_RX: U38.21 (S3), U40.21 (S3), U42.21 (S3), U44.21 (S3), U46.21 (S3), U48.21 (S3), U50.21 (S3), U52.21 (S3)
A_EYE_RY: U38.22 (S4), U40.22 (S4), U42.22 (S4), U44.22 (S4), U46.22 (S4), U48.22 (S4), U50.22 (S4), U52.22 (S4)
A_JOY_X: U38.9 (S11), U40.9 (S11), U42.9 (S11), U44.9 (S11), U46.9 (S11), U48.9 (S11), U50.9 (S11), U52.9 (S11)
A_JOY_Y: U38.8 (S12), U40.8 (S12), U42.8 (S12), U44.8 (S12), U46.8 (S12), U48.8 (S12), U50.8 (S12), U52.8 (S12)
A_MIC: U38.7 (S13), U40.7 (S13), U42.7 (S13), U44.7 (S13), U46.7 (S13), U48.7 (S13), U50.7 (S13), U52.7 (S13)
A_MISC1: U38.6 (S14), U40.6 (S14), U42.6 (S14), U44.6 (S14), U46.6 (S14), U48.6 (S14), U50.6 (S14), U52.6 (S14)
A_MISC2: U38.5 (S15), U40.5 (S15), U42.5 (S15), U44.5 (S15), U46.5 (S15), U48.5 (S15), U50.5 (S15), U52.5 (S15)
A_MISC3: U38.4 (S16), U40.4 (S16), U42.4 (S16), U44.4 (S16), U46.4 (S16), U48.4 (S16), U50.4 (S16), U52.4 (S16)
A_PD1_NI_BUF: U38.25 (S7), U40.25 (S7), U42.25 (S7), U44.25 (S7), U46.25 (S7), U48.25 (S7), U50.25 (S7), U52.25 (S7)
A_PD2_NI_BUF: U38.26 (S8), U40.26 (S8), U42.26 (S8), U44.26 (S8), U46.26 (S8), U48.26 (S8), U50.26 (S8), U52.26 (S8)
INTAN_AO1: J37.1 (A_In), R103.2
INTAN_AO1_BUF: R103.1, U39.5 (SENSE), U39.6
INTAN_AO2: J37.3 (B_In), R104.2
INTAN_AO2_BUF: R104.1, U41.5 (SENSE), U41.6
INTAN_AO3: J39.1 (A_In), R105.2
INTAN_AO3_BUF: R105.1, U43.5 (SENSE), U43.6
INTAN_AO4: J39.3 (B_In), R106.2
INTAN_AO4_BUF: R106.1, U45.5 (SENSE), U45.6
INTAN_AO5: J41.1 (A_In), R107.2
INTAN_AO5_BUF: R107.1, U47.5 (SENSE), U47.6
INTAN_AO6: J41.3 (B_In), R108.2
INTAN_AO6_BUF: R108.1, U49.5 (SENSE), U49.6
INTAN_AO7: J43.1 (A_In), R109.2
INTAN_AO7_BUF: R109.1, U51.5 (SENSE), U51.6
INTAN_AO8: J43.3 (B_In), R110.2
INTAN_AO8_BUF: R110.1, U53.5 (SENSE), U53.6
INTAN_GND: C88.2, C89.2, C92.2, C93.2, C96.2, C97.2, C100.2, C101.2, C104.2, C105.2, C108.2, C109.2, C112.2, C113.2, C116.2, C117.2, J37.2 (A_Ext), J37.4 (B_Ext), J39.2 (A_Ext), J39.4 (B_Ext), J41.2 (A_Ext), J41.4 (B_Ext), J43.2 (A_Ext), J43.4 (B_Ext), U39.1 (REF), U41.1 (REF), U43.1 (REF), U45.1 (REF), U47.1 (REF), U49.1 (REF), U51.1 (REF), U53.1 (REF)
ISO_N12: C89.1, C93.1, C97.1, C101.1, C105.1, C109.1, C113.1, C117.1, U39.4 (V-), U41.4 (V-), U43.4 (V-), U45.4 (V-), U47.4 (V-), U49.4 (V-), U51.4 (V-), U53.4 (V-)
ISO_P12: C88.1, C92.1, C96.1, C100.1, C104.1, C108.1, C112.1, C116.1, U39.7 (V+), U41.7 (V+), U43.7 (V+), U45.7 (V+), U47.7 (V+), U49.7 (V+), U51.7 (V+), U53.7 (V+)
MUX1_A0: U38.17 (A0)
MUX1_A1: U38.16 (A1)
MUX1_A2: U38.15 (A2)
MUX1_A3: U38.14 (A3)
MUX2_A0: U40.17 (A0)
MUX2_A1: U40.16 (A1)
MUX2_A2: U40.15 (A2)
MUX2_A3: U40.14 (A3)
MUX3_A0: U42.17 (A0)
MUX3_A1: U42.16 (A1)
MUX3_A2: U42.15 (A2)
MUX3_A3: U42.14 (A3)
MUX4_A0: U44.17 (A0)
MUX4_A1: U44.16 (A1)
MUX4_A2: U44.15 (A2)
MUX4_A3: U44.14 (A3)
MUX5_A0: U46.17 (A0)
MUX5_A1: U46.16 (A1)
MUX5_A2: U46.15 (A2)
MUX5_A3: U46.14 (A3)
MUX6_A0: U48.17 (A0)
MUX6_A1: U48.16 (A1)
MUX6_A2: U48.15 (A2)
MUX6_A3: U48.14 (A3)
MUX7_A0: U50.17 (A0)
MUX7_A1: U50.16 (A1)
MUX7_A2: U50.15 (A2)
MUX7_A3: U50.14 (A3)
MUX8_A0: U52.17 (A0)
MUX8_A1: U52.16 (A1)
MUX8_A2: U52.15 (A2)
MUX8_A3: U52.14 (A3)
MUX_OUT1: U38.28 (D), U39.3 (+)
MUX_OUT2: U40.28 (D), U41.3 (+)
MUX_OUT3: U42.28 (D), U43.3 (+)
MUX_OUT4: U44.28 (D), U45.3 (+)
MUX_OUT5: U46.28 (D), U47.3 (+)
MUX_OUT6: U48.28 (D), U49.3 (+)
MUX_OUT7: U50.28 (D), U51.3 (+)
MUX_OUT8: U52.28 (D), U53.3 (+)

Notes on the sheet:
Intan mux bank (Task 10c) -- eight ADG1206YRUZ 16:1 analog multiplexers, each
with ALL 16 A_* sources (Task 10a) on its own S1-S16 inputs, so any source can
reach any of Intan's 8 channels. EN tied to +12V (active-high per Table 4,
always enabled -- selection is by address only). Each mux's own single D
output (pin 28, this part's own one common drain) feeds MUX_OUT{n} into one
INA105KU difference amplifier -> 100R series -> BNC as INTAN_AO1..INTAN_AO8.
Address lines MUX1_A0..MUX8_A3 (32 nets) are exposed here and consumed by Task
12's own I2C GPIO expanders -- they show as isolated_pin_label ERC warnings on
THIS sheet until that task adds a driver, same pattern as every prior child
sheet's own labels awaiting a later task (10a's *_TPC, 10b's *_BUF). Address
truth table (A3 A2 A1 A0 = 0000 selects S1 ... 1111 selects S16, EN high
throughout) is in hardware/README.md for Task 12.
Why 8 of 16, in software rather than a jumper: Intan's own ceiling is 8 analog
inputs (2 base controller + 6 I/O Expander). The mux makes the choice of which
8 a recorded, changeable software state (the sync module's own I2C write),
instead of a physical fact a jumper would require documenting for a decade.
THE MUX SITS IN AGND, AHEAD OF the difference amplifier (spec Sec.6.3) -- its
on-resistance (~100-200R typical) is harmless into the INA105KU's own
high(er)-impedance input, and charge injection from an address change appears
only at switch time, never during a steady recording. Every mux pin used here
(S1-S16, D, EN, VDD/VSS/GND) is one of the 16 A_* nets, MUX_OUT{n}, or
+12V/-12V/AGND -- NEVER ISO_P12/ISO_N12/INTAN_GND. The mux itself never
straddles the isolation boundary.
EACH INA105KU IS THE ONE PART PER CHANNEL THAT DOES STRADDLE IT, BY DESIGN --
its own '-' pin reads AGND while its power (ISO_P12/ISO_N12), REF, and
SENSE/OUT all sit in INTAN_GND. This is the same class of deliberate straddle
check_breakout_power_netlist.py's own isolation-barrier check already permits
for U2 (the isolated DC-DC): checked PIN-level, not reference-level, so one
component with SOME pins on each side is correct, not a violation. No INA105KU
here references AGND anywhere except this one designed '-' input; none of the
eight ever ties its REF pin to AGND.
WHY A DIFFERENCE AMPLIFIER HERE (not redundant with 10a's own front ends):
Intan's analog inputs are single-ended BNC, so the shield IS the return and
there is no differential receiver on Intan's own side to exploit (spec
Sec.5.5). INTAN_GND can sit at a different potential than AGND (it is a
genuinely isolated domain, spec Sec.5.3/8) -- the SAME ground-offset problem
10a's own front ends solve for a sensor's shield-to-AGND offset, one domain
further out. Wired identically to a 10a front end: '+' = signal (MUX_OUT{n},
already AGND-referenced), '-' = AGND itself (this stage's own 'return' to
reject as common mode), REF = INTAN_GND (where the output lands). This is
INA105's own datasheet-documented 'ground-loop-breaker' application, not a
new circuit invented for this sheet.
BNC shells go DIRECTLY to INTAN_GND, never AGND, and never through a bond
resistor -- unlike 10a's own rig-facing BNCs (~10R to AGND, because THAT
shield also carries a sensing reference against a possibly-bonded-elsewhere
cage). This BNC's shell has no other job: it is Intan's own return, full stop.
ADG1206YRUZ: no stock KiCad symbol exists in the 28-lead TSSOP package this
board's own hand-solderability constraint requires (KiCad's stock
Analog_Switch library only carries a differently-configured 32-lead LFCSP
relative, ADG1207BCPZ -- confirmed directly against that symbol's own
Footprint property). Built as a NEW custom symbol in hardware/lib/wl-sync.
kicad_sym (gen_wl_sync_lib.py), following the TPS7A4901/TPS7A3001 precedent:
a real, datasheet-sourced pin table, not a Value-overridden stand-in (no
stock symbol shares this part's real 28-pin numbering to stand in for).
PIN MAP, DEFINITIVE (fix round 1, task-10c-report.md): Table 4 of Analog
Devices' own ADG1206/ADG1207 Rev.0 datasheet, 28-Lead TSSOP column,
transcribed verbatim -- see gen_wl_sync_lib.py's own ADG1206YRUZ block comment
for the full 28-pin table. A3 is pin 14. Pins 2, 3, and 13 are this part's
only NC pins and carry no net on this sheet.
NO HEDGE: the originally committed version of this symbol could not
independently confirm pin 13 vs. 14 for A3 (12+ fetch attempts, mostly
blocked/timed out rather than conflicting) and wired BOTH pins to the same
A3 net rather than guess silently. That was not a safe hedge -- two different
physical pins tied to one net is a short between whatever those pins actually
are, and would have been a fault, not a redundancy, had pin 13 turned out to
be a supply or source pin instead of NC. This fix round replaced the hedge
with the real datasheet table above.
S1-S16/A0-A3 pin NAMES are the datasheet's own (Table 4, fix round 1,
task-10c-report.md) -- physical pin 19 IS S1, physical pin 14 IS A3, a
sourced fact, not a choice. WHICH A_* source rides which mux pin (S1 vs.
S9) is still this sheet's own declared, arbitrary-but-fixed choice
(ALL_16_NETS/S_PIN_NUMBERS list order) -- like gen_breakout_analog_ni.py's
own AI-channel-number assignment, no datasheet fixes a board's own source-
to-channel assignment. Same order used on all 8 muxes, so one address value
selects the same relative source everywhere. Address truth table (0000
selects S1 ... 1111 selects S16, EN high) is in hardware/README.md.
INA105KU substitutes for the brief's named INA134 (no stock KiCad symbol,
audio-specific part) -- same substitution 10a's own 13 plain difference
receivers already use, hardware/README.md's '541-family Value-substitution
precedent'. Pin roles redefined independently of 10a's own diffamp_ina105()
(REF=AGND, hardcoded) since this sheet's own REF wiring differs (REF=
INTAN_GND) -- that helper is not reused as-is.
