jakewesterberg/wl-sync/hardware/breakout/sheets/opto-intan.kicad_sch

## KiCad design hardware/breakout/sheets/opto-intan.kicad_sch (2026-08-16)

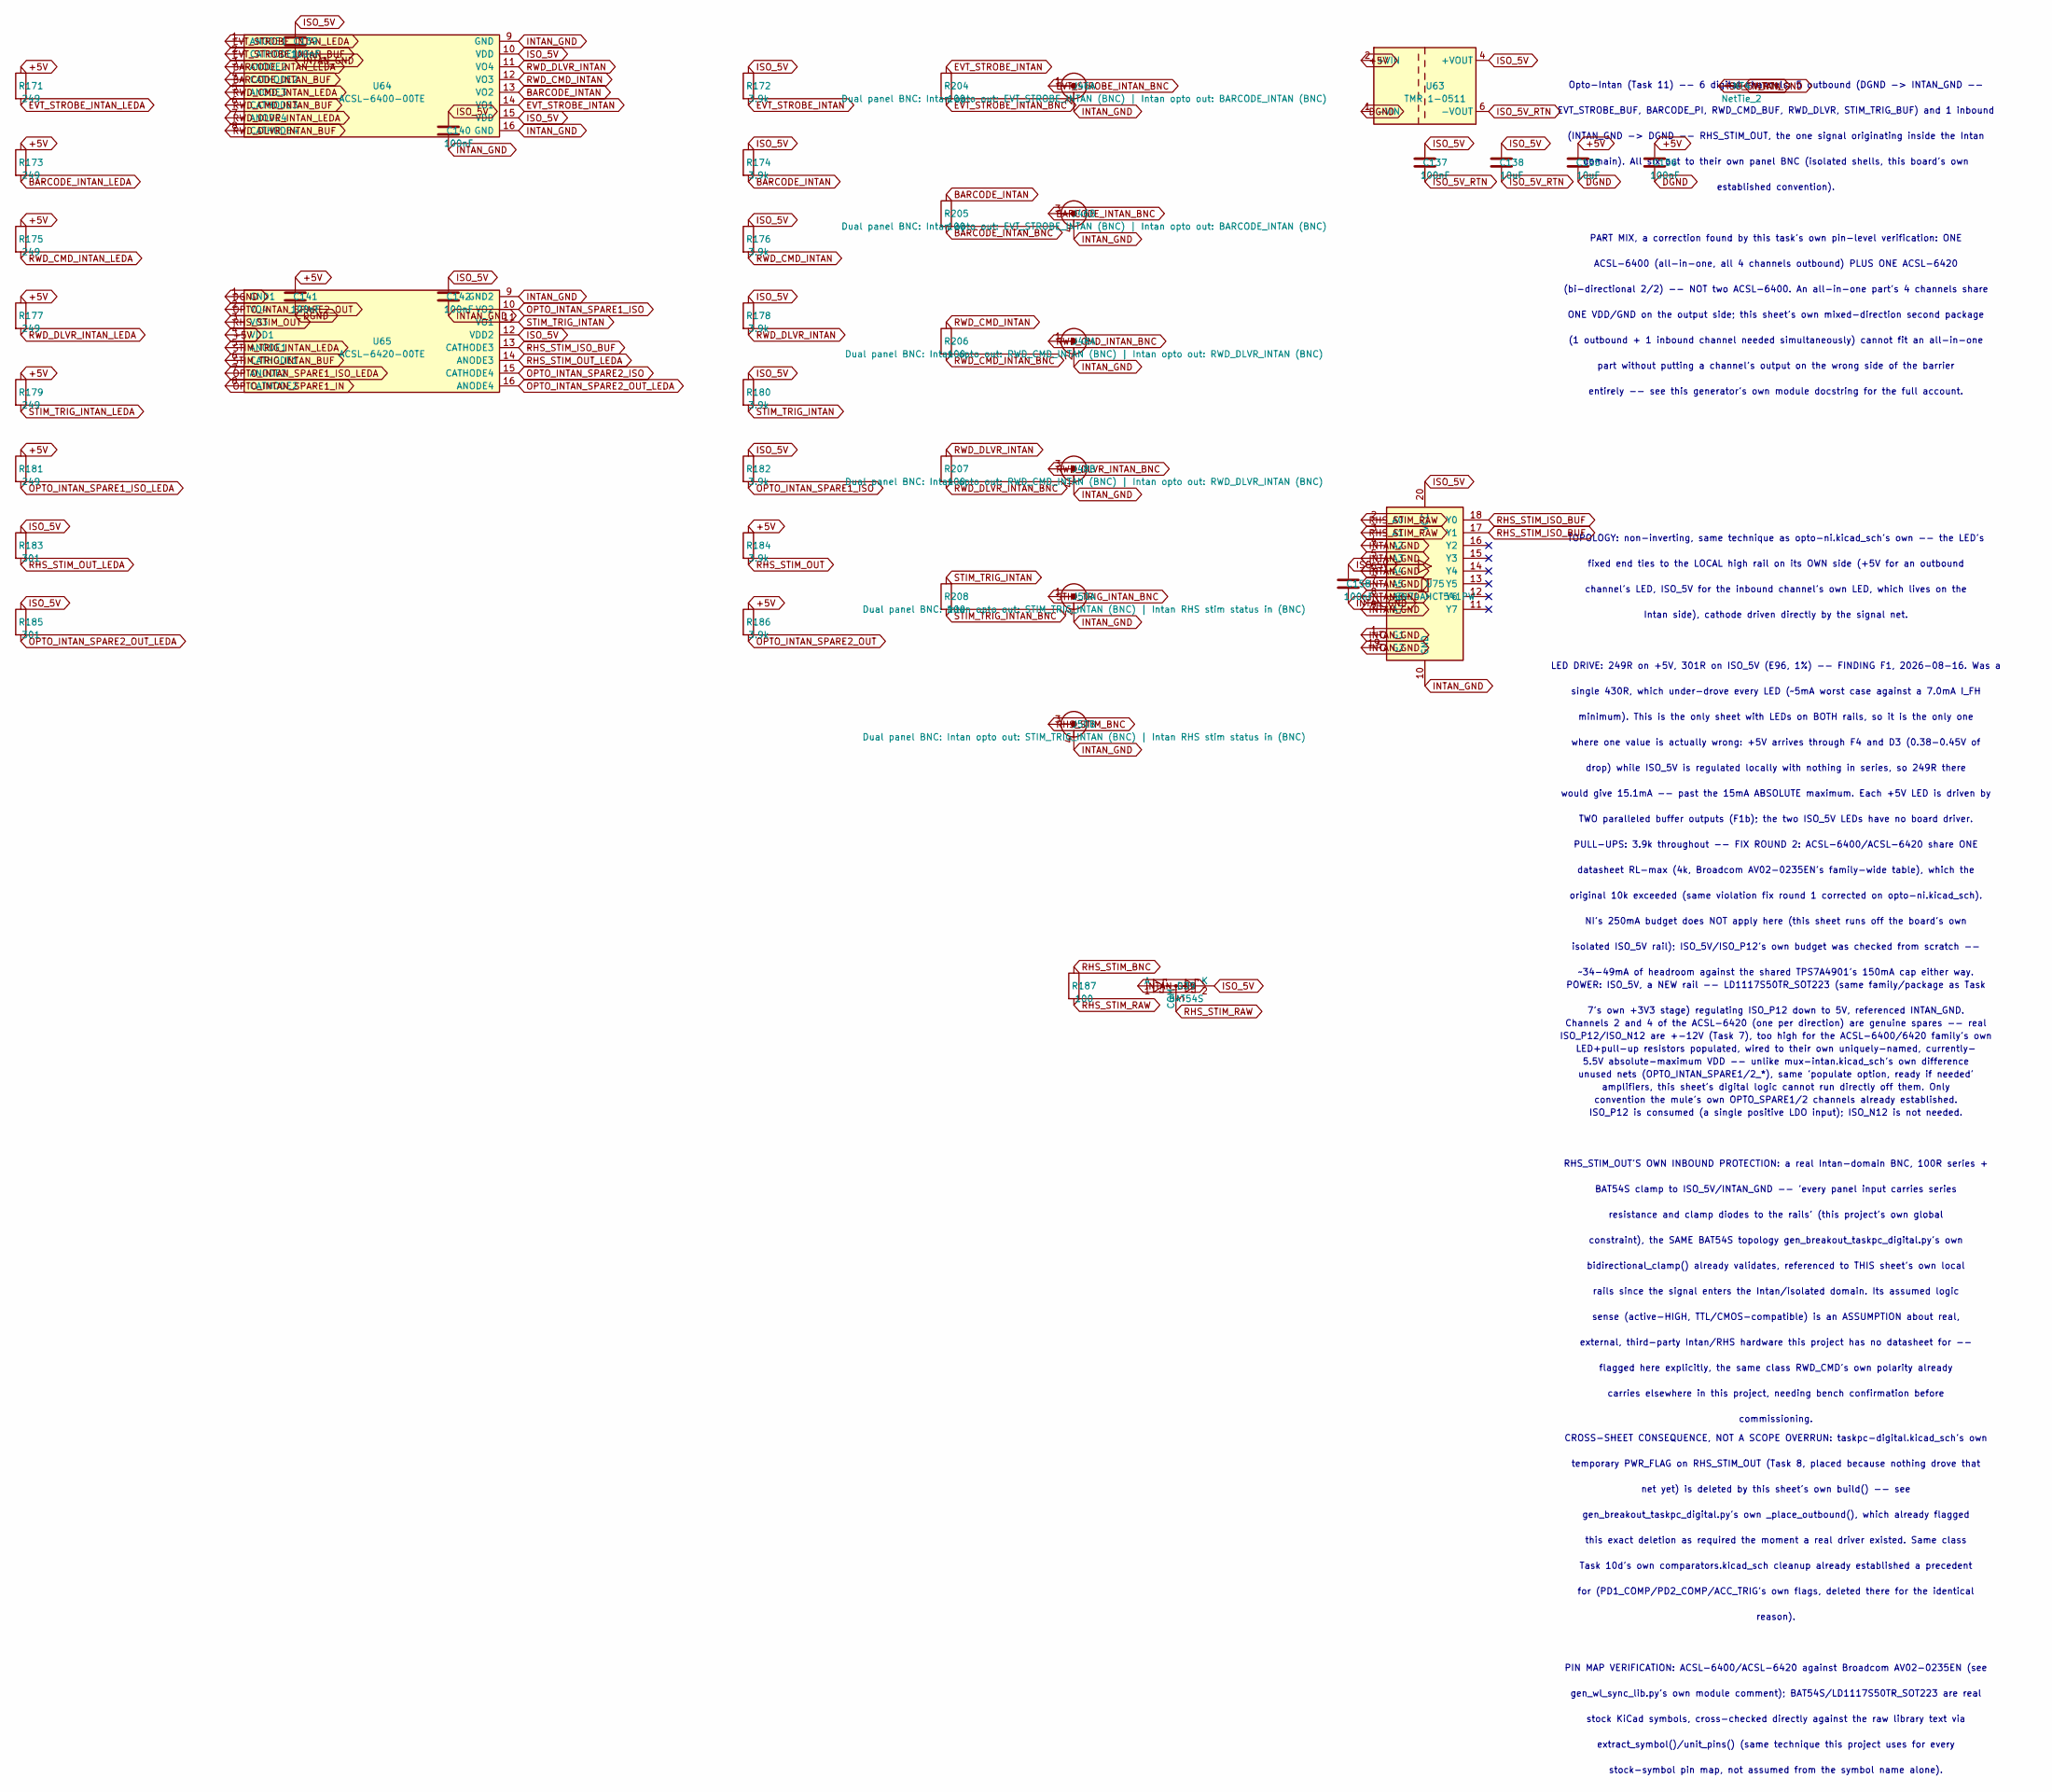
[picture p13: schematic opto-intan.kicad_sch]

Parts:
C137, C139, C140, C141, C142, C156, C158: 100nF; C_0603_1608Metric
C138, C155: 10uF; C_1206_3216Metric
D39: BAT54S; SOT-23
J46: Dual panel BNC: Intan opto out: EVT_STROBE_INTAN 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; BNC_Dual_RA_Isolated
J48: Dual panel BNC: Intan opto out: RWD_CMD_INTAN (BN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; BNC_Dual_RA_Isolated
J50: Dual panel BNC: Intan opto out: STIM_TRIG_INTAN (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; BNC_Dual_RA_Isolated
NT4: NetTie_2; NetTie-2_SMD_Pad2.0mm
R171, R173, R175, R177, R179, R181: 249; R_0603_1608Metric
R172, R174, R176, R178, R180, R182, R184, R186: 3.9k; R_0603_1608Metric
R183, R185: 301; R_0603_1608Metric
R187, R204, R205, R206, R207, R208: 100; R_0603_1608Metric
U63: TMR 1-0511; Converter_DCDC_TRACO_TMR-1-xxxx_Single_THT
U64: ACSL-6400-00TE; SOIC-16_3.9x9.9mm_P1.27mm
U65: ACSL-6420-00TE; SOIC-16_3.9x9.9mm_P1.27mm
U75: SN74AHCT541PW; Texas_PW0020A_TSSOP-20_4.4x6.5mm_P0.65mm

Connections:
+5V: C141.1, C155.1, C156.1, R171.1, R173.1, R175.1, R177.1, R179.1, R181.1, R184.1, R186.1, U63.2 (+VIN), U65.4 (VDD1)
BARCODE_INTAN: R174.2, R205.1, U64.13 (VO2)
BARCODE_INTAN_BNC: J46.3 (B_In), R205.2
BARCODE_INTAN_BUF: U64.4 (CATHODE2)
BARCODE_INTAN_LEDA: R173.2, U64.3 (ANODE2)
DGND: C141.2, C155.2, C156.2, U63.1 (-VIN), U65.1 (GND1)
EVT_STROBE_INTAN: R172.2, R204.1, U64.14 (VO1)
EVT_STROBE_INTAN_BNC: J46.1 (A_In), R204.2
EVT_STROBE_INTAN_BUF: U64.2 (CATHODE1)
EVT_STROBE_INTAN_LEDA: R171.2, U64.1 (ANODE1)
INTAN_GND: C139.2, C140.2, C142.2, C158.2, D39.1 (A), J46.2 (A_Ext), J46.4 (B_Ext), J48.2 (A_Ext), J48.4 (B_Ext), J50.2 (A_Ext), J50.4 (B_Ext), NT4.2, U64.9 (GND), U64.16 (GND), U65.9 (GND2), U75.1 (G1), U75.4 (A2), U75.5 (A3), U75.6 (A4), U75.7 (A5), U75.8 (A6), U75.9 (A7), U75.10 (GND), U75.19 (G2)
ISO_5V: C137.1, C138.1, C139.1, C140.1, C142.1, C158.1, D39.2 (K), R172.1, R174.1, R176.1, R178.1, R180.1, R182.1, R183.1, R185.1, U63.4 (+VOUT), U64.10 (VDD), U64.15 (VDD), U65.12 (VDD2), U75.20 (VCC)
ISO_5V_RTN: C137.2, C138.2, NT4.1, U63.6 (-VOUT)
OPTO_INTAN_SPARE1_IN: U65.8 (CATHODE2)
OPTO_INTAN_SPARE1_ISO: R182.2, U65.10 (VO2)
OPTO_INTAN_SPARE1_ISO_LEDA: R181.2, U65.7 (ANODE2)
OPTO_INTAN_SPARE2_ISO: U65.15 (CATHODE4)
OPTO_INTAN_SPARE2_OUT: R186.2, U65.2 (VO4)
OPTO_INTAN_SPARE2_OUT_LEDA: R185.2, U65.16 (ANODE4)
RHS_STIM_BNC: J50.3 (B_In), R187.1
RHS_STIM_ISO_BUF: U65.13 (CATHODE3), U75.17 (Y1), U75.18 (Y0)
RHS_STIM_OUT: R184.2, U65.3 (VO3)
RHS_STIM_OUT_LEDA: R183.2, U65.14 (ANODE3)
RHS_STIM_RAW: D39.3 (COM), R187.2, U75.2 (A0), U75.3 (A1)
RWD_CMD_INTAN: R176.2, R206.1, U64.12 (VO3)
RWD_CMD_INTAN_BNC: J48.1 (A_In), R206.2
RWD_CMD_INTAN_BUF: U64.6 (CATHODE3)
RWD_CMD_INTAN_LEDA: R175.2, U64.5 (ANODE3)
RWD_DLVR_INTAN: R178.2, R207.1, U64.11 (VO4)
RWD_DLVR_INTAN_BNC: J48.3 (B_In), R207.2
RWD_DLVR_INTAN_BUF: U64.8 (CATHODE4)
RWD_DLVR_INTAN_LEDA: R177.2, U64.7 (ANODE4)
STIM_TRIG_INTAN: R180.2, R208.1, U65.11 (VO1)
STIM_TRIG_INTAN_BNC: J50.1 (A_In), R208.2
STIM_TRIG_INTAN_BUF: U65.6 (CATHODE1)
STIM_TRIG_INTAN_LEDA: R179.2, U65.5 (ANODE1)

Notes on the sheet:
Opto-Intan (Task 11) -- 6 digital channels: 5 outbound (DGND -> INTAN_GND --
EVT_STROBE_BUF, BARCODE_PI, RWD_CMD_BUF, RWD_DLVR, STIM_TRIG_BUF) and 1 inbound
(INTAN_GND -> DGND -- RHS_STIM_OUT, the one signal originating inside the Intan
domain). All six out to their own panel BNC (isolated shells, this board's own
established convention).
PART MIX, a correction found by this task's own pin-level verification: ONE
ACSL-6400 (all-in-one, all 4 channels outbound) PLUS ONE ACSL-6420
(bi-directional 2/2) -- NOT two ACSL-6400. An all-in-one part's 4 channels share
ONE VDD/GND on the output side; this sheet's own mixed-direction second package
(1 outbound + 1 inbound channel needed simultaneously) cannot fit an all-in-one
part without putting a channel's output on the wrong side of the barrier
entirely -- see this generator's own module docstring for the full account.
TOPOLOGY: non-inverting, same technique as opto-ni.kicad_sch's own -- the LED's
fixed end ties to the LOCAL high rail on its OWN side (+5V for an outbound
channel's LED, ISO_5V for the inbound channel's own LED, which lives on the
Intan side), cathode driven directly by the signal net.
LED DRIVE: 249R on +5V, 301R on ISO_5V (E96, 1%) -- FINDING F1, 2026-08-16. Was a
single 430R, which under-drove every LED (~5mA worst case against a 7.0mA I_FH
minimum). This is the only sheet with LEDs on BOTH rails, so it is the only one
where one value is actually wrong: +5V arrives through F4 and D3 (0.38-0.45V of
drop) while ISO_5V is regulated locally with nothing in series, so 249R there
would give 15.1mA -- past the 15mA ABSOLUTE maximum. Each +5V LED is driven by
TWO paralleled buffer outputs (F1b); the two ISO_5V LEDs have no board driver.
PULL-UPS: 3.9k throughout -- FIX ROUND 2: ACSL-6400/ACSL-6420 share ONE
datasheet RL-max (4k, Broadcom AV02-0235EN's family-wide table), which the
original 10k exceeded (same violation fix round 1 corrected on opto-ni.kicad_sch).
NI's 250mA budget does NOT apply here (this sheet runs off the board's own
isolated ISO_5V rail); ISO_5V/ISO_P12's own budget was checked from scratch --
~34-49mA of headroom against the shared TPS7A4901's 150mA cap either way.
Channels 2 and 4 of the ACSL-6420 (one per direction) are genuine spares -- real
LED+pull-up resistors populated, wired to their own uniquely-named, currently-
unused nets (OPTO_INTAN_SPARE1/2_*), same 'populate option, ready if needed'
convention the mule's own OPTO_SPARE1/2 channels already established.
POWER: ISO_5V, a NEW rail -- LD1117S50TR_SOT223 (same family/package as Task
7's own +3V3 stage) regulating ISO_P12 down to 5V, referenced INTAN_GND.
ISO_P12/ISO_N12 are +-12V (Task 7), too high for the ACSL-6400/6420 family's own
5.5V absolute-maximum VDD -- unlike mux-intan.kicad_sch's own difference
amplifiers, this sheet's digital logic cannot run directly off them. Only
ISO_P12 is consumed (a single positive LDO input); ISO_N12 is not needed.
RHS_STIM_OUT'S OWN INBOUND PROTECTION: a real Intan-domain BNC, 100R series +
BAT54S clamp to ISO_5V/INTAN_GND -- 'every panel input carries series
resistance and clamp diodes to the rails' (this project's own global
constraint), the SAME BAT54S topology gen_breakout_taskpc_digital.py's own
bidirectional_clamp() already validates, referenced to THIS sheet's own local
rails since the signal enters the Intan/isolated domain. Its assumed logic
sense (active-HIGH, TTL/CMOS-compatible) is an ASSUMPTION about real,
external, third-party Intan/RHS hardware this project has no datasheet for --
flagged here explicitly, the same class RWD_CMD's own polarity already
carries elsewhere in this project, needing bench confirmation before
commissioning.
CROSS-SHEET CONSEQUENCE, NOT A SCOPE OVERRUN: taskpc-digital.kicad_sch's own
temporary PWR_FLAG on RHS_STIM_OUT (Task 8, placed because nothing drove that
net yet) is deleted by this sheet's own build() -- see
gen_breakout_taskpc_digital.py's own _place_outbound(), which already flagged
this exact deletion as required the moment a real driver existed. Same class
Task 10d's own comparators.kicad_sch cleanup already established a precedent
for (PD1_COMP/PD2_COMP/ACC_TRIG's own flags, deleted there for the identical
reason).
PIN MAP VERIFICATION: ACSL-6400/ACSL-6420 against Broadcom AV02-0235EN (see
gen_wl_sync_lib.py's own module comment); BAT54S/LD1117S50TR_SOT223 are real
stock KiCad symbols, cross-checked directly against the raw library text via
extract_symbol()/unit_pins() (same technique this project uses for every
stock-symbol pin map, not assumed from the symbol name alone).
