jakewesterberg/wl-sync/hardware/breakout/sheets/opto-ni.kicad_sch

## KiCad design hardware/breakout/sheets/opto-ni.kicad_sch (2026-08-16)

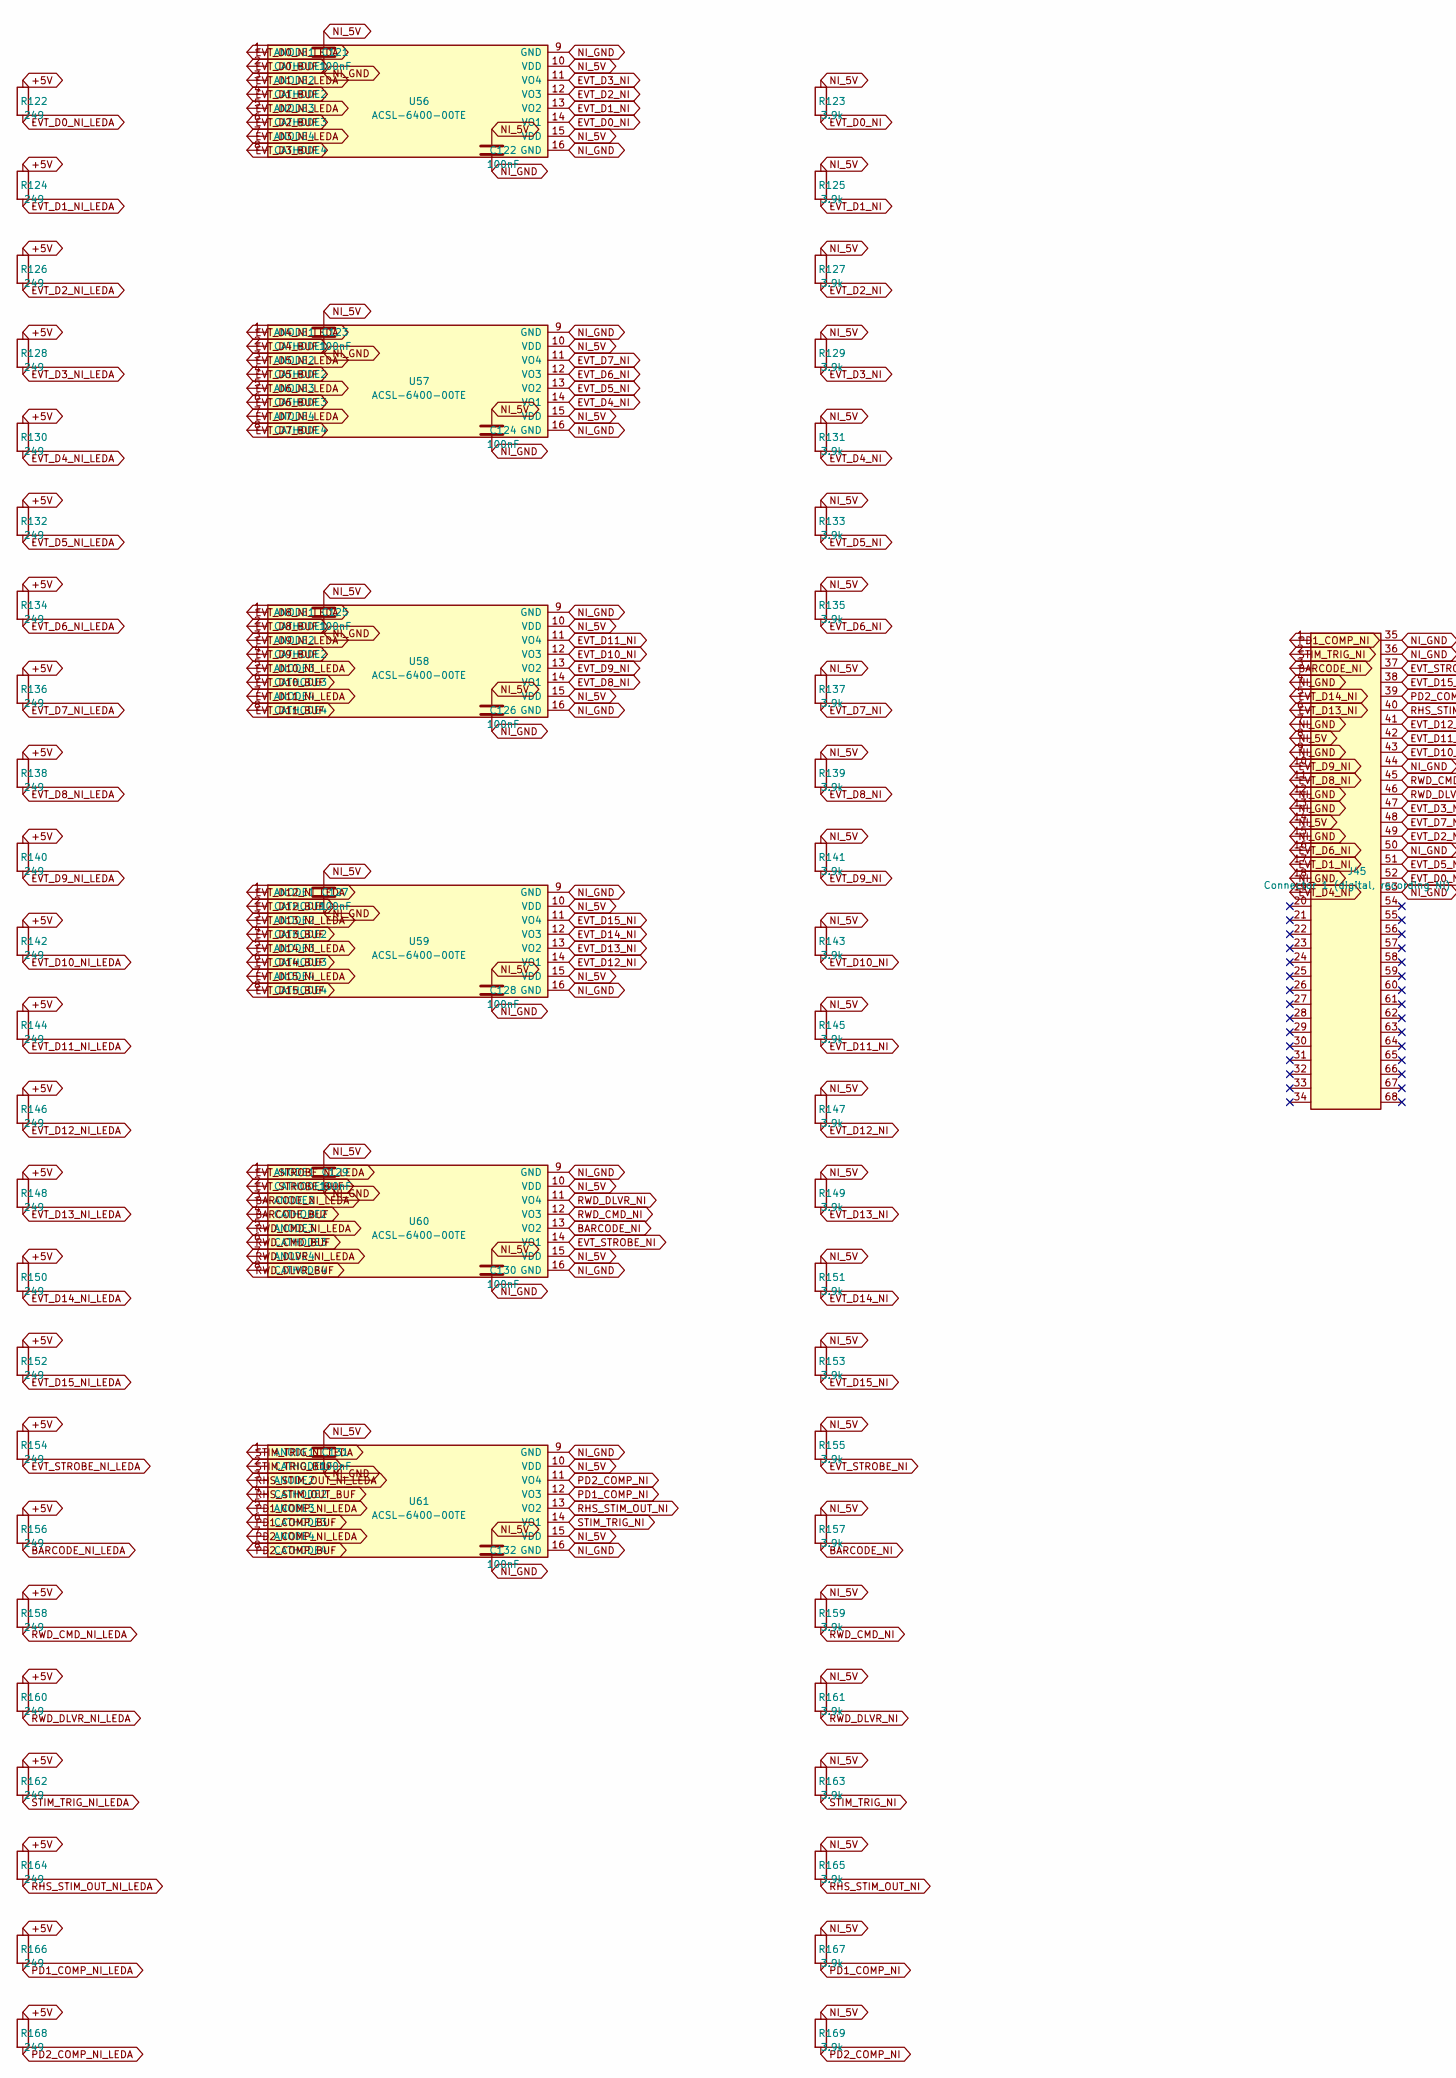
[picture p14: schematic opto-ni.kicad_sch, part in row 1, column 1]

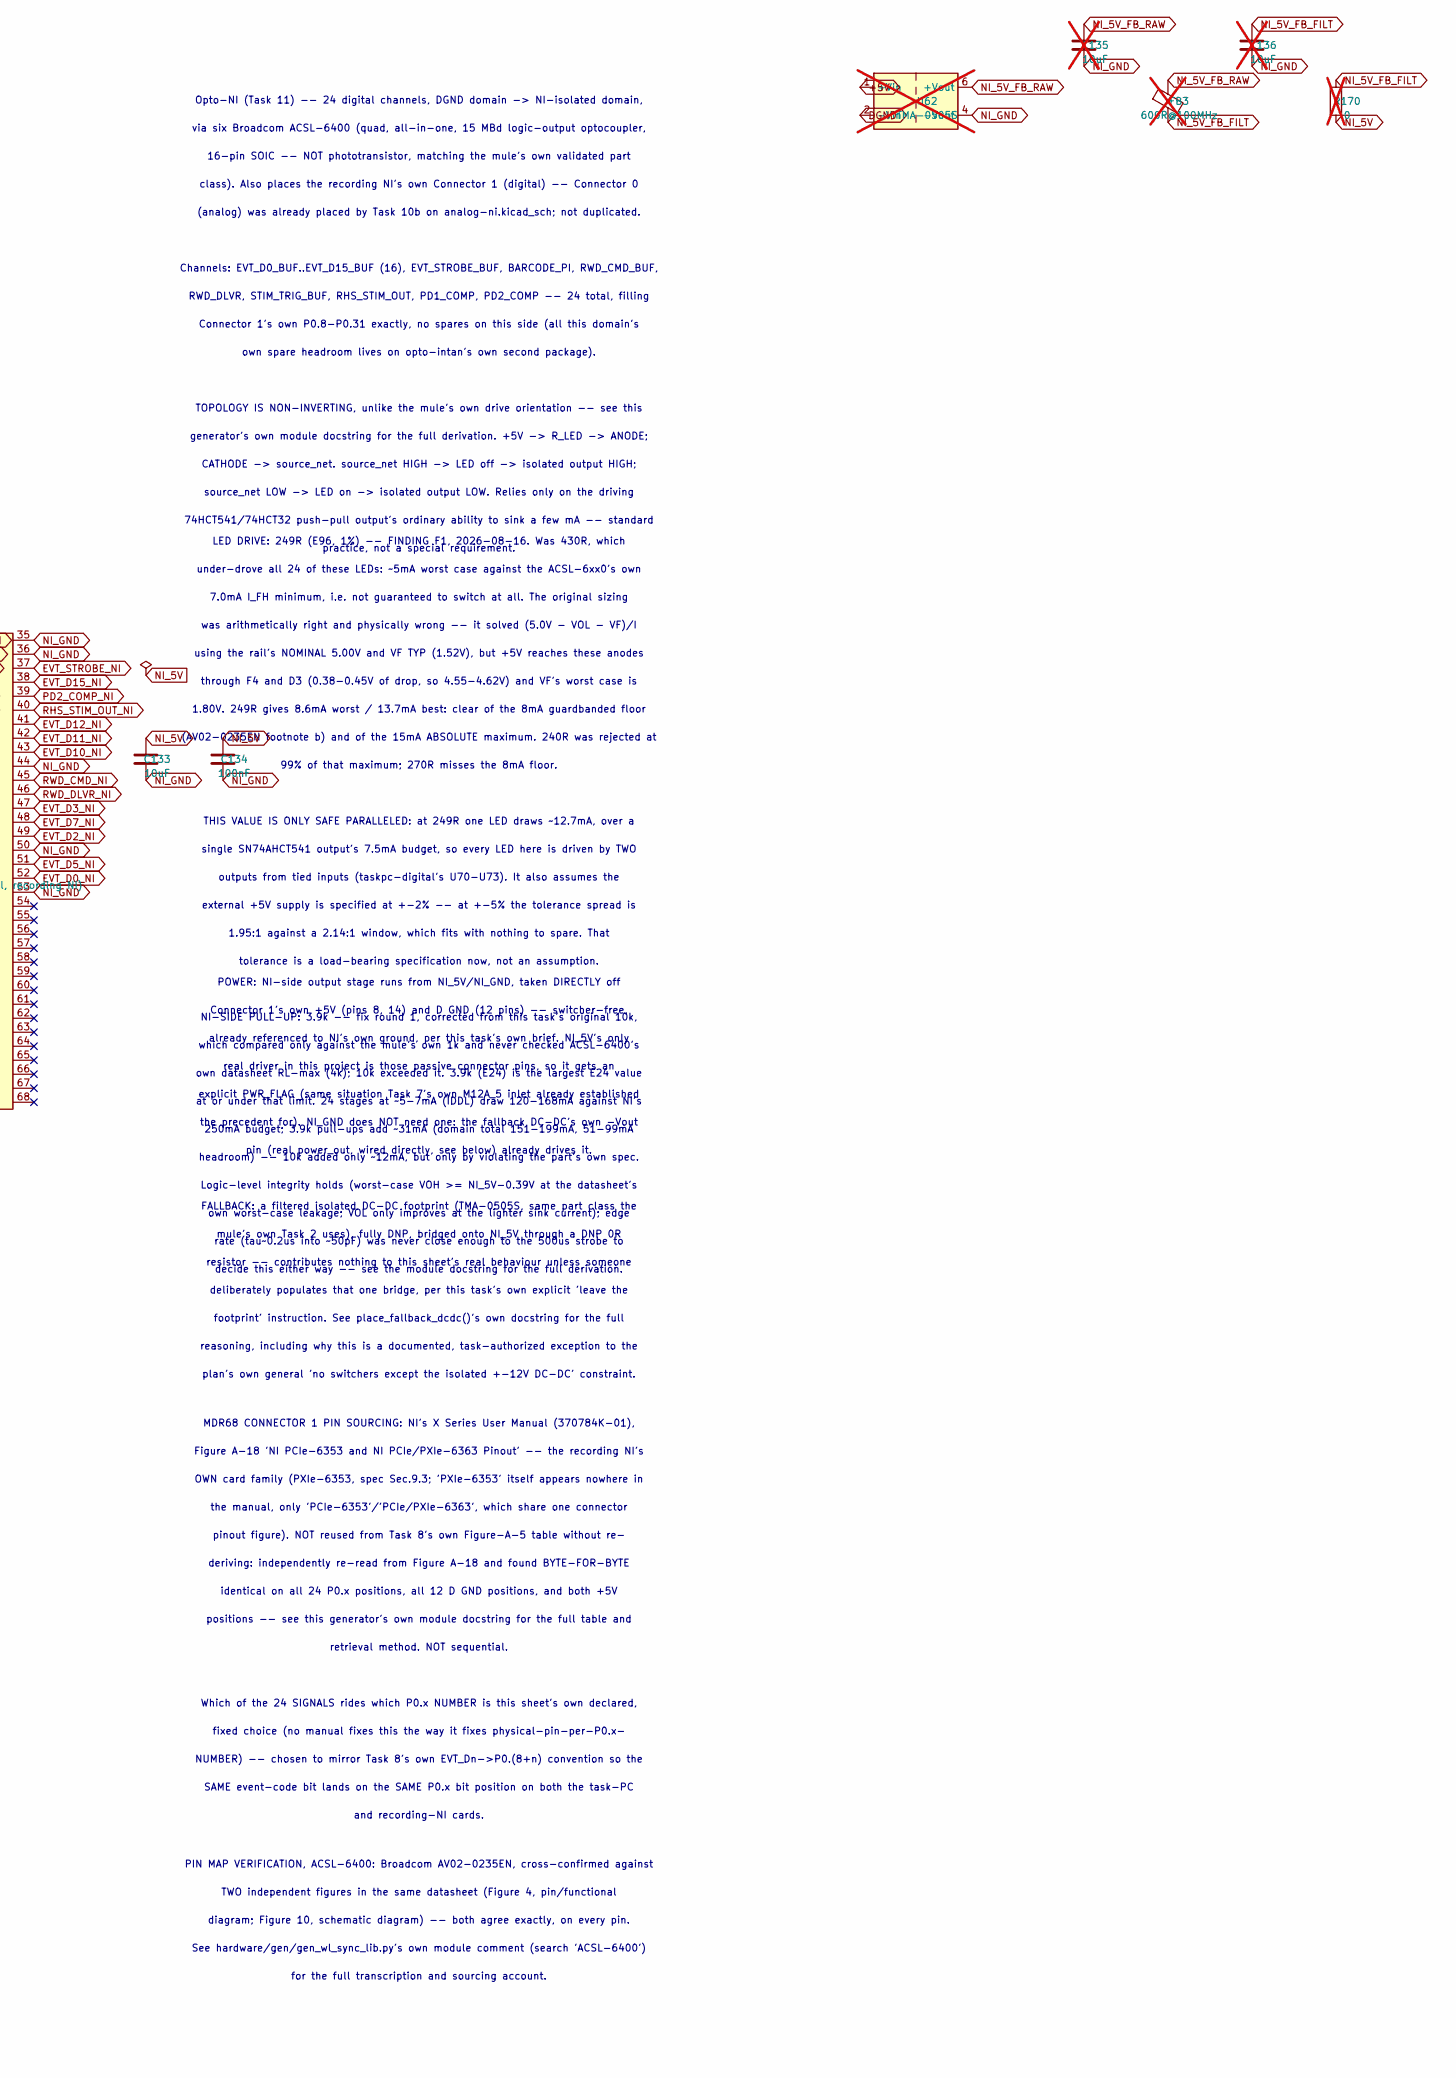
[picture p15: schematic opto-ni.kicad_sch, part in row 1, column 2]

Parts:
C121, C122, C123, C124, C125, C126, C127, C128, C129, C130, C131, C132, C134: 100nF; C_0603_1608Metric
C133: 10uF; C_1206_3216Metric
C135, C136: 10uF; C_1206_3216Metric; not fitted
FB3: 600R@100MHz; L_0805_2012Metric; not fitted
J45: Connector 1 (digital, recording NI); MDR68_Male_RightAngle
R122, R124, R126, R128, R130, R132, R134, R136, R138, R140, R142, R144, R146, R148, R150, R152, R154, R156, R158, R160, R162, R164, R166, R168: 249; R_0603_1608Metric
R123, R125, R127, R129, R131, R133, R135, R137, R139, R141, R143, R145, R147, R149, R151, R153, R155, R157, R159, R161, R163, R165, R167, R169: 3.9k; R_0603_1608Metric
R170: 0; R_0603_1608Metric; not fitted
U56, U57, U58, U59, U60, U61: ACSL-6400-00TE; SOIC-16_3.9x9.9mm_P1.27mm
U62: TMA-0505S; Converter_DCDC_TRACO_TMA-05xxS_12xxS_Single_THT; not fitted

Connections:
+5V: R122.1, R124.1, R126.1, R128.1, R130.1, R132.1, R134.1, R136.1, R138.1, R140.1, R142.1, R144.1, R146.1, R148.1, R150.1, R152.1, R154.1, R156.1, R158.1, R160.1, R162.1, R164.1, R166.1, R168.1, U62.1 (+Vin)
BARCODE_BUF: U60.4 (CATHODE2)
BARCODE_NI: J45.3, R157.2, U60.13 (VO2)
BARCODE_NI_LEDA: R156.2, U60.3 (ANODE2)
DGND: U62.2 (-Vin)
EVT_D0_BUF: U56.2 (CATHODE1)
EVT_D0_NI: J45.52, R123.2, U56.14 (VO1)
EVT_D0_NI_LEDA: R122.2, U56.1 (ANODE1)
EVT_D1_BUF: U56.4 (CATHODE2)
EVT_D1_NI: J45.17, R125.2, U56.13 (VO2)
EVT_D1_NI_LEDA: R124.2, U56.3 (ANODE2)
EVT_D2_BUF: U56.6 (CATHODE3)
EVT_D2_NI: J45.49, R127.2, U56.12 (VO3)
EVT_D2_NI_LEDA: R126.2, U56.5 (ANODE3)
EVT_D3_BUF: U56.8 (CATHODE4)
EVT_D3_NI: J45.47, R129.2, U56.11 (VO4)
EVT_D3_NI_LEDA: R128.2, U56.7 (ANODE4)
EVT_D4_BUF: U57.2 (CATHODE1)
EVT_D4_NI: J45.19, R131.2, U57.14 (VO1)
EVT_D4_NI_LEDA: R130.2, U57.1 (ANODE1)
EVT_D5_BUF: U57.4 (CATHODE2)
EVT_D5_NI: J45.51, R133.2, U57.13 (VO2)
EVT_D5_NI_LEDA: R132.2, U57.3 (ANODE2)
EVT_D6_BUF: U57.6 (CATHODE3)
EVT_D6_NI: J45.16, R135.2, U57.12 (VO3)
EVT_D6_NI_LEDA: R134.2, U57.5 (ANODE3)
EVT_D7_BUF: U57.8 (CATHODE4)
EVT_D7_NI: J45.48, R137.2, U57.11 (VO4)
EVT_D7_NI_LEDA: R136.2, U57.7 (ANODE4)
EVT_D8_BUF: U58.2 (CATHODE1)
EVT_D8_NI: J45.11, R139.2, U58.14 (VO1)
EVT_D8_NI_LEDA: R138.2, U58.1 (ANODE1)
EVT_D9_BUF: U58.4 (CATHODE2)
EVT_D9_NI: J45.10, R141.2, U58.13 (VO2)
EVT_D9_NI_LEDA: R140.2, U58.3 (ANODE2)
EVT_D10_BUF: U58.6 (CATHODE3)
EVT_D10_NI: J45.43, R143.2, U58.12 (VO3)
EVT_D10_NI_LEDA: R142.2, U58.5 (ANODE3)
EVT_D11_BUF: U58.8 (CATHODE4)
EVT_D11_NI: J45.42, R145.2, U58.11 (VO4)
EVT_D11_NI_LEDA: R144.2, U58.7 (ANODE4)
EVT_D12_BUF: U59.2 (CATHODE1)
EVT_D12_NI: J45.41, R147.2, U59.14 (VO1)
EVT_D12_NI_LEDA: R146.2, U59.1 (ANODE1)
EVT_D13_BUF: U59.4 (CATHODE2)
EVT_D13_NI: J45.6, R149.2, U59.13 (VO2)
EVT_D13_NI_LEDA: R148.2, U59.3 (ANODE2)
EVT_D14_BUF: U59.6 (CATHODE3)
EVT_D14_NI: J45.5, R151.2, U59.12 (VO3)
EVT_D14_NI_LEDA: R150.2, U59.5 (ANODE3)
EVT_D15_BUF: U59.8 (CATHODE4)
EVT_D15_NI: J45.38, R153.2, U59.11 (VO4)
EVT_D15_NI_LEDA: R152.2, U59.7 (ANODE4)
EVT_STROBE_BUF: U60.2 (CATHODE1)
EVT_STROBE_NI: J45.37, R155.2, U60.14 (VO1)
EVT_STROBE_NI_LEDA: R154.2, U60.1 (ANODE1)
NI_5V: C121.1, C122.1, C123.1, C124.1, C125.1, C126.1, C127.1, C128.1, C129.1, C130.1, C131.1, C132.1, C133.1, C134.1, J45.8, J45.14, R123.1, R125.1, R127.1, R129.1, R131.1, R133.1, R135.1, R137.1, R139.1, R141.1, R143.1, R145.1, R147.1, R149.1, R151.1, R153.1, R155.1, R157.1, R159.1, R161.1, R163.1, R165.1, R167.1, R169.1, R170.2, U56.10 (VDD), U56.15 (VDD), U57.10 (VDD), U57.15 (VDD), U58.10 (VDD), U58.15 (VDD), U59.10 (VDD), U59.15 (VDD), U60.10 (VDD), U60.15 (VDD), U61.10 (VDD), U61.15 (VDD)
NI_5V_FB_FILT: C136.1, FB3.2, R170.1
NI_5V_FB_RAW: C135.1, FB3.1, U62.6 (+Vout)
NI_GND: C121.2, C122.2, C123.2, C124.2, C125.2, C126.2, C127.2, C128.2, C129.2, C130.2, C131.2, C132.2, C133.2, C134.2, C135.2, C136.2, J45.4, J45.7, J45.9, J45.12, J45.13, J45.15, J45.18, J45.35, J45.36, J45.44, J45.50, J45.53, U56.9 (GND), U56.16 (GND), U57.9 (GND), U57.16 (GND), U58.9 (GND), U58.16 (GND), U59.9 (GND), U59.16 (GND), U60.9 (GND), U60.16 (GND), U61.9 (GND), U61.16 (GND), U62.4 (-Vout)
PD1_COMP_BUF: U61.6 (CATHODE3)
PD1_COMP_NI: J45.1, R167.2, U61.12 (VO3)
PD1_COMP_NI_LEDA: R166.2, U61.5 (ANODE3)
PD2_COMP_BUF: U61.8 (CATHODE4)
PD2_COMP_NI: J45.39, R169.2, U61.11 (VO4)
PD2_COMP_NI_LEDA: R168.2, U61.7 (ANODE4)
RHS_STIM_OUT_BUF: U61.4 (CATHODE2)
RHS_STIM_OUT_NI: J45.40, R165.2, U61.13 (VO2)
RHS_STIM_OUT_NI_LEDA: R164.2, U61.3 (ANODE2)
RWD_CMD_BUF: U60.6 (CATHODE3)
RWD_CMD_NI: J45.45, R159.2, U60.12 (VO3)
RWD_CMD_NI_LEDA: R158.2, U60.5 (ANODE3)
RWD_DLVR_BUF: U60.8 (CATHODE4)
RWD_DLVR_NI: J45.46, R161.2, U60.11 (VO4)
RWD_DLVR_NI_LEDA: R160.2, U60.7 (ANODE4)
STIM_TRIG_BUF: U61.2 (CATHODE1)
STIM_TRIG_NI: J45.2, R163.2, U61.14 (VO1)
STIM_TRIG_NI_LEDA: R162.2, U61.1 (ANODE1)

Notes on the sheet:
Opto-NI (Task 11) -- 24 digital channels, DGND domain -> NI-isolated domain,
via six Broadcom ACSL-6400 (quad, all-in-one, 15 MBd logic-output optocoupler,
16-pin SOIC -- NOT phototransistor, matching the mule's own validated part
class). Also places the recording NI's own Connector 1 (digital) -- Connector 0
(analog) was already placed by Task 10b on analog-ni.kicad_sch; not duplicated.
Channels: EVT_D0_BUF..EVT_D15_BUF (16), EVT_STROBE_BUF, BARCODE_PI, RWD_CMD_BUF,
RWD_DLVR, STIM_TRIG_BUF, RHS_STIM_OUT, PD1_COMP, PD2_COMP -- 24 total, filling
Connector 1's own P0.8-P0.31 exactly, no spares on this side (all this domain's
own spare headroom lives on opto-intan's own second package).
TOPOLOGY IS NON-INVERTING, unlike the mule's own drive orientation -- see this
generator's own module docstring for the full derivation. +5V -> R_LED -> ANODE;
CATHODE -> source_net. source_net HIGH -> LED off -> isolated output HIGH;
source_net LOW -> LED on -> isolated output LOW. Relies only on the driving
74HCT541/74HCT32 push-pull output's ordinary ability to sink a few mA -- standard
practice, not a special requirement.
LED DRIVE: 249R (E96, 1%) -- FINDING F1, 2026-08-16. Was 430R, which
under-drove all 24 of these LEDs: ~5mA worst case against the ACSL-6xx0's own
7.0mA I_FH minimum, i.e. not guaranteed to switch at all. The original sizing
was arithmetically right and physically wrong -- it solved (5.0V - VOL - VF)/I
using the rail's NOMINAL 5.00V and VF TYP (1.52V), but +5V reaches these anodes
through F4 and D3 (0.38-0.45V of drop, so 4.55-4.62V) and VF's worst case is
1.80V. 249R gives 8.6mA worst / 13.7mA best: clear of the 8mA guardbanded floor
(AV02-0235EN footnote b) and of the 15mA ABSOLUTE maximum. 240R was rejected at
99% of that maximum; 270R misses the 8mA floor.
THIS VALUE IS ONLY SAFE PARALLELED: at 249R one LED draws ~12.7mA, over a
single SN74AHCT541 output's 7.5mA budget, so every LED here is driven by TWO
outputs from tied inputs (taskpc-digital's U70-U73). It also assumes the
external +5V supply is specified at +-2% -- at +-5% the tolerance spread is
1.95:1 against a 2.14:1 window, which fits with nothing to spare. That
tolerance is a load-bearing specification now, not an assumption.
NI-SIDE PULL-UP: 3.9k -- fix round 1, corrected from this task's original 10k,
which compared only against the mule's own 1k and never checked ACSL-6400's
own datasheet RL-max (4k); 10k exceeded it. 3.9k (E24) is the largest E24 value
at or under that limit. 24 stages at ~5-7mA (IDDL) draw 120-168mA against NI's
250mA budget; 3.9k pull-ups add ~31mA (domain total 151-199mA, 51-99mA
headroom) -- 10k added only ~12mA, but only by violating the part's own spec.
Logic-level integrity holds (worst-case VOH >= NI_5V-0.39V at the datasheet's
own worst-case leakage; VOL only improves at the lighter sink current); edge
rate (tau~0.2us into ~50pF) was never close enough to the 500us strobe to
decide this either way -- see the module docstring for the full derivation.
POWER: NI-side output stage runs from NI_5V/NI_GND, taken DIRECTLY off
Connector 1's own +5V (pins 8, 14) and D GND (12 pins) -- switcher-free,
already referenced to NI's own ground, per this task's own brief. NI_5V's only
real driver in this project is those passive connector pins, so it gets an
explicit PWR_FLAG (same situation Task 7's own M12A_5 inlet already established
the precedent for). NI_GND does NOT need one: the fallback DC-DC's own -Vout
pin (real power_out, wired directly, see below) already drives it.
FALLBACK: a filtered isolated DC-DC footprint (TMA-0505S, same part class the
mule's own Task 2 uses), fully DNP, bridged onto NI_5V through a DNP 0R
resistor -- contributes nothing to this sheet's real behaviour unless someone
deliberately populates that one bridge, per this task's own explicit 'leave the
footprint' instruction. See place_fallback_dcdc()'s own docstring for the full
reasoning, including why this is a documented, task-authorized exception to the
plan's own general 'no switchers except the isolated +-12V DC-DC' constraint.
MDR68 CONNECTOR 1 PIN SOURCING: NI's X Series User Manual (370784K-01),
Figure A-18 'NI PCIe-6353 and NI PCIe/PXIe-6363 Pinout' -- the recording NI's
OWN card family (PXIe-6353, spec Sec.9.3; 'PXIe-6353' itself appears nowhere in
the manual, only 'PCIe-6353'/'PCIe/PXIe-6363', which share one connector
pinout figure). NOT reused from Task 8's own Figure-A-5 table without re-
deriving: independently re-read from Figure A-18 and found BYTE-FOR-BYTE
identical on all 24 P0.x positions, all 12 D GND positions, and both +5V
positions -- see this generator's own module docstring for the full table and
retrieval method. NOT sequential.
Which of the 24 SIGNALS rides which P0.x NUMBER is this sheet's own declared,
fixed choice (no manual fixes this the way it fixes physical-pin-per-P0.x-
NUMBER) -- chosen to mirror Task 8's own EVT_Dn->P0.(8+n) convention so the
SAME event-code bit lands on the SAME P0.x bit position on both the task-PC
and recording-NI cards.
PIN MAP VERIFICATION, ACSL-6400: Broadcom AV02-0235EN, cross-confirmed against
TWO independent figures in the same datasheet (Figure 4, pin/functional
diagram; Figure 10, schematic diagram) -- both agree exactly, on every pin.
See hardware/gen/gen_wl_sync_lib.py's own module comment (search 'ACSL-6400')
for the full transcription and sourcing account.
