jakewesterberg/wl-sync/hardware/breakout/sheets/pi-interface.kicad_sch

## KiCad design hardware/breakout/sheets/pi-interface.kicad_sch (2026-10-18)

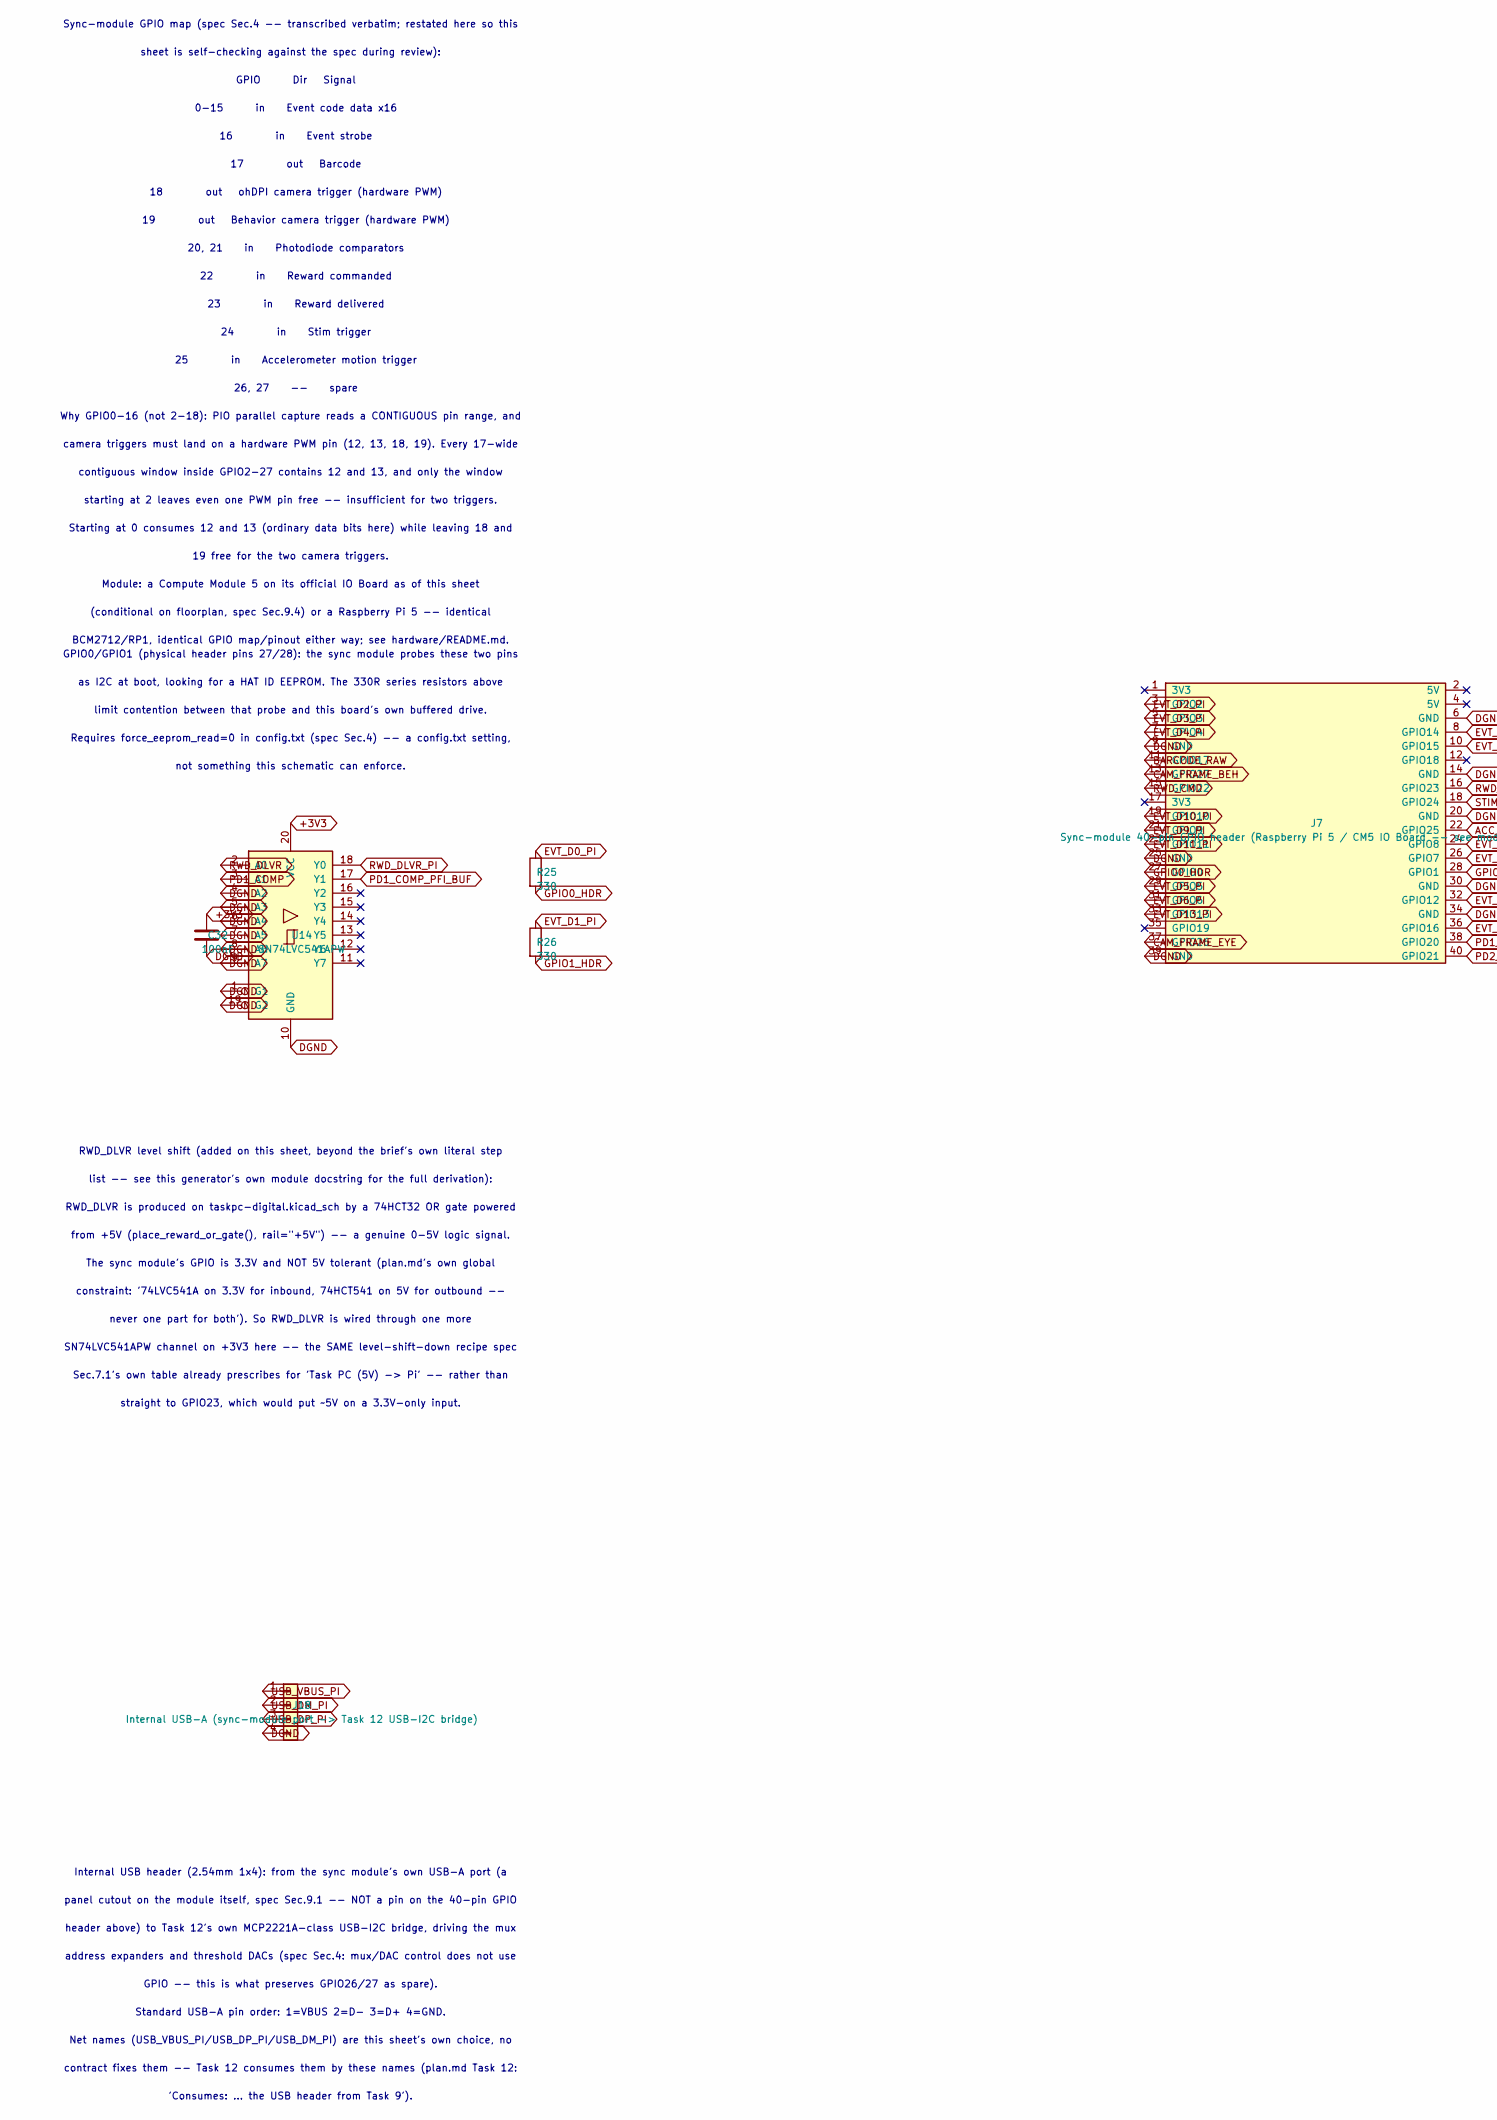
[picture p16: schematic pi-interface.kicad_sch, part in row 1, column 1]

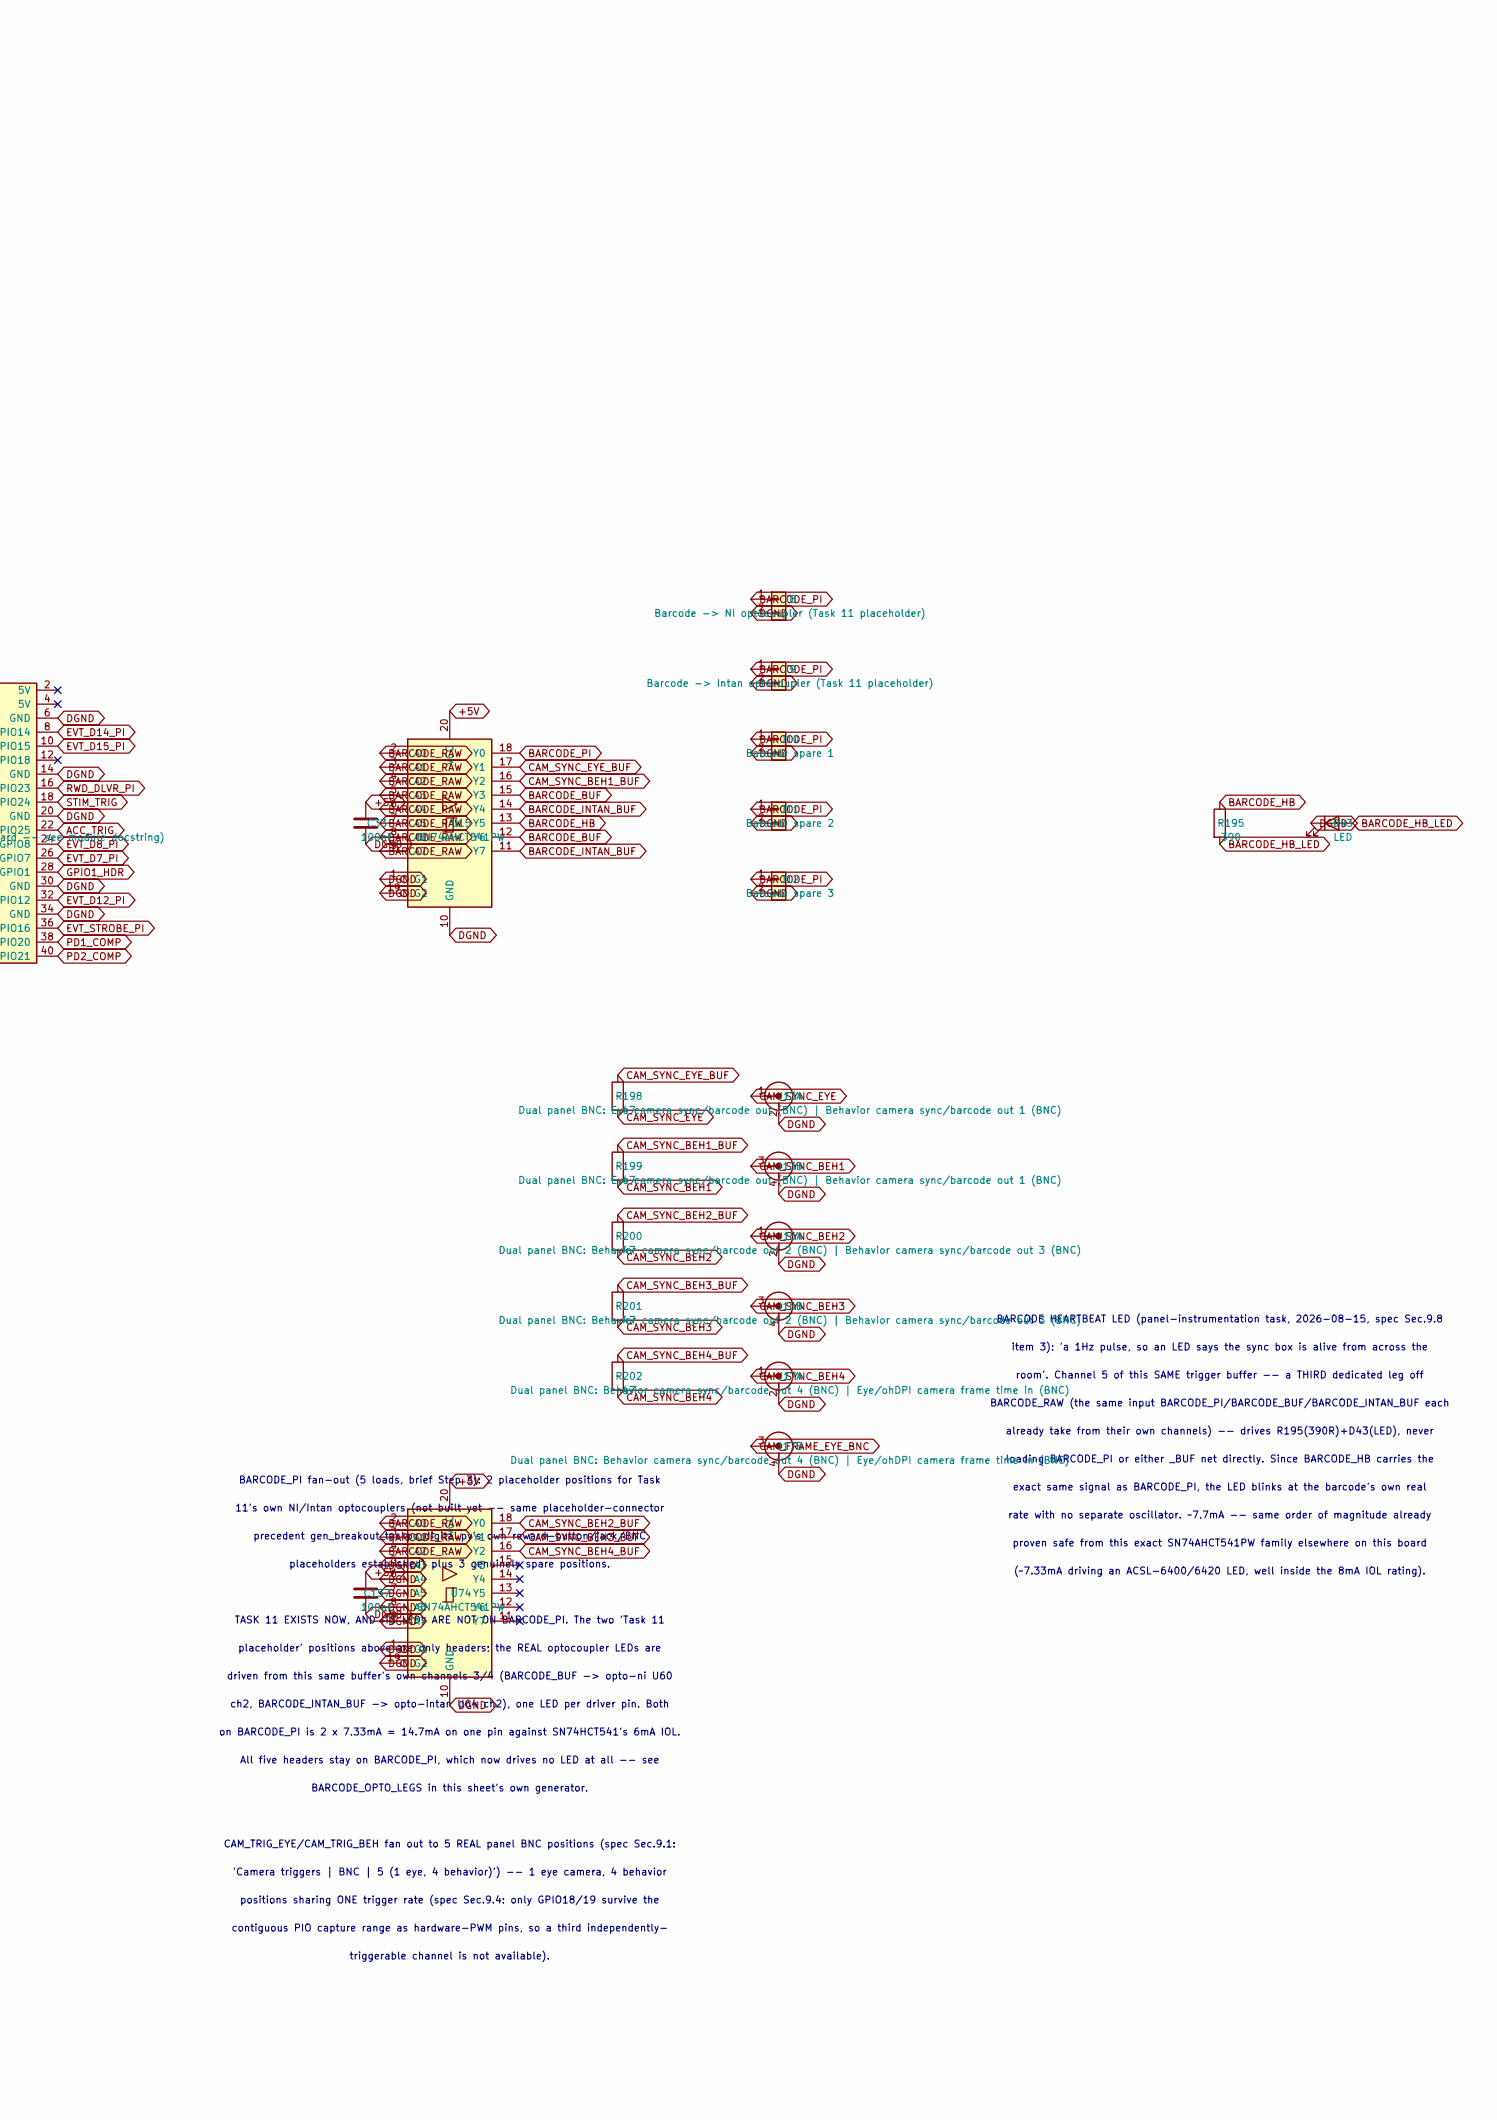
[picture p17: schematic pi-interface.kicad_sch, part in row 1, column 2]

Parts:
C32, C33, C157: 100nF; C_0603_1608Metric
D43: LED; LED_0603_1608Metric_Pad1.05x0.95mm_HandSolder
J7: Sync-module 40-pin GPIO header (Raspberry Pi 5 / 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; PinHeader_2x20_P2.54mm_Vertical
J8: Barcode -> NI optocoupler (Task 11 placeholder); PinHeader_1x02_P2.54mm_Vertical
J9: Barcode -> Intan optocoupler (Task 11 placeholder); PinHeader_1x02_P2.54mm_Vertical
J10: Barcode spare 1; PinHeader_1x02_P2.54mm_Vertical
J11: Barcode spare 2; PinHeader_1x02_P2.54mm_Vertical
J12: Barcode spare 3; PinHeader_1x02_P2.54mm_Vertical
J13: Dual panel BNC: Eye camera sync/barcode out (BNC)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; BNC_Dual_RA_Isolated
J15, J17: Dual panel BNC: Behavior camera sync/barcode out 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; BNC_Dual_RA_Isolated
J18: Internal USB-A (sync-module port -> Task 12 USB-I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; PinHeader_1x04_P2.54mm_Vertical
R25, R26: 330; R_0603_1608Metric
R195: 390; R_0603_1608Metric
R198, R199, R200, R201, R202: 47; R_0603_1608Metric
U14: SN74LVC541APW; Texas_PW0020A_TSSOP-20_4.4x6.5mm_P0.65mm
U15, U74: SN74AHCT541PW; Texas_PW0020A_TSSOP-20_4.4x6.5mm_P0.65mm

Connections:
+3V3: C32.1, U14.20 (VCC)
+5V: C33.1, C157.1, U15.20 (VCC), U74.20 (VCC)
ACC_TRIG: J7.22 (GPIO25)
BARCODE_BUF: U15.12 (Y6), U15.15 (Y3)
BARCODE_HB: R195.1, U15.13 (Y5)
BARCODE_HB_LED: D43.2 (A), R195.2
BARCODE_INTAN_BUF: U15.11 (Y7), U15.14 (Y4)
BARCODE_PI: J8.1, J9.1, J10.1, J11.1, J12.1, U15.18 (Y0)
BARCODE_RAW: J7.11 (GPIO17), U15.2 (A0), U15.3 (A1), U15.4 (A2), U15.5 (A3), U15.6 (A4), U15.7 (A5), U15.8 (A6), U15.9 (A7), U74.2 (A0), U74.3 (A1), U74.4 (A2)
CAM_FRAME_BEH: J7.13 (GPIO27)
CAM_FRAME_EYE: J7.37 (GPIO26)
CAM_FRAME_EYE_BNC: J17.3 (B_In)
CAM_SYNC_BEH1: J13.3 (B_In), R199.2
CAM_SYNC_BEH1_BUF: R199.1, U15.16 (Y2)
CAM_SYNC_BEH2: J15.1 (A_In), R200.2
CAM_SYNC_BEH2_BUF: R200.1, U74.18 (Y0)
CAM_SYNC_BEH3: J15.3 (B_In), R201.2
CAM_SYNC_BEH3_BUF: R201.1, U74.17 (Y1)
CAM_SYNC_BEH4: J17.1 (A_In), R202.2
CAM_SYNC_BEH4_BUF: R202.1, U74.16 (Y2)
CAM_SYNC_EYE: J13.1 (A_In), R198.2
CAM_SYNC_EYE_BUF: R198.1, U15.17 (Y1)
DGND: C32.2, C33.2, C157.2, D43.1 (K), J7.6 (GND), J7.9 (GND), J7.14 (GND), J7.20 (GND), J7.25 (GND), J7.30 (GND), J7.34 (GND), J7.39 (GND), J8.2, J9.2, J10.2, J11.2, J12.2, J13.2 (A_Ext), J13.4 (B_Ext), J15.2 (A_Ext), J15.4 (B_Ext), J17.2 (A_Ext), J17.4 (B_Ext), J18.4, U14.1 (G1), U14.4 (A2), U14.5 (A3), U14.6 (A4), U14.7 (A5), U14.8 (A6), U14.9 (A7), U14.10 (GND), U14.19 (G2), U15.1 (G1), U15.10 (GND), U15.19 (G2), U74.1 (G1), U74.5 (A3), U74.6 (A4), U74.7 (A5), U74.8 (A6), U74.9 (A7), U74.10 (GND), U74.19 (G2)
EVT_D0_PI: R25.1
EVT_D1_PI: R26.1
EVT_D2_PI: J7.3 (GPIO2)
EVT_D3_PI: J7.5 (GPIO3)
EVT_D4_PI: J7.7 (GPIO4)
EVT_D5_PI: J7.29 (GPIO5)
EVT_D6_PI: J7.31 (GPIO6)
EVT_D7_PI: J7.26 (GPIO7)
EVT_D8_PI: J7.24 (GPIO8)
EVT_D9_PI: J7.21 (GPIO9)
EVT_D10_PI: J7.19 (GPIO10)
EVT_D11_PI: J7.23 (GPIO11)
EVT_D12_PI: J7.32 (GPIO12)
EVT_D13_PI: J7.33 (GPIO13)
EVT_D14_PI: J7.8 (GPIO14)
EVT_D15_PI: J7.10 (GPIO15)
EVT_STROBE_PI: J7.36 (GPIO16)
GPIO0_HDR: J7.27 (GPIO0), R25.2
GPIO1_HDR: J7.28 (GPIO1), R26.2
PD1_COMP: J7.38 (GPIO20), U14.3 (A1)
PD1_COMP_PFI_BUF: U14.17 (Y1)
PD2_COMP: J7.40 (GPIO21)
RWD_CMD: J7.15 (GPIO22)
RWD_DLVR: U14.2 (A0)
RWD_DLVR_PI: J7.16 (GPIO23), U14.18 (Y0)
STIM_TRIG: J7.18 (GPIO24)
USB_DM_PI: J18.2
USB_DP_PI: J18.3
USB_VBUS_PI: J18.1

Notes on the sheet:
not something this schematic can enforce.
Sec.7.1's own table already prescribes for 'Task PC (5V) -> Pi' -- rather than
as I2C at boot, looking for a HAT ID EEPROM. The 330R series resistors above
constraint: '74LVC541A on 3.3V for inbound, 74HCT541 on 5V for outbound --
contiguous window inside GPIO2-27 contains 12 and 13, and only the window
24 in Stim trigger
Sync-module GPIO map (spec Sec.4 -- transcribed verbatim; restated here so this
RWD_DLVR is produced on taskpc-digital.kicad_sch by a 74HCT32 OR gate powered
GPIO0/GPIO1 (physical header pins 27/28): the sync module probes these two pins
ch2, BARCODE_INTAN_BUF -> opto-intan U64 ch2), one LED per driver pin. Both
(~7.33mA driving an ACSL-6400/6420 LED, well inside the 8mA IOL rating).
precedent gen_breakout_taskpc_digital.py's own reward-button/jack/BNC
0-15 in Event code data x16
already take from their own channels) -- drives R195(390R)+D43(LED), never
GPIO Dir Signal
BARCODE HEARTBEAT LED (panel-instrumentation task, 2026-08-15, spec Sec.9.8
SN74LVC541APW channel on +3V3 here -- the SAME level-shift-down recipe spec
exact same signal as BARCODE_PI, the LED blinks at the barcode's own real
camera triggers must land on a hardware PWM pin (12, 13, 18, 19). Every 17-wide
contiguous PIO capture range as hardware-PWM pins, so a third independently-
BCM2712/RP1, identical GPIO map/pinout either way; see hardware/README.md.
CAM_TRIG_EYE/CAM_TRIG_BEH fan out to 5 REAL panel BNC positions (spec Sec.9.1:
placeholders established) plus 3 genuinely spare positions.
Requires force_eeprom_read=0 in config.txt (spec Sec.4) -- a config.txt setting,
23 in Reward delivered
Why GPIO0-16 (not 2-18): PIO parallel capture reads a CONTIGUOUS pin range, and
address expanders and threshold DACs (spec Sec.4: mux/DAC control does not use
11's own NI/Intan optocouplers (not built yet -- same placeholder-connector
never one part for both'). So RWD_DLVR is wired through one more
Net names (USB_VBUS_PI/USB_DP_PI/USB_DM_PI) are this sheet's own choice, no
Standard USB-A pin order: 1=VBUS 2=D- 3=D+ 4=GND.
'Camera triggers | BNC | 5 (1 eye, 4 behavior)') -- 1 eye camera, 4 behavior
BARCODE_RAW (the same input BARCODE_PI/BARCODE_BUF/BARCODE_INTAN_BUF each
on BARCODE_PI is 2 x 7.33mA = 14.7mA on one pin against SN74HCT541's 6mA IOL.
room'. Channel 5 of this SAME trigger buffer -- a THIRD dedicated leg off
panel cutout on the module itself, spec Sec.9.1 -- NOT a pin on the 40-pin GPIO
BARCODE_OPTO_LEGS in this sheet's own generator.
triggerable channel is not available).
16 in Event strobe
18 out ohDPI camera trigger (hardware PWM)
All five headers stay on BARCODE_PI, which now drives no LED at all -- see
limit contention between that probe and this board's own buffered drive.
The sync module's GPIO is 3.3V and NOT 5V tolerant (plan.md's own global
(conditional on floorplan, spec Sec.9.4) or a Raspberry Pi 5 -- identical
from +5V (place_reward_or_gate(), rail="+5V") -- a genuine 0-5V logic signal.
GPIO -- this is what preserves GPIO26/27 as spare).
Internal USB header (2.54mm 1x4): from the sync module's own USB-A port (a
starting at 2 leaves even one PWM pin free -- insufficient for two triggers.
rate with no separate oscillator. ~7.7mA -- same order of magnitude already
placeholder' positions above are only headers; the REAL optocoupler LEDs are
22 in Reward commanded
25 in Accelerometer motion trigger
26, 27 -- spare
TASK 11 EXISTS NOW, AND ITS LEDs ARE NOT ON BARCODE_PI. The two 'Task 11
BARCODE_PI fan-out (5 loads, brief Step 3): 2 placeholder positions for Task
proven safe from this exact SN74AHCT541PW family elsewhere on this board
'Consumes: ... the USB header from Task 9').
list -- see this generator's own module docstring for the full derivation):
positions sharing ONE trigger rate (spec Sec.9.4: only GPIO18/19 survive the
straight to GPIO23, which would put ~5V on a 3.3V-only input.
19 out Behavior camera trigger (hardware PWM)
Starting at 0 consumes 12 and 13 (ordinary data bits here) while leaving 18 and
19 free for the two camera triggers.
contract fixes them -- Task 12 consumes them by these names (plan.md Task 12:
RWD_DLVR level shift (added on this sheet, beyond the brief's own literal step
item 3): 'a 1Hz pulse, so an LED says the sync box is alive from across the
header above) to Task 12's own MCP2221A-class USB-I2C bridge, driving the mux
Module: a Compute Module 5 on its official IO Board as of this sheet
driven from this same buffer's own channels 3/4 (BARCODE_BUF -> opto-ni U60
loading BARCODE_PI or either _BUF net directly. Since BARCODE_HB carries the
sheet is self-checking against the spec during review):
20, 21 in Photodiode comparators
17 out Barcode
