jakewesterberg/wl-sync/hardware/breakout/sheets/power.kicad_sch

## KiCad design hardware/breakout/sheets/power.kicad_sch (2026-08-16)

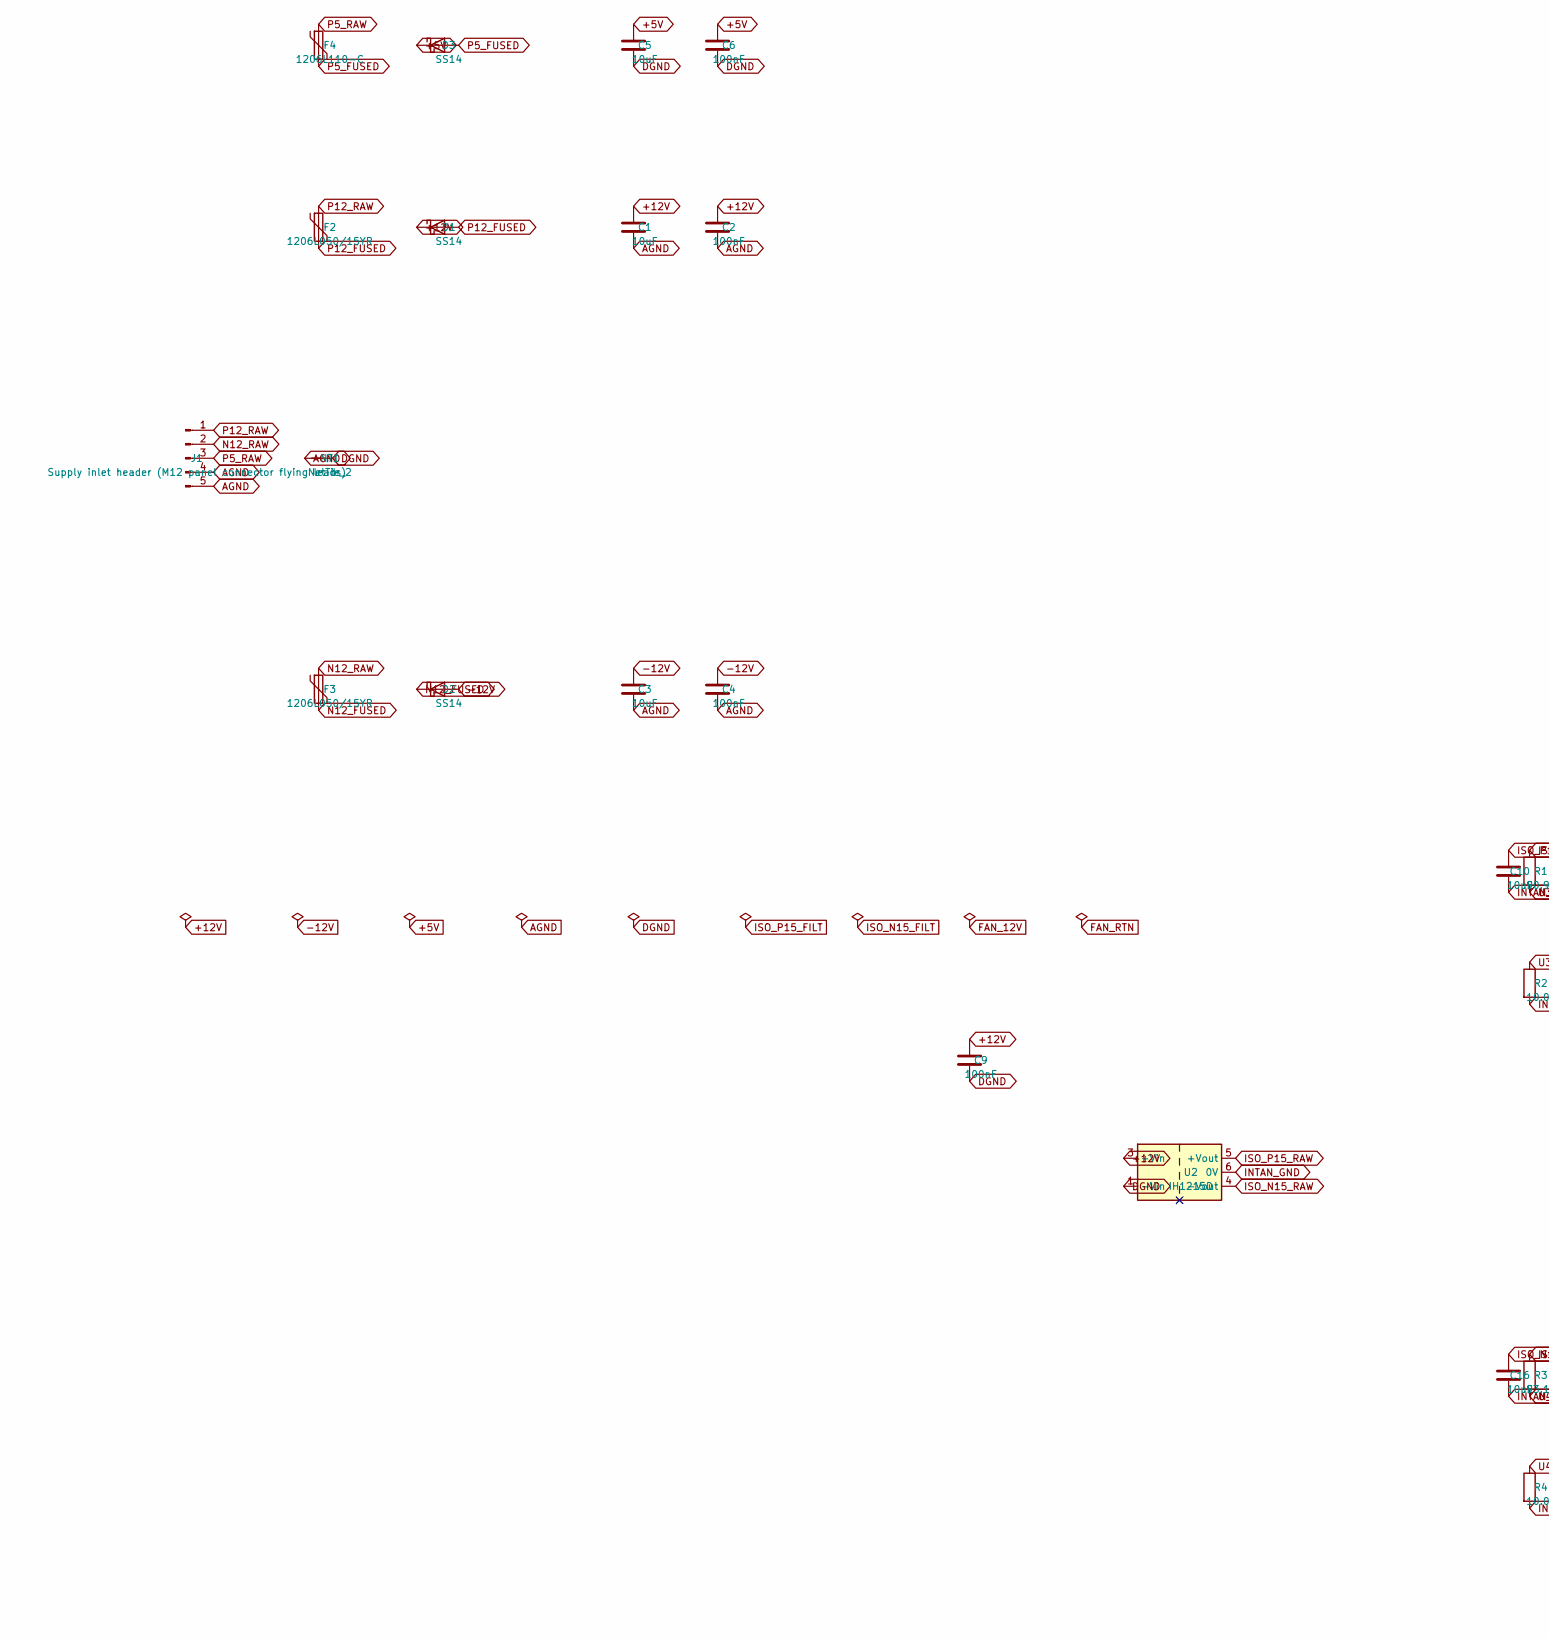
[picture p18: schematic power.kicad_sch, part in row 1, column 1]

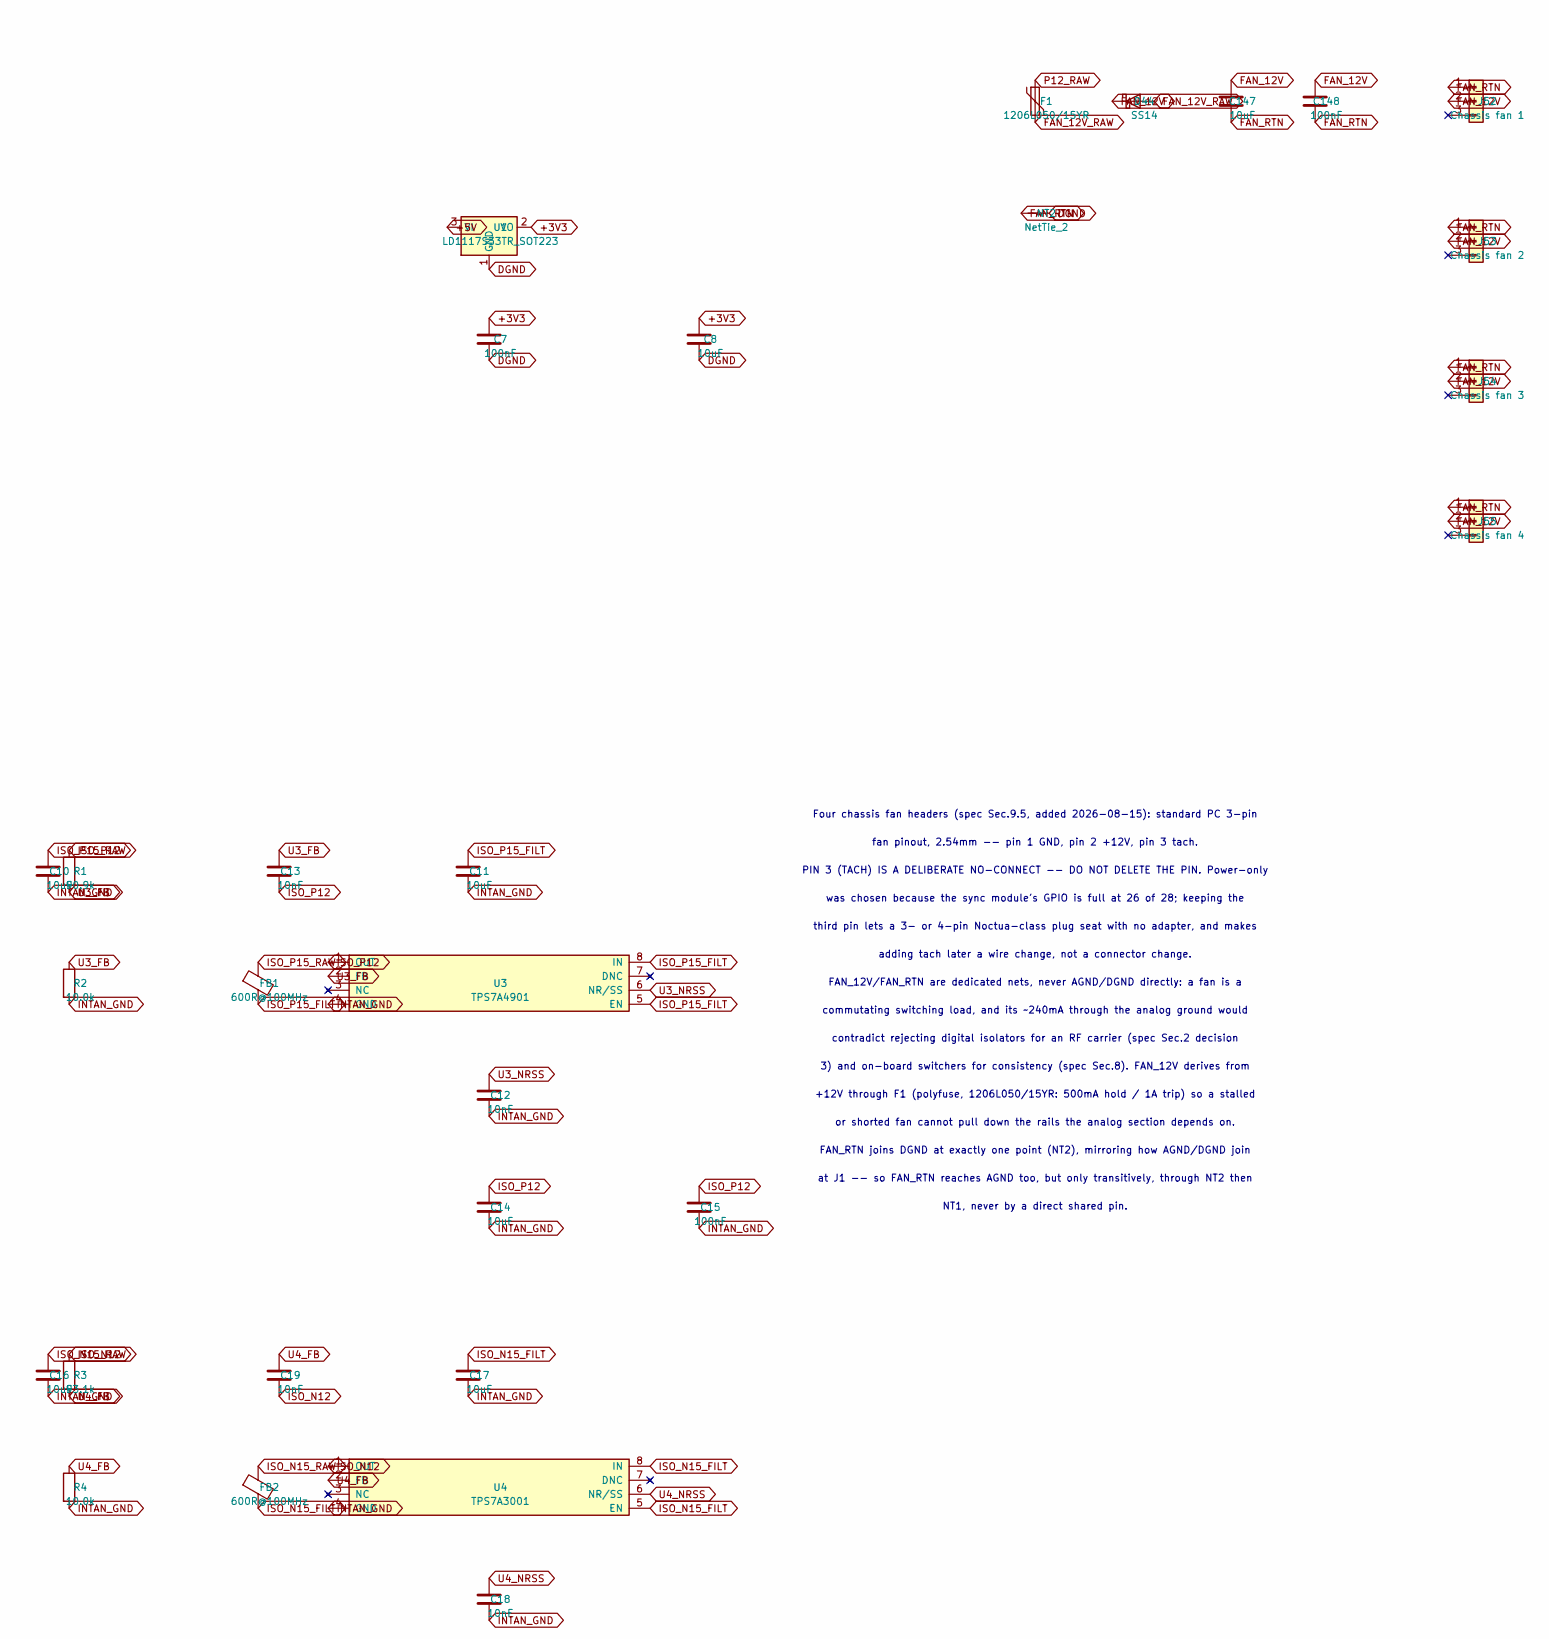
[picture p19: schematic power.kicad_sch, part in row 1, column 2]

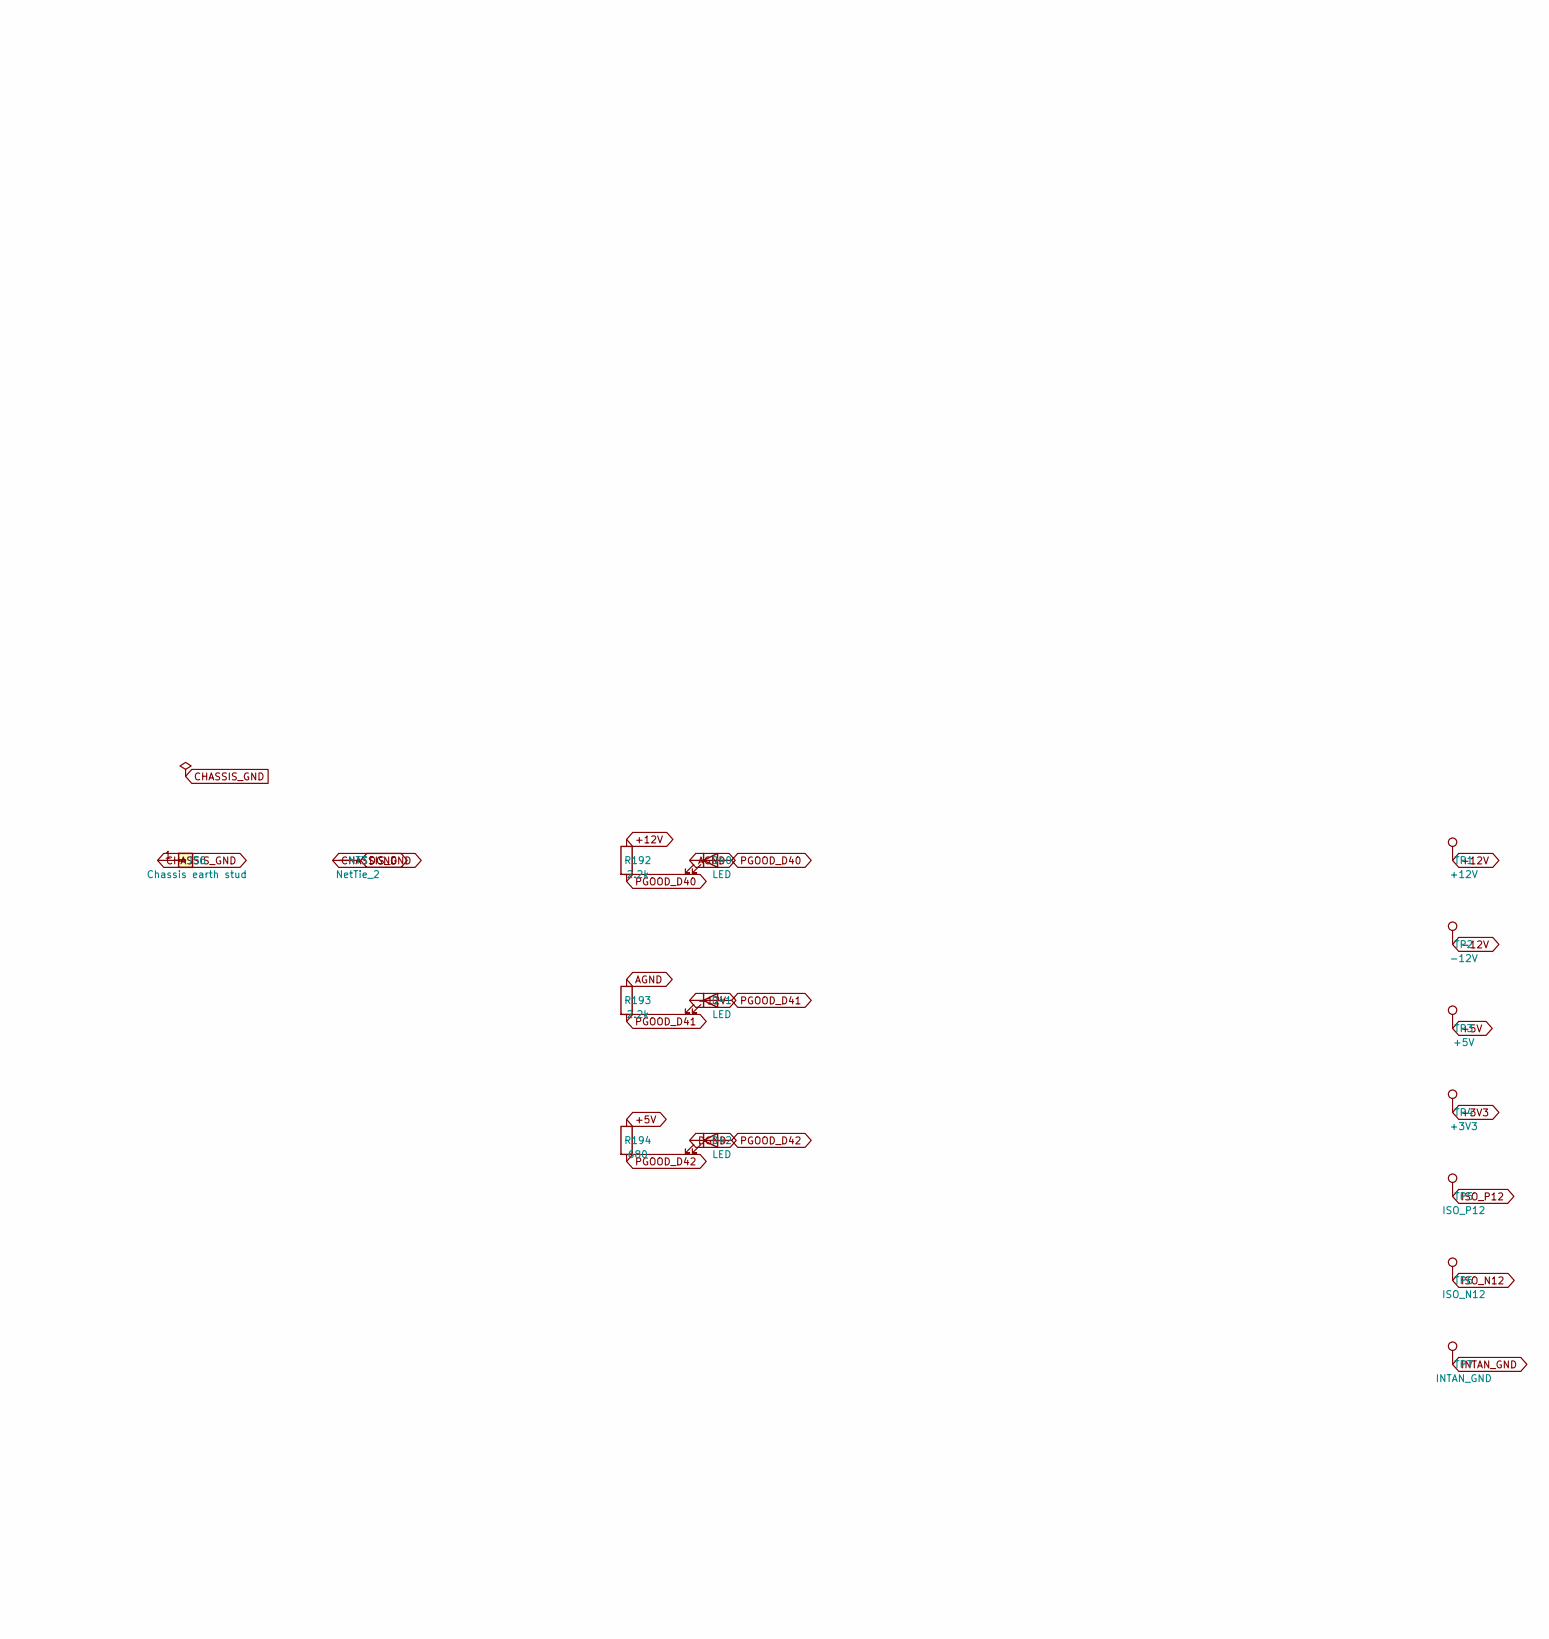
[picture p20: schematic power.kicad_sch, part in row 2, column 1]

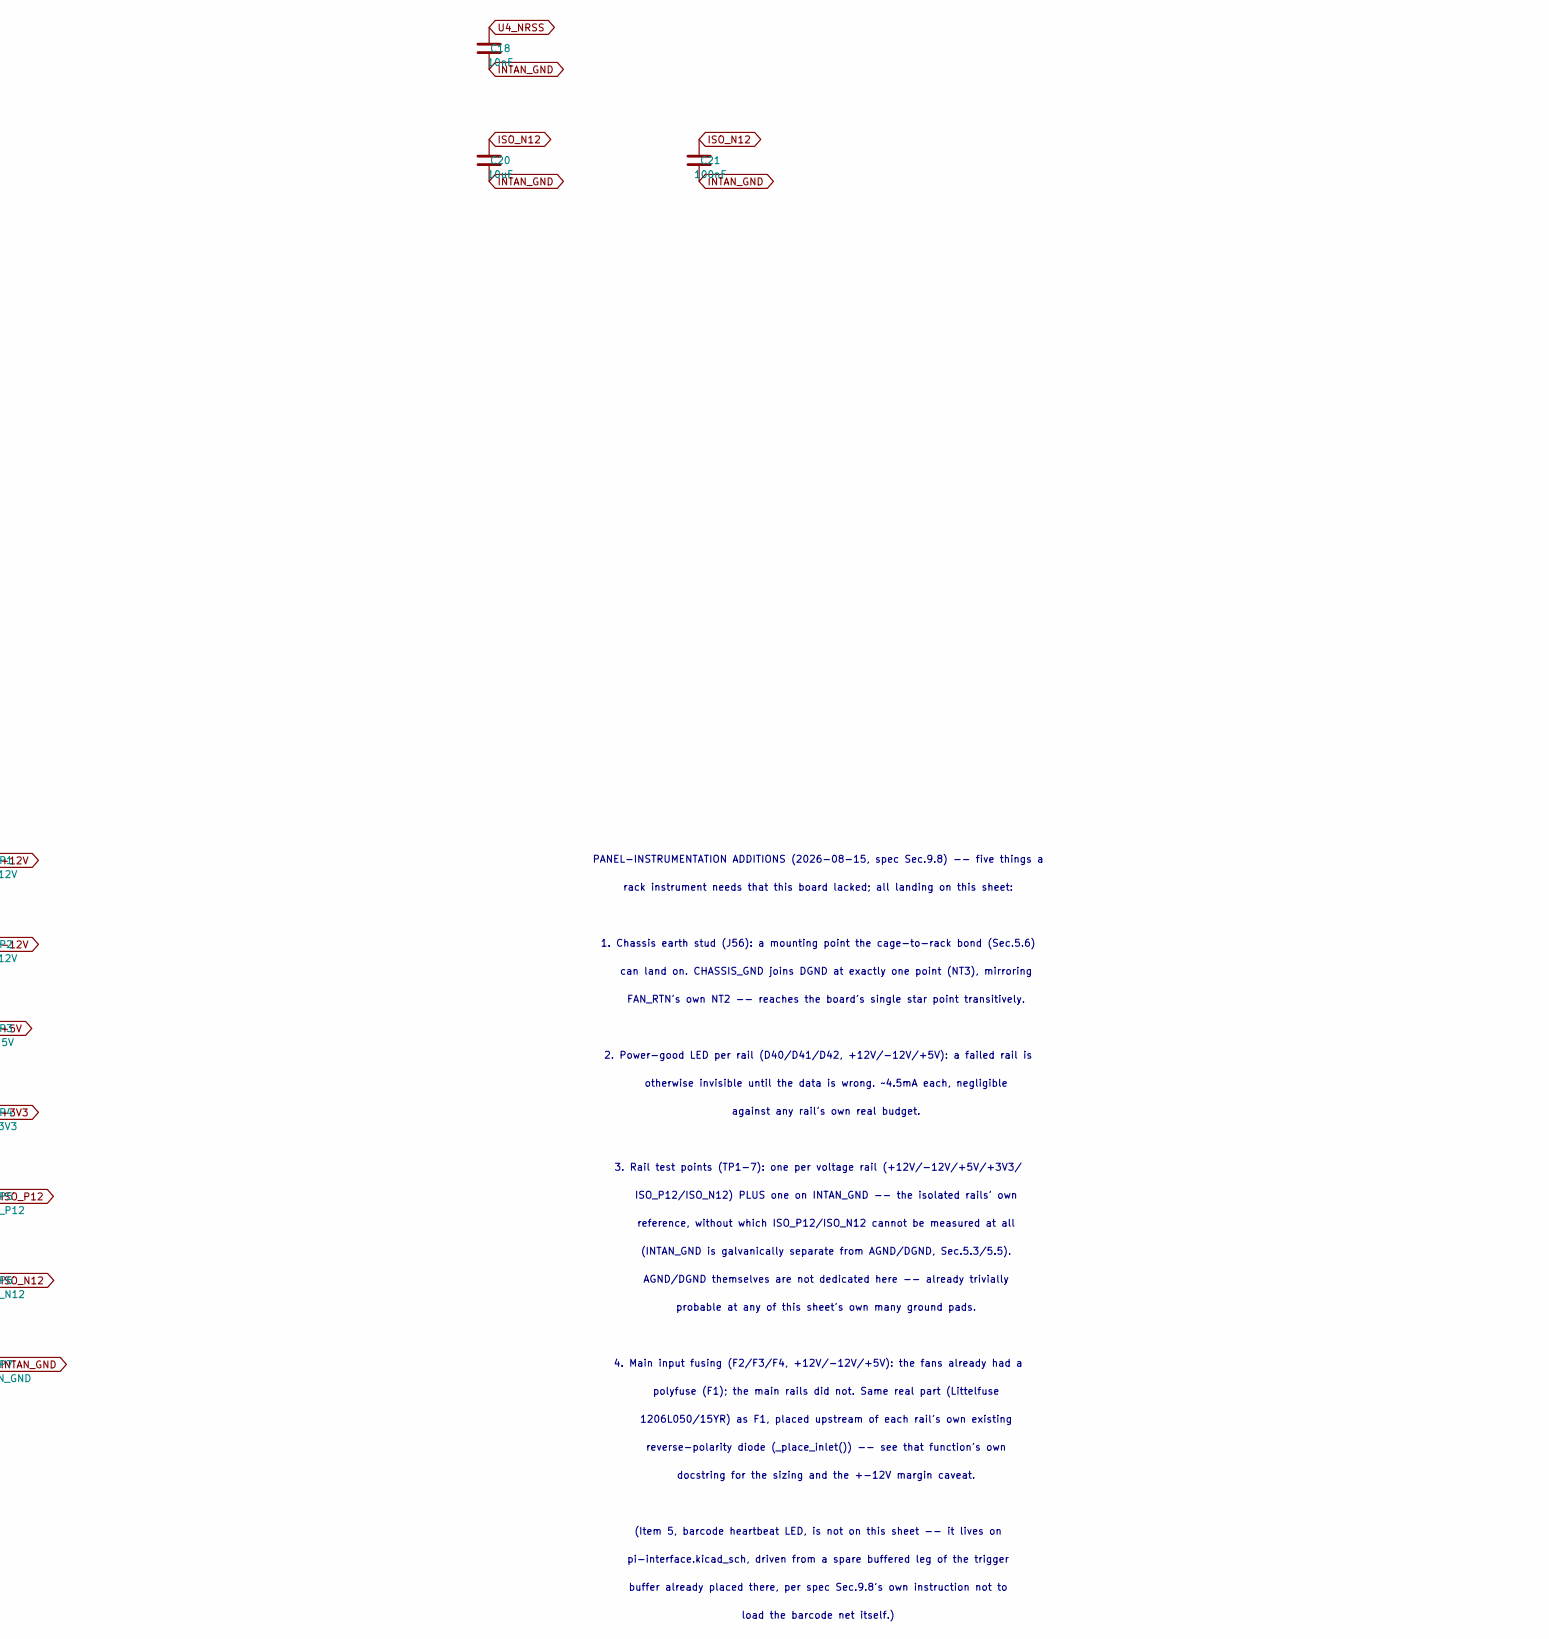
[picture p21: schematic power.kicad_sch, part in row 2, column 2]

Parts:
C1, C3, C5, C8, C10, C11, C14, C16, C17, C20, C147: 10uF; C_0805_2012Metric
C2, C4, C6, C7, C9, C15, C21, C148: 100nF; C_0603_1608Metric
C12, C13, C18, C19: 10nF; C_0603_1608Metric
D1, D2, D3, D44: SS14; D_SMA_Handsoldering
D40, D41, D42: LED; LED_0603_1608Metric_Pad1.05x0.95mm_HandSolder
F1, F2, F3: 1206L050/15YR; Fuse_1206_3216Metric_Pad1.42x1.75mm_HandSolder
F4: 1206L110-C; Fuse_1206_3216Metric_Pad1.42x1.75mm_HandSolder
FB1, FB2: 600R@100MHz; L_0805_2012Metric_Pad1.05x1.20mm_HandSolder
J1: Supply inlet header (M12 panel connector flying l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; PinHeader_1x05_P2.54mm_Vertical
J52: Chassis fan 1; PinHeader_1x03_P2.54mm_Vertical
J53: Chassis fan 2; PinHeader_1x03_P2.54mm_Vertical
J54: Chassis fan 3; PinHeader_1x03_P2.54mm_Vertical
J55: Chassis fan 4; PinHeader_1x03_P2.54mm_Vertical
J56: Chassis earth stud; MountingHole_3.2mm_M3_Pad
NT1, NT2, NT3: NetTie_2; NetTie-2_SMD_Pad2.0mm
R1: 90.9k; R_0603_1608Metric
R2, R4: 10.0k; R_0603_1608Metric
R3: 93.1k; R_0603_1608Metric
R192, R193: 2.2k; R_0603_1608Metric
R194: 680; R_0603_1608Metric
TP1: +12V; TestPoint_THTPad_2.0x2.0mm_Drill1.0mm
TP2: -12V; TestPoint_THTPad_2.0x2.0mm_Drill1.0mm
TP3: +5V; TestPoint_THTPad_2.0x2.0mm_Drill1.0mm
TP4: +3V3; TestPoint_THTPad_2.0x2.0mm_Drill1.0mm
TP5: ISO_P12; TestPoint_THTPad_2.0x2.0mm_Drill1.0mm
TP6: ISO_N12; TestPoint_THTPad_2.0x2.0mm_Drill1.0mm
TP7: INTAN_GND; TestPoint_THTPad_2.0x2.0mm_Drill1.0mm
U1: LD1117S33TR_SOT223; SOT-223-3_TabPin2
U2: IH1215D; Converter_DCDC_XP_POWER-IHxxxxD_THT
U3: TPS7A4901; HVSSOP-8-1EP_3x3mm_P0.65mm_EP1.57x1.89mm
U4: TPS7A3001; HVSSOP-8-1EP_3x3mm_P0.65mm_EP1.57x1.89mm

Connections:
+3V3: C7.1, C8.1, TP4.1, U1.2 (VO)
+12V: C1.1, C1.2, C2.1, C2.2, C3.1, C3.2, C4.1, C4.2, C5.1, C5.2, C6.1, C6.2, C7.2, C8.2, C9.1, C9.2, C11.1, C17.1, C147.1, C147.2, C148.1, C148.2, D1.1 (K), D2.2 (A), D3.1 (K), D40.1 (K), D41.1 (K), D42.1 (K), D44.1 (K), FB1.2, FB2.2, J1.4, J1.5, J52.1, J52.2, J53.1, J53.2, J54.1, J54.2, J55.1, J55.2, J56.1, NT1.1, NT1.2, NT2.1, NT2.2, NT3.1, NT3.2, R192.1, R193.1, R194.1, TP1.1, TP2.1, TP3.1, U1.1 (GND), U1.3 (VI), U2.1 (-Vin), U2.3 (+Vin), U3.5 (EN), U3.8 (IN), U4.5 (EN), U4.8 (IN)
FAN_12V_RAW: D44.2 (A), F1.2
INTAN_GND: C10.2, C11.2, C12.2, C14.2, C15.2, C16.2, C17.2, C18.2, C20.2, C21.2, R2.2, R4.2, TP7.1, U2.6 (0V), U3.4 (GND), U4.4 (GND)
ISO_N12: C19.2, C20.1, C21.1, R3.1, TP6.1, U4.1 (OUT)
ISO_N15_RAW: C16.1, FB2.1, U2.4 (-Vout)
ISO_P12: C13.2, C14.1, C15.1, R1.1, TP5.1, U3.1 (OUT)
ISO_P15_RAW: C10.1, FB1.1, U2.5 (+Vout)
N12_FUSED: D2.1 (K), F3.2
N12_RAW: F3.1, J1.2
P5_FUSED: D3.2 (A), F4.2
P5_RAW: F4.1, J1.3
P12_FUSED: D1.2 (A), F2.2
P12_RAW: F1.1, F2.1, J1.1
PGOOD_D40: D40.2 (A), R192.2
PGOOD_D41: D41.2 (A), R193.2
PGOOD_D42: D42.2 (A), R194.2
U3_FB: C13.1, R1.2, R2.1, U3.2 (FB)
U3_NRSS: C12.1, U3.6 (NR/SS)
U4_FB: C19.1, R3.2, R4.1, U4.2 (FB)
U4_NRSS: C18.1, U4.6 (NR/SS)

Notes on the sheet:
Four chassis fan headers (spec Sec.9.5, added 2026-08-15): standard PC 3-pin
fan pinout, 2.54mm -- pin 1 GND, pin 2 +12V, pin 3 tach.
PIN 3 (TACH) IS A DELIBERATE NO-CONNECT -- DO NOT DELETE THE PIN. Power-only
was chosen because the sync module's GPIO is full at 26 of 28; keeping the
third pin lets a 3- or 4-pin Noctua-class plug seat with no adapter, and makes
adding tach later a wire change, not a connector change.
FAN_12V/FAN_RTN are dedicated nets, never AGND/DGND directly: a fan is a
commutating switching load, and its ~240mA through the analog ground would
contradict rejecting digital isolators for an RF carrier (spec Sec.2 decision
3) and on-board switchers for consistency (spec Sec.8). FAN_12V derives from
+12V through F1 (polyfuse, 1206L050/15YR: 500mA hold / 1A trip) so a stalled
or shorted fan cannot pull down the rails the analog section depends on.
FAN_RTN joins DGND at exactly one point (NT2), mirroring how AGND/DGND join
at J1 -- so FAN_RTN reaches AGND too, but only transitively, through NT2 then
NT1, never by a direct shared pin.
PANEL-INSTRUMENTATION ADDITIONS (2026-08-15, spec Sec.9.8) -- five things a
rack instrument needs that this board lacked; all landing on this sheet:
1. Chassis earth stud (J56): a mounting point the cage-to-rack bond (Sec.5.6)
can land on. CHASSIS_GND joins DGND at exactly one point (NT3), mirroring
FAN_RTN's own NT2 -- reaches the board's single star point transitively.
2. Power-good LED per rail (D40/D41/D42, +12V/-12V/+5V): a failed rail is
otherwise invisible until the data is wrong. ~4.5mA each, negligible
against any rail's own real budget.
3. Rail test points (TP1-7): one per voltage rail (+12V/-12V/+5V/+3V3/
ISO_P12/ISO_N12) PLUS one on INTAN_GND -- the isolated rails' own
reference, without which ISO_P12/ISO_N12 cannot be measured at all
(INTAN_GND is galvanically separate from AGND/DGND, Sec.5.3/5.5).
AGND/DGND themselves are not dedicated here -- already trivially
probable at any of this sheet's own many ground pads.
4. Main input fusing (F2/F3/F4, +12V/-12V/+5V): the fans already had a
polyfuse (F1); the main rails did not. Same real part (Littelfuse
1206L050/15YR) as F1, placed upstream of each rail's own existing
reverse-polarity diode (_place_inlet()) -- see that function's own
docstring for the sizing and the +-12V margin caveat.
(Item 5, barcode heartbeat LED, is not on this sheet -- it lives on
pi-interface.kicad_sch, driven from a spare buffered leg of the trigger
buffer already placed there, per spec Sec.9.8's own instruction not to
load the barcode net itself.)
