jakewesterberg/wl-sync/hardware/breakout/sheets/taskpc-digital.kicad_sch

## KiCad design hardware/breakout/sheets/taskpc-digital.kicad_sch (2026-10-18)

Schematic: taskpc-digital.kicad_sch

Parts:
C22, C23, C24, C25, C26, C27, C28, C30, C31, C150, C151, C152, C153, C154: 100nF; C_0603_1608Metric
C29, C149: 1uF; C_0603_1608Metric
D4, D5, D6, D7, D8, D9, D10, D11, D12, D13, D14, D15, D16, D17, D18, D19, D20, D21, D22: BAT54S; SOT-23
J2: Connector 0 (analog + AISENSE, task PC NI); MDR68_Male_RightAngle
J3: Connector 1 (digital, task PC NI); MDR68_Male_RightAngle
J4: Manual reward button (panel, recessed); SW_PUSH-12mm
J5: Dual panel BNC: Remote reward BNC (parallel to pa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; BNC_Dual_RA_Isolated
J6: Dual panel BNC: Reward driver out (BNC) | Behavio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; BNC_Dual_RA_Isolated
J57: Dual panel BNC: Line-out L (task PC AO 0) | Line-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; BNC_Dual_RA_Isolated
R5, R6, R7, R8, R9, R10, R11, R12, R13, R14, R15, R16, R17, R18, R19, R20, R21, R22, R23, R203, R221, R222, R223: 100; R_0603_1608Metric
R24: 10k; R_0603_1608Metric
R191: 442k; R_0603_1608Metric
U5, U6, U7: SN74LVC541APW; Texas_PW0020A_TSSOP-20_4.4x6.5mm_P0.65mm
U8, U9, U10, U11, U70, U71, U72, U73: SN74AHCT541PW; Texas_PW0020A_TSSOP-20_4.4x6.5mm_P0.65mm
U12: SN74HCT32D; SOIC-14_3.9x8.7mm_P1.27mm
U13: SN74HCT14D; SOIC-14_3.9x8.7mm_P1.27mm
U69: 74HCT123D; SOIC-16_3.9x9.9mm_P1.27mm

Connections:
+3V3: C22.1, C23.1, C24.1, U5.20 (VCC), U6.20 (VCC), U7.20 (VCC)
+5V: C25.1, C26.1, C27.1, C28.1, C30.1, C31.1, C150.1, C151.1, C152.1, C153.1, C154.1, D4.2 (K), D5.2 (K), D6.2 (K), D7.2 (K), D8.2 (K), D9.2 (K), D10.2 (K), D11.2 (K), D12.2 (K), D13.2 (K), D14.2 (K), D15.2 (K), D16.2 (K), D17.2 (K), D18.2 (K), D19.2 (K), D20.2 (K), D21.2 (K), D22.2 (K), R24.1, R191.1, U8.20 (VCC), U9.20 (VCC), U10.20 (VCC), U11.20 (VCC), U12.14 (VCC), U13.14 (VCC), U69.3 (Clr), U69.16 (VCC), U70.20 (VCC), U71.20 (VCC), U72.20 (VCC), U73.20 (VCC)
ACC_TRIG: U11.4 (A2)
ACC_TRIG_TPC: J3.40, U11.16 (Y2)
AGND: J2.62
AO_GND_TPC: J2.54, J2.55, J57.2 (A_Ext), J57.4 (B_Ext)
AO_L_BNC: J57.1 (A_In), R221.2
AO_L_TPC: J2.22, R221.1
AO_R_BNC: J57.3 (B_In), R222.2
AO_R_TPC: J2.21, R222.1
A_EYE_LX_TPC: J2.68
A_EYE_LY_TPC: J2.33
A_EYE_RX_TPC: J2.65
A_EYE_RY_TPC: J2.30
A_JOY_X_TPC: J2.28
A_JOY_Y_TPC: J2.60
A_MISC1_TPC: J2.25
A_MISC2_TPC: J2.57
A_MISC3_TPC: J2.34
CAM_FRAME_BEH_BNC: J6.3 (B_In)
DGND: C22.2, C23.2, C24.2, C25.2, C26.2, C27.2, C28.2, C29.2, C30.2, C31.2, C150.2, C151.2, C152.2, C153.2, C154.2, D4.1 (A), D5.1 (A), D6.1 (A), D7.1 (A), D8.1 (A), D9.1 (A), D10.1 (A), D11.1 (A), D12.1 (A), D13.1 (A), D14.1 (A), D15.1 (A), D16.1 (A), D17.1 (A), D18.1 (A), D19.1 (A), D20.1 (A), D21.1 (A), D22.1 (A), J3.4, J3.7, J3.9, J3.12, J3.13, J3.15, J3.18, J3.35, J3.36, J3.44, J3.50, J3.53, J4.2, J5.2 (A_Ext), J5.4 (B_Ext), J6.2 (A_Ext), J6.4 (B_Ext), U5.1 (G1), U5.10 (GND), U5.19 (G2), U6.1 (G1), U6.10 (GND), U6.19 (G2), U7.1 (G1), U7.5 (A3), U7.6 (A4), U7.7 (A5), U7.8 (A6), U7.9 (A7), U7.10 (GND), U7.19 (G2), U8.1 (G1), U8.10 (GND), U8.19 (G2), U9.1 (G1), U9.10 (GND), U9.19 (G2), U10.1 (G1), U10.10 (GND), U10.19 (G2), U11.1 (G1), U11.10 (GND), U11.19 (G2), U12.4, U12.5, U12.7 (GND), U12.9, U12.10, U12.12, U12.13, U13.3, U13.5, U13.7 (GND), U13.9, U13.11, U13.13, U69.1 (A), U69.6 (Cext), U69.7 (RCext), U69.8 (GND), U69.9 (A), U69.10 (B), U69.11 (Clr), U70.1 (G1), U70.10 (GND), U70.19 (G2), U71.1 (G1), U71.10 (GND), U71.19 (G2), U72.1 (G1), U72.10 (GND), U72.19 (G2), U73.1 (G1), U73.4 (A2), U73.5 (A3), U73.6 (A4), U73.7 (A5), U73.8 (A6), U73.9 (A7), U73.10 (GND), U73.19 (G2)
EVT_D0_BUF: U8.18 (Y0), U70.18 (Y0)
EVT_D0_CLAMP: D4.3 (COM), R5.2, U5.2 (A0), U8.2 (A0), U70.2 (A0)
EVT_D0_PI: U5.18 (Y0)
EVT_D0_TPC: J3.52, R5.1
EVT_D1_BUF: U8.17 (Y1), U70.17 (Y1)
EVT_D1_CLAMP: D5.3 (COM), R6.2, U5.3 (A1), U8.3 (A1), U70.3 (A1)
EVT_D1_PI: U5.17 (Y1)
EVT_D1_TPC: J3.17, R6.1
EVT_D2_BUF: U8.16 (Y2), U70.16 (Y2)
EVT_D2_CLAMP: D6.3 (COM), R7.2, U5.4 (A2), U8.4 (A2), U70.4 (A2)
EVT_D2_PI: U5.16 (Y2)
EVT_D2_TPC: J3.49, R7.1
EVT_D3_BUF: U8.15 (Y3), U70.15 (Y3)
EVT_D3_CLAMP: D7.3 (COM), R8.2, U5.5 (A3), U8.5 (A3), U70.5 (A3)
EVT_D3_PI: U5.15 (Y3)
EVT_D3_TPC: J3.47, R8.1
EVT_D4_BUF: U8.14 (Y4), U70.14 (Y4)
EVT_D4_CLAMP: D8.3 (COM), R9.2, U5.6 (A4), U8.6 (A4), U70.6 (A4)
EVT_D4_PI: U5.14 (Y4)
EVT_D4_TPC: J3.19, R9.1
EVT_D5_BUF: U8.13 (Y5), U70.13 (Y5)
EVT_D5_CLAMP: D9.3 (COM), R10.2, U5.7 (A5), U8.7 (A5), U70.7 (A5)
EVT_D5_PI: U5.13 (Y5)
EVT_D5_TPC: J3.51, R10.1
EVT_D6_BUF: U8.12 (Y6), U70.12 (Y6)
EVT_D6_CLAMP: D10.3 (COM), R11.2, U5.8 (A6), U8.8 (A6), U70.8 (A6)
EVT_D6_PI: U5.12 (Y6)
EVT_D6_TPC: J3.16, R11.1
EVT_D7_BUF: U8.11 (Y7), U70.11 (Y7)
EVT_D7_CLAMP: D11.3 (COM), R12.2, U5.9 (A7), U8.9 (A7), U70.9 (A7)
EVT_D7_PI: U5.11 (Y7)
EVT_D7_TPC: J3.48, R12.1
EVT_D8_BUF: U9.18 (Y0), U71.18 (Y0)
EVT_D8_CLAMP: D12.3 (COM), R13.2, U6.2 (A0), U9.2 (A0), U71.2 (A0)
EVT_D8_PI: U6.18 (Y0)
EVT_D8_TPC: J3.11, R13.1
EVT_D9_BUF: U9.17 (Y1), U71.17 (Y1)
EVT_D9_CLAMP: D13.3 (COM), R14.2, U6.3 (A1), U9.3 (A1), U71.3 (A1)
EVT_D9_PI: U6.17 (Y1)
EVT_D9_TPC: J3.10, R14.1
EVT_D10_BUF: U9.16 (Y2), U71.16 (Y2)
EVT_D10_CLAMP: D14.3 (COM), R15.2, U6.4 (A2), U9.4 (A2), U71.4 (A2)
EVT_D10_PI: U6.16 (Y2)
EVT_D10_TPC: J3.43, R15.1
EVT_D11_BUF: U9.15 (Y3), U71.15 (Y3)
EVT_D11_CLAMP: D15.3 (COM), R16.2, U6.5 (A3), U9.5 (A3), U71.5 (A3)
EVT_D11_PI: U6.15 (Y3)
EVT_D11_TPC: J3.42, R16.1
EVT_D12_BUF: U9.14 (Y4), U71.14 (Y4)
EVT_D12_CLAMP: D16.3 (COM), R17.2, U6.6 (A4), U9.6 (A4), U71.6 (A4)
EVT_D12_PI: U6.14 (Y4)
EVT_D12_TPC: J3.41, R17.1
EVT_D13_BUF: U9.13 (Y5), U71.13 (Y5)
EVT_D13_CLAMP: D17.3 (COM), R18.2, U6.7 (A5), U9.7 (A5), U71.7 (A5)
EVT_D13_PI: U6.13 (Y5)
EVT_D13_TPC: J3.6, R18.1
EVT_D14_BUF: U9.12 (Y6), U71.12 (Y6)
EVT_D14_CLAMP: D18.3 (COM), R19.2, U6.8 (A6), U9.8 (A6), U71.8 (A6)
EVT_D14_PI: U6.12 (Y6)
EVT_D14_TPC: J3.5, R19.1
EVT_D15_BUF: U9.11 (Y7), U71.11 (Y7)
EVT_D15_CLAMP: D19.3 (COM), R20.2, U6.9 (A7), U9.9 (A7), U71.9 (A7)
EVT_D15_PI: U6.11 (Y7)
EVT_D15_TPC: J3.38, R20.1
EVT_STROBE_BUF: U10.18 (Y0), U72.18 (Y0)
EVT_STROBE_CLAMP: D20.3 (COM), R21.2, U7.2 (A0), U10.2 (A0), U10.5 (A3), U72.2 (A0), U72.5 (A3)
EVT_STROBE_INTAN_BUF: U10.15 (Y3), U72.15 (Y3)
EVT_STROBE_PI: U7.18 (Y0)
EVT_STROBE_TPC: J3.37, R21.1
PD1_COMP: U11.2 (A0), U11.6 (A4), U73.2 (A0)
PD1_COMP_BUF: U11.14 (Y4), U73.18 (Y0)
PD1_COMP_PFI: J2.38, R223.2
PD1_COMP_PFI_BUF: R223.1
PD1_COMP_TPC: J3.46, U11.18 (Y0)
PD2_COMP: U11.3 (A1), U11.7 (A5), U73.3 (A1)
PD2_COMP_BUF: U11.13 (Y5), U73.17 (Y1)
PD2_COMP_TPC: J3.2, U11.17 (Y1)
RHS_STIM_OUT: U11.5 (A3), U11.8 (A6), U11.9 (A7)
RHS_STIM_OUT_BUF: U11.11 (Y7), U11.12 (Y6)
RHS_STIM_OUT_TPC: J3.1, U11.15 (Y3)
RWD_BTN: C29.1, J4.1, J5.1 (A_In), R24.2, U13.1
RWD_BTN_DEB: U13.2, U69.2 (B)
RWD_BTN_PULSE: U12.2, U69.13 (Q)
RWD_CMD: U7.17 (Y1), U12.1
RWD_CMD_BUF: U10.17 (Y1), U72.17 (Y1)
RWD_CMD_CLAMP: D21.3 (COM), R22.2, U7.3 (A1), U10.3 (A1), U10.6 (A4), U72.3 (A1), U72.6 (A4)
RWD_CMD_INTAN_BUF: U10.14 (Y4), U72.14 (Y4)
RWD_CMD_TPC: J3.3, R22.1
RWD_DLVR: R203.1, U10.8 (A6), U10.9 (A7), U12.3, U72.8 (A6), U72.9 (A7)
RWD_DLVR_BNC: J6.1 (A_In), R203.2
RWD_DLVR_BUF: U10.12 (Y6), U72.12 (Y6)
RWD_DLVR_INTAN_BUF: U10.11 (Y7), U72.11 (Y7)
STIM_TRIG: U7.16 (Y2)
STIM_TRIG_BUF: U10.16 (Y2), U72.16 (Y2)
STIM_TRIG_CLAMP: D22.3 (COM), R23.2, U7.4 (A2), U10.4 (A2), U10.7 (A5), U72.4 (A2), U72.7 (A5)
STIM_TRIG_INTAN_BUF: U10.13 (Y5), U72.13 (Y5)
STIM_TRIG_TPC: J3.45, R23.1
U69_CEXT: C149.2, U69.14 (Cext)
U69_RCEXT: C149.1, R191.2, U69.15 (RCext)

Notes on the sheet:
All 23 task-PC digital lines (19 out + 4 in) ride Connector 1, P0.8-P0.30 of
pinout and TSSOP-20 footprint, both symbols extend the same 74LS541 KiCad
place_reward_oneshot()'s own docstring for the full account. Real part:
It also fixes a PACKAGE limit no per-pin check can see. AHCT541's GND-pin
return. PD1_COMP_PFI_BUF comes from pi-interface's SN74LVC541A channel 1 (3.3 V
minimum, because the +5V rail reaches them through F4 and D3 and the original
the sync module recording reward-delivered continuously. Same failure
actual polarity against MonkeyLogic before commissioning (MonkeyLogic's own
taps -- the established fan-out point, one protection network with N buffered
AISENSE=pin62 -> AGND (NRSE reference -- spec Decision 5; the easiest wire on
in series sharing one node, per TI SLVA720A Fig.3-1's own topology, NOT each
These four packages carry the SECOND output of every LED pair. They exist
CMOS inputs and a panel header: ~0mA DC out of the 74HCT32.
LEDs were never guaranteed to switch (~5mA worst case against a 7.0mA I_FH
P0.30=pin1(RHS_STIM_OUT) P0.31=pin39 (spare, no_connect). D GND (all 12 real
AI0=pin68=A_EYE_LX_TPC AI1=pin33=A_EYE_LY_TPC AI2=pin65=A_EYE_RX_TPC
out against the card's 2.2 V V_IH); PFI 7, not PFI 12-15, the default counter
AI3=pin30=A_EYE_RY_TPC AI4=pin28=A_JOY_X_TPC AI5=pin60=A_JOY_Y_TPC
signature as the reward-OR polarity defect caught here at fix round 1.
U69/R191/C149-C150 already use here. An ordinary next_ref() would renumber
CHANNELS 4/5 (PD1_COMP_BUF, PD2_COMP_BUF) ARE NOT OUTBOUND -- they do not reach
separate 58.6mA-of-70mA concern on U8/U9/U10 too.
clamp circuitry lives on THIS sheet, only the labelled connection point does.
Reward OR polarity (fix round 1, finding 1 -- CRITICAL): RWD_BTN idles HIGH
RewardPolarity setting must be HIGH to match this board -- hardware/README.md):
which one AHCT541 output cannot sink. Neither value is shippable alone.
own front-end/buffer outputs (plan.md Task 10 Step 3) -- no buffer/series-R/
ch5 STIM_TRIG_CLAMP -> STIM_TRIG_INTAN_BUF (opto-intan U65 ch1)
U69 (Nexperia 74HCT123D) gives every hand-delivered reward a FIXED ~199ms
Connector 0/Connector 1 split confirmed from NI's own device specifications
buffered leg instead of hanging directly on PD1_COMP/PD2_COMP, which wire
cannot extend the pulse; retriggering only matters for a second physical
DRIVER PART IS SN74AHCT541PW, NOT SN74HCT541PW (Value/MPN only -- identical
TWO BUFFER OUTPUTS PER OPTOCOUPLER LED (finding F1b, 2026-08-16).
Table 4 row 1) -- genuinely inert, not merely untriggered. Pin map verified
(6 spare channels, the headroom finding F4's camera triggers need)
and injecting ~7mA into an unpowered pad whenever this board is on and the sync
sizing used a nominal 5.00V and a TYPICAL V_F) -- and 249R draws ~12.7mA,
threshold, not a driver choice. HCT541's own rated IOL is 6mA (7.33mA is 22%
around: a single continuous hold produces exactly one rising edge on the
deletion history.
Remaining 53 pins (spare AI9-15, P0.0-7, other PFI, D GND, +5V, NC) stay
P0.18=pin43 P0.19=pin42 P0.20=pin41 P0.21=pin6 P0.22=pin5 P0.23=pin38
U73 doubles U11's two LED channels -- PD1_COMP_BUF, PD2_COMP_BUF
Physical pins sourced from NI's X Series User Manual (370784K-01), Figure A-5
ones were doubled up: EVT_STROBE_BUF, RWD_CMD_BUF and STIM_TRIG_BUF each fed
this board to omit by accident, so check_taskpc_digital_netlist.py asserts it).
it. The two RWD_DLVR legs tap RWD_DLVR itself, which afterwards drives only
(datasheet Table 10, HCT-specific) = 0.45 x 442 x 1e6 = 198.9e6 ns = ~199ms.
separately gives each SINGLE LED two outputs, which is the opposite thing.
Task-PC line-out and PD1_COMP's PFI copy (2026-10-18) -- see
The third _BUF package's 5 spare channels are now spent, one LED per pin:
~12.7mA as of finding F1 (2026-08-16; it was 430R/~7.33mA when this note was
Second section (unit 2) held in PERMANENT RESET (RD-bar->DGND, datasheet
(idle-LOW, pulses HIGH on delivery -- this design's other event lines' own
Retriggerable by design (datasheet Section 1) -- deliberately not worked
absolute maximum is 75mA; U8 and U9 drive eight LEDs each; the drive is
Physical MDR68 pin per P0.x line is SOURCED (fix round 1, finding 2), not
commanded (RWD_CMD) and delivered (RWD_DLVR) separately at all: a manual
pulse regardless of how long RWD_BTN is held -- so a manual reward is
buffered leg. Same input net as channels 0/1 -- a second buffered copy, not a
3.7x its rated sink plausibly exceeds that -- leaving RWD_DLVR_PI stuck HIGH,
AO GND=pins55,54=AO_GND_TPC (own net, no board plane) PFI7=pin38=PD1_COMP_PFI
PCIe-6323/6343 Pinout": P0.8=pin52 P0.9=pin17 P0.10=pin49 P0.11=pin47
The _BUF bank names 19 SIGNALS, but the board carries 30 LEDs. The 11 unnamed
first leg rather than retyped, so the two cannot drift apart.
P0.12=pin19 P0.13=pin51 P0.14=pin16 P0.15=pin48 P0.16=pin11 P0.17=pin10
Rext=10k -> Typ=450us; formula predicts 450us exactly).
A=DGND, B=RWD_BTN_DEB (trigger, rising edge), RD-bar=+5V (never reset) --
ALREADY-DEBOUNCED RWD_BTN_DEB (bounce filtered upstream), so hold duration
pins tied, not an arbitrary 2): 4,7,9,12,13,15,18,35,36,44,50,53.
Connector 1 at all. They exist so opto-ni's own U61 LEDs are driven from a
sequential -- NI's own X Series User Manual (370784K-01), Figure A-5 "NI
stages. The channel maps here are MIRRORED from the tables that built the
press inside the first pulse's own ~199ms window, a different scenario than
there means +5V through 430R and the LED reaches that pin: idling ~3.6-3.8V
Nexperia 74HCT123D (TI's own CD74HCT123M/MT is obsolete, checked before
ONE OPTOCOUPLER LED PER DRIVER PIN.
not the single 6mA datasheet test point -- closer to 7.18mA against that same
'how long the button is held'.
Connector 1 = AI16-31 + P0.8-31, NO PFI (digital). See spec Sec.9.2, closed
generator's own MDR0_AI_PIN/MDR0_AISENSE_PIN and task-8-report.md "Fix round 1".
guaranteed to drive the same direction. If their inputs ever differed, one
Each ACSL-6400/6420 LED on this board is fed from +5V through 249R and draws
ch4 RWD_CMD_CLAMP -> RWD_CMD_INTAN_BUF (opto-intan U64 ch3)
every part placed after it AND every downstream sibling sheet.
REFDES U70-U73/C151-C154 are minted OUT OF BAND (explicit strings, never
Connector 0 (analog + AISENSE): 9 task-PC analog channels + AISENSE wired here
checked against KiCad's own 74xx:74HCT123 library entry -- see
an OR gate cannot correctly combine one active-HIGH and one active-LOW input.
The three *_INTAN_BUF legs tap the SAME *_CLAMP node their NI twin already
AI6=pin25=A_MISC1_TPC AI7=pin57=A_MISC2_TPC AI8=pin34=A_MISC3_TPC
ch7 RWD_DLVR -> RWD_DLVR_INTAN_BUF (opto-intan U64 ch4)
inverter (NOT a pair) inverts ONCE, so RWD_BTN_DEB idles LOW and reads HIGH
7.0mA floor). AHCT541's rated IOL is 8mA: 7.33mA is fully compliant, and both
The value cannot simply be reduced: it is pinned between the part's 7-15mA
convention, and SN74LVC541APW does not invert): stated explicitly because this
spec Sec.9.3): Connector 0 = AI0-15 + P0.0-7 + P1.0-7 (analog+AISENSE).
a real driver elsewhere in this project (Task 10d's LM339 for the first three,
absolute maxima double (25mA->50mA/pin, 70mA->100mA/package), retiring the
active-low and the event bus idles at 0x0000, so sixteen LEDs are lit
breaks the single star point. All 16 PFI lines are on THIS connector (NI A-5).
with the LED off (above the 3.3V rail, held only by the module's ESD clamp),
any of them. See _place_outbound()'s own docstring ('TASK 11 UPDATE') for the
the 24 available on P0.8-31. Event data bits occupy P0.8-P0.23, NOT P0.0-
U70 doubles U8 -- EVT_D0_BUF .. EVT_D7_BUF
Rext=442k (E96), Cext=1uF: tW = K x Rext[kOhm] x Cext[pF], K=0.45 at VCC=5.0V
an NI LED AND an Intan LED from one HCT541 output (14.7mA vs 6mA IOL), and
outputs. Place R221-R223 beside Connector 0 in layout. Refdes out of band.
written, which under-drove every LED on the board -- see the F1 note block).
NI ties AO GND to D GND on the card, so no board plane may carry the amplifier's
would source while the other sinks, limited by nothing but the two output
(10k pull-up to +5V), reads LOW while pressed. A SINGLE 74HCT14 Schmitt
~199ms fixed pulse -- panel-instrumentation task, 2026-08-15) whose own Q
while pressed -- active-HIGH. RWD_BTN_DEB now feeds a one-shot (74HCT123D,
P0.15 -- MonkeyLogic must be configured for this non-zero-based line range.
tidiness: two tri-state outputs on one net are safe only while both are
HIGH polarity, unchanged requirement. RWD_CMD polarity is ASSUMED ACTIVE-HIGH
next_ref()), above the whole board's current maximum -- the same mechanism
See this generator's own MDR1_PIN_BY_P0/MDR1_DGND_PINS and
U72 doubles U10 -- strobe/RWD_CMD/STIM_TRIG _BUF + the 5 second legs
hardware/breakout/line-out-and-pfi-copy.md. J57's shells are on AO_GND_TPC ONLY:
"NI PCIe-6323/6343 Pinout", same source as Connector 1 below -- see this
task-8-report.md "Fix round 1" for the full retrieval/cross-check method.
Each pair shares ONE input net, and that is a safety requirement rather than
bare RWD_DLVR fed both of its optocouplers straight off the 74HCT32 reward-OR
reward is DELIVERED WITHOUT COMMANDED, derivable with no extra logic.
(fix round 1, finding 3); Task 10 drives these SAME contract net names from its
no_connect -- see _place_connector0()'s own docstring.
ch6 RWD_DLVR -> RWD_DLVR_BUF (opto-ni U60 ch4)
gate (14.7mA vs 4mA IOL). That last one was the dangerous one: RWD_DLVR's LOW
sheet cannot verify the task PC/MonkeyLogic side independently. VERIFY RWD_CMD's
MANUAL REWARD ONE-SHOT (panel-instrumentation task, 2026-08-15, spec Sec.3.1):
+5V -> R191(442k) -> pin15(REXT/CEXT) -> C149(1uF) -> pin14(CEXT) -- R and C
pin-by-pin against Philips/Nexperia Rev.03 (11 May 2004) Table 3/Fig.5, cross-
with TWO LEDs on it sinks double, which is what this note block is about; F1
STRAIGHT into the sync module's GPIO20/GPIO21 (3.3V, not 5V tolerant). An LED
P0.27=pin46(PD1_COMP) P0.28=pin2(PD2_COMP) P0.29=pin40(ACC_TRIG)
Line-out and PFI copy (2026-10-18): AO0=pin22=AO_L_TPC AO1=pin21=AO_R_TPC
U71 doubles U9 -- EVT_D8_BUF .. EVT_D15_BUF
ch3 EVT_STROBE_CLAMP -> EVT_STROBE_INTAN_BUF (opto-intan U64 ch1)
part). Each LED is 7.33mA, fixed by the LED's own 7.0mA worst-case switching
over, and self-consistently against the part's own ~55ohm output impedance --
because the LED series resistor had to fall from 430R to 249R -- at 430R the
independently returned to a rail.
countable, not a per-press variable, which is the point of recording
No D GND pin here: AISENSE is already on AGND, and one connector on both grounds
copies hanging off it, exactly as the LVC541 and HCT541 banks already share
choosing this vendor, not assumed from the symbol's own generic library name).
(PCIe-6343 task-PC card; identical to the 6353/6363 on every axis used here,
datasheet Table 4's own function table, row 'nRD=H,nA=L,nB=up-arrow', fires
re-derived signal.
output, RWD_BTN_PULSE, is what actually reaches the OR gate -- same active-
one pulse on B's own rising edge. Q=RWD_BTN_PULSE (active-HIGH). RC network:
Cross-checked against the SAME table's own measured example (Cext=100nF,
Task 11's ACSL-6420 for RHS_STIM_OUT) -- no PWR_FLAGs remain on this sheet for
P0.24=pin37(STROBE) P0.25=pin3(RWD_CMD) P0.26=pin45(STIM_TRIG)
is read by the LVC541 level-shifter (V_IL,max 0.8V), and an HCT gate's VOL at
box is not. These were the only 2 of 24 NI optocoupler LEDs not driven from a
All 4 outbound channels (PD1_COMP, PD2_COMP, ACC_TRIG, RHS_STIM_OUT) now have
CONTINUOUSLY. At 249R unparalleled that is ~101mA through one ground pin.
Paralleled it is ~51mA, and each output pin sees ~6.3mA of a 7.5mA budget.
2026-08-13 (formerly open item 3).
recommended band and its 7.0mA worst-case switching threshold. A driver pin
