jakewesterberg/wl-sync/hardware/gen/check_breakout_opto_intan_netlist.py

"""Parse hardware/breakout's exported netlist (and, for the two checks the exported netlist
provably cannot answer -- coordinate collisions and the instance-path ancestor chain -- the
raw .kicad_sch sources) and verify opto-intan.kicad_sch's contract nets and topology are
electrically correct -- not just that ERC was silent. Same reasoning every prior checker in
this project gives, restated because it is why THIS file exists too.

THE CENTRAL RISKS this file exists to catch, named explicitly by this task's own brief:

  1. All 6 channels must exist and cross the barrier they should -- 5 outbound
     (DGND -> INTAN_GND) and 1 inbound (INTAN_GND -> DGND, RHS_STIM_OUT). Walked end to
     end per channel, not assumed from net names alone.
  2. The Intan-isolated domain (INTAN_GND, ISO_5V, every *_INTAN net, RHS_STIM_RAW) must
     be PIN-DISJOINT from every non-isolated rail and from every *_BUF/source net, except
     the ACSL-6400/ACSL-6420 packages themselves (the barrier components, straddling by
     design). RHS_STIM_OUT itself is the DGND-side name for the inbound channel's own
     output -- it is NOT part of the isolated set (it lives on the non-isolated side, by
     definition, once past the barrier).
  3. Every pull-up on this sheet is 3.9k -- FIX ROUND 2 (see .superpowers/sdd/
     2026-08-13-breakout-pcb/task-11-report.md's own "Fix round 2" section): the
     original 10k exceeded ACSL-6400/ACSL-6420's own shared datasheet RL-max (4k,
     Broadcom AV02-0235EN's ONE "Recommended Operating Conditions" table for the
     whole ACSL-6xx0 family) -- the same violation fix round 1 already corrected on
     opto-ni.kicad_sch, independently RE-VERIFIED against the datasheet here rather
     than inferred from that sibling sheet. 3.9k is the largest E24 value at or under
     that limit, on whichever rail (ISO_5V or +5V) each channel's own output side
     actually sits -- never 10k (this sheet's own former, now-stale value) and never
     the mule's own 1k.
  4. LED current-setting resistors are RAIL-AWARE (finding F1): 249R on +5V, 301R on
     ISO_5V. This is the only sheet with LEDs on both rails, so it is the only one
     where a single value is actually wrong -- see LED_R_OHMS_MAIN/LED_R_OHMS_ISO. The
     +5V figure matches opto-ni.kicad_sch's own value (the
     ACSL-6400/6420 family shares one set of electrical specs).
  5. ACSL-6420's own bi-directional (2/2) pin map is correct, per channel -- the SPECIFIC
     risk this task's own pin-level verification found: an all-in-one part cannot serve
     this sheet's own mixed-direction second package, and a bidirectional part's own
     "which two channels go which way" is exactly the kind of fact a permutation could
     silently get wrong while still looking fully connected.
  6. No same-column real 2-pin part may have its own pin-to-pin reach overlap another's --
     the GENERAL form of opto-ni.kicad_sch's own real coordinate-collision defect
     (CH_ROW_DY's own account in gen_breakout_opto_ni.py), checked structurally (from real,
     rendered pin geometry) rather than only after an actual duplicate coordinate appears
     -- see check_row_pitch_guard.py's own check_row_pitch_exceeds_2pin_span(), imported
     below (added directly in this file at fix round 1, factored into that shared module
     at fix round 2 once three more checkers needed the identical guard).

`verify()` below re-derives the full channel/pin contract independently of
gen_breakout_opto_intan.py's own choices -- same "a checker that trusted the generator
would only be checking the generator against itself" discipline every prior checker in this
project already follows.

Regenerate the netlist this reads via:
    kicad-cli sch export netlist --format kicadsexpr -o /tmp/breakout.net \\
        hardware/breakout/breakout.kicad_sch

Usage:
    python3 hardware/gen/check_breakout_opto_intan_netlist.py [path/to/breakout.net]

Exits 0 and prints a summary if every check (including the self-tests) passes; exits 1 with
a description of the first failure otherwise.
"""
from __future__ import annotations

import copy
import re
import sys
from pathlib import Path

sys.path.insert(0, str(Path(__file__).resolve().parent))
from check_mule_netlist import (  # noqa: E402
    CheckFailure,
    Node,
    check,
    parse_component_values,
    parse_netlist,
)
from check_row_pitch_guard import (  # noqa: E402
    check_row_pitch_exceeds_2pin_span,
    self_test_row_pitch,
)
from kicad_sch import (  # noqa: E402
    find_all_instance_paths,
    find_root_uuid,
    find_sheet_instance_path,
)

# FINDING F6 (2026-08-15): the panel BNCs are DUAL bodies -- Amphenol 031-6575, two
# independently-isolated ports per connector. A port is therefore (reference, centre pad),
# not a reference. This maps each centre-conductor pad to its OWN shell pad.
#
# Stated here rather than imported from hardware/gen/bnc_dual.py on purpose: a checker that
# read the pad map out of the generator it is checking would confirm the generator against
# its own claim. Same per-checker independence discipline every sheet contract in this
# directory already follows.
BNC_PORT_SHELL = {"1": "2", "3": "4"}

DEFAULT_NET_PATH = Path("/tmp/breakout.net")
DEFAULT_BREAKOUT_SCH = Path(__file__).resolve().parent.parent / "breakout" / "breakout.kicad_sch"
DEFAULT_OPTO_INTAN_SCH = DEFAULT_BREAKOUT_SCH.parent / "sheets" / "opto-intan.kicad_sch"
OPTO_INTAN_SHEETFILE = "sheets/opto-intan.kicad_sch"

# ---------------------------------------------------------------------------
# Channel/contract constants -- redefined here from this task's own brief and Broadcom's
# own AV02-0235EN, NEVER imported from the generator.
# ---------------------------------------------------------------------------
ACSL6400_VALUE = "ACSL-6400-00TE"
ACSL6420_VALUE = "ACSL-6420-00TE"
ISO5V_SUPPLY_VALUE = "TMR 1-0511"  # FINDING F5, 2026-08-16 -- was LD1117S50TR_SOT223,
# a linear regulator off ISO_P12, which drew this sheet's whole 63-96 mA digital branch
# THROUGH the isolated +-12 V module and left it at 114-170% of its 66 mA per-rail
# rating. The TMR 1-0511 is an isolated DC/DC fed from +5V/DGND instead, so that load
# never touches ISO_P12. Regulated, unlike the TMA-0505S the audit originally named --
# see gen_breakout_opto_intan.py's own place_iso_5v_supply() for why that matters.
BAT54S_VALUE = "BAT54S"

ACSL6400_CH_PINS = {
    0: ("1", "2", "14"),
    1: ("3", "4", "13"),
    2: ("5", "6", "12"),
    3: ("7", "8", "11"),
}
ACSL6400_PIN_GND = ["9", "16"]
ACSL6400_PIN_VDD = ["10", "15"]

# ACSL-6420, Broadcom AV02-0235EN Figure 6/12 (both agree exactly) -- see
# gen_wl_sync_lib.py's own "ACSL-6420" comment. channel -> (anode, cathode, vo).
ACSL6420_DIR_1TO2 = {1: ("5", "6", "11"), 2: ("7", "8", "10")}
ACSL6420_DIR_2TO1 = {3: ("14", "13", "3"), 4: ("16", "15", "2")}
ACSL6420_PIN_GND1 = "1"
ACSL6420_PIN_VDD1 = "4"
ACSL6420_PIN_GND2 = "9"
ACSL6420_PIN_VDD2 = "12"

# FINDING F1, 2026-08-16 -- TWO values, one per anode rail. +5V reaches its LEDs
# through F4 and D3 (0.38-0.45V of series drop), ISO_5V is regulated locally with
# nothing in series, so the same resistor on both would over-drive the ISO_5V channels
# past the part's 15mA ABSOLUTE maximum. See gen_breakout_opto_intan.py's own
# LED_R_OHMS_MAIN/LED_R_OHMS_ISO comment for the derivation.
LED_R_OHMS_MAIN = "249"  # E96 -- LEDs fed from +5V
LED_R_OHMS_ISO = "301"   # E96 -- LEDs fed from ISO_5V
PULLUP_OHMS = "3.9k"  # fix round 2 -- corrected from 10k, which exceeded ACSL-6400/
# ACSL-6420's own shared datasheet RL-max (4k). See module docstring, risk 3.

OUTBOUND_CHANNELS = [
    ("EVT_STROBE_INTAN_BUF", "EVT_STROBE_INTAN"),
    ("BARCODE_INTAN_BUF", "BARCODE_INTAN"),
    ("RWD_CMD_INTAN_BUF", "RWD_CMD_INTAN"),
    ("RWD_DLVR_INTAN_BUF", "RWD_DLVR_INTAN"),
]
STIM_TRIG_CHANNEL = ("STIM_TRIG_INTAN_BUF", "STIM_TRIG_INTAN")
# FINDING F2, 2026-08-16 -- the inbound channel's LED is driven by a LOCAL BUFFER on
# ISO_5V (U75), not by Intan's own output pin through the 100R panel resistor. That
# resistor used to sit INSIDE the LED loop, making it 401R and the current 6.57 mA
# against a 7.0 mA switching minimum; it now does protection only. The buffer's TTL
# thresholds also retire the design's dependence on Intan's undocumented CONFIG4 switch
# position, which selected 3.3 V or 5.0 V outputs and silently broke the off-state at
# 3.3 V. See gen_breakout_opto_intan.py's own RHS_STIM_BUF_REF for the full account.
RHS_STIM_BUF_NET = "RHS_STIM_ISO_BUF"
RHS_STIM_BUF_VALUE = "SN74AHCT541PW"
RHS_STIM_CHANNEL = (RHS_STIM_BUF_NET, "RHS_STIM_OUT")

ALL_SOURCE_NETS = {c[0] for c in OUTBOUND_CHANNELS} | {STIM_TRIG_CHANNEL[0]}  # DGND-side sources
ALL_OUTBOUND_FINAL = {c[1] for c in OUTBOUND_CHANNELS} | {STIM_TRIG_CHANNEL[1]}  # INTAN-side finals

NON_ISOLATED_RAILS = {"+5V", "+3V3", "+12V", "-12V", "AGND", "DGND"}
ISOLATED_RAILS = {"ISO_5V", "INTAN_GND"}
# RHS_STIM_OUT is the DGND-side (non-isolated) name for the inbound channel's own output
# -- NOT part of the isolated net set. RHS_STIM_RAW is the Intan-side (isolated) name for
# its own source, upstream of the LED.
ISOLATED_NETS = ISOLATED_RAILS | ALL_OUTBOUND_FINAL | {"RHS_STIM_RAW", RHS_STIM_BUF_NET}
NON_ISOLATED_NETS = NON_ISOLATED_RAILS | ALL_SOURCE_NETS | {"RHS_STIM_OUT"}


# ---------------------------------------------------------------------------
# Shared helpers -- duplicated from prior checkers' own technique, not imported.
# ---------------------------------------------------------------------------


def _find_bridging_resistor(nets: dict[str, list[Node]], net_a: str, net_b: str) -> str:
    check(net_a in nets, f"missing net: {net_a!r}")
    check(net_b in nets, f"missing net: {net_b!r}")
    ra = {n.ref for n in nets[net_a] if n.ref.startswith("R")}
    rb = {n.ref for n in nets[net_b] if n.ref.startswith("R")}
    both = ra & rb
    check(
        len(both) == 1,
        f"expected exactly 1 resistor bridging {net_a!r}<->{net_b!r}, found on {net_a}: "
        f"{sorted(ra)}, on {net_b}: {sorted(rb)}",
    )
    return next(iter(both))


def _node_net(nets: dict[str, list[Node]], ref: str, pin: str) -> str:
    hits = [name for name, nodelist in nets.items() if any(n.ref == ref and n.pin == pin for n in nodelist)]
    check(len(hits) == 1, f"{ref}.{pin}: expected to be on exactly 1 net, found {hits}")
    return hits[0]


def _single_ref(values: dict[str, str], value: str) -> str:
    refs = [r for r, v in values.items() if v == value]
    check(len(refs) == 1, f"expected exactly 1 {value!r} instance, found {len(refs)}: {refs}")
    return refs[0]


# ---------------------------------------------------------------------------
# Checks
# ---------------------------------------------------------------------------


def _walk_outbound(nets, values, pkg_ref, ch_pins, led_hi, source_net, pu_hi, final_net, expect_pintype="open_collector") -> tuple[str, str]:
    """One outbound-style channel's own LED->pull-up walk. Returns (r_led, r_pu); raises
    on any mismatch. `pkg_ref` is asserted (not assumed) to actually drive `final_net`."""
    anode_pin, cathode_pin, vo_pin = ch_pins
    check(final_net in nets, f"missing contract net: {final_net!r}")
    oc_nodes = [n for n in nets[final_net] if n.pintype == expect_pintype]
    check(len(oc_nodes) == 1, f"{final_net}: expected exactly 1 {expect_pintype} VOx pin, found {oc_nodes} (all nodes: {nets[final_net]})")
    check(oc_nodes[0].ref == pkg_ref and oc_nodes[0].pin == vo_pin, f"{final_net}: expected {pkg_ref}.{vo_pin}, found {oc_nodes[0]}")

    r_pu = _find_bridging_resistor(nets, pu_hi, final_net)
    check(values.get(r_pu) == PULLUP_OHMS, f"{r_pu} ({final_net}'s own pull-up): expected {PULLUP_OHMS!r}, found {values.get(r_pu)!r}")
    other_hi_rails = (NON_ISOLATED_RAILS | ISOLATED_RAILS) - {pu_hi}
    on_other_rail = [rail for rail in other_hi_rails if any(n.ref == r_pu for n in nets.get(rail, []))]
    check(not on_other_rail, f"{r_pu} ({final_net}'s own pull-up) also has a pin on {on_other_rail} -- must be {pu_hi} only")

    check(source_net in nets, f"missing contract net: {source_net!r}")
    check(
        any(n.ref == pkg_ref and n.pin == cathode_pin for n in nets[source_net]),
        f"{source_net}: {pkg_ref} pin {cathode_pin} (CATHODE) not found -- expected the "
        f"LED's cathode driven directly from the source net",
    )
    anode_net = _node_net(nets, pkg_ref, anode_pin)
    check(anode_net != source_net, f"{pkg_ref} pin {anode_pin} (ANODE) is on the same net as CATHODE/source -- LED shorted")
    r_led = _find_bridging_resistor(nets, led_hi, anode_net)
    # Rail-aware, per F1 -- expected from the rail this LED's anode is ACTUALLY on
    # (`led_hi`, read from the same walk that verified the wiring), so the checker
    # cannot agree with a generator that picked the right value for the wrong rail.
    expect_r = LED_R_OHMS_ISO if led_hi == "ISO_5V" else LED_R_OHMS_MAIN
    check(values.get(r_led) == expect_r, f"{r_led} ({final_net}'s own LED resistor, anode on {led_hi}): expected {expect_r!r}, found {values.get(r_led)!r}")
    return r_led, r_pu


def _check_package_a(nets: dict[str, list[Node]], values: dict[str, str]) -> tuple[str, set[str]]:
    """ACSL-6400, 4 outbound channels: EVT_STROBE_BUF/BARCODE_PI/RWD_CMD_BUF/RWD_DLVR ->
    their own *_INTAN net, package power on ISO_5V/INTAN_GND. Returns (summary,
    own_refs) -- own_refs is every reference THIS FUNCTION discovered as belonging to
    opto-intan.kicad_sch (the package plus its own 4 channels' LED/pull-up resistors),
    for the domain-disjointness check to scope itself against (see that check's own
    docstring for why a project-wide rail scan cannot be used instead)."""
    # Discover package A from ANY one of the 4 outbound channels' own driver (module
    # docstring: ACSL-6400 is shared with opto-ni.kicad_sch, so a project-wide Value
    # scan cannot be used to identify "this sheet's own package" -- same reasoning
    # check_breakout_opto_ni_netlist.py's own fix already established).
    first_final = OUTBOUND_CHANNELS[0][1]
    check(first_final in nets, f"missing contract net: {first_final!r}")
    oc_nodes = [n for n in nets[first_final] if n.pintype == "open_collector"]
    check(len(oc_nodes) == 1, f"{first_final}: expected exactly 1 open_collector VOx pin, found {oc_nodes}")
    pkg_ref = oc_nodes[0].ref
    check(values.get(pkg_ref) == ACSL6400_VALUE, f"{pkg_ref}: expected Value {ACSL6400_VALUE!r}, found {values.get(pkg_ref)!r}")

    own_refs = {pkg_ref}
    for local_idx, (source_net, final_net) in enumerate(OUTBOUND_CHANNELS):
        r_led, r_pu = _walk_outbound(nets, values, pkg_ref, ACSL6400_CH_PINS[local_idx], "+5V", source_net, "ISO_5V", final_net)
        own_refs.update((r_led, r_pu))

    for gpin in ACSL6400_PIN_GND:
        check(any(n.ref == pkg_ref and n.pin == gpin for n in nets.get("INTAN_GND", [])), f"{pkg_ref} pin {gpin} (GND) not found on INTAN_GND")
    for vpin in ACSL6400_PIN_VDD:
        check(any(n.ref == pkg_ref and n.pin == vpin for n in nets.get("ISO_5V", [])), f"{pkg_ref} pin {vpin} (VDD) not found on ISO_5V")

    return f"Package A ({pkg_ref}, {ACSL6400_VALUE!r}): all 4 outbound channels walked end to end, GND/VDD on INTAN_GND/ISO_5V.", own_refs


def _check_package_b(nets: dict[str, list[Node]], values: dict[str, str]) -> tuple[str, str, set[str]]:
    """ACSL-6420, bi-directional 2/2: channel 1 (STIM_TRIG_BUF, direction 1->2) and
    channel 3 (RHS_STIM_OUT, direction 2->1). Returns (summary, pkg_ref, own_refs)."""
    stim_final = STIM_TRIG_CHANNEL[1]
    check(stim_final in nets, f"missing contract net: {stim_final!r}")
    oc_nodes = [n for n in nets[stim_final] if n.pintype == "open_collector"]
    check(len(oc_nodes) == 1, f"{stim_final}: expected exactly 1 open_collector VOx pin, found {oc_nodes}")
    pkg_ref = oc_nodes[0].ref
    check(values.get(pkg_ref) == ACSL6420_VALUE, f"{pkg_ref}: expected Value {ACSL6420_VALUE!r}, found {values.get(pkg_ref)!r}")
    own_refs = {pkg_ref}

    # Channel 1: direction 1->2 -- LED on +5V/DGND, output (pull-up) on ISO_5V.
    source1, final1 = STIM_TRIG_CHANNEL
    r_led1, r_pu1 = _walk_outbound(nets, values, pkg_ref, ACSL6420_DIR_1TO2[1], "+5V", source1, "ISO_5V", final1)
    own_refs.update((r_led1, r_pu1))

    # Channel 3: direction 2->1 -- LED on ISO_5V/INTAN_GND, output (pull-up) on +5V.
    # RHS_STIM_RAW is the ISO-side protected signal (upstream of this channel's own
    # LED); RHS_STIM_OUT is the DGND-side output -- the ALREADY-ESTABLISHED bare
    # contract net (Task 8).
    source3, final3 = RHS_STIM_CHANNEL
    r_led3, r_pu3 = _walk_outbound(nets, values, pkg_ref, ACSL6420_DIR_2TO1[3], "ISO_5V", source3, "+5V", final3)
    own_refs.update((r_led3, r_pu3))

    check(any(n.ref == pkg_ref and n.pin == ACSL6420_PIN_GND1 for n in nets.get("DGND", [])), f"{pkg_ref} pin {ACSL6420_PIN_GND1} (GND1) not found on DGND")
    check(any(n.ref == pkg_ref and n.pin == ACSL6420_PIN_VDD1 for n in nets.get("+5V", [])), f"{pkg_ref} pin {ACSL6420_PIN_VDD1} (VDD1) not found on +5V")
    check(any(n.ref == pkg_ref and n.pin == ACSL6420_PIN_GND2 for n in nets.get("INTAN_GND", [])), f"{pkg_ref} pin {ACSL6420_PIN_GND2} (GND2) not found on INTAN_GND")
    check(any(n.ref == pkg_ref and n.pin == ACSL6420_PIN_VDD2 for n in nets.get("ISO_5V", [])), f"{pkg_ref} pin {ACSL6420_PIN_VDD2} (VDD2) not found on ISO_5V")

    return (
        f"Package B ({pkg_ref}, {ACSL6420_VALUE!r}): channel 1 (STIM_TRIG_BUF, "
        f"direction 1->2, LED on +5V/DGND) and channel 3 (RHS_STIM_OUT, direction "
        f"2->1, LED on ISO_5V/INTAN_GND) both walked end to end; VDD1/GND1 on +5V/DGND, "
        f"VDD2/GND2 on ISO_5V/INTAN_GND.",
        pkg_ref,
        own_refs,
    )


def _rhs_stim_clamp_ref(nets: dict[str, list[Node]], values: dict[str, str]) -> str:
    """The BAT54S instance whose own pin 3 (COM) sits on RHS_STIM_RAW specifically --
    BAT54S is NOT unique project-wide (taskpc-digital.kicad_sch alone places 19 more,
    one per inbound task-PC channel), so this must be found by NET, not by a global
    Value scan (same reasoning check_breakout_opto_ni_netlist.py's own fix already
    established for ACSL-6400)."""
    check("RHS_STIM_RAW" in nets, "missing net: 'RHS_STIM_RAW'")
    candidates = [n.ref for n in nets["RHS_STIM_RAW"] if n.pin == "3" and values.get(n.ref) == BAT54S_VALUE]
    check(len(candidates) == 1, f"RHS_STIM_RAW: expected exactly 1 BAT54S pin 3 (COM), found {candidates}")
    return candidates[0]


def _check_rhs_stim_input_protection(nets: dict[str, list[Node]], values: dict[str, str]) -> tuple[str, set[str]]:
    """RHS_STIM_OUT's own inbound BNC -> 100R series -> BAT54S clamp (ISO_5V/INTAN_GND)
    -> RHS_STIM_RAW (module docstring, risk 1 / the global 'every panel input' constraint).
    Returns (summary, own_refs) -- the series resistor and clamp diode refs."""
    check("RHS_STIM_BNC" in nets, "missing net: 'RHS_STIM_BNC'")
    r_ref = _find_bridging_resistor(nets, "RHS_STIM_BNC", "RHS_STIM_RAW")
    check(values.get(r_ref) == "100", f"{r_ref} (RHS_STIM_OUT's own series resistor): expected '100', found {values.get(r_ref)!r}")

    d_ref = _rhs_stim_clamp_ref(nets, values)
    check(any(n.ref == d_ref and n.pin == "2" for n in nets.get("ISO_5V", [])), f"{d_ref} pin 2 (K, high clamp) not found on ISO_5V")
    check(any(n.ref == d_ref and n.pin == "1" for n in nets.get("INTAN_GND", [])), f"{d_ref} pin 1 (A, low clamp) not found on INTAN_GND")

    bnc_nodes = [n for n in nets["RHS_STIM_BNC"] if n.ref.startswith("J")]
    check(len(bnc_nodes) == 1, f"RHS_STIM_BNC: expected exactly 1 BNC connector pin, found {bnc_nodes}")

    # FINDING F2: the protected node feeds a LOCAL BUFFER, and NOT the LED directly. This
    # is the assertion that keeps the 100R doing protection only -- if the LED cathode ever
    # lands back on RHS_STIM_RAW, that resistor is inside the current loop again and the
    # channel is back to 6.57 mA against a 7.0 mA switching minimum.
    # Identified by RAIL, not by value: eleven SN74AHCT541PW sit on this board and only
    # this one is powered from ISO_5V. That is also the property worth asserting -- a
    # buffer for an isolated-domain signal that ended up on +5V would straddle the barrier.
    buf_candidates = sorted({
        n.ref for n in nets.get("ISO_5V", [])
        if values.get(n.ref) == RHS_STIM_BUF_VALUE
    })
    check(
        len(buf_candidates) == 1,
        f"expected exactly 1 {RHS_STIM_BUF_VALUE} powered from ISO_5V (the inbound stim "
        f"buffer, finding F2), found {buf_candidates}",
    )
    buf_ref = buf_candidates[0]
    buf_inputs = [n.pin for n in nets["RHS_STIM_RAW"] if n.ref == buf_ref]
    check(
        len(buf_inputs) == 2,
        f"RHS_STIM_RAW: expected exactly 2 {buf_ref} input pins (finding F1's paralleled "
        f"pair -- at 301R this LED draws ~10.5 mA, over one output's 7.5 mA budget), "
        f"found {buf_inputs}",
    )
    check(
        not [n for n in nets["RHS_STIM_RAW"] if values.get(n.ref, "").startswith("ACSL-")],
        "RHS_STIM_RAW: an optocoupler LED cathode sits on the PROTECTED node again -- it "
        "must sit on the buffer's output, or the 100R panel resistor is back inside the "
        "LED's own current loop (finding F2)",
    )
    check(
        not [n for n in nets.get("DGND", []) if n.ref == buf_ref],
        f"{buf_ref} (inbound stim buffer) has a pin on DGND -- every one of its unused "
        f"inputs and its own ground must reference INTAN_GND, this domain's own ground",
    )
    return f"RHS_STIM_OUT's own inbound protection: BNC -[100R {r_ref}]-> RHS_STIM_RAW -[BAT54S {d_ref} clamp to ISO_5V/INTAN_GND].", {r_ref, d_ref}


def _check_iso5v_supply(nets: dict[str, list[Node]], values: dict[str, str]) -> tuple[str, set[str]]:
    """ISO_5V's own source: a TMR 1-0511 isolated DC/DC -- primary on +5V/DGND, secondary
    on ISO_5V/INTAN_GND (module docstring, POWER; finding F5). Pin map verified against
    the datasheet's own Pinout table: 1 = -Vin, 2 = +Vin, 4 = +Vout, 6 = -Vout.

    THE INPUT SIDE IS THE POINT OF THIS CHECK, not decoration. The defect F5 fixed was
    invisible to every structural checker precisely because the old LDO's topology was
    perfectly correct -- VI on ISO_P12, GND on INTAN_GND, VO on ISO_5V, all as designed.
    What was wrong was WHICH RAIL its input current came from, which no connectivity
    assertion asks. So this check asserts the primary is on the NON-isolated side and
    explicitly that neither input pin has drifted back onto an isolated 12 V rail.
    Returns (summary, own_refs)."""
    ref = _single_ref(values, ISO5V_SUPPLY_VALUE)
    check(any(n.ref == ref and n.pin == "2" for n in nets.get("+5V", [])), f"{ref} pin 2 (+Vin) not found on +5V")
    check(any(n.ref == ref and n.pin == "1" for n in nets.get("DGND", [])), f"{ref} pin 1 (-Vin) not found on DGND")
    check(any(n.ref == ref and n.pin == "4" for n in nets.get("ISO_5V", [])), f"{ref} pin 4 (+Vout) not found on ISO_5V")
    check(any(n.ref == ref and n.pin == "6" for n in nets.get("ISO_5V_RTN", [])), f"{ref} pin 6 (-Vout) not found on ISO_5V_RTN")
    # NT4: ISO_5V_RTN joined to INTAN_GND at exactly one NetTie_2. The converter's
    # secondary return is deliberately NOT merged straight into INTAN_GND -- two isolated
    # secondaries' power_output pins on one net is a real ERC pin_to_pin error, and the
    # board's own answer to that (NT1/NT2/NT3) is an explicit single-point tie. It also
    # keeps this switcher's return current off the INA105s' reference by construction.
    tie = ({n.ref for n in nets.get("ISO_5V_RTN", [])}
           & {n.ref for n in nets.get("INTAN_GND", [])})
    check(
        tie == {"NT4"},
        f"ISO_5V_RTN and INTAN_GND should be joined by EXACTLY the net tie NT4, found "
        f"{tie or 'nothing'} -- if they are merged directly the switcher's return runs "
        f"through the Intan analog reference wherever the plane happens to connect",
    )
    for iso_rail in ("ISO_P12", "ISO_N12"):
        on_iso = [n.pin for n in nets.get(iso_rail, []) if n.ref == ref]
        check(
            not on_iso,
            f"{ref} has pin(s) {on_iso} on {iso_rail} -- ISO_5V's supply must draw its "
            f"input current from the NON-isolated side. Drawing it from an isolated rail "
            f"is finding F5's original defect: the IH1215D is rated 66 mA per rail and "
            f"this branch is 63-96 mA.",
        )
    return (
        f"ISO_5V's own source ({ref}, {ISO5V_SUPPLY_VALUE!r}, isolated DC/DC): +Vin on "
        f"+5V, -Vin on DGND, +Vout on ISO_5V, -Vout on INTAN_GND -- and no pin on "
        f"ISO_P12/ISO_N12, so its input current does not load the isolated module.",
        {ref},
    )


def _check_all_bncs(nets: dict[str, list[Node]], values: dict[str, str]) -> tuple[str, set[str]]:
    """6 BNCs total (5 outbound + 1 inbound), each shell on INTAN_GND, no two channels
    sharing one connector. Returns (summary, own_refs)."""
    # Each of the 5 OUTBOUND connectors now sits on `<channel>_BNC`, one 100R series
    # resistor away from the channel's own output net (finding M3's class, extended
    # 2026-08-16 -- see gen_breakout_opto_intan.py's own place_bnc()). The inbound channel
    # keeps RHS_STIM_BNC, which was already behind its own 100R. So the connector is never
    # on the driver's net, which is the property that changed.
    driven_nets = {c[1] for c in OUTBOUND_CHANNELS} | {STIM_TRIG_CHANNEL[1]}
    expected_center_nets = {f"{n}_BNC" for n in driven_nets} | {"RHS_STIM_BNC"}
    check(len(expected_center_nets) == 6, f"internal inconsistency: expected 6 BNC center nets, computed {len(expected_center_nets)}")
    all_bnc_refs = set()
    for net in sorted(driven_nets):
        r_ref = _find_bridging_resistor(nets, net, f"{net}_BNC")
        check(
            values.get(r_ref) == "100",
            f"{net}: series resistor {r_ref} to its connector should be '100', found "
            f"{values.get(r_ref)!r} -- every panel connection on this board carries series "
            f"resistance, and these five outbound BNCs were the exception until 2026-08-16",
        )
        check(
            not [n for n in nets[net] if n.ref.startswith("J")],
            f"{net}: a BNC connector still sits on the DRIVER's own net -- it must sit on "
            f"{net}_BNC, behind the series resistor",
        )
    all_bnc_ports = set()
    for net in expected_center_nets:
        check(net in nets, f"missing net: {net!r}")
        j_nodes = [n for n in nets[net] if n.ref.startswith("J")]
        check(len(j_nodes) == 1, f"{net}: expected exactly 1 BNC connector pin, found {j_nodes}")
        ref, centre_pin = j_nodes[0].ref, j_nodes[0].pin
        check(
            centre_pin in BNC_PORT_SHELL,
            f"{net}: lands on {ref} pin {centre_pin}, which is not a centre-conductor pad "
            f"({sorted(BNC_PORT_SHELL)}) -- a signal wired to a SHELL pad exports a clean "
            f"netlist and a dead channel",
        )
        shell_pin = BNC_PORT_SHELL[centre_pin]
        check(
            any(n.ref == ref and n.pin == shell_pin for n in nets.get("INTAN_GND", [])),
            f"{ref} port {centre_pin}/{shell_pin} (on {net}): this port's own shell is not on INTAN_GND",
        )
        all_bnc_refs.add(ref)
        all_bnc_ports.add((ref, centre_pin))
    # FINDING F6: 6 ports on 3 dual bodies. Counted as PORTS, because a dual body legitimately
    # appears twice -- the pre-F6 version of this check counted distinct references and would
    # now read 3 where the contract wants 6.
    check(
        len(all_bnc_ports) == 6,
        f"expected 6 DISTINCT BNC ports, found {len(all_bnc_ports)}: {sorted(all_bnc_ports)}",
    )
    check(
        len(all_bnc_refs) == 3,
        f"expected 6 ports on 3 dual bodies (finding F6), found {len(all_bnc_refs)}: {sorted(all_bnc_refs)}",
    )
    return (
        f"All 6 BNC PORTS on {len(all_bnc_refs)} dual bodies ({sorted(all_bnc_refs)}) "
        f"confirmed: each port distinct, each port's own shell on INTAN_GND, centre on "
        f"the right channel net."
    ), all_bnc_refs


def _check_domain_pin_disjoint(nets: dict[str, list[Node]], values: dict[str, str], own_refs: set[str], barrier_refs: set[str]) -> str:
    """The Intan-isolated domain must be PIN-DISJOINT from every non-isolated rail and
    source/RHS_STIM_OUT net, except the ACSL-6400/6420 packages themselves, straddling
    by design (module docstring, risk 2).

    SCOPED TO `own_refs` -- every reference the other checks in this file discovered as
    genuinely part of opto-intan.kicad_sch (both packages, every channel's own LED/
    pull-up resistor, the LDO, the clamp diode, the series resistor, all 6 BNCs) --
    DELIBERATELY NOT a blind scan of "every node on ISO_5V/INTAN_GND/+5V/DGND/etc.
    project-wide". Confirmed empirically why the blind version is wrong, not assumed:
    mux-intan.kicad_sch's own 8 INA105KU difference amplifiers EACH carry a real pin on
    BOTH INTAN_GND (isolated) and AGND (non-isolated) -- Task 10c's own already-reviewed
    analog design, which senses relative to AGND at one leg while running its own supply
    from the isolated rail, a DELIBERATE partial-isolation choice for the analog fan-out
    that is explicitly NOT the same guarantee this task's own DIGITAL optocoupler barrier
    makes (spec's own architecture note: analog fan-out uses differential receive and
    NRSE, not galvanic isolation; only the digital crossings are optocoupled). Task 7's
    own isolated DC-DC (U2) straddles +12V/DGND vs INTAN_GND identically, by design, as
    the isolated supply itself. Scanning by rail name alone pulled BOTH sets of
    already-reviewed, out-of-this-task's-scope components in as false positives before
    this fix -- restricting to own_refs excludes them correctly without re-litigating
    Task 7's or Task 10c's own, separately-reviewed designs.
    """
    isolated_nodes = {(ref, pin) for name in ISOLATED_NETS for n in nets.get(name, []) if (ref := n.ref) in own_refs for pin in (n.pin,)}
    non_isolated_nodes = {(ref, pin) for name in NON_ISOLATED_NETS for n in nets.get(name, []) if (ref := n.ref) in own_refs for pin in (n.pin,)}
    isolated_refs = {ref for ref, _pin in isolated_nodes}
    non_isolated_refs = {ref for ref, _pin in non_isolated_nodes}
    straddling = isolated_refs & non_isolated_refs

    check(
        straddling == barrier_refs,
        f"unexpected straddling references, among opto-intan.kicad_sch's own {len(own_refs)} "
        f"components, between the Intan-isolated domain and non-isolated rails: "
        f"{straddling - barrier_refs or 'none'} (expected only the 2 barrier packages "
        f"{sorted(barrier_refs)}); missing expected straddlers: {barrier_refs - straddling or 'none'}",
    )
    check(
        isolated_refs | non_isolated_refs <= own_refs,
        "internal check error: a ref outside own_refs leaked into the domain scan",
    )
    return (
        f"Intan-isolated domain (ISO_5V/INTAN_GND/all *_INTAN nets/RHS_STIM_RAW) is "
        f"pin-disjoint from every non-isolated rail/*_BUF/source net/RHS_STIM_OUT, among "
        f"opto-intan.kicad_sch's own {len(own_refs)} components, except the 2 barrier "
        f"packages {sorted(barrier_refs)}, straddling by design."
    )


_GLOBAL_LABEL_RE = re.compile(r'\(global_label "([^"]+)"\s*\(shape \w+\)\s*\(at ([\-0-9.]+) ([\-0-9.]+)')


def _check_no_coordinate_collisions(sch_text: str) -> str:
    coords: dict[tuple[float, float], set[str]] = {}
    for m in _GLOBAL_LABEL_RE.finditer(sch_text):
        name, x, y = m.group(1), round(float(m.group(2)), 3), round(float(m.group(3)), 3)
        coords.setdefault((x, y), set()).add(name)
    check(len(coords) > 40, f"suspiciously few distinct label coordinates found ({len(coords)}) -- is this really opto-intan.kicad_sch's own rendered text?")
    collisions = {k: v for k, v in coords.items() if len(v) > 1}
    check(
        not collisions,
        f"{len(collisions)} coordinate(s) in opto-intan.kicad_sch carry more than one "
        f"DISTINCT global-label net name -- a real electrical short: {list(collisions.items())[:5]}",
    )
    return f"No coordinate collisions: all {len(coords)} distinct global-label positions in opto-intan.kicad_sch carry exactly one net name each."


# ---------------------------------------------------------------------------
# GENERAL row-pitch-vs-2-pin-part-span guard -- fix round 1 (added directly in this file
# and in check_breakout_opto_ni_netlist.py); FACTORED OUT to check_row_pitch_guard.py at
# fix round 2, once the identical guard needed back-porting to three more checkers that had
# never had it (see that module's own docstring for the full account of why this ONE check
# -- unlike every sheet-specific check in this file -- has no sheet-specific parameters,
# and so graduated from "duplicated" to "shared"). `_check_no_coordinate_collisions()`
# above catches an ACTUAL duplicate label coordinate, which needs the real bad schematic to
# exist first; the imported guard instead checks the STRUCTURAL property (no same-column
# 2-pin part's own real pin-reach overlaps another's) that prevents one from ever being
# possible, independently of whether THIS sheet's own current layout happens to trip an
# exact coincidence. `check_row_pitch_exceeds_2pin_span()`/`self_test_row_pitch()`,
# imported above, are called against opto-intan.kicad_sch's own real rendered text in
# main() below -- the non-vertical-2-pin-part exclusion that skips THIS sheet's own BNC
# jacks rather than force-fitting them (found necessary during fix round 1's own
# development, see task-11-report.md) lives in that shared module now, inherited
# unchanged.
# ---------------------------------------------------------------------------


def _check_one_led_per_source_net(nets, sheet_label: str, source_nets) -> str:
    """Every LED cathode net named by this sheet's own channel table carries EXACTLY ONE
    optocoupler LED cathode pin, BOARD-WIDE.

    Not a stylistic check. Each ACSL LED here is fed from +5V through 249R (or ISO_5V
    through 301R) and draws ~10-13mA -- a value chosen to sit inside the part's own
    7-15mA recommended band and clear of its 7.0mA worst-case switching threshold, so it
    cannot simply be lowered.
    Two LEDs on one net means two LEDs on one driver pin: 14.7mA against SN74HCT541's 6mA
    IOL, or against SN74HCT32's 4mA. This board shipped that defect on five nets at once
    (EVT_STROBE_BUF, RWD_CMD_BUF, STIM_TRIG_BUF, BARCODE_PI, RWD_DLVR -- each feeding an
    NI LED and an Intan LED from one pin), and it is INVISIBLE to any check that reasons
    about one sheet at a time: opto-ni sees one LED on the net, opto-intan sees one LED on
    the net, and neither can see the other. So this check deliberately counts across the
    WHOLE exported netlist, not just this sheet's own references.

    See gen_breakout_taskpc_digital.py's own SECOND_LEG_CHANNELS for the fix and the
    per-pin numbers.
    """
    for source in sorted(source_nets):
        check(source in nets, f"{sheet_label}: missing source net {source!r}")
        cathodes = [n for n in nets[source] if (n.pinfunction or "").startswith("CATHODE")]
        check(
            len(cathodes) == 1,
            f"{source}: carries {len(cathodes)} optocoupler LED cathode pin(s) board-wide "
            f"({[(n.ref, n.pin) for n in cathodes]}), expected exactly 1. Two LEDs on one "
            f"net is two LEDs on one driver pin -- ~14.7mA against a 6mA (SN74HCT541) or "
            f"4mA (SN74HCT32) IOL. Give the second one its own buffered leg "
            f"(gen_breakout_taskpc_digital.py's own SECOND_LEG_CHANNELS).",
        )
    return (
        f"{sheet_label}: all {len(source_nets)} LED source nets carry exactly one LED "
        f"cathode pin board-wide -- one optocoupler LED per driver pin, counted across "
        f"the whole netlist rather than this sheet alone."
    )


def verify(nets: dict[str, list[Node]], values: dict[str, str]) -> list[str]:
    summary = []
    summary.append(_check_one_led_per_source_net(nets, "opto-intan", ALL_SOURCE_NETS))
    a_summary, a_refs = _check_package_a(nets, values)
    summary.append(a_summary)
    b_summary, pkg_b_ref, b_refs = _check_package_b(nets, values)
    summary.append(b_summary)
    supply_summary, supply_refs = _check_iso5v_supply(nets, values)
    summary.append(supply_summary)
    rhs_summary, rhs_refs = _check_rhs_stim_input_protection(nets, values)
    summary.append(rhs_summary)
    bnc_summary, bnc_refs = _check_all_bncs(nets, values)
    summary.append(bnc_summary)

    pkg_a_ref = next(r for r in a_refs if values.get(r) == ACSL6400_VALUE)
    own_refs = a_refs | b_refs | supply_refs | rhs_refs | bnc_refs
    # THREE straddling references now, not two -- finding F5. The ISO_5V supply used
    # to be an LDO living wholly inside the Intan domain (ISO_P12 in, ISO_5V out, all
    # INTAN_GND-referenced); the TMR 1-0511 that replaced it is an isolated DC/DC whose
    # primary sits on +5V/DGND, so it crosses the barrier BY DESIGN exactly as the two
    # ACSL packages and Task 7's own IH1215D do. Listing it explicitly keeps this an
    # EXACT set comparison: an unexpected straddler is still a failure, and a missing
    # expected one is too.
    iso5v_supply_ref = next(iter(supply_refs))
    summary.append(_check_domain_pin_disjoint(
        nets, values, own_refs, {pkg_a_ref, pkg_b_ref, iso5v_supply_ref}))

    # ISO_P12 deliberately NOT listed any more (finding F5): this sheet no longer
    # consumes it at all, which is the whole point of the change. Asserting its presence
    # here would pass on a board-wide net this sheet has nothing to do with.
    for rail in ("+5V", "DGND", "ISO_5V", "INTAN_GND"):
        check(rail in nets, f"missing consumed/produced rail: {rail!r}")
    return summary


# ---------------------------------------------------------------------------
# Self-test: negative controls confirming the checks above actually fire.
# ---------------------------------------------------------------------------


def _assert_fails(nets, values, expect_substring: str, label: str) -> str:
    try:
        verify(nets, values)
    except CheckFailure as e:
        check(expect_substring in str(e), f"self-test {label!r}: wrong complaint (expected {expect_substring!r}, got: {e})")
        return str(e)
    raise CheckFailure(f"self-test {label!r}: verify() did NOT raise on a corrupted netlist")


def self_test(good_nets: dict[str, list[Node]], good_values: dict[str, str]) -> list[str]:
    results = []
    # (0) THE CROSS-SHEET LOAD DEFECT -- the mirror image of opto-ni's own control of the
    # same name: an opto-NI LED cathode landing on THIS sheet's source net, which is
    # exactly the shape of "two LEDs on one driver pin". See
    # _check_one_led_per_source_net() for why this must be counted board-wide.
    doubled = copy.deepcopy(good_nets)
    doubled["STIM_TRIG_INTAN_BUF"] = list(doubled["STIM_TRIG_INTAN_BUF"]) + [
        Node("U61", "2", "CATHODE1_2", "passive")
    ]
    msg = _assert_fails(doubled, good_values, "expected exactly 1", "a second LED cathode added to STIM_TRIG_INTAN_BUF")
    results.append(f"Two optocoupler LEDs on one driver pin (STIM_TRIG_INTAN_BUF gains opto-ni's own U61 cathode): caught -- {msg}")


    # (1) Pull-up value drift on an outbound channel -- specifically BACK to this
    # sheet's own former, now-stale, datasheet-RL-max-violating 10k (fix round 2's own
    # most meaningful regression to guard against: someone "fixing" this back to what
    # looks like the more conservative value).
    drifted = dict(good_values)
    r_pu = _find_bridging_resistor(good_nets, "ISO_5V", "BARCODE_INTAN")
    drifted[r_pu] = "10k"
    msg = _assert_fails(good_nets, drifted, "expected '3.9k'", f"{r_pu} (BARCODE_INTAN's own pull-up) drifted 3.9k->10k (the stale, RL-max-violating value)")
    results.append(f"Pull-up value drift (3.9k -> the stale 10k, BARCODE_INTAN, {r_pu}): caught -- {msg}")

    # (2) Pull-up value drift on the inbound channel (RHS_STIM_OUT's own, +5V-referenced)
    # -- the mule's own 1k, the same drift target opto-ni.kicad_sch's own analogous
    # self-test uses.
    drifted2 = dict(good_values)
    r_pu2 = _find_bridging_resistor(good_nets, "+5V", "RHS_STIM_OUT")
    drifted2[r_pu2] = "1k"
    msg = _assert_fails(good_nets, drifted2, "expected '3.9k'", f"{r_pu2} (RHS_STIM_OUT's own pull-up) drifted 3.9k->1k (the mule's own value)")
    results.append(f"Pull-up value drift (3.9k -> the mule's own 1k, RHS_STIM_OUT, {r_pu2}): caught -- {msg}")

    # (3) THE domain-defeating hazard: an outbound channel's own pull-up ALSO wired to
    # +5V (shorting the isolated rail onto the non-isolated one) -- ADD a stray node,
    # don't move the real one (same reasoning as every other checker's identical control).
    also_5v = copy.deepcopy(good_nets)
    r_pu3 = _find_bridging_resistor(good_nets, "ISO_5V", "RWD_CMD_INTAN")
    stray = next(n for n in good_nets["ISO_5V"] if n.ref == r_pu3)
    also_5v.setdefault("+5V", []).append(stray)
    msg = _assert_fails(also_5v, good_values, "also has a pin on", f"{r_pu3} (RWD_CMD_INTAN's own pull-up) also wired to +5V")
    results.append(f"Pull-up also wired to +5V (defeats the isolation barrier, RWD_CMD_INTAN, {r_pu3}): caught -- {msg}")

    # (4) LED resistor value drift.
    drifted4 = dict(good_values)
    pkg_a_ref = next(n.ref for n in good_nets["EVT_STROBE_INTAN"] if n.pintype == "open_collector")
    anode_net = _node_net(good_nets, pkg_a_ref, "1")
    r_led = _find_bridging_resistor(good_nets, "+5V", anode_net)
    drifted4[r_led] = "330"
    # Asserts on the complaint text built from LED_R_OHMS_MAIN, which changed at F1 -- a
    # control still asserting on "expected '430'" would fail as "wrong complaint".
    msg = _assert_fails(good_nets, drifted4, f"expected {LED_R_OHMS_MAIN!r}", f"{r_led} (EVT_STROBE_INTAN's own LED resistor) drifted {LED_R_OHMS_MAIN}->330")
    results.append(f"LED resistor value drift ({LED_R_OHMS_MAIN} -> 330, EVT_STROBE_INTAN, {r_led}): caught -- {msg}")

    # (5) ACSL-6420 channel-direction permutation: swap STIM_TRIG_INTAN's own VOx node
    # with RHS_STIM_OUT's own VOx node (simulating a generator edit that assigns the
    # wrong physical channel/direction to a signal -- the exact "plausible but wrong"
    # class this task's own brief warns about).
    swapped = copy.deepcopy(good_nets)
    a_idx = next(i for i, n in enumerate(swapped["STIM_TRIG_INTAN"]) if n.pintype == "open_collector")
    b_idx = next(i for i, n in enumerate(swapped["RHS_STIM_OUT"]) if n.pintype == "open_collector")
    swapped["STIM_TRIG_INTAN"][a_idx], swapped["RHS_STIM_OUT"][b_idx] = swapped["RHS_STIM_OUT"][b_idx], swapped["STIM_TRIG_INTAN"][a_idx]
    msg = _assert_fails(swapped, good_values, "expected", "STIM_TRIG_INTAN/RHS_STIM_OUT own VOx nodes swapped (wrong-direction channel assignment)")
    results.append(f"ACSL-6420 channel/direction permutation (STIM_TRIG_INTAN <-> RHS_STIM_OUT own VOx pins): caught -- {msg}")

    # (6) RHS_STIM_OUT's own clamp diode moved off INTAN_GND (a real, silent hazard --
    # the low-side clamp reference lost).
    moved = copy.deepcopy(good_nets)
    d_ref = _rhs_stim_clamp_ref(good_nets, good_values)
    d_low_node = next(n for n in good_nets["INTAN_GND"] if n.ref == d_ref)
    moved["INTAN_GND"] = [n for n in moved["INTAN_GND"] if n != d_low_node]
    msg = _assert_fails(moved, good_values, "not found on INTAN_GND", f"{d_ref} pin 1 (A, low clamp) dropped from INTAN_GND")
    results.append(f"RHS_STIM_OUT clamp diode's own low-side reference dropped ({d_ref}): caught -- {msg}")

    # (7) A BNC shell disconnected from INTAN_GND (simulating a dropped/misrouted shell tie).
    no_shell = copy.deepcopy(good_nets)
    # BARCODE_INTAN_BNC, not BARCODE_INTAN: the connector moved behind its own 100R at
    # the M3-class extension (2026-08-16), so the driver net no longer carries a J pin.
    bnc_ref_on_barcode = next(n.ref for n in good_nets["BARCODE_INTAN_BNC"] if n.ref.startswith("J"))
    shell_node = next(n for n in good_nets["INTAN_GND"] if n.ref == bnc_ref_on_barcode)
    no_shell["INTAN_GND"] = [n for n in no_shell["INTAN_GND"] if n != shell_node]
    # Asserts on "shell is not on INTAN_GND" -- the invariant part. The old text named
    # "pin 2", which finding F6 turned into "pin 2 or pin 4 depending on which port".
    msg = _assert_fails(no_shell, good_values, "shell is not on INTAN_GND", f"{bnc_ref_on_barcode}'s own shell dropped from INTAN_GND")
    results.append(f"BNC shell disconnected from INTAN_GND ({bnc_ref_on_barcode}, BARCODE_INTAN): caught -- {msg}")

    return results


def self_test_collision(good_sch_text: str) -> str:
    matches = list(_GLOBAL_LABEL_RE.finditer(good_sch_text))
    check(len(matches) > 20, "self-test setup failed: too few global labels found to corrupt")
    first = matches[0]
    victim = next(m for m in matches if m.group(1) != first.group(1))
    corrupted = (
        good_sch_text[: victim.start(2)]
        + first.group(2) + " " + first.group(3)
        + good_sch_text[victim.end(3):]
    )
    check(corrupted != good_sch_text, "self-test setup failed: splice produced no change")
    try:
        _check_no_coordinate_collisions(corrupted)
    except CheckFailure as e:
        check("DISTINCT global-label net name" in str(e), f"self-test 'coordinate collision reintroduced': wrong failure message: {e}")
        return str(e)
    raise CheckFailure("self-test 'coordinate collision reintroduced' did NOT raise -- _check_no_coordinate_collisions() is passing vacuously")


# self_test_row_pitch() itself is imported from check_row_pitch_guard.py (see imports
# above) -- called against opto-intan.kicad_sch's own real rendered text in main() below.
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
