jakewesterberg/wl-sync/(commit log)

2026-08-13 docs: implementation plan for the sync box
    Split out of wl-preproc: this runs on a Pi 4, depends on pigpio, and is
    useful to any rig independently of that pipeline. It owns everything it
    produces — session identity, the barcode codec, the log format — and
    wl-preproc depends on it, never the reverse.
    Four tasks, all testable with no Pi libraries installed: pigpio is reached
    through an adapter with an in-memory fake and sits behind an optional extra.
2026-08-13 docs: retarget the sync box to Raspberry Pi 5 and RP1 PIO
    The earlier Pi 4 ruling treated the sync box as one hard-real-time job. It
    is three, and only strobe capture is demanding: barcode output has 5 ms bit
    slots and each receiver times its own edges, and the camera trigger is a
    hardware PWM channel whose output the box records anyway. So Pi 5 needs PIO
    for one function, not all three.
    Taken on supply chain and maintenance rather than precision — pigpio's
    1-5 us already beat the ~100 us requirement by 20x, but it is Pi-4-only and
    unmaintained.
    The backend protocol is now mechanism-neutral rather than modelled on
    pigpio's wave API, so nothing about PIO leaks into the service layer or th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
2026-08-13 feat: session identity, minted by the sync box
    Also drops the upper Python bound the plan specified. The <3.12 cap came
    from wl-preproc's Kilosort4/PyTorch pin, which does not apply here — and it
    would have blocked installation on the Pi 5's system Python, since
    Raspberry Pi OS Trixie ships 3.13. This package must work on 3.11, not be
    capped at it. Developed against 3.11 so the floor is what gets tested.
2026-08-13 feat: barcode codec, tolerant of software-timed generation
    Execution surfaced a real gap the plan missed: the first barcode of every
    stream was undecodable. A line that starts LOW and never transitions emits
    no edge, so the preceding idle could not be verified and the frame was
    skipped. edges_from_samples hid this by synthesising an edge at t0, but the
    Pi's own edge log has none.
    decode_edges now takes an optional start_us declaring "the record begins
    here, line LOW". Without it the first frame is still skipped, and a test
    pins that as deliberate — a wrong barcode is far worse than a missing one.
    One test failure was the test's own fault and worth recording: it built a
    30 kHz trace with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
    [barcode.py, test_barcode.py]
2026-08-13 feat: mechanism-neutral backend protocol, generator and recorder
    Fixes a bug found reviewing the plan before execution: Recorder shared one
    tick-unwrap state across both capture paths. The PIO FIFO and edge capture
    deliver independently, so a word can arrive after an edge that precedes it
    in time, and a shared counter reads that ordinary interleaving as a 32-bit
    wraparound — jumping every subsequent record forward by 4295 seconds.
    Unwrapping is now per path, since each path is individually ordered. Two
    tests pin it: one that out-of-order delivery does not fake a wrap, and one
    that a wrap on the edge path leaves the word path undisturbed.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
    [backend.py, service.py]
2026-08-13 ci: test on 3.11 and 3.13, and guard against a hardware dependency
    Both ends of the range are load-bearing. 3.11 is wl-preproc's floor, capped
    by the Kilosort4/PyTorch pin for Pascal; 3.13 is what Raspberry Pi OS Trixie
    ships, so it is what the sync box will run on. Verified locally on both
    before committing: 45 passed each.
    The second step asserts no Pi library reached the base install. If piolib or
    a GPIO library ever leaks out of the optional extra, the core stops being
    testable without hardware and every later regression gets found on a bench
    rather than in a pull request.
2026-08-13 docs: pin Raspberry Pi OS as part of the constraint, not a preference
2026-08-13 docs: breakout PCB design spec
    The hub board between the task PC, the Pi 5 sync box and the recorders.
    Two rigs, one fully-populated design, 2U rack.
    The board turned out to be mixed-signal rather than a digital fan-out,
    which changed the isolation architecture: optocouplers on the 28 digital
    crossings, difference amplifiers on the 33 analog stages, because
    isolating 17 digital lines while 30-plus analog lines tie the same
    grounds is ceremony rather than protection.
    Records five reversals against the wl-preproc spec, including that a
    74HCT541 cannot serve both level-shift directions -- safe going up,
    and going down it either exceeds its own input rating or hands 5 V to a
    Pi that is not 5 V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
2026-08-13 docs: breakout PCB implementation plan
    Seventeen tasks across two tracks: an event-path mule board fabbed first
    to validate the level-shift and isolation topology while the main board
    is still in schematic, then the breakout itself sheet by sheet.
    Adapted from the software plan format, since copper has no TDD rhythm.
    Verification gates are ERC, DRC, netlist assertions and bench
    measurement, and each task is marked agent, human, or human-led rather
    than pretending an agent can solder.
    Track 0 carries the three things that must not wait: NI cards ordered,
    connector lead times checked, and the four spec open items that gate
    schematic capture.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
2026-08-13 chore(hw): KiCad project skeleton and library paths
    Sets up the hardware/ tree every later breakout-PCB task builds on:
    - hardware/.gitignore excludes KiCad's transient files (backups, lock
    files, fp-info-cache) so they never reach git, without touching the
    repo-root .gitignore (it has no *.bak or lock-file pattern to
    reconcile, and hardware/.gitignore already covers the subtree).
    - hardware/sym-lib-table registers the stock KiCad symbol libraries
    this design draws from (Device, 74xx, Amplifier_Operational,
    Comparator, Isolator, Interface_UART, Connector, power). Without it,
    kicad-cli sch erc reports every stock symbol as an unresolved
    library on a fresh headless install. Veri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
2026-08-13 feat(hw): mule schematic — 17-line event path, both shift directions, optos
    Generated hardware/mule/mule.kicad_sch via a new Python generator
    (hardware/gen/), scaling up the label-per-pin technique from the F3
    probe: extract each symbol from KiCad's stock libraries, place
    instances on a grid, connect purely by matching global-label text so
    no wire routing has to be computed.
    Captures all four brief steps: the 17-line inbound path (task PC to
    Pi) through SN74LVC541APW on +3V3 with 100R series + BAV99 clamp per
    line, the outbound BARCODE path through SN74HCT541PW on +5V, four
    isolated channels through a PC847 quad optocoupler powered by a
    TMA-0505S isolated DC-DC, and the +5V-in/+3V3 power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
    [mule.kicad_sch]
2026-08-13 docs: correct plan defects found during execution
    The '541 is an octal buffer, so a package carries 8 channels rather than
    the 20 its pin count suggests. Task 2 needed three, not two, and Task 8's
    19 inbound channels need three as well.
    Also folds in three rulings the mule's implementation forced: the clamp
    must be wired as the series pair it is so it protects both rails rather
    than only the low side; the isolated supply must actually produce 5 V;
    and the optocoupler must be logic-output, since the mule exists to
    measure edge quality and a phototransistor's edges do not transfer to a
    board that will not use one.
    Task 8 gains the 5 V buffered copy the NI optocouplers consume, which
    the plan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
2026-08-13 docs: mule layout is human-led, matching main-board layout
    kicad-cli has no Specctra DSN export, so there is no headless autorouter
    round-trip and tracks cannot be generated from the command line. Task 3
    was marked [agent] while Task 14 was marked [human-led] for exactly the
    same reason. Placement stays with the agent; routing does not.
2026-08-13 fix(hw): bidirectional clamp, logic-output optos, real Pi GPIO map
    Coordinator fix round 1 on the mule schematic (hardware/gen/gen_mule.py):
    - Input clamp is now genuinely bidirectional. BAV99 (previous choice) is
    common-anode and cannot clamp one signal to two rails with both diodes
    doing correct-direction work; switched to Diode:BAT54S, whose pin 3
    ("COM") is a real series midpoint, wired signal->COM, DGND->anode,
    +3V3->cathode. Flags a residual concern for bring-up: the lower
    Schottky forward drop means the high-side diode now conducts on every
    normal 5V logic-high, not just a fault, sinking current into +3V3.
    - Optocoupler is now logic (open-collector) output, not phototran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
    [mule.kicad_sch]
2026-08-13 docs: clamp the 5 V inbound lines to +5V, never to +3V3
    My own correction in ab732bf was wrong. The '541 is an LVC part because
    its inputs tolerate 5.5 V independent of supply, which is what lets a 5 V
    DAQ drive a 3.3 V-powered buffer safely. A clamp diode to +3V3 destroys
    that property: every normal logic high sinks ~13.5 mA, over half the DAQ
    pin's rating, and ~230 mA across 17 lines into a rail that cannot sink
    it. That is a permanent conduction path on every emitted code, not a
    fault-only clamp.
    Caught by the Task 2 implementer after applying the bad instruction.
2026-08-13 fix(hw): clamp high side to +5V, not +3V3 -- coordinator caught own error
    Fix round 2: the coordinator's own fix round 1 instruction to clamp the
    inbound lines' high side to +3V3 was electrically wrong, and the
    concern flagged in that round's report turned out to be the actual
    bug, not a minor residual. SN74LVC541A is chosen specifically because
    its inputs tolerate 5.5V independent of its own 3.3V supply -- a clamp
    diode to +3V3 defeats exactly that property, permanently, since the
    task PC's normal 5V logic-high sits ~1.7V above +3V3+Vf. That is not a
    fault-only clamp, it is a continuous conduction path (~13.5mA/line,
    ~230mA worst case across 17 lines) into a 3.3V rail with no way to
    sink it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
    [mule.kicad_sch]
2026-08-13 fix(hw): opto bypass caps, matched LED drive, all-8 grounds, permutation-proof checker
    Fix round 3: task review came back spec-fail with one critical and four
    important findings, all real.
    CRITICAL -- no 0.1uF bypass on U5/U6 (HCPL-4661) or U7 (TMA-0505S).
    Brief Step 4 asked for 100nF per IC; only U1-U4 got one. Added 100nF
    between VCC/GND on both HCPL-4661 packages (within ~7mm per its
    datasheet, noted for Task 3 layout), and on both the input and output
    sides of the isolated DC-DC. Without it, an open-collector logic
    optocoupler is prone to output chatter on transitions -- directly
    compromising the propagation-delay/edge-quality measurement this board
    exists to take (bring-up checks 5-6),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
    [mule.kicad_sch]
2026-08-14 feat(hw): mule layout, DRC clean, fab outputs
    Adds hardware/gen/kicad_pcb.py (a .kicad_pcb generator mirroring kicad_sch.py's
    technique: real footprints extracted from KiCad's stock .pretty libraries, placed
    rigidly, nets assigned per pad straight from the schematic's own exported netlist)
    and hardware/gen/gen_mule_pcb.py, which uses it to place all 72 mule components
    per hardware/mule/floorplan.md: task-PC and Pi IDC-40 headers on opposite edges,
    a single straight >=2.5mm isolation slot with the two HCPL-4661s and the isolated
    DC-DC straddling it by design, everything else grouped by electrical domain either
    side. `kicad-cli` has no netlist-import or Specctra-DSN subcommand, so there is no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
    [mule-B_Courtyard.gbr, mule-B_Cu.gbl, mule-B_Fab.gbr, mule-B_Mask.gbs, mule-B_Paste.gbp, mule-B_Silkscreen.gbo, mule-Edge_Cuts.gm1, mule-F_Courtyard.gbr]
2026-08-14 fix(hw): opto bypass caps within 7mm on both legs, rotation-correct instances
    gen_mule_pcb.py's placement comment put U5's GND pin (pad 5) at (27.62, 70.12);
    at rot=270 it lands at (12.38, 70.12), mirrored about the package. Both bypass
    caps were placed at the midpoint of the VCC pin and that wrong coordinate, so
    the copper was wrong, not just the comment: measured out of the committed board
    file, each cap sat 3.85mm from VCC and 12.43mm from GND, against the HCPL-4661
    datasheet's ~7mm, on the one board built to measure this optocoupler's edges.
    Fixed at the source. kicad_pcb.py now derives placed geometry from the library
    footprint itself -- place_point()/local_point() (transform verified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
    [mule-B_Courtyard.gbr, mule-B_Cu.gbl, mule-B_Fab.gbr, mule-B_Mask.gbs, mule-B_Paste.gbp, mule-B_Silkscreen.gbo, mule-Edge_Cuts.gm1, mule-F_Courtyard.gbr]
2026-08-14 docs: NI card selection, connector split, +5V budget, mic anti-alias
    Verified against NI's own documentation rather than left as open items.
    Closes spec open item 3: connector 0 carries AI 0-15 + P0.0-7 + P1,
    connector 1 carries AI 16-31 + P0.8-31 + P2. All analog fits on one
    cable and all digital on the other, which is the clean split the design
    wanted. Event-code bits therefore land on P0.8-P0.23, not P0.0-P0.15.
    Closes spec open item 1: +5 V is 250 mA per connector. That is feasible
    for the NI optocoupler domain only with 10k pull-ups, not the 1k the
    mule uses -- 0.5 us into 50 pF against a 500 us strobe, so the slower
    edge costs nothing here.
    Drops both cards a tier to PXIe-6353 and P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
2026-08-14 docs: NVMe storage for the sync box, and enclosure thermals
    The Pi boots and logs to an NVMe SSD on a PCIe-FPC-only adapter. The
    constraint follows from the GPIO map rather than from preference: a
    conforming HAT or HAT+ carries its ID EEPROM on ID_SD/ID_SC, which are
    GPIO0 and GPIO1 and carry event-code bits 0 and 1. Mechanically the
    header is already taken by the ribbon to this board.
    Throughput is not the reason -- roughly 40 KB/s, about 1 GB per eight-
    hour session, which any SD card handles. Reliability is: SD cards fail
    abruptly and on power loss, and the Pi is the sole recorder on training
    days, so its storage failing loses a session rather than degrading one.
    Boot from the NVMe, sinc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
2026-08-14 feat(hw): breakout symbols, footprints, sheet hierarchy
    Adds the six custom symbols (hardware/lib/wl-sync.kicad_sym) Task 6 needs and no
    KiCad stock library has: 68-pin MDR male, mini-XLR TA4M/TA5M, 4-pin mini-DIN, the
    mating DB37 for the ACCES I/O USB-AO16-8A analog source, and the Raspberry Pi 5
    40-pin GPIO header (pins named by GPIO number, not header position, per the brief).
    Four new footprints (MDR68, mini-XLR x2, mini-DIN) back the parts with no stock
    mechanical equivalent; the Pi header and DB37 symbols reuse real stock footprints
    instead of duplicating them. Every symbol is proven to resolve correctly (constraint
    1: a bare-keyed lib_symbols entry loads without error but silently col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
    [breakout.kicad_sch]
2026-08-14 docs: CM5 Lite on the official IO board, conditional on floorplan
    Swaps the sync-box module from a Pi 5 to a CM5 Lite on the official CM5
    IO Board. The deciding factor is the board's onboard M.2 socket, which
    removes the PCIe flex cable -- a ribbon carrying the boot device inside
    a chassis that gets slid in and out of a rack for a decade is a
    mechanical failure mode worth designing out.
    Records a correction that produced a wrong conclusion earlier: the ID
    EEPROM lives on the HAT, not the host. ID_SD/ID_SC are how a host reads
    a HAT that brings its own. An M.2 HAT+ is disqualified because it is a
    HAT; a CM5 IO Board is the host, so GPIO0/1 are as free there as on a
    Pi 5.
    The decision is con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
2026-08-14 docs: TB4M/TB5M, not TA4M -- and order sample connectors early
    TA4M is obsolete and cable-mount only; the panel-mount part is TB4M.
    Confirmed against DigiKey, Switchcraft and Farnell. Ordering to the
    original naming would have bought a connector that cannot be
    panel-mounted, for the connectors whose cutouts are machined to match.
    Adds a Task 0 step to buy one physical sample of each custom-footprint
    connector alongside the stock check. Four footprints are drawn from
    secondary sources rather than manufacturer CAD, and two dimensions could
    not be closed from any retrievable document: MDR68 row and mounting-hole
    spacing, and the mini-XLR panel-cutout diameter.
    The sharper risk is topology rat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
2026-08-14 docs(hw): move TA4M/TB4M sourcing into README, fix stale MDR68 citation
    Two review findings on Task 6. First: MDR68_Male_RightAngle.kicad_mod,
    both mini-XLR footprints, MiniDIN_4_Panel.kicad_mod, and both mini-XLR
    symbol Descriptions pointed at hardware/README.md for the TA4M-vs-TB4M
    rationale and per-dimension sourcing/confidence -- content that only
    ever lived in gen_wl_sync_footprints.py's docstring and in a gitignored
    report file that doesn't survive. Adds a real "Custom connector
    footprints" section to hardware/README.md: TA4M is obsolete and
    cable-mount only (confirmed against DigiKey, Switchcraft, Farnell) so
    the footprint models TB4M/TB5M while the symbol keeps the spec's TA4M/
    TA5M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
    [gen_wl_sync_footprints.py, gen_wl_sync_lib.py]
2026-08-14 docs: sync-box module is CM5004000 -- Lite, 4GB, no wireless
    No wireless is the choice with a technical argument behind it. A live
    2.4/5 GHz transceiver powered inside a sealed enclosure beside 33 analog
    stages, a microphone preamp and headstage cables recording microvolts
    contradicts the reasoning used everywhere else here: digital isolators
    were rejected for modulating an RF carrier, and on-board switchers were
    rejected for consistency with that. Ethernet already covers NAS
    transfer, so nothing is traded away, and the non-wireless SKU is cheaper.
    Records the ordering trap: the digit after CM5 is the wireless flag, and
    resellers stock the wireless variants by default, so the easy order is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
2026-08-14 docs: all rig-facing sensors are BNC; Faraday cage grounding
    The rig is inside a Faraday cage sound booth. Sensors inside are battery
    powered precisely so no mains conductor crosses the cage wall, and only
    signals pass through the bulkhead. Nothing needs power from this board,
    so nothing needs more than a coax.
    This deletes the mini-XLR TB4M/TB5M footprints entirely -- the two whose
    contact arrangement was the largest known fab risk, where no primary
    drawing was retrievable and an error scraps a machined panel. The
    sample-and-measure step drops to MDR68 and the mini-DIN.
    Adds Sec.5.6. The shield cannot be lifted at this end because it is the
    signal return, so flexibility about bulkhead bon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
2026-08-14 docs: Task 10 front ends receive differentially, not as buffers
    The Faraday cage discussion invalidated the plan's front-end topology.
    Every source now senses against its own return rather than against AGND,
    because it is undecided whether the cage bulkhead bonds each shield to
    the shell -- and if it does, circulating current flows in the conductor
    that is also the signal return, which a plain AGND-referenced buffer
    would add straight to the signal.
    The shield cannot be lifted instead; it is the return path. So the
    flexibility has to live in the receiver, which is what lets the bulkhead
    decision be deferred or reversed without touching the board.
    The ACCESIO eye channels get the same treat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
2026-08-14 docs(hw): make sync-box module wording hardware-neutral
    hardware/README.md named the sync-box module "the Raspberry Pi 5 sync box", but
    that module's choice between a Pi 5 and a Compute Module 5 (Lite) on the official
    CM5 IO Board is a floorplan/placement decision this repo's sources don't lock in
    yet, not an electrical one -- both carry the same BCM2712/RP1, so the GPIO map and
    pinout are identical either way. Rewords to "the sync-box module" instead of
    swapping one product name for another.
2026-08-14 feat(hw): power sheet — linear rails, one isolated supply, AGND/DGND star
    hardware/breakout/sheets/power.kicad_sch (via hardware/gen/gen_breakout_power.py):
    the nine contract nets every other breakout sheet consumes.
    - Inlet: 4-pin mini-DIN, one SS14 Schottky per +-12V rail (mirrored orientation --
    see _place_inlet()'s docstring for the derivation), 10uF+100nF bulk per rail,
    AGND/DGND joined at exactly one NetTie_2.
    - Logic rails, linear only: TPS7A4901 (+12V->+5V) then LD1117S33TR_SOT223
    (+5V->+3V3), both DGND-referenced.
    - The one isolated supply: IH1215D (XP Power, stock Converter_DCDC_Isolated
    library) -- the real 2W part at this input/output combination; the 1W-class
    altern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
    [power.kicad_sch]
2026-08-14 docs: +5 V comes from the external supply, not from +12 V
    The +5 V rail feeds 28 optocoupler LEDs, of which about 26 can conduct
    at once -- all 16 data bits high plus strobe, barcode, both reward
    lines, stim trigger and the five Intan-bound copies. That is ~180 mA at
    the HCPL-4661 family's recommended minimum drive and ~260 mA at the
    10 mA the mule uses. The specified TPS7A4901 caps at 150 mA.
    Deriving it linearly from +12 V would dissipate ~1.9 W inside a sealed
    chassis already carrying 10-15 W from the sync-box module, beside analog
    stages with temperature-dependent offset drift. A switching regulator is
    unavailable by construction: this design rejected digital isolators for
    modulating an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
2026-08-14 fix(hw): +5V direct from inlet not +12V regulator, real instance-path ancestry
    Coordinator review, fix round 1. Two findings against the power sheet.
    Finding 1 -- the +5V rail was undersized by roughly a factor of two. Worst
    case ~26 simultaneous optocoupler LEDs draw ~180-260mA against TPS7A4901's
    150mA cap, before counting the 74HCT541 buffers on the same rail. A bigger
    linear regulator dissipates ~1.9W in a sealed 2U chassis already carrying
    10-15W; a switcher would contradict this design's own switcher-count-of-one
    decision. Fix: +5V now comes directly off a fifth inlet pin instead of being
    regulated down from +12V on board.
    - Inlet widened 4-pin -> 5-pin mini-DIN (new MiniDIN_5 symb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
    [power.kicad_sch]
2026-08-14 docs: 5-pin inlet, and the mini-DIN topology risk is now confirmed
    The inlet went to 5 pins when +5 V moved to the external supply.
    Task 7 sourced the new footprint from the manufacturer's real datasheet
    and found its contacts are clustered in an arc rather than evenly spaced
    around a full circle -- the exact failure mode flagged earlier as
    hypothetical, now visually confirmed. That means the older
    MiniDIN_4_Panel footprint, drawn on the even-spacing assumption, is
    presumed wrong. It is unused after this change, but a wrong footprint
    left in a library is a trap for a later task.
    Also records that MD-40SN and MD-50SN are both discontinued, so a
    current equivalent must be sourced before layo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
2026-08-14 fix(hw): replace mini-DIN power inlet with keyed, locking M12 connector
    Coordinator review, fix round 2. The power sheet's electrical design passed
    review clean; this finding is about one connector's footprint.
    build_minidin() drew both MiniDIN_4_Panel and MiniDIN_5_Panel on an evenly
    spaced ring. The reviewer pulled Same Sky's own MD-SN datasheet and
    confirmed the per-pin-count diagrams for both MD-40SN and MD-50SN show a
    clustered layout instead -- a topology error, not a tolerance one, that as
    fabbed would very likely have failed to mate. Redrawing against MD-SN
    wasn't an option regardless: both parts are discontinued (rev 1.06/1.07,
    2022/2023, verified against the manufacturer PDF).
    Re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
    [power.kicad_sch]
2026-08-14 fix(hw): correct M12 inlet stock claim -- DigiKey confirmed, not Mouser
    Self-caught while finalizing the task-7-report.md write-up for the
    previous commit (b264569): that commit's own message and the descr/
    Description text it wrote into wl-sync.kicad_sym and M12A_5_Panel.kicad_mod
    claimed "1,081 units in stock at Mouser" for M12A-05PFFP-SF8001, checked
    "directly against each distributor's own product page."
    That number is real but belongs to M12A-05PMMP-SF8001, the male sibling
    SKU -- Mouser's own page for the female part actually specified could not
    be fetched directly in this environment (repeated timeouts on every
    attempt). Re-reading my own sourcing before finalizing the report caught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
    [power.kicad_sch]
2026-08-14 docs: inlet is an M12 A-coded 5-position, not a mini-DIN
    Task 7 confirmed from the manufacturer's own datasheet that mini-DIN
    contacts are clustered rather than evenly spaced, so both footprints
    drawn on the even-spacing assumption would very likely have failed to
    mate. The part was discontinued as well, so redrawing its geometry would
    have been precision spent on something nobody can buy.
    Re-selected instead: M12A-05PFFP-SF8001, A-coded and screw-locking, with
    contact geometry taken from IEC 61076-2-101 rather than inferred.
    Keying makes a rotated insertion physically impossible on a connector
    feeding plus and minus 12 V into analog circuitry, and the screw lock
    suits a chassis that gets s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
2026-08-14 feat(hw): task PC digital sheet -- 19 in, 4 out, reward OR
    Task 8 (task-8-brief.md): both task-PC MDR68 connectors (Connector 1
    fully wired with the 23 digital lines P0.8-P0.30 per spec Sec.9.2's
    confirmed split; Connector 0 placed but left unpopulated for Task 10's
    analog channels), the 19-channel inbound path (100R + BAT54S clamp per
    channel, high side +5V never +3V3 -- exactly as validated on the mule --
    fanned out in parallel to a 3.3V SN74LVC541APW bank and a 5V
    SN74HCT541PW _BUF bank for Task 11's optocouplers), the 4-channel
    outbound path, and the reward OR (74HCT32 + a debounced 74HCT14 Schmitt
    pair for the manual button, RWD_CMD/RWD_BTN -> RWD_DLVR).
    Two supporting fixes to shared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
    [taskpc-digital.kicad_sch]
2026-08-14 docs: single Schmitt inverter on the reward button, not a pair
    My plan text said 'inverter pair'. With a pull-up and the button to
    ground, two inversions restore the polarity, so the debounced button
    idles HIGH -- and HIGH OR anything is HIGH. RWD_DLVR would have been
    asserted continuously: reward driver permanently open, animal receiving
    continuous reward, and the delivered line stuck true in every recording.
    One inverter gives idle-low active-high, matching an active-high
    RWD_CMD into the OR. The assumed polarity now has to be stated on the
    sheet rather than inherited silently.
    Caught by the Task 8 implementer as a disclosed concern rather than
    found in review.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
2026-08-14 fix(hw): reward-OR polarity, sourced MDR68/connector-0 pinouts
    Task 8 fix round 1 -- three findings from review, all this task's own
    disclosed concerns the review was right to raise.
    Finding 1 (CRITICAL): the reward-OR debounce stage placed a 74HCT14
    Schmitt PAIR, exactly as task-8-brief.md's own (wrong) literal text
    specified. Two series inversions cancel, so the debounced button idled
    HIGH into an OR gate against an active-HIGH RWD_CMD -- RWD_DLVR would
    have asserted continuously (reward driver stuck open, "delivered"
    stuck true in every recording). Fixed to a single Schmitt inversion
    (place_debounce_inverter(), was place_debounce_inverters()):
    idle-LOW/active-HIGH, matching what an OR co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
    [taskpc-digital.kicad_sch]
2026-08-14 docs: cite the 6343's own pinout figure, not the 6363's
    The task PC carries a PCIe-6343 per spec 9.3, but Task 8's step still
    pointed at the 6363 and at a spec open item that has since closed. The
    implementer correctly used the 6343's own Figure A-5, and a reviewer
    confirmed both figures are pin-identical on every signal this design
    uses -- so no material effect, but cite the part actually fitted.
2026-08-14 feat(hw): sync-module interface sheet -- GPIO map, boot resistors, RWD_DLVR level shift
    Task 9: hardware/breakout/sheets/pi-interface.kicad_sch. Places the 40-pin
    sync-module GPIO header (Raspberry Pi 5 / CM5 IO Board -- module choice is a
    floorplan decision, not electrical) and wires all 28 GPIO pins to spec Sec.4's
    own map (restated verbatim as an on-sheet text block), leaving the header's own
    3V3/5V pins no-connect (the module has its own independent USB-C PD supply,
    spec Sec.8) and its 8 GND pins tied to DGND. GPIO0/1 each get a 330R
    boot-contention series resistor. Buffers the three module-sourced outputs
    (BARCODE_PI, CAM_TRIG_EYE, CAM_TRIG_BEH) through one SN74HCT541PW on +5V, fanned
    t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
    [pi-interface.kicad_sch]
2026-08-14 docs: comparator pull-ups go to +3V3, never +5V
    Task 9's implementer caught that RWD_DLVR leaves the reward OR at +5 V
    and lands on a GPIO that is 3.3 V and not 5 V tolerant, and added a
    level shift. Auditing the rest of the module-bound signals, the same
    hazard sits unbuilt in Task 10: PD1_COMP, PD2_COMP and ACC_TRIG all
    reach GPIO, and the plan said only '10 kilohm pull-ups' without naming
    a rail.
    Pulled to +3V3 the module path is safe by construction and the task-PC
    path still works, because Task 8's outbound HCT541 runs at +5 V and HCT
    reads 3.3 V as a valid high -- the up-shift happens in a buffer that
    already exists.
    This is the hazard the whole design is organised around, and it sli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
2026-08-14 feat(hw): analog front-end sheet -- 16 sources received differentially
    Task 10a: hardware/breakout/sheets/analog-frontend.kicad_sch. Every one of the
    16 analog sources (6 ACCESIO eye channels + 10 isolated BNCs) gets isolated
    BNC/DB37 -> 1k series -> BAT54S clamp to +-12V -> a difference-receiving input
    stage, never a plain AGND-referenced buffer -- spec Sec.5.6's Faraday-cage
    shield-disturbance rationale. 13 channels use INA105KU (a real, current,
    hand-solderable unity-gain difference amplifier filling the brief's own
    "INA134-class" role, since INA134 itself has no stock KiCad symbol); the 2
    photodiodes get a transimpedance stage (OPA2197xD dual, Rf=1M/Cf=3.3pF sized
    for 6m coax) with its o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
    [analog-frontend.kicad_sch]
2026-08-14 docs: BAT54S not BAV99, in the two places still stale
    Task 2 established that KiCad's BAV99 symbol is common-anode and cannot
    form the bidirectional series clamp this design needs, and switched the
    project to BAT54S. Task 8's section was updated then; Task 10's was not.
    Every implementer since has used BAT54S correctly, so this is stale
    guidance rather than a defect -- but a plan that names the wrong part is
    a trap for the next reader.
2026-08-15 fix(hw): symmetric /1//2 divider on MISC1-3's shield leg
    The MISC1-3 divider attenuated only the signal leg into INA105 "+",
    leaving the shield leg (into "-") undivided. /1 mode cancelled the
    shield disturbance correctly, but /2 mode output Vsig/2 - Vshield/2:
    half the shield disturbance leaked through uncancelled, since a
    difference amplifier only rejects common mode when both legs see the
    same gain.
    Mirrors the divider onto the shield leg (new _atten_leg() helper, same
    matched 10.0k 0.1% resistors, same 3-pin jumper topology) so /2 mode
    now divides both legs equally and Vshield cancels in both jumper
    positions. Keeps the original before-the-amplifier placement and CMR
    reasoning -- the "-"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
    [analog-frontend.kicad_sch]
2026-08-15 feat(hw): analog-to-NI fan-out sheet -- 16 channels buffered to recording NI, 9 to task PC
    Task 10b: analog-ni.kicad_sch fans out all 16 A_* sources from analog-frontend.kicad_sch
    through independent OPA4192-value unity-gain buffers (no stock OPA4192 symbol exists;
    Amplifier_Operational:OPA4197xD placed with Value overridden, same '541-family
    Value-substitution precedent analog-frontend.kicad_sch's own INA134->INA105 already uses)
    + 100R series each:
    - All 16, to a new 68-pin MDR (this sheet's own Connector 0, physically distinct from the
    task PC's Connector 0 on taskpc-digital.kicad_sch) -- physical AI0-AI15 pins sourced from
    NI's X Series User Manual (370784K-01), Figure A-5, the same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
    [analog-ni.kicad_sch]
2026-08-15 fix(hw): gang MISC1-3's /1//2 jumpers onto one physically-inseparable header
    analog-frontend.kicad_sch (Task 10a fix round 1) gave each of MISC1-3's signal and shield
    legs its own independent Conn_01x03 shunt header, both required to be set to the same
    position but with nothing stopping them from disagreeing -- a field-reconfiguration risk
    a reviewer flagged: years from now, someone changes a channel's range and forgets the
    second jumper, silently re-creating the exact half-cancelled-shield-disturbance defect
    fix round 1 closed out (the two-headers version left this as an explicitly-named residual
    risk in its own docstring, judged at the time as "more component-library risk than this
    fix war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
    [analog-frontend.kicad_sch]
2026-08-15 fix(hw): correct MISC1-3 jumper pin map to match its real footprint geometry
    665f211 ganged MISC1-3's /1//2 attenuator jumper onto one Conn_02x03_Top_Bottom header,
    row 1 (pins 1-3) = signal leg, row 2 (pins 4-6) = shield leg, reasoning -- confirmed
    "directly against the raw Connector_Generic library text" -- that pin N and pin N+3 share
    a physical column. That confirmation checked the SCHEMATIC SYMBOL's own drawn geometry,
    not the FOOTPRINT (PinHeader_2x03_P2.54mm_Vertical) actually assigned via footprint=, and
    nothing in this toolchain cross-checks the two: kicad_sch.py's extract_symbol()/
    unit_pins() reads only the .kicad_sym, never the .kicad_mod a symbol is paired with.
    Rendered the re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
    [analog-frontend.kicad_sch]
2026-08-15 feat(hw): mux-intan sheet -- 8x ADG1206 mux bank + INA105 isolated diff-amps
    Task 10c (plan.md Task 10 Step 4). Eight ADG1206YRUZ 16:1 muxes -- all 16
    A_* sources (Task 10a) on every mux's own S1-S16 inputs, EN tied to +12V,
    32 address nets (MUX1_A0..MUX8_A3) exposed for Task 12's own I2C GPIO
    expanders -- feed eight INA105KU difference amplifiers ("+"=mux output,
    "-"=AGND, REF=INTAN_GND, powered ISO_P12/ISO_N12) through 100R series
    resistors to eight panel BNCs, INTAN_AO1..INTAN_AO8. The amplifier is
    wired exactly like a 10a front end one domain further out: it rejects
    the AGND-to-INTAN_GND ground offset the same way 10a's own receivers
    reject a sensor's shield-to-AGND offset, and is the on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
    [mux-intan.kicad_sch]
2026-08-15 fix(hw): replace ADG1206 A3 two-pin hedge with the real datasheet table
    8fcba63 could not independently confirm the ADG1206YRUZ's physical pin for A3 on
    the real 28-lead TSSOP (pin 13 vs. 14, 12+ fetch attempts, mostly blocked/timed
    out) and, rather than guess silently, wired BOTH candidate pins to the same
    MUX{n}_A3 net as a hedge. That was not a safe hedge: two different physical pins
    tied to one net is a short between whatever those pins actually are, and would
    have been a real fault, not a redundancy, had pin 13 turned out to be a supply or
    a source pin instead of NC.
    Replaced gen_wl_sync_lib.py's ADG1206_PINS with Table 4 of Analog Devices' own
    ADG1206/ADG1207 Rev.0 datasheet, transcri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
    [mux-intan.kicad_sch]
2026-08-15 feat(hw): comparators sheet -- LM339 quad comparator, MCP4728 I2C threshold DAC
    One LM339 quad comparator (A_PD1->PD1_COMP, A_PD2->PD2_COMP, A_ACC->ACC_TRIG;
    fourth channel brought out to A_MISC1, unpopulated -- a populate option, not
    a respin) with hysteresis (1M feedback plus a 10k series resistor this sheet
    adds so the hysteresis is functionally real against a low-impedance source,
    not just topologically present) and thresholds set by one MCP4728 quad I2C
    DAC (address 0x60, factory default, recorded in hardware/README.md for
    Task 12). Every pull-up goes to +3V3, never +5V -- the three outputs wire
    directly into the sync module's own 3.3V-only GPIO (confirmed by reading
    pi-interface.kicad_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
    [comparators.kicad_sch]
2026-08-15 fix(hw): retire taskpc-digital's stale PD1_COMP/PD2_COMP/ACC_TRIG PWR_FLAGs
    Task 8's own outbound buffer placed a PWR_FLAG on each of PD1_COMP/
    PD2_COMP/ACC_TRIG/RHS_STIM_OUT because nothing drove them yet, and its own
    docstring already instructed deleting each one "the moment their own real
    driving pin is wired to it" -- comparators.kicad_sch now does exactly that
    for the first three (an LM339 open_collector output on each), so their own
    flags are deleted here, exactly as instructed. Left in place, a PWR_FLAG on
    the same net as an open_collector driver trips ERC's pin_to_pin rule
    ("Pins of type Open collector and Power output are connected") -- confirmed
    empirically: 4 errors before this fi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
    [taskpc-digital.kicad_sch]
2026-08-15 docs(hw): regenerate erc.rpt for the comparators sheet
    0 errors, 55 warnings (54 pre-existing + 1 new, I2C_SDA, awaiting Task 12).
2026-08-15 docs: comparator hysteresis needs a series resistor, not just feedback
    The plan said 'hysteresis by 1 megohm feedback to the non-inverting
    input'. That produces essentially no hysteresis here, because Task 10a
    drives these comparators from a buffered near-zero-impedance output and
    positive feedback can only shift a threshold against a source
    impedance. The result would have been a comparator that chatters on
    exactly the slow noisy signals the design names as the reason hysteresis
    is mandatory.
    A ~10k series resistor between source and non-inverting input gives
    about 33 mV of hysteresis at ~1% gain error.
    Caught by the Task 10d implementer as a disclosed judgment call rather
    than silently o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
2026-08-15 docs: record the one hand-solderability exception, MCP4728 at 0.5 mm
    The quad I2C DAC setting the comparator thresholds is sold only in
    MSOP-10 at 0.5 mm pitch, finer than anything else on the board, where
    the previous worst case was 0.65 mm TSSOP. Microchip offers no other
    package, so this is unavoidable rather than chosen.
    Recorded so it can be planned for -- flux, fine tip, magnification --
    rather than met by surprise at the bench by someone who was told the
    whole board was hand-solderable.
2026-08-15 docs: optocoupler count is 30, not 28 -- stale by two channels
    Routing the two photodiode comparators to NI took the NI-bound digital
    count from 22 to 24. That propagated to section 3.1's line counts but
    not to section 7.3's optocoupler table, which still read 22/5/1 = 28 --
    stale by two channels and one whole package.
    Found while dispatching the sheet that builds them, which would have
    been built two channels short.
    Current budget still holds: 28 LEDs conducting worst case is ~176 mA at
    minimum drive and ~280 mA at 10 mA, against the 400 mA the rail was
    budgeted for.
2026-08-15 feat(hw): opto-ni sheet -- 24 isolated digital channels, NI Connector 1
    Six Broadcom ACSL-6400 (quad, all-in-one, logic-output, not phototransistor)
    optocouplers carry the barrier from DGND into the recording NI card's own
    digital domain: 16 event-data bits, strobe, barcode, RWD_CMD, RWD_DLVR,
    STIM_TRIG, RHS_STIM_OUT, PD1_COMP, PD2_COMP -- corrected from the plan's
    stale 22-channel figure now that the two photodiode-comparator channels
    reaching NI are accounted for. Also places the recording NI's own
    Connector 1 (digital), pins sourced from NI's X Series User Manual
    (370784K-01) Figure A-18 and independently cross-checked against Task 8's
    own Figure-A-5 table (byte-for-byte identical on ever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
    [opto-ni.kicad_sch]
2026-08-15 feat(hw): opto-intan sheet -- 6 isolated digital channels, ACSL-6420
    One Broadcom ACSL-6400 (4 outbound: strobe, barcode, RWD_CMD, RWD_DLVR)
    plus one ACSL-6420 (quad, bi-directional 2/2 -- NOT a second ACSL-6400)
    carry the barrier between DGND and INTAN_GND. The ACSL-6420 substitution
    is a correction this task's own pin-by-pin datasheet verification found:
    an all-in-one part's four channels share one VDD/GND on the output side,
    and this sheet's second package needs one outbound channel (STIM_TRIG)
    and one inbound channel (RHS_STIM_OUT) simultaneously -- opposite
    directions an all-in-one part cannot provide without putting a channel's
    output on the wrong side of the barrier. ACSL-6420's 2/2 s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
    [opto-intan.kicad_sch, taskpc-digital.kicad_sch]
2026-08-15 docs: NI pull-ups are 3.9k, not 10k -- the part has an RL maximum
    My earlier 10k ruling compared against the mule's 1k and never checked
    the optocoupler's own limit. The ACSL-6400 specifies a maximum load
    resistance of 4k; 10k exceeds it to save 19 mA on a rail that already
    fits comfortably at 3.9k (151-199 mA against a 250 mA budget).
    The edge cost is 0.2 us into 50 pF against a 500 us strobe, so speed was
    never the deciding variable in either direction.
    Caught by the Task 11 implementer as a disclosed concern.
2026-08-15 fix(hw): drop opto-ni's NI-side pull-ups to 3.9k, within ACSL-6400's own RL-max
    The original 10k pull-up (Task 11) was derived only by comparing against the
    mule board's 1k -- it never checked ACSL-6400's own datasheet pull-up maximum
    (RL-max = 4k, "Recommended Operating Conditions"), which it exceeded. 3.9k
    (E24) is the largest standard value at or under that limit: still comfortably
    inside NI's 250mA/connector budget (domain total 151-199mA, 51-99mA headroom,
    vs 10k's 132-180mA bought only by violating the part's own spec), and the
    edge-rate cost either way (tau ~0.2us at 3.9k vs ~0.5us at 10k, into ~50pF)
    was never close enough to the 500us strobe period to be the deciding factor.
    HIGH-le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
    [opto-ni.kicad_sch]
2026-08-15 test(hw): extend the row-pitch-vs-2-pin-span guard to opto-intan's checker
    Mirrors the general structural guard just added to
    check_breakout_opto_ni_netlist.py (same technique, duplicated not imported,
    per this project's own per-checker independence discipline) into
    check_breakout_opto_intan_netlist.py: no same-column real 2-pin part's own
    pin-to-pin reach may overlap another's, checked from real, rendered pin
    geometry rather than only after an actual duplicate label coordinate exists.
    Genuinely exercises the non-vertical-2-pin-part exclusion opto-ni's own
    version of this check already accounts for defensively but never hits:
    opto-intan's 6 BNC jacks (Connector:Conn_Coaxial) are real 2-pin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
2026-08-15 docs(hw): regenerate erc.rpt after the opto-ni pull-up fix
    Re-run against the fix-round-1 schematic (3.9k pull-ups, general row-pitch
    guard). Byte-identical to the prior committed report apart from the
    timestamp: 0 errors, 38 warnings, same isolated_pin_label set at the same
    coordinates -- confirms the fix changed nothing ERC-visible outside the
    pull-up value itself.
2026-08-15 fix(hw): drop opto-intan's pull-ups to 3.9k, within ACSL-6400/6420's own RL-max
    Same datasheet violation fix round 1 corrected on opto-ni.kicad_sch (RL-max =
    4k, Broadcom AV02-0235EN's own "Recommended Operating Conditions"), found
    here independently rather than inferred from that sibling sheet: the
    datasheet is ONE table covering the whole ACSL-6xx0 family (ACSL-6210
    through ACSL-6420) with no per-device split, and the output stage RL-max
    characterizes is schematically identical across every family member and
    channel -- so the 4k ceiling binds ACSL-6420's own VO1-VO4 pins exactly as
    it binds ACSL-6400's, on both this sheet's own packages. 3.9k (E24) is the
    largest standard value at or under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
    [opto-intan.kicad_sch]
2026-08-15 test(hw): back-port the row-pitch-vs-2-pin-span guard to three more checkers
    check_breakout_analog_ni_netlist.py, check_breakout_comparators_netlist.py,
    and check_breakout_mux_intan_netlist.py carried only the older exact-
    duplicate-coordinate scan, which cannot see a two-pin part's own pin span
    landing on an integer multiple of a shared column's row pitch -- the defect
    class fix round 1 found and fixed on opto-ni.kicad_sch (CH_ROW_DY's own
    account: a Device:R's 7.62mm span landing exactly 3x the ACSL package's
    2.54mm row pitch away, silently merging NI_5V into a channel's data net,
    caught by ERC only by luck of the specific values). This has now recurred
    three times on this project in diffe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
    [check_breakout_analog_ni_netlist.py, check_breakout_comparators_netlist.py, check_breakout_mux_intan_netlist.py, check_breakout_opto_intan_netlist.py, check_breakout_opto_ni_netlist.py, check_row_pitch_guard.py]
2026-08-15 feat(hw): control sheet -- MCP2221A USB-I2C bridge, two MCP23017 GPIO expanders
    control-usb-i2c.kicad_sch is the last schematic-capture sheet: an MCP2221A USB-I2C
    bridge on Task 9's own internal USB header, driving two MCP23017 16-bit GPIO expanders
    (32 outputs -> MUX1_A0..MUX8_A3, exact fit) and connecting to comparators.kicad_sch's
    already-placed MCP4728. Addresses 0x20/0x21/0x60, checked distinct. MCP2221A runs 3.3V
    self-powered (Microchip DS20005565B Sec.1.6.2.3) -- VDD/VUSB both on +3V3, not
    USB_VBUS_PI, so this new bus never mismatches the logic level every other 3.3V device on
    it already expects; USB_VBUS_PI is deliberately left unconnected, not omitted. Both
    parts' full pin tables ve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
    [comparators.kicad_sch, control-usb-i2c.kicad_sch]
2026-08-15 test(hw): whole-board netlist contract in the repo's own pytest suite
    tests/hardware/test_netlist.py -- deliberately outside hardware/, so pyproject.toml's
    own testpaths picks it up alongside the rest of the Python suite. Parses
    hardware/breakout/breakout.net directly with its own small, self-contained regexes
    (not imported from hardware/gen/check_mule_netlist.py: this is a whole-board contract
    one layer above any single sheet's own checker, and must keep working even if that
    checker infrastructure has a bug or isn't on sys.path).
    Reproduces the brief's own five checks (16 event-code lines to module/NI, strobe to
    module/NI/Intan; Intan's exact 8 analog outputs; all 16 sources to NI; reward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
    [test_netlist.py]
2026-08-15 fix(hw): make the whole-board netlist contract actually run in CI
    tests/hardware/test_netlist.py's 26 assertions previously skipped whenever
    hardware/breakout/breakout.net was absent, which is always true in CI (no kicad-cli
    installed, and *.net is gitignored by design) -- so the contract reported green while
    testing nothing, the exact "vacuous check" failure mode this project has hit before, only
    worse here because a skip reads as coverage.
    hardware/gen/gen_breakout_netlist_contract.py renders an exported netlist into a sorted,
    UUID-free hardware/breakout/netlist-contract.json (net -> [(ref, pin, pinfunction,
    pintype)] plus component values), committed to the repo unlike the raw .net it's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
    [gen_breakout_netlist_contract.py, test_netlist.py, test_netlist_contract_freshness.py]
2026-08-15 docs(hw): BOM lock and pre-layout design review
    Exports the breakout board BOM via kicad-cli and audits every line: confirms
    every Value-overridden symbol (OPA4192IDR-on-OPA4197xD, etc.) names the real
    ordered part, flags the MCP4728 MSOP-10/0.5mm exception, confirms no BGA/QFN
    and nothing below 0603, and checks current distributor stock/lead time for
    every active component and the schedule-risk connectors (recorded in the new
    hardware/procurement-check.md, folding in Task 0's original scope). Adds
    hardware/breakout/design-review.md, the pre-layout checklist a person signs
    off before Task 14 layout begins, cross-referencing which items the 26-
    assertion netlist contract and 11 structural che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
    [breakout-bom.csv]
2026-08-15 docs(hw): task 13 fix round 1 -- order codes, panel item, supply corrections
    Closes two Important audit findings and corrects three supply findings a
    reviewer overturned. No schematic, generator, or checker touched -- this
    task audits, it does not redesign.
    - Add hardware/breakout/breakout-bom-order.csv: the same 101 rows as the
    raw kicad-cli export, plus a corrected/orderable part-number column
    (INA105KU/2K5, SN74HCT14DR, ADG1206YRUZ-REEL7, etc.) so a purchase order
    is no longer cut from obsolete/bare codes in the raw BOM. The raw export
    itself is untouched and still reproduces byte-identically from the
    documented kicad-cli command. hardware/README.md now says which file to
    pur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
    [breakout-bom-order.csv]
2026-08-15 fix(hw): run the LM339 from +12V and AGND, never -12V
    LM339 pin 12 is labelled "V-"/negative supply, but it is also the common
    emitter of all four open-collector output transistors. Whatever pin 12
    sits on IS this sheet's output LOW level. On -12V an output LOW is
    V- + V_CEsat ~ -11.9V, not 0V, and it genuinely settles there: a 10k
    pull-up to +3V3 sources ~0.33mA against a ~16mA sink, so the transistor
    stays hard in saturation.
    PD1_COMP, PD2_COMP, ACC_TRIG and A_MISC1_COMP carried that level with no
    series resistance and no clamp anywhere on the path:
    - J7 pins 38/40/22 (GPIO20/21/25), pad absolute minimum -0.5V. -11.9V
    forward-biases the module's substrate diode at ~1.5mA continuous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
    [comparators.kicad_sch]
2026-08-15 fix(hw): one optocoupler LED per driver pin
    The _BUF bank names 19 signals for what is really a 30-LED board. The 11
    unnamed LEDs got doubled onto pins that already had one, and put +5V on
    two sync-module GPIOs.
    (a) Doubled loads. Each ACSL-6400/6420 LED draws ~7.33mA from +5V through
    430R -- a value pinned between the part's 7-15mA recommended band and its
    7.0mA worst-case switching threshold, so it cannot be lowered to suit a
    driver. EVT_STROBE_BUF, RWD_CMD_BUF and STIM_TRIG_BUF each fed an NI LED
    and an Intan LED from one HCT541 output (14.7mA vs 6mA IOL); BARCODE_PI
    did the same off the pi-interface trigger buffer; and bare RWD_DLVR fed
    both of its optocouplers straight off the 74HCT32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
    [opto-intan.kicad_sch, opto-ni.kicad_sch, pi-interface.kicad_sch, taskpc-digital.kicad_sch]
2026-08-15 test(hw): close the two-hop verification blind spot
    Every verification gap found on this branch has the same shape:
    connectivity checking asks one-hop questions about nets; the hazards that
    got through are two-hop questions about paths.
    _check_no_5v_on_sync_module_gpio matches only a literal +5V node on a
    GPIO pin; _check_comparator_pullups_on_3v3_never_5v sees only resistor
    bridges. Neither can see +5V -> 430R -> LED -> GPIO. And nothing anywhere
    examined a driver's negative rail, or summed a net's total sink load
    across sheets.
    Two assertions, both written over the whole snapshot rather than an
    enumerated list of interesting nets -- the defects they catch all arrived
    as a LATER sheet addi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
2026-08-15 docs(hw): correct the sample-buy list, DNP count, pull-up value and spec open items
    hardware/README.md, custom-connector section: it still called the mini-XLR
    contact arrangement "the most urgent open item" and put TB4M/TB5M first in
    the sample-buy list. Mini-XLR was removed from the design entirely on
    2026-08-13 (spec 9.1 -- the rig is inside a Faraday cage sound booth, every
    sensor in it is battery powered, so nothing needs more than a coax). The
    netlist confirms it: MDR68_Male_RightAngle and M12A_5_Panel are the only
    wl-sync footprints any sheet places. As written it would have sent someone
    to buy and caliper connectors this board does not use. The sample list is
    now the real one -- M12 p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
2026-08-15 docs: four 12 V fan headers, on a dedicated feed
    Section 9.4 recorded the thermal requirement and never specified the
    connectors to satisfy it -- the constraint got written down, the
    hardware to meet it did not.
    12 V rather than 5 V: an NF-A8-class 12 V fan draws ~0.06 A against
    ~0.1 A, so four is ~240 mA on a rail that already exists rather than
    ~400 mA on the +5 V rail already carrying the optocoupler load.
    Fan current gets its own power and return, star-connected at the inlet
    only. A brushless DC fan is a commutating switching load, and running
    240 mA of it through the analog ground would contradict rejecting
    digital isolators for an RF carrier and on-board switchers for
    consistency wit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
2026-08-15 docs: record two open items on comparator thresholds
    Item 10: the MCP4728 reaches 0-4.096 V at best, so a threshold above
    that is not settable. The comparator's input range is fine now that it
    runs from +12 V and AGND, but if the photodiode TIA or the accelerometer
    motion-energy output swings to +5 V, the top of the useful range is
    unreachable and the signal needs scaling at its front end. Coupled to
    item 5 -- the same accelerometer-range answer settles both.
    Item 11: nothing writes the DAC thresholds or mux addresses yet. The
    board supports both and the addresses are recorded, but the control
    layer is wl-sync's work and outside this plan. As built the board comes
    up with the DAC's power-on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
2026-08-15 fix(hw): protect comparator channel 4's live A_MISC1 input with a series R
    A_MISC1 is a live +-5V net (U28's INA105 output), permanently wired to
    U54 pin 9 regardless of this channel's own populate state, and also
    fanned out to U34/U36 and every ADG1206 mux's own S14. With V- = AGND
    (the prior round's own fix), A_MISC1's negative half sits outside the
    LM339's input range on every assembled board -- a bare wire from pin 9
    is a standing clamp at the input protection diode's forward drop, with
    fault current limited only by the INA105's own current limit, straight
    into the LM339's substrate. Channels 1-3 are protected by R111/R114/R117
    (10k series); channel 4 had no equivalent.
    R190 (10k, popul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
    [breakout-bom-order.csv, breakout-bom.csv, comparators.kicad_sch]
2026-08-15 fix(hw): swap SN74AHCT541PW in for SN74HCT541PW on U8-U11, U15
    Each of these five packages drives exactly one ACSL-6400/6420 LED at
    ~7.33mA, fixed by the LED's own 7.0mA worst-case switching threshold,
    not a driver choice. SN74HCT541PW is rated IOL=6mA: 7.33mA is 22% over
    the rated sink -- far inside the part's 25mA per-pin absolute maximum,
    but past its guaranteed-VOL condition, and the prior report's own
    "22% over, bounded" framing was self-inconsistent: it applied the
    datasheet VOL figure quoted at the rated 6mA to a 7.33mA load. Solved
    self-consistently against the part's own ~55 ohm output impedance (not
    the single 6mA test point), the real current is closer to 7.18mA --
    uncomfortably c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
    [breakout-bom-order.csv, breakout-bom.csv, pi-interface.kicad_sch, taskpc-digital.kicad_sch]
2026-08-15 test(hw): make the two-hop LED negative control actually test the two-hop path
    test_gpio_nets_reach_no_unsafe_rail_fires_on_led_two_hops_from_5v matched
    only "U61 pin 6" in the raised assertion. U61 (the whole ACSL-6400
    package) already has other pins on NI_5V -- its own VDD, unrelated to
    this test's fabricated cathode -- and NI_5V is unsafe too, so the
    zero-hop half of _reachable_rails (does this REF touch a rail anywhere)
    already produces a hazard for any U61 pin, independent of whether the
    two-hop bridge-through-a-passive logic this test exists to exercise
    ever runs. Proved by deleting that whole clause from _reachable_rails
    and running the file: all 34 tests, including this one, still pa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
2026-08-15 feat(hw): fan headers on the power sheet -- dedicated FAN_12V/FAN_RTN, polyfused
    Spec Sec.9.5 recorded the thermal requirement and the four 3-pin fan-header
    connectors it needed, but the schematic never actually placed them.
    Four Connector_Generic:Conn_01x03 headers at 2.54mm, standard PC fan pinout
    (pin 1 GND, pin 2 +12V, pin 3 tach). Tach is a deliberate no-connect --
    power-only was chosen because the sync module's GPIO is full at 26 of 28 --
    with an on-sheet note so the third pin doesn't get "tidied up" later.
    Fan current gets its own FAN_12V/FAN_RTN nets rather than riding AGND/DGND:
    a brushless DC fan is a commutating switching load, and running ~240mA of
    it through the analog ground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
    [power.kicad_sch]
2026-08-15 fix(hw): resync BOM CSVs for the fan headers commit missed
    e00e87c added J52-J55, F1, C147/C148 and NT2 to power.kicad_sch but never
    regenerated breakout-bom.csv/breakout-bom-order.csv, leaving the order file
    6 references (5 grouped rows) short of the schematic -- the same
    stale-order-file failure mode already fixed once on this branch.
    Re-ran the documented kicad-cli export verbatim (byte-identical output):
    101 -> 106 grouped rows. C147/C148 fold into the existing 10uF/100nF rows
    and NT2 folds into NT1's row (kicad-cli groups by Value), so only F1 and
    J52-J55 are genuinely new rows; #PWR9/#PWR10 emit no row at all (power
    flags carry no footprint). breakout-bom-order.csv updated to match,
    r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
    [breakout-bom-order.csv, breakout-bom.csv]
2026-08-15 docs: panel swap, diagonal airflow, five additions, reward one-shot
    The front/rear assignment was backwards -- Intan and the recording NI
    live on the rack front, so the sync box's connections to them belong on
    the same face, and the task PC and booth are reached from the back.
    Splitting the front's connectors into two rows frees a 170 x 82 mm
    full-height strip that makes the intake fans possible.
    60 mm fans, not 80: the constraint is height, not width. A 2U face has
    ~82 mm usable and an 80 mm fan needs ~85 mm of cutout, so it misses on
    any face in any arrangement.
    Two intake front-right, two exhaust left-side, air crossing diagonally
    -- which matters because the board is 430 mm wide and on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
2026-08-15 docs: close the accelerometer, threshold-range and reward-polarity items
    wl-shook section 3 settles item 5 precisely: 0-5.000 V single-ended on
    BNC, non-inverted, with a 0.250 V resting pedestal so 0 V means absent
    rather than still. Floating and battery-only, which is what the
    differential receive already assumes. Inside the board's own +-5 V
    convention, so the input stage is a unity buffer -- the board is correct
    as built, no scaling network and no respin.
    Item 10 resolves with it: a threshold at the DAC's 4.096 V ceiling sits
    at 81 percent of full-scale motion, and the floor must stay above the
    pedestal, while a real motion gate lives near 5-30 percent. The ceiling
    does not bind.
    Item 1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
2026-08-15 docs: split the reward group across both faces
    The hardware connection follows the animal -- driver output on the back,
    toward the booth. The human controls face the person operating the rig
    -- button and remote on the front, beside the recording equipment they
    are actually working with.
    Costs nothing electrically and puts each end where its user is. The back
    gets less crowded as a side effect, 504 mm across two rows rather than
    544. BNC count is unchanged at 31, redistributed 15 front / 16 back.
    Colour-coding matters more after this, not less: a lone reward remote
    among fourteen identical Intan BNCs is exactly the mis-plug coloured
    insulators exist to prevent. And the recessed button earn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
2026-08-15 docs: turnkey the first board, no spare cards, fixed-speed fans
    Assembly split decided: a house builds board one including the two
    accepted exceptions, and the rest are hand-built against it as a
    reference. The reasoning is diagnosis rather than difficulty -- many of
    this board's failure modes are invisible to inspection, and an assembly
    defect masquerading as a design defect at bring-up would be expensive to
    chase on the one board that has to work first.
    That makes breakout-bom-order.csv load-bearing rather than tidy: an
    assembler orders from the file it is handed, so the real order codes are
    what stand between the BOM and a wrong build.
    No spare NI cards -- two identical rigs cover each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
2026-08-15 feat(breakout): manual reward one-shot and real BNC/pushbutton reward connectors
    Change A: insert a Nexperia 74HCT123D monostable (U69) between the debounce
    inverter and the reward-OR gate so every hand-delivered reward gets a fixed
    ~199ms pulse regardless of hold time (442k Rext / 1uF Cext, K=0.45 at 5V,
    cross-checked against the datasheet's own measured example). Debounce RC
    changes from 10k x 100nF to 10k x 1uF (~10ms), covering switch bounce and
    the longer remote-BNC cable run's own mating transient. Pin map verified
    against Nexperia's real datasheet (TI's own CD74HCT123M/MT is obsolete).
    Change B: the three reward panel positions become real connectors -- J4
    (button) is a recessed pane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
    [taskpc-digital.kicad_sch]
2026-08-15 docs(breakout): confirm display sync was never implemented, dropped entirely
    Change C: the private spec's own decisions register closed the display-sync
    reserved position on 2026-08-15 ("no component ever existed behind the
    reservation; the panel position is freed") -- the photodiode flip patch
    supersedes it.
    Verified directly against this repository, not assumed from that closure
    note alone: grepped every generator and every committed sheet for "display
    sync"/"DISP_SYNC" and any variant -- zero hits, anywhere, past or present.
    No sheet, footprint, symbol, net, or BOM line ever represented this
    position in this repository's own sources, so there is nothing to remove
    here. Recorded so this f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
2026-08-15 feat(breakout): chassis earth stud, power-good LEDs, rail test points, main fusing
    Change D: five things a rack instrument needs that this board lacked
    (spec Sec.9.8), four landing on power.kicad_sch and one on
    pi-interface.kicad_sch:
    - Chassis earth stud (J56): an M3 mounting hole with a connected pad --
    the mounting point spec Sec.5.6's cage-to-rack bond can land on. Carries
    a new CHASSIS_GND net, joined to DGND at exactly one net tie (NT3),
    mirroring the fan return's own NT2 treatment.
    - Power-good LED per rail (D40/D41/D42, +12V/-12V/+5V): a failed rail is
    otherwise invisible until the data is wrong. ~4.5mA each, negligible
    against any rail's own budget.
    - Rail test points (TP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
    [breakout-bom-order.csv, breakout-bom.csv, pi-interface.kicad_sch, power.kicad_sch]
2026-08-15 docs(breakout): record the settled photodiode-role, Intan-default, and reward-polarity facts
    Change E: record three settled facts a rig operator or firmware author
    needs, so they don't have to be re-derived from the schematic or the
    private spec:
    - The two photodiode comparator channels' distinct roles: A_PD1 is the
    task patch (stimulus onset), A_PD2 is the flip patch (frame clock).
    - The default eight analog channels Intan receives: A_PD1, A_EYE_LX,
    A_EYE_LY, A_EYE_LP, A_JOY_X, A_JOY_Y, A_MIC, A_ACC.
    - MonkeyLogic's RewardPolarity setting must be HIGH to match this board's
    active-high RWD_CMD convention.
2026-08-15 docs(breakout): parametric audit — 21 findings against primary datasheets
    Seven would prevent correct operation: optocoupler LED under-drive on 30
    channels, the inbound stim channel, photodiode TIA saturation, four camera
    triggers on one unterminated output, the isolated supply at 105-165% of its
    per-rail rating, 31 BNCs on a footprint whose axis points at the enclosure
    lid, and a fan fuse in series with the main fuse at identical ratings.
    None were visible to ERC or to the twelve structural checkers, because those
    ask topological questions and every finding here is parametric. Section 5
    proposes the assertions that close that gap.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
2026-08-15 docs(breakout): pin F1's rail drop to the SS14 and polyfuse datasheets
    SS14 V_F max is specified at 1.0 A, not at our 0.45 A; the 1206L050 is
    0.15 ohm un-tripped, not the 0.5-0.8 ohm assumed. Series drop is 0.38-0.45 V,
    better than feared -- but 15 mA is an absolute maximum, not a recommendation,
    so both ends of the window are hard. At a +/-5% supply the tolerance spread
    is 1.95:1 against a 2.14:1 window.
    249 ohm with a +/-2% supply gives 8.8-13.7 mA, clearing both bounds. The
    supply tolerance becomes load-bearing.
2026-08-15 feat(hardware): datasheet parameter file, and correct D3
    Nineteen parts, sixteen pinned to primary manufacturer documents with the
    revision and retrieval date recorded. TOML so Python 3.11+ parses it with no
    dependency -- parametric checkers import limits from here instead of retyping
    them, so a datasheet revision propagates to every assertion.
    The PDFs themselves are deliberately not committed: they are copyrighted and
    this repository is public. Facts are not copyrightable; the documents are.
    Cross-checking 'feeds' against the audit caught D3, which cited a 2.00 mm
    panel thickness from 3M drawings for a part the board does not use. The chosen
    MH connector states no panel thickness. Correc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
2026-08-16 docs(breakout): rule R1, R2 and R3
    R1: pin 5 stays a second ground; the cable shield bonds through the M12's
    shell to the panel, keeping shield current out of signal ground. Available
    only because the M12 turned out to be panel-mounted -- which also resolves
    its gender (male, correct) and retires the custom M12A_5_Panel footprint.
    Conditional on the thread being metal, which is not yet confirmed.
    R2: selectable 0R/10R/DNP pad from the DB37 shell to AGND, matching the
    deferred-bonding philosophy the rest of the design already uses.
    R3: add pin 9 to both LDO symbols, tied to INTAN_GND.
2026-08-16 feat(hardware): pin LM339 and BAT54S to primary datasheets
    BAT54S confirms M5's clamp arithmetic: 200 mA average rating against 186 mA
    on a +/-24 V digital mis-plug.
    LM339 confirms M4's 2.2k pull-up (1.5 mA against a 20 mA absolute maximum)
    and re-confirms why V- must be AGND -- the output emitters are internally
    common to it. Also surfaces the tightest temperature margin on the board:
    the LM339x grade is rated 0-70 C junction, narrower than anything else here.
2026-08-16 feat(hardware): pin the dual isolated BNC to Amphenol drawing 31-6575
    Confirmed dual port, right angle, isolated. Port pitch 16.00 mm stacked --
    the number the panel elevations were blocked on. Isolation is structural
    (glass-filled PBT body), not a coating.
    Its PCB pattern matches the Winchester 364 family and KiCad's
    BNC_Win_364A2x95_Horizontal footprint, so a validated geometry exists; the
    Amphenol-specific KiCad footprint is self-contradictory and must not be used.
    16 mm stacking lets two rows of duals fit a 2U face, cutting the front panel
    from ~438 mm to ~358 mm of ~450 mm usable.
2026-08-16 docs(breakout): correct the audit's claim that no parametric checks exist
    test_driver_pin_sink_load already computes per-pin sink current against a
    per-part IOL budget, and its own history shows it caught the SN74HCT541 being
    22% over its rated sink. The audit overstated the gap.
    What it checks is the UPPER bound. What nobody checked is the LOWER bound --
    that current clears the optocoupler's IFH minimum. F1 is the mirror image of
    an assertion that was already there, which is how it survived.
    Implementing F1's resistor change alone was tried and reverted: the test
    correctly rejects 249R on a single output (12.65mA against a 7.5mA budget).
    The resistor and the output-paralleling must land t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
2026-08-16 docs(breakout): handoff for implementing the parametric audit
    Captures what lived only in the audit session and not in the repo: the stale
    breakout.net trap (checkers and the contract generator default to DIFFERENT
    paths, and both gave confident wrong answers against a nine-hour-old file);
    why F1 must land as one change and the exact two-resistor arithmetic; the
    fuse architecture worked through but not implemented, including the open
    question of whether a 1.1A PPTC exists in 1206; the panel numbers from the
    16mm stacked BNC pitch; and the implementation order with its dependencies.
    Also records that KiCad's BNC_Amphenol_031-6575_Horizontal footprint is
    self-contradictory and must not be use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
2026-08-16 docs(hardware): close R1's open condition; correct the M12 panel cutout
    The Phoenix Material table gives 'Material, knurls: Zinc die-cast,
    nickel-plated'. The thread is metal, so R1's shield-through-the-shell ruling
    holds with no physical verification needed.
    Two corrections from the same pages, which were in a datasheet already held
    locally and simply not read: the panel cutout is 13.5 mm with a 1.2 mm
    anti-rotation pin hole per the PART-SPECIFIC drilling diagram, not the 12.2 mm
    I took from the generic family installation sheet -- the distributor listing
    was right and my correction was wrong. And installation torque is 3-4 Nm, not
    1.5-2 Nm.
    Pin arrangement also recorded: 1-4 around the o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
2026-08-16 fix(hardware): drive the optocoupler LEDs (F1, both halves)
    430R never switched these LEDs. The original sizing solved
    (5.0 - V_OL - V_F)/I correctly but against the rail's NOMINAL 5.00V and
    V_F TYP; +5V reaches the anodes through F4 and D3 (0.42-0.49V of drop)
    and V_F's worst case is 1.80V, so the real worst-case current was ~5mA
    against the ACSL-6xx0's 7.0mA I_FH minimum. 30 channels were not
    guaranteed to switch for seventy-three commits.
    Both halves land together because neither is shippable alone -- 430R
    starves the LED, and 249R (~12.7mA) overloads a single 7.5mA output.
    Resistors, rail-aware: 430R -> 249R on the 30 LEDs fed from +5V, ->
    301R on the 2 fed from ISO_5V. ISO_5V is regul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
    [breakout-bom-order.csv, breakout-bom.csv, opto-intan.kicad_sch, opto-ni.kicad_sch, pi-interface.kicad_sch, taskpc-digital.kicad_sch]
2026-08-16 docs(spec): size the +5V rail for F1's real LED current, and pin its tolerance
    Section 8.2 budgeted the +5V rail from two figures that were both wrong
    for this board. 6.3 mA/LED came from the HCPL-4661 family; this design
    uses ACSL-6xx0, whose recommended minimum is 7 mA with an 8 mA
    guardband, so 6.3 mA is below the threshold at which the part is
    specified to switch at all. 10 mA was the mule's value, on a rail with
    no series drops in front of it.
    With F1 implemented the real drive is 12.65 mA nominal / 13.90 mA at
    the max-current corner, so 29 simultaneously-lit LEDs draw ~367-403 mA
    -- which the section's own 400 mA budget does not cover, before the
    logic and regulator branch is counted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
2026-08-16 fix(hardware): give the fan branch its own fuse path, and size F4 for the real +5V load (F7, M7)
    F7 -- THE FAN FUSE WAS DEFEATED BY ITS OWN PLACEMENT.
    F1 was fed from +12V, which is downstream of F2:
    J1.1 -> P12_RAW -> [F2] -> P12_FUSED -> [D1] -> +12V -> [F1] -> FAN_12V
    so the two were in SERIES at identical ratings (0.5 A hold / 1.0 A trip).
    Two identical parts in series have no selectivity: a fan fault at 0.9 A is
    below F1's trip but well over F2's hold, so F2 can open first and kill the
    analog rails to protect the fans -- inverting the whole purpose of giving
    the fans a separate fuse. It also meant F2 carried 337-361 mA rather than
    the ~100 mA the main rail alone draws.
    The fan b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
    [breakout-bom-order.csv, breakout-bom.csv, power.kicad_sch]
2026-08-16 fix(hardware): pin ref_start on the last five generators; the board is now idempotent
    `ref_start` was seeded by reading every already-committed sibling sheet at
    generation time. That is a latent renumbering bomb: the moment any sibling
    gains a refdes above its old maximum, every counter the reading sheet seeds
    moves, so regenerating a file for an unrelated one-line reason silently
    renumbers all of its own parts -- and, transitively, everything downstream
    that seeded past THEM.
    It stopped being latent during the panel-instrumentation task, when
    taskpc-digital.kicad_sch gained U69/R191/C149-C150 out of band. From that
    point a plain re-run of any of these five rewrote its whole refdes space: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
    [analog-frontend.kicad_sch, analog-ni.kicad_sch, comparators.kicad_sch, control-usb-i2c.kicad_sch, mux-intan.kicad_sch, opto-intan.kicad_sch, opto-ni.kicad_sch, pi-interface.kicad_sch]
2026-08-16 fix(hardware): take the ISO_5V branch off the isolated module (F5, on a regulated part)
    ISO_5V was made by a linear regulator off ISO_P12. A linear regulator
    passes its output current straight to its input, so this sheet's whole
    63-91 mA digital branch -- six detector stages, six pull-ups, two inbound
    LEDs -- was drawn THROUGH the isolated +-12 V module. Re-derived from the
    netlist after finding F1 (which raised the two ISO_5V LEDs from 7.33 mA to
    ~10.5 mA each), ISO_P12 sat at 114% typ / 170% max of the IH1215D's 66 mA
    per-rail rating while ISO_N12 carried 12-16 mA.
    Two defects in one. The over-rating, and an imbalance large enough that the
    module's own +-5% cross-regulation figure -- char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
    [analog-frontend.kicad_sch, analog-ni.kicad_sch, breakout-bom-order.csv, breakout-bom.csv, comparators.kicad_sch, control-usb-i2c.kicad_sch, mux-intan.kicad_sch, opto-intan.kicad_sch]
2026-08-16 fix(hardware): the analog front-end corrections (F3, M1, M2, M4; D1 recorded)
    Five findings, both photodiode channels each.
    F3 -- THE TRANSIMPEDANCE STAGE SATURATED. R38/R40 1M -> 180k. An FDS100 is
    13 mm2 at 0.30 A/W, so a display flip patch at ~0.29 mW/cm2 delivers
    ~11.3 uA -- and 11.3 uA x 1M demands 11.3 V, twice this board's +-5 V analog
    convention and past both NI's and Intan's input range. The stage clipped
    long before full scale.
    That matters more than a gain error sounds. The flat part is the BRIGHT
    part, and the edge these channels exist to time is what survives, so the
    defect would have looked like "it works" on a scope. 180k puts peak white
    near 2.0 V, which also lands inside t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
    [analog-frontend.kicad_sch, analog-ni.kicad_sch, breakout-bom-order.csv, breakout-bom.csv, comparators.kicad_sch, control-usb-i2c.kicad_sch, mux-intan.kicad_sch, opto-intan.kicad_sch]
2026-08-16 fix(hardware): one driver and one series resistor per panel output (F4, M3)
    F4 -- FOUR CAMERA TRIGGERS SHARED ONE UNTERMINATED OUTPUT.
    CAM_TRIG_BEH drove J14-J17 from a single SN74AHCT541 output. Four parallel
    coax runs present Z0/4 ~ 12.5 ohm, so the initial edge drew roughly 118 mA
    against the part's 25 mA per-output ABSOLUTE maximum -- brief, but on every
    edge for the life of the board. With no source termination the cameras
    could also see reflections and double-trigger, which is corrupted frame
    timing rather than a cosmetic fault.
    Each of the five triggers now has its own buffer channel and its own 47 ohm
    series resistor: CAM_TRIG_BEH splits into CAM_TRIG_BEH1..4, channel 2 of the
    exis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
    [analog-frontend.kicad_sch, analog-ni.kicad_sch, breakout-bom-order.csv, breakout-bom.csv, comparators.kicad_sch, control-usb-i2c.kicad_sch, mux-intan.kicad_sch, opto-intan.kicad_sch]
2026-08-16 fix(hardware): buffer the inbound stim channel locally (F2)
    Two defects in one wire, and the checker that should have caught the first
    was itself wrong about it.
    THE 100R PANEL RESISTOR WAS INSIDE THE LED'S CURRENT LOOP.
    ISO_5V -> 301R -> LED -> 100R -> Intan's output, so the loop was 401R and
    the branch delivered 6.57 mA worst case against the ACSL-6xx0's 7.0 mA
    I_FH minimum. Not guaranteed to switch. This was the only channel on the
    board whose protection resistor did double duty as a current-setting one.
    IT ALSO DEPENDED ON A PHYSICAL SWITCH NOBODY DOCUMENTED. The Intan
    Stim/Recording Controller's CONFIG4 selects whether its digital outputs are
    3.3 V or 5.0 V. With CONFIG4 DOWN the LED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
    [analog-frontend.kicad_sch, analog-ni.kicad_sch, breakout-bom-order.csv, breakout-bom.csv, comparators.kicad_sch, control-usb-i2c.kicad_sch, mux-intan.kicad_sch, opto-intan.kicad_sch]
2026-08-16 docs(breakout): hand off the connector work; check the BOM automatically
    Prep for a separate session to take audit step 5 (F6, D3, the footprint and
    panel rebuild) -- the only findings left, and the only mechanical ones.
    connector-handoff.md records what is NOT already written down: the current
    verification baseline and how to reproduce it, board-wide refdes maxima for
    out-of-band minting, what changed about the workflow (the refdes bomb is
    fixed and all ten generators are pinned; the two-different-.net-paths trap
    is not), and the traps found the hard way.
    Two of those traps matter more than the rest. This project has already
    shipped a wrong custom footprint once -- build_minidin() drew an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
    [test_bom_matches_netlist.py]
2026-08-16 fix(hardware): rebuild the connectors on their primary drawings (F6, R1, D3)
    Audit step 5, the mechanical half. Three connectors changed, one of them a
    fab-stopper, and none of it was visible to the netlist.
    MDR68 (the fab-stopper). Rebuilt from MH drawing 3700-0121-01 rev 3.0. The
    as-built footprint drilled contacts at 0.5 mm against a required 0.85 mm -- the
    pins do not fit, so the board could not have been assembled -- and laid them out
    as 2 rows at 2.84 mm where the drawing shows 4 staggered rows of 17 at 1.905 mm.
    The 4-row stagger is what makes an 0.85 mm drill manufacturable at a 1.27 mm
    mating pitch at all; the array now spans the drawing's own 41.91 mm exactly,
    which is the arithme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
    [analog-frontend.kicad_sch, analog-ni.kicad_sch, breakout-bom-order.csv, breakout-bom.csv, comparators.kicad_sch, control-usb-i2c.kicad_sch, mux-intan.kicad_sch, opto-intan.kicad_sch]
2026-08-16 docs(breakout): close audit step 5, redraw the panel, decide D3
    Every finding in parametric-audit.md is now closed. F6 and D3 carry IMPLEMENTED
    blocks in the same style as the electrical ones, recording what shipped and where
    it differed -- the implementation corrected that document seven times in total,
    two of them here, and the corrections are marked in place rather than applied
    silently.
    D3 closes by DECISION, not by asking anyone, and noticing why is the whole
    content of the fix. The finding asked what panel thickness the connectors will
    accept. That is backwards: we are having the panels machined, so we choose the
    thickness and the connectors only have to accept it. The real question i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
2026-08-16 docs(breakout): refresh the pre-layout review for the parametric audit
    This document is the gate Task 14 does not start without, and it was written
    before parametric-audit.md existed. It has been signing off on a board that then
    turned out to have seven findings that would have prevented it working.
    The most important edit is the one that removes a true sentence. The closing
    section read "Nothing found during this audit rose to that bar" -- the bar being
    "stop, do not proceed to layout." That was an accurate summary of the review that
    produced it and was overtaken within the day. It is preserved rather than deleted,
    with the reason attached, because why it was wrong is the most useful thing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
2026-08-16 docs(breakout): correct the MDR68 tail-map risk -- it is a fit failure, not silent
    Four files described the unconfirmed tail-row-to-contact-number map as something
    that "scrambles 68 signals on a board that passes ERC and every test". That
    overstates it, and the correction changes what kind of check the item needs.
    All four candidate arrangements produce DIFFERENT HOLE PATTERNS, not merely
    different numbering. The four tail rows carry X phases (0,1,0,1), (1,0,1,0),
    (0,1,1,0) and (1,0,0,1) on the 1.27 mm mating grid, and all four are distinct --
    so a pin would have to move 1.27 mm laterally AND 1.905 mm in depth to seat in
    the wrong one, far beyond any contact compliance.
    A wrong choice is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
    [gen_wl_sync_footprints.py]
2026-08-16 docs(breakout): review brief for the F6 connector change
    Written by the author of 693c919 as a list of places to attack, not as
    reassurance. The argument for wanting a person on this one is that the change
    introduced two defects which ERC, all 13 checkers and all 121 tests passed
    straight through -- pad-role assignment and footprint geometry are invisible to a
    netlist by construction.
    Two questions carry real weight; the rest is ordinary code review.
    Q1, highest stakes and silent: is pad 1 the centre conductor or the shell? The
    drawing gives hole positions but not roles, so the roles are INFERRED -- and
    the inference rests entirely on one third-party footprint's pad grouping
    (BNC_W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
2026-08-16 feat(hardware): camera lines carry the barcode, not a trigger
    The cameras free-run, so this box does not clock them -- they need a shared
    TIMEBASE they can record, which is what the barcode already is. The five
    camera-facing panel BNCs now carry BARCODE_RAW instead of the hardware-PWM
    triggers from GPIO18/19.
    It costs nothing on the board. Same buffers, same 47 ohm series resistors, same
    five BNCs, same panel: only the INPUT NET of five buffer channels moved
    (U15.A3/A4 and U74.A2/A3/A4). No new parts, no new panel holes, no refdes
    disturbed. Nets renamed CAM_TRIG_* -> CAM_SYNC_*, because the old names describe
    a clock those lines no longer carry, and a name that is right about the model and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
    [analog-frontend.kicad_sch, analog-ni.kicad_sch, breakout-bom-order.csv, breakout-bom.csv, comparators.kicad_sch, control-usb-i2c.kicad_sch, mux-intan.kicad_sch, opto-intan.kicad_sch]
2026-08-16 docs(hardware): pin SN74LVC541A and the FLIR BFS GPIO, and record a 70 mV miss
    Pinned while working up the camera frame-time inputs. Both entries exist because
    of one number.
    SN74LVC541A (TI SCAS298O, rev June 2026) is the part spec Sec.7.1's global rule
    names for EVERY inbound signal on this board -- "74LVC541A on 3.3V for inbound,
    74HCT541 on 5V for outbound. Never one part for both" -- and it was the only part
    in that rule not pinned to a primary document. Its V_IL max is 0.8 V at
    VCC 2.7-3.6 V.
    FLIR BFS-U3 GPIO (FLIR's own Installation / GPIO Electrical Characteristics): the
    opto-isolated strobe output is OPEN COLLECTOR and its best published low is
    0.87 V, at 5 V through 1.0 kohm. Tha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
2026-08-16 docs(hardware): record that BOTH camera groups are the same FLIR interface
    The eye tracker is OpenIrisDPI (Ressmeyer et al., a dual-Purkinje plugin for the
    OpenIris framework), and OpenIris drives FLIR cameras through the Spinnaker SDK --
    its reference binocular build is two Blackfly S USB3 cameras at 720x540 and up to
    500 fps, which is exactly the 500 Hz spec Sec.6 already assumes for the eye
    channels.
    So the ohDPI strobe and the behaviour-camera strobe are the SAME electrical
    interface, and [flir_bfs_gpio] covers both. One front-end design serves both
    inputs -- which was not obvious, and would have been easy to design twice.
    Also recorded: BFS exposes a NON-isolated 3.3 V line that would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
2026-08-17 docs(breakout): correct camera-sync-change §2 -- moving the window costs a spare
    §2 claimed that moving the PIO capture window to GPIO2-18 would delete the
    `force_eeprom_read=0` mitigation "along with two more free pins". The second
    half is wrong, and it went in before the arithmetic was worked properly.
    A 17-wide window that avoids both hardware-PWM pins (18, 19) must end at 17 or
    below, so it must start at 0 or 1 -- and both of those windows contain GPIO0
    and/or GPIO1, the pins the mitigation exists for. Escaping the I2C pins while
    keeping two free PWM pins is not available; it is a forced trade, and the
    proposed window nets one FEWER spare (3, one PWM-capable) than the current one
    (4,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
2026-08-17 feat(hardware): frame-time inputs -- camera strobes back to GPIO26/27
    Closes the gap camera-sync-change.md §3 opened. With the cameras free-running,
    spec §12 item 1's justification for dropping exposure-active returns ("the Pi
    triggers the cameras so frame times are known by construction") is false in
    both halves. One FLIR ExposureActive strobe per camera group now returns on a
    spare back-panel BNC and is timestamped in the same event stream as everything
    else.
    WHY A COMPARATOR AND NOT THIS BOARD'S USUAL INBOUND BUFFER. The strobe's best
    published low is 0.87 V against SN74LVC541A's 0.8 V V_IL max -- a SILENT 70 mV
    miss, on a signal that looks perfectly correct on a scope. A comparator is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
    [breakout-bom-order.csv, breakout-bom.csv, comparators.kicad_sch, pi-interface.kicad_sch, taskpc-digital.kicad_sch]
2026-08-17 docs(hardware): warn that re-exporting the BOM wipes 18 rows of sourcing data
    hardware/breakout/breakout-bom.csv is documented as the literal, unedited
    `kicad-cli sch export bom` output. It has not been that for some time: 18 rows
    -- every wl-sync:BNC_Dual_RA_Isolated body plus J1 -- carry hand-added
    MPN/Manufacturer/Qty (031-6575, Amphenol RF, 1) that the raw export emits blank.
    Found the hard way while regenerating the BOM for the frame-time inputs, which
    blanked all 18. tests/hardware/test_bom_matches_netlist.py did NOT catch it: it
    compares Reference and Value only, not the sourcing columns, so the loss was
    silent and would have reached procurement.
    Records the trap and the fix (edit t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
2026-08-17 test(hardware): guard the BOM sourcing columns a re-export would blank
    breakout-bom.csv is documented as the literal, unedited `kicad-cli sch export
    bom` output, and it is not: 18 rows carry hand-added MPN/Manufacturer/Qty that
    the raw export emits blank -- 17 dual-BNC bodies (031-6575, Amphenol RF) plus
    the supply inlet header.
    So the file looks regenerable and is not. Re-running the documented command
    wipes all 18 silently and the whole suite stays green: test_bom_matches_netlist
    reads Reference and Value only, and no ERC or netlist checker reads a BOM at
    all. That happened on 2026-08-16 while regenerating for the frame-time inputs
    and was caught by eye during diff review -- exactly the "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
2026-08-17 docs: apply the deferred spec pass for free-running cameras and frame times
    camera-sync-change.md §4 had carried eight spec changes as "not yet applied --
    decisions listed for review" since 2026-08-16, and the frame-time inputs added
    more. Applies all of them except the two that genuinely cannot be done yet, and
    fixes a citation error that was propagating.
    THE CITATION WAS WRONG, AND IT CHANGED THE EDIT. Both camera-sync-change.md and
    frame-time-inputs.md cited "spec §12 item 1" for the dropped exposure-active
    returns. It is §11 item 1 -- "Reversals and amendments" -- and §12 item 1 is the
    closed +5V current-budget item. That matters beyond the number: §11 records
    reversals AGAINST the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
2026-08-17 docs(spec): close open item 10 -- the eye-channel rate is DAC-bound, not camera-bound
    Item 10 was raised when the frame-time work made 500 fps a property of rig
    configuration rather than of this design, leaving §6's ~2 kHz adequate rate
    resting on a number nobody here controls. Looked it up rather than guessing.
    Two findings, and the second is the one that actually closes it:
    - OpenIrisDPI states it "is capable of tracking the first and fourth Purkinje
    reflections at 500 Hz running on modern CPUs". 500 Hz is the algorithm's
    CPU-bound design point, not an arbitrary setting, so the rig is not about
    to be reconfigured well above it.
    - The eye data reaches this board ONLY thro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
2026-08-17 feat(wl_sync): capture camera frame times on GPIO26/27, retire the PWM trigger
    The software half of the frame-time inputs, and the last row of
    camera-sync-change.md §4's deferred list.
    RETIRED: backend.py's start_pwm(), whose docstring read "Start a hardware PWM
    channel -- the camera trigger". It is gone from both the protocol and the fake
    because the thing it drove is gone: the cameras free-run, so this box emits no
    trigger at all, and GPIO18/19 are spare. It was a live entry point describing
    hardware that no longer exists, pointed at pins that no longer connect to
    anything -- right about the model, wrong about the board, which is this
    project's named recurring failure. rp1/ implements no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
    [backend.py, service.py]
2026-08-17 docs(plan): retire the camera-trigger PWM path from the sync-box plan
    Removing start_pwm() from SyncBackend left the plan instructing whoever picks up
    Task 5b to implement it. Step 2 still read "start_pwm writes the hardware PWM
    sysfs/ioctl channel", and six further places -- the Global Constraints mechanism
    table, the hardware-constraints list, Task 4's illustrative protocol listing and
    its FakeBackend/test snippets, and the module docstring -- still described a
    camera trigger this box no longer emits.
    Task 5b now names start_edge_capture (including GPIO26/27) in place of
    start_pwm, and carries an explicit "do NOT implement a PWM channel here" note.
    The "camera triggers must land on GPIO12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
2026-08-17 docs(spec): continuous recording, crash stitching, and the outage as data
    Design for the sync box's run model, agreed 2026-08-16. Supersedes the implicit
    session model in the sync-box plan, which assumed a session is a bounded run
    that records and writes its log at the end.
    THE REFRAMING. The sync box is the first device on each day and the last off; it
    runs continuously while every other device starts and stops blocks inside that
    run. A session is a DAY, not a block. Two requirements follow: it must survive a
    mid-day crash by stitching to what came before, and -- the sharper one -- the
    outage is itself DATA, because the other devices keep recording while the box is
    down. Trials during a ga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
2026-08-17 docs(spec): resolve the three dependencies the continuous-recording design raised
    - CR2032: recorded in a new hardware/assembly-checklist.md (build steps no
    schematic can express) plus an order-BOM spares line, rather than relying
    on the software's clock_trusted flag as the only defence.
    - Time source: NTP over the Ethernet already required for NAS transfer, with
    the RTC covering power-off and network outages. Server chosen at bring-up.
    - Status indicator: add a POPULATED status LED on GPIO18 before layout. The
    heartbeat LED is wired to BARCODE_RAW and cannot be repurposed without
    corrupting the barcode, so a degraded box currently looks identical to a
    healthy o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
2026-08-17 docs(plan): implementation plan for continuous recording
    Nine bite-sized TDD tasks implementing the 2026-08-16 continuous-recording spec:
    the B barcode record type, the counter-as-clock with its monotonicity clamp, a
    canonical GPIO map, the append-only segment writer with its crash-detecting
    trailer, the Recorder sink seam, the manifest with its gap enumeration, the new
    header fields, the run loop and `wl-sync record` CLI, and the systemd unit whose
    Restart=always is what makes stitching automatic.
    Every task carries real test code and real implementation code -- no
    placeholders -- and lands an independently testable deliverable. The whole plan
    runs on FakeBackend with no Pi present, so it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
2026-08-17 feat(clock): barcode counter as seconds-since-2020, with a monotonicity clamp
2026-08-17 fix(clock): validate 32-bit range in read_checkpoint and next_value; add ceiling tests
    [clock.py, test_clock.py]
2026-08-17 fix(test_pins): catch same-set GPIO_MAP transpositions with exact-value assertion
    The previous membership test allowed name swaps. Now test_gpio_map_pins_every_name_to_its_exact_pin
    pins each name to its exact value, catching exactly the failure class the module
    exists to prevent: silent pin misnamings that survive board changes.
    [test_pins.py]
2026-08-17 feat(segment): append-only segment writer with a crash-detecting trailer
    [segment.py, test_segment.py]
2026-08-17 fix(segment): serialize absent barcode span as empty fields and skip trailer in read_log
    [log.py, segment.py, test_segment.py]
2026-08-17 fix(manifest): carry last-witnessed barcode across zero-barcode segments
    A segment opened and then crashed before its first barcode tick has
    barcode_first/barcode_last both None. Zipping adjacent summaries let
    that segment's `continue` swallow the gap on both sides of it, hiding
    a real outage entirely -- and this shape recurs on every restart under
    systemd's Restart=always. Track the last witnessed barcode across any
    number of such segments instead of comparing only neighbouring pairs.
    Also rewrite the ordering test to use unpadded seg-9/seg-10 filenames,
    where lexical and numeric order genuinely diverge; the zero-padded
    version could not have caught a regression to lexical sort.
    Co-Author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
    [manifest.py, test_manifest.py]
2026-08-17 fix(clock): stop inflating every clean restart's gap by a checkpoint interval
    next_value() applied the periodic-checkpoint staleness margin unconditionally,
    so a clean restart's checkpoint -- the exact last-emitted barcode, with no
    staleness at all -- was still clamped forward by a whole CHECKPOINT_INTERVAL_S.
    An ordinary restart seconds later was misreported as a ~61s gap; under Task 9's
    Restart=always a crash loop would run the counter away from real time without
    bound. The margin now lives only in the periodic mid-run checkpoint write
    (wl_sync.cli.run), which is the one checkpoint that can genuinely be stale.
    Also: boot_id now comes from /proc/sys/kernel/random/boot_id (probe_boot_id,
    de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
    [cli.py, clock.py, test_cli.py, test_clock.py]
2026-08-17 docs(spec): move the barcode clamp's staleness margin to the write side
    The spec's next_value documented `max(value_from_clock, checkpoint + interval + 1)`
    -- the margin applied at READ time. Implementing it and running the real binary
    showed that is wrong: the clamp then binds on EVERY restart inside an interval,
    including clean ones where run() has already written the exact last barcode at
    close. Two real `wl-sync record` runs 5 s apart reported a 61 s gap, and ten
    restarts over ten seconds of real time left the counter 600 s ahead of the wall
    clock. Under the unit's Restart=always/RestartSec=1 the counter runs away from
    real time without bound, which destroys the premise the whole design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
2026-08-17 fix(cli): put barcode ticks on the recorded timebase, survive a dead RTC
    Three defects that all live in the run loop, all of which need a real clock or a
    real day of running to see.
    The barcode record's tick was the raw RP1 counter written straight to the writer,
    while E and W ticks go through Recorder and are unwrapped. After the first 71.6
    minute wrap -- about twenty times a day -- every barcode's tick was k*2^32 us
    adrift of the very edges it exists to align. Barcodes now go through Recorder as
    a third capture path with its own _TickUnwrapper; 1 Hz is four orders of
    magnitude below the wrap period, so a per-path unwrapper is safe there. The tick
    is also sampled BEFORE emit_frame() rather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
    [cli.py, log.py, service.py, test_cli.py]
2026-08-17 fix(log,clock,manifest,segment): stop the readers and the trust flag lying
    evaluate_clock tested `value_from_clock(now) <= checkpoint`, but the periodic
    checkpoint is now deliberately a FUTURE value, so that stopped being a clock test
    and became a "did we crash recently" test -- healthy clock, crash at 70 s,
    restart 1 s later, clock_trusted: false. deploy/README.md tells the operator that
    flag usually means a missing CR2032, so a crashing process sent someone to check
    a battery; and spec Sec.7's purpose for the field is to let wl-preproc distrust
    gap arithmetic across a boundary, so it fired on every crash boundary, which is
    where the arithmetic matters most. Trust now gets one interval of t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
    [clock.py, log.py, manifest.py, segment.py, service.py, test_cli.py, test_clock.py, test_log.py]
2026-08-17 fix(deploy,cli): make the shipped unit start, and give the daemon a voice
    The unit did not work, in two compounding ways. StartLimitIntervalSec is a [Unit]
    key and shipped under [Service], where modern systemd logs "Unknown key name ...
    ignoring" and applies the default 5 starts / 10 s anyway -- so the line was inert
    and a fast crash loop still ended in `failed`, the exact unattended scenario the
    comment above it says the box must survive. And ExecStart omitted --fake, so
    main() printed "only --fake is available..." and exited 2 immediately: following
    deploy/README.md's literal `systemctl enable --now wl-sync` left the unit
    `failed` within about five seconds. The key moves to [Unit], ExecSta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
    [cli.py, test_cli.py]
2026-08-17 fix(cli,spec): keep the degradation narrow, and correct spec Sec.5's path count
    _resume compared `started >= BARCODE_EPOCH` directly, which turns a naive
    datetime -- a caller bug that silently means "local time" and would shift every
    barcode -- into a TypeError instead of value_from_clock's clear message. Only a
    pre-epoch reading degrades now; naive readings and the 32-bit ceiling keep
    raising, since a value past the ceiling cannot be encoded into a frame at all.
    Spec Sec.5 still said two capture paths and a two-way merge. There are three.
    [cli.py, test_cli.py]
2026-08-17 fix(clock): equality is the healthy boundary, so the trust test is `<`
    The periodic checkpoint stores `value + CHECKPOINT_INTERVAL_S` at an instant when
    the clock read `value`, so a checkpoint exactly one interval ahead is what a
    perfectly truthful clock looks like immediately after one -- a restart landing in
    the same second as the last periodic write. `<=` therefore flagged it, which
    reintroduced in a one-second slice the exact false positive the tolerance was
    added to remove:
    clock=209120400 checkpoint=209120460 (a healthy high-water, just written)
    -> UNTRUSTED reason: 'clock_behind_checkpoint'
    Distrust now begins only once the checkpoint leads by MORE than an interval,
    wh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
    [clock.py, test_clock.py]
2026-08-17 fix(clock,cli): checkpoint the exact value every second, not a high-water mark
    CRITICAL REGRESSION, introduced by this wave. The startup checkpoint write left
    every run a mark 60 s ahead of what it had actually emitted, so a run that died
    inside its first interval handed the next restart a value to resume past -- which
    then left its own mark. One crash costs one interval and looks survivable; under
    Restart=always it compounds without bound. Measured: 25 crash restarts over 75 s
    of real time on a PERFECT clock put the counter 1449 s ahead of wall time, with
    24 spurious "wall clock is not moving forwards" warnings and clock_trusted: false
    from the third restart on. That is the runaway spec Sec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
    [cli.py, clock.py, test_cli.py, test_clock.py]
2026-08-22 fix(cli,clock,service,manifest,log,segment): mark the barcode before it reaches the wire
    Closes the three defects the previous session documented and stopped on, plus the
    residuals it deferred. Ledger:
    .superpowers/sdd/2026-08-16-continuous-recording/progress.md
    THE CHECKPOINT MECHANISM HAD TWO DECISION POINTS, which is why four attempts at it
    failed. `_ValueSource` chose a value and `BarcodeGenerator` clamped it again, downstream
    of the checkpoint. Probed in isolation, `_ValueSource` returns [1000, 1100, 1100] on a
    clock that jumps then stalls -- a duplicate only the generator's clamp was hiding. So
    "checkpoint before emitting" alone would have reopened the same hole one line lower.
    The v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
    [cli.py, clock.py, log.py, manifest.py, pins.py, segment.py, service.py, test_cli.py]
2026-08-22 fix(rp1): two words per event, because 16 delta bits cannot span a trial gap
    The FIFO format packed the captured data and a tick DELTA into one 32-bit word.
    Sixteen data lines leave sixteen delta bits, which is 65.535 ms. Trials are ~3 s
    (docs/superpowers/plans/2026-08-13-sync-box.md:246), so ordinary inter-trial gaps
    overflowed the field and `accumulate_ticks` summed the truncated remainder
    without complaint: an error of 65.536 ms per overflow, cumulative for the rest of
    the session, and silent.
    No clock divider fixes it. Covering 3 s in 16 bits needs >=45.8 us per tick,
    which spends half of Task 5b Step 3's entire +/-100 us acceptance budget on
    quantisation alone, and a longer inter-trial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
    [pio_capture.py, test_pio_capture.py]
2026-08-22 feat(rp1): PIO strobe capture program and a piolib backend bound to the real API
    Task 5b Steps 1 and 2. Steps 3-5 are bench acceptance and need a Pi 5.
    BUILT FROM PIOLIB'S PUBLISHED HEADER, NOT FROM A GUESSED API, and that changed
    the design rather than merely confirming it:
    * `pio_encode_*` exists and `pio_program_t` takes a plain uint16_t*, so THERE
    IS NO ASSEMBLER IN THE PATH. The program is instruction words in
    wl_sync/rp1/program.py, which makes it a value that laptop tests can check --
    otherwise the one part of this task with no verification at all.
    * Those same encoders let the backend verify its own encodings at startup.
    _assert_encoders_agree checks every instr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
2026-08-22 feat(service): give the sink a single owner thread, because a lock would drop words
    Recorder and SegmentWriter both documented that `sink.write()` must be called
    from one thread, and both handed the problem forward: "whoever introduces real
    threads owns adding the lock." The RP1 backend delivers from capture threads, so
    that is now due -- and the lock is the wrong answer.
    A lock has to cover `flush()` as well as `write()`, since flushing mid-write is
    the same hazard, and `SegmentWriter.flush()` calls os.fsync(). So a capture
    thread would block on disk, stop draining the PIO RX FIFO -- 8 words deep, fed by
    `push noblock`, which DROPS -- and fail Task 5b Step 3's "zero dropped words".
    Measure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
    [segment.py, service.py, test_queued_sink.py]
2026-08-22 feat(rp1): edge capture and barcode output via libgpiod v2
    Task 5b Step 2 completed. Both methods raised NotImplementedError rather than
    being guessed; bound now against libgpiod's real published API.
    EDGE CAPTURE IS NOT PIO, AND IS BETTER FOR IT. The kernel stamps each event from
    CLOCK_MONOTONIC AT INTERRUPT TIME -- LineSettings.event_clock defaults to it --
    and now_us() counts from that same clock, so edges land on the shared timebase
    with NO correction for when this process was scheduled. Reading a clock in the
    callback would have folded thread wake-up latency into every edge, which is
    exactly the error this box exists to keep out of the record.
    EdgeEvent.global_seqno makes a kernel-sid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
    [backend.py, gpio.py, test_rp1_gpio.py]
2026-08-22 fix(service,rp1): background failures must be loud, not fatal and not silent
    Reviewing what landed today, the error handling added to make failure VISIBLE
    had introduced two failures of its own, both in paths no test covered.
    DEADLOCK IN QueuedSink.close(). A write that raises makes the drain thread
    return, so nothing is left to answer a close request -- and close() waited on a
    barrier that could never be set. Reproduced: close() never returns. On the rig
    that is the daemon hanging at session end with the segment still open and no
    trailer, so the day it just finished recording reports as a crash. Caused by the
    very error handling meant to make failure visible. `_await` now gives up when the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
    [backend.py, gpio.py, service.py, test_queued_sink.py, test_rp1_gpio.py]
2026-08-22 docs(rp1): backend.py no longer omits edge capture, and says how it fails
    The module docstring still said start_edge_capture was deliberately absent, which
    stopped being true in 0cf94d8. Replaced with the two things a reader of this file
    actually needs: why edge capture is libgpiod rather than PIO, and that every
    capture path here fails by going QUIET, so the run loop owes it a check_health()
    call every second.
    Claude-Session: https://claude.ai/code/session_01LvF34ApxUwede2LD3T5kzz
    [backend.py]
2026-08-22 docs: add a tracked handoff, because the SDD ledger does not travel
    `.superpowers/sdd/.gitignore` is `*`, so the ledger that carried the last two
    handoffs exists only on the machine that wrote it. Anyone picking this up from a
    fresh checkout would have found the code and none of the reasoning.
    docs/next-session.md carries what still matters: the one open loop, the ordered
    next steps, the three things to check first on the bench, the decisions that are
    load-bearing and easy to undo by accident, and the verification habits that
    caught real defects today.
    Names the open loop plainly: check_health() exists and says the run loop must
    call it every second, and cli.py does not. Nor does cli.py wr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
2026-08-25 docs: the orchestrator block now names the moment, not the lesson
    The previous block led with "Keep it true" — a heading naming a virtue, so an
    agent adding a dependency had no reason to read it. wl-orchestrator's own
    design rule is that a trigger uses the vocabulary of the work, not of the
    lesson. This one leads with the moment that requires the edit, then the action,
    then a command that can be run in the next thirty seconds.
    What changed in substance: there is now a check. `wl-check` reads only this
    repository's wl.yaml and fails only on this repository's faults, so it is safe
    in this repository's CI in a way `wlo validate` never was — its exit code
    covers the whole registry, so a nei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
2026-08-25 ci: check this repository's own wl.yaml
    Its own workflow rather than a step in an existing one. The check is unrelated
    to whatever else this repository builds, needs no matrix, and keeping it
    separate means a manifest fault is legible on sight and cannot fail — or be
    masked by — a job it has nothing to do with.
    It gates on THIS repository's manifest and nothing else. wl-orchestrator's
    `wlo validate` cannot be used here: its exit code covers the whole registry, so
    a neighbouring package's bad manifest would fail this build. wl-check reads one
    file and reports only this package's faults.
    wl-manifest is pinned by commit. An unpinned reference means a change there can
    turn this red without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
2026-08-25 CLAUDE.md: what depends on this package, generated
    wl-preproc pins this repository at a commit for session identity, the barcode
    codec and the log format, and until now nothing here said so. Changing any of
    them silently breaks its CI schema export.
    Generated by `wlo dependents wl-sync --write` and regenerated the same way, not
    edited by hand. It is true as of the commit it names, which is the point: a pin
    that has moved is visible here.
2026-08-25 wl.yaml: declare what the sync box owns
    wl-preproc's manifest declares that it mirrors `syncbox-log-header` from here,
    and V013 correctly reported that this repository had never said it owns it —
    a half-declared edge, asserted from one end only.
    Three artifacts, the three wl-preproc's CHECKPOINT names: "wl-sync owns
    everything the sync box produces — session identity, the barcode codec, the log
    format". None ships a rendered schema here; the JSON form of the log header
    exists only as wl-preproc's re-export, which is why that entry is a mirror
    there and the definition is here.
    `at` points at the defining module rather than a schema file, because that is
    where the contract actually lives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
2026-09-28 Note wl-expcontroller is wl-xcon in the dated wl-sync handover
    The PI's decision, 2026-09-28. HANDOVER-wl-expcontroller.md is a dated,
    consolidated handover (2026-08-31, read against a pinned wl-sync commit) and
    is left in its own voice rather than rewritten -- it names the controller
    `wl-expcontroller` throughout, including the `expcontroller/` directory name
    in the rig session layout it documents (data, not prose, and not touched). A
    naming note at the top records the rename and that the old name still
    resolves through the registry's aliases. No other current reference to
    wl-expcontroller, wl-expviz or wl-exptasks exists in this repository.
    Full test suite unaffected and green (274 passed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
2026-10-18 Hardware docs: the 16S2's GPIO table, the 6343's PFI pins, and two commitments
    Read against primary sources on 2026-10-18, prompted by wl-xcon's asks of
    2026-10-11.
    [flir_bfs_gpio] gains the BFS-U3-16S2 page's table, verbatim. It splits every
    level into "No Load" and "Load", and the 04S2 page carries the same table.
    Its 5 V / 1 kohm row gives a loaded high of 2.29 V, below the frame-time
    comparator's 2.50 V threshold. FLIR do not define the load, but a group's
    primary strobe also drives each secondary's opto input. frame-time-inputs.md
    Sec.4 records this as open, pending a bench measurement.
    Spec Sec.9.2 put P2.0-P2.7 on the task PC card's Connector 1. NI's Figure A-5
    (370784K-01) puts all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
2026-10-18 Reply to wl-xcon's asks of 2026-10-11
    Appends a dated reply section to the handover, read against wl-xcon main at
    a607414:
    - Asks 3 to 8 are answered.
    - Asks 1 and 2 (session id) are marked open: they reverse the "a day is one
    session" rule and need their own decision.
    - The 2.18 cm / +-17 deg patch figures in the 2026-08-31 section are struck
    through and replaced in place, as wl-xcon asked (XC-090).
    Claude-Session: https://claude.ai/code/session_013HK81J55qfjevPUUfGjAqJ
2026-10-18 wl.yaml: say where the build is
    Adds the status block wl-check noted as missing (C007). It records what is
    built (the recorder and the RP1 backend, tested on FakeBackend) and what is
    not (the backend is not wired into the run loop, and the board is pre-layout),
    and names what comes next. It describes 9e60ed6.
    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
2026-10-18 Step A: wire the RP1 backend into the run loop
    The hardware path was built but not connected, so `wl-sync record` refused
    anything but --fake. It now runs Rp1Backend, on a GPIO chip chosen with
    --gpiochip. The run loop:
    - gives the segment one owner thread (QueuedSink), on every backend;
    - calls check_health() each second and once more after capture stops,
    logging a failure once per episode while recording continues;
    - stops capture before closing the segment, and still closes it cleanly
    if stopping fails.
    The handoff did not list two holes, which also needed fixing:
    - Nothing drained the PIO FIFO, which holds four events, so event codes past
    the first burst would have been dropped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
2026-10-18 wl.yaml: Step A has landed
    The status block now says the RP1 backend is wired into the run loop and still
    unproven on silicon, and that bench day comes next. It describes 02b6271.
    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
2026-10-18 deploy: how the sync box's OS was set up, headless
    Records the 2026-10-18 setup of wl-sync-rig0, done with no screen and no NVMe adapter:
    - Raspberry Pi OS Lite on a USB drive, booted from USB and cloned to the NVMe with
    rpi-clone;
    - the settings a stock image lacks: force_eeprom_read=0, and a persistent journal
    overriding Raspberry Pi OS's RAM-only default;
    - the checks that prove the result.
    Also records what tripped it up. A direct cable with no DHCP makes the box vanish
    after a few seconds. rpi-clone's dependency prompt aborts without a terminal. The
    setup sudo drop-in is temporary.
    next-session.md's bench-day step now names the box that is ready for it.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
2026-10-18 bench: check the box's own barcode, read back through an edge input
    With GPIO17 (the barcode output) jumpered to GPIO20, every frame the box emits
    lands in its segment twice: as the B record it logged, and as edges.
    `python -m wl_sync.bench loopback` decodes the edges with barcode.decode_edges
    and matches them against the B records, then reports:
    - frames matched;
    - frames logged but never decoded;
    - frames decoded but never logged;
    - the lead edge's offset from its logged tick.
    It exits non-zero on any mismatch. It tests the barcode output on the pin
    itself, which is where the stuck-high defect lived and where no fake can reach.
    Checked on the box against a run without the jumper: it rep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
2026-10-18 Breakout: propose the task-PC line-out and the PFI copy of PD1_COMP
    A proposal, not yet drawn. It implements spec Sec.12 item 11, committed to
    wl-xcon (XC-327) for before layout, and every fact in it is cited to NI's manual
    (370784K-01) or the 6343 specification (377873B-01).
    - Line-out: one isolated dual BNC body on the back face, carrying AO 0/1 through
    100 ohm, with the shells on AO GND only. NI connects AO GND to D GND on the card,
    so the board cannot keep the amplifier's ground off the card; isolated shells
    keep its return current off this board's planes.
    - PFI copy: PD1_COMP, through the free channel of pi-interface's SN74LVC541A and
    100 ohm, to PFI 7. That is the last free bu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
2026-10-18 Breakout: draw the task-PC line-out and the PFI copy of PD1_COMP
    Implements hardware/breakout/line-out-and-pfi-copy.md (spec Sec.12 item 11,
    wl-xcon XC-327), approved 2026-10-18.
    - Line-out. Connector 0's AO 0/AO 1 (pins 22/21) go through R221/R222
    (100 ohm) to J57, a new isolated dual BNC on the back face. Its shells are on
    AO_GND_TPC (pins 55/54) and nothing else: NI ties AO GND to D GND on the card,
    so no board plane may carry the amplifier's return.
    - PFI copy. pi-interface's SN74LVC541A level shifter gains channel 1, PD1_COMP ->
    PD1_COMP_PFI_BUF, which R223 (100 ohm) takes to Connector 0 pin 38, PFI 7.
    That pin avoids the default counter outputs, PFI 12-15. The departure from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
2026-10-18 line-out-and-pfi-copy.md: say what was drawn
    Tidying reported by wl-xcon on reading 0683ad6:
    - It still asked for approval, though its first line said approved and drawn.
    - It never named J57 or R221-R223.
    - It left out "leave PFI 7 unrouted to any counter", which appears in the
    handover.
    Also fixes one inconsistency they did not report. Sec.5 had pi-interface
    driving PD1_COMP_PFI through its own 100 ohm, but as drawn it drives
    PD1_COMP_PFI_BUF, and R223 sits on taskpc-digital beside the connector.
    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
2026-10-18 tests: stop the CLI tests depending on the host's NTP state
    run() asks the host whether NTP has synced, through timedatectl. A Mac has no
    timedatectl and answers None ("unknown", which is trusted), but a GitHub Linux
    runner reports its own clock's state. Three CLI tests failed in CI on 0683ad6,
    with clock_reason=ntp_unsynchronized, and passed on the next push.
    The cause is not that commit's change: the probe was never stubbed. The failure
    was reproduced on a Mac with a stand-in timedatectl that answers "no". An
    autouse fixture now answers the probe with "unknown" for every CLI test.
    Evaluating NTP is still tested directly in test_clock.py.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
2026-10-18 sessions: pin the folder-before-state order, and test every corrupt state file
    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
2026-10-18 QueuedSink.roll: change segments on the owner thread
    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
2026-10-18 run: pin that a session open across midnight keeps its id
    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
2026-10-18 endpoint: no traceback on stderr when a client vanishes; drop a racy test
    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
2026-10-18 manifest: parse a crashed segment once, and give an entered session its manifest
    A roll out of a folder rebuilt its manifest on the run loop's thread, and a
    segment left without a trailer by a crash was parsed in full every time: 210 MB
    took 1.87 s on a laptop. For that long no frame went out, the new segment went
    unflushed past the one-second crash-loss bound, and the parse held the GIL
    against the word pump, at every open and close after a crash (spec Sec.2).
    Segment summaries are now memoised in manifest.py, keyed on the path and
    checked against the file's inode, size and mtime, so a segment that changes is
    parsed again. The start of a run seeds the memo before capture begins. Failures
    a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
2026-10-18 endpoint test: start the request as it is queued; MATLAB close takes the id
    The started-request test started its request from a helper thread. Scheduled
    more than the endpoint's 0.2 s timeout late, the helper lost the race: the
    endpoint cancelled first and answered 503, a failure under load that said
    nothing about the endpoint. The stand-in's queue now starts each request in
    put(), before the timeout can begin. It still proves the point: an endpoint
    that answers 503 for a started request fails it.
    wlsync_session('close', box, token_file, id) closes exactly that session and
    looks nothing up, so the box's stale-close guard (409) applies. Without the id
    it closes whatever is open, as before. A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
2026-10-18 records: correct the handover's XC-091 items, and say what the fixes leave
    HANDOVER-wl-expcontroller.md, struck through and corrected, dated 2026-10-18:
    - XC-091 item 5: the record is in <id>/syncbox/ or unassigned/<date>/syncbox/,
    not <date>_01/ (cli.day_directory is gone), and the session endpoint does
    not serve the record, so a read from the task PC still needs something new.
    - Item 6: a session now ends at POST /session/close, and its last segment
    closes, with its trailer, before the 200.
    - Item 7: the folder's manifest, not the day's.
    - wl-xcon's directory is xcon/, not expcontroller/.
    - "Recording never stalls" now names the residual cost: a crashed segment is
    parsed once per p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
2026-10-19 Records: session identity is merged; carry the build's parked findings
    wl.yaml, the handover and next-session said "not yet merged", which this
    merge makes false. The build's SDD ledger was gitignored scratch, so the
    minor findings it parked are copied into next-session.md, as that file's
    own note asks.
    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
2026-10-19 pending-wl-preproc-amendments: move the pin, a SessionId.parse question, a layout note
    Delivered to wl-preproc as HANDOVER-wl-sync.md (be8e95d there). Every claim
    about wl-preproc was read at its 6fcad33 and re-read at 02fd6c0.
    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
2026-10-19 pending-wl-preproc-amendments: the pin alone is not enough; barcodes are B records
    Found by the wl-phantom design's builder check, and confirmed in wl-preproc's
    _syncbox_log.py and synth/syncbox.py. Added to the delivered section too.
    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
2026-10-19 next-session: the 4-hour silicon soak passed; the emit loop wakes 4 ms late at times
    14 400 consecutive barcodes, no degraded capture, flat memory. About 3 % of
    intervals were 4 ms off in pairs (one 250 Hz kernel tick), which bears on
    bench check 4: the 1 ms word poll against a four-event FIFO.
    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
2026-10-28 barcode: decode_edges is linear — bisect the sorted ticks
    _level_at scanned the edge list from its first edge on every call, and
    decode_edges calls it about 38 times a frame, so decoding was quadratic in
    a record's length: four hours took 687 s, and a day's record took hours.
    It now bisects a list of the sorted ticks, built once per decode. The
    answer is the same by construction (the last edge at or before the tick,
    LOW before any; edges sharing a tick resolve to the last of them, as the
    scan did), and two tests hold it:
    - test_decode_matches_the_linear_scan_reference compares decode_edges with
    a verbatim copy of the old decoder over 300 messy records: jitter,
    glitches on sample centr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
2026-10-30 service: one box clock unwraps every delivery path — nearest to now_us()
    Recorder gave the word, edge and barcode paths each their own unwrapper, which
    notices a 32-bit wrap only when a tick on its own path falls below the previous
    one. The barcode path runs at 1 Hz and sees every wrap; the other two see one
    only if a record arrives within each 71.6 min period. A word or edge path that
    went silent that long, or whose first record came that long after process
    start, missed the wrap, and every later record was 4294.967296 s early per
    missed wrap against the barcodes wl-preproc places code words by: a session's
    events silently mistimed.
    All three paths and backend.now_us() share one origin a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
2026-10-30 cli, clock: judge clock trust again at every roll
    A roll reused the trust judged when the process started. On the box after
    a power-up (2026-10-19: unit up at 12.5 s, NTP synced at 33.5 s) every
    segment that day said clock_trusted=false, ntp_unsynchronized, long after
    NTP had synced. The flag therefore could not tell a boot race from a bad
    clock on any run that began with a power-up, and wl-preproc was told not
    to treat it on its own as a fault in the data.
    The rule. A run's first segment keeps the start's judgement (evaluate_clock
    and _resume, unchanged). A segment begun by a session open or close is
    judged at the roll (clock.evaluate_roll), and is trusted only if both hold
    then:
    - NTP do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
2026-10-30 cli: roll once in place when NTP first syncs
    Option 2 of the boot-trust fix, which the user chose with option 1 on
    2026-10-30. Option 1 (2b420c0) judges trust again only at a session open
    or close. So after a power-up the first segment (unit up at 12.5 s, NTP
    synced at 33.5 s on wl-sync-rig0) said ntp_unsynchronized until a
    session changed, which between visits can be hours.
    What changes. A run whose last definite NTP answer is no now asks again
    from the run loop, between frames, as session-follow does. It asks at
    most every NTP_POLL_INTERVAL_S (10 s), counted from the last time
    anything asked, a session open's or close's own probe included. A probe
    costs 9-62 ms on the box, on that thread.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
2026-10-30 session: SessionId.parse takes only the canonical form
    The pattern used re.match with `$` and \d, so "2026-10-18_01\n" parsed (`$` matches
    before a final newline), and so did ids in any Unicode decimal digits, which int()
    converts. Both printed back as a different string. Now re.fullmatch with [0-9]: every id
    the box mints matched already, and wl-preproc, which takes SessionId from here, agreed to
    the tightening (its answers of 2026-10-22, item 2).
    The endpoint's /session/close forgave a trailing newline through that leniency, and a
    test pins it. That forgiveness is kept, now explicit in the endpoint; non-ASCII digits
    are refused with 400.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
2026-10-30 tests: cover the recorded untested paths; end-to-end teardown always stops run()
    Run-level tests for a corrupt state file, a hand-deleted open-session folder,
    --session-token-file without --listen, a present-but-unreadable token file, and the
    endpoint shutting down when run raises. The end-to-end rig's fixture now sets done and
    joins on any exit, and the one unbounded thread.join() is bounded. A test pins that
    next_id skips an id taken by a stray regular file.
    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
2026-10-30 cli: the journal names the first barcode that went onto the wire
    The start line said "first barcode N" with the value _resume() computed, but the first
    frame reads the clock again and usually emits a later value: on wl-sync-rig0 on
    2026-10-19 the line said 214573321 and the first B record was 214573322. The start line
    now says "barcodes from N" (the floor, which it does know), and one line after the first
    frame says "first barcode N emitted", the value an operator will find in the data.
    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
2026-10-30 next-session, amendments, wl.yaml: 2026-10-30's work on main
    The header fields, the NTP-sync roll, ask 4b, the canonical SessionId, the untested
    paths and the first-barcode journal line. Two fixes are deployed and the rest wait on
    wl-preproc's pin. Bench day must measure the edge stamp-to-buffer lag (20 ms assumed)
    and the first frame's GPIO request delay.
    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
2026-10-30 cli: place the frame grid again after a wall-clock step
    The run loop placed its frame grid once, at start: the wall clock's half
    seconds, located on the monotonic clock. A step moved it until the next
    restart. That was rare until 56a89f8: a box that powers up before NTP
    syncs now rolls in place at the first sync, and on a dead or drifted RTC
    that sync steps the clock.
    WHAT IT COST. After a step the frames read the wall clock at whatever
    phase the step left. Near a second edge, a wake 4 ms late (one tick of a
    250 Hz kernel timer, 420 times in the 4 h soak) read the next second, and
    the floor (_ValueSource, last + 1) carried that second. Every value after
    it ran one second ahead of the clock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
2026-10-30 next-session, amendments: the frame grid is placed again after a step
    An in-place roll's values can now differ by two across it, and wl-preproc is told so.
    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
2026-10-30 rp1: edges that arrive out of order are not lost edges
    Found in review, 2026-10-30. SeqnoTracker took every gap in global_seqno
    for a kernel buffer overflow. Run on 1,2,3,5,4,6,7, where nothing was
    lost, it reported three losses, one of them -2.
    THE KERNEL MECHANISM (drivers/gpio/gpiolib-cdev.c, rpi-6.12.y). For a
    request of several lines, the hard IRQ handler stamps an edge and takes
    the request-wide number (edge_irq_handler, atomic_inc_return on
    lr->seqno). The line's own IRQ thread later counts it on the line and
    puts it in the buffer (edge_irq_thread: line->line_seqno++, then
    linereq_put_event). Each line has its own threaded IRQ and nothing
    orders two lines' threads, so the buffer can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
2026-10-30 next-session, wl.yaml: edges out of order are not lost edges
    fe5a13d is on main. The notes describe what it does and what bench day
    should look for, and two of the four recorded review findings are
    brought up to date: the edge thread's join now waits for its last look,
    and the edge pump's error hand-off is locked. wl.yaml's status names the
    grid re-placement and the edge fix, and the count is 574.
    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
2026-10-30 tests: a barrier that skips a dead path is bounded by the timeout
    test_a_capture_path_that_has_stopped_is_not_waited_for asserted each
    barrier ended within a quarter of ROLL_BARRIER_TIMEOUT_S, 0.05 s. The
    first barrier still waits for the live word pump, and under CPU quota
    on a two-core Linux container it took 0.052-0.056 s, three times across
    two reviews. The bound is now the timeout itself: a barrier that waits
    for a dead path runs to the deadline, at least 0.2 s, and logs the
    WARNING the test already forbids. Checked by putting the dead path back
    into delivered_through(): the barrier then took 0.201 s and failed.
    Claud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
2026-10-30 next-session: bench day takes the one-clock design's two cheap checks
    B1 (do RP1 and the CPU share a reference?) and B4 (can PIO see the
    barcode pin without a wire?) cost minutes on the bench and decide
    between the draft design's options. The ±100 us check runs on a process
    hours old, since the drift grows from capture start.
    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
2026-10-30 log, docs: what wl-preproc will pin says what the box does
    The final review of 4f1739c..66bd311 found no code defect, and three
    statements wl-preproc would act on that the code does not bear out.
    - The amendments' item 1 was still OPEN and asked wl-preproc to move a
    pin it moved on 2026-10-22 (its e8f1350, to 27c0e97). It is closed,
    and wl-preproc's 2026-10-22 items 3-6 get explicit answers: a roll at
    an open or close always changes folders, but two segments in one
    folder can now share a clock (the NTP roll in place, or an out-and-
    back after a failed state read); both asks are built; the unwrap fix
    (d309bf1) runs on the box.
    - "Same process_uuid, one clock: ticks compare by num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
2026-10-30 rp1: a gap held when the edge thread dies is reported
    Found in the final review of 4f1739c..66bd311. Since fe5a13d a gap in
    the request's numbers is held for 20-40 ms before it is called a loss.
    The stop's last look (EdgePump.finish) settles what is held; the crash
    path did not. When the edge thread died on a read error inside that
    window, fail() held the stop's error, which no loss overwrites, and
    the gap went nowhere: no journal line, no count. 4f1739c reported "1
    edge event(s) lost" at once for the same input.
    EdgePump.abandon() holds the error as fail() does, then makes every
    held gap final and returns the loss, which _pump_edges logs at ERROR.
    check_health() still reports the stop. Tes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
2026-10-30 docs: wl-preproc's pin moved in a commit of 2026-10-27; a 2 s gap is checked
    From the re-review of dc5261c. wl-preproc answered on 2026-10-22 and
    committed the pin move as e8f1350 on 2026-10-27; the amendments said
    both happened on the 22nd. The README's 2 s gap between segments of one
    process is now "almost certainly" not an outage, with the journal line
    that confirms it.
    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
2026-10-30 log, cli: every header names the clocks its ticks count
    The user's decision of 2026-10-30. Code words count RP1's PIO counter,
    off RP1's own crystal; barcodes and edges count CLOCK_MONOTONIC, which
    NTP slews. The one-clock build will change that, and a reader needs to
    know which arrangement a segment was written under. Added now, so
    wl-preproc's pin moves once, past this and the other header fields.
    timebase is free text, default None ("written before this field
    existed"), never empty. The backend declares it (SyncBackend.timebase):
    Rp1Backend "split", FakeBackend "fake", which is what the box's --fake
    unit writes until bench acceptance. A value this version does not
    define, such as the one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
2026-10-30 CLAUDE.md: regenerate the dependents block
    `wlo dependents wl-sync --write`, from wl-orchestrator e0d2825, at the
    user's request. The block named wl-preproc's pin as 90b931e; it has
    been 27c0e97 since 2026-10-22. It now also lists wl-phantom (pinned
    27c0e97), wl-xcon and wl-xtasks, and the artifacts each consumes.
    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
2026-11-06 log: iter_records reads a segment one record at a time
    read_header(path) returns a segment's header; iter_records(path) yields its
    records one at a time, by read_log's own parsing rules (a torn final line
    dropped, T skipped, an unknown kind refused), and closes its file when it is
    exhausted, closed or interrupted. read_log is now the two together and
    returns exactly what it did. A long segment, such as a bench soak's hours
    in one file, need not be held in memory to be read.
    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
2026-11-06 cli: the NTP roll moves to today's unassigned/ when the sync changed the day
    With no session open, the roll at NTP's first sync now goes to the unassigned/
    folder of the day the frame's barcode value names, with that day's stand-in id,
    when that differs from the folder it is in. A box with a dead RTC starts on
    2000-01-01; the sync steps it to today, and the roll in place used to leave the
    trusted segment under the old day's folder. A session open keeps the roll in
    its folder; the reason, the judgement and process_uuid are unchanged.
    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
